mstoilov/sigmadrone-esc/README.MD

This is the sigmadrone ESC repository. It contains hardware designs and
firmware software for the Sigmadrone ESC.
