mstoilov/sigmadrone-esc/Documents/holding-brake.png

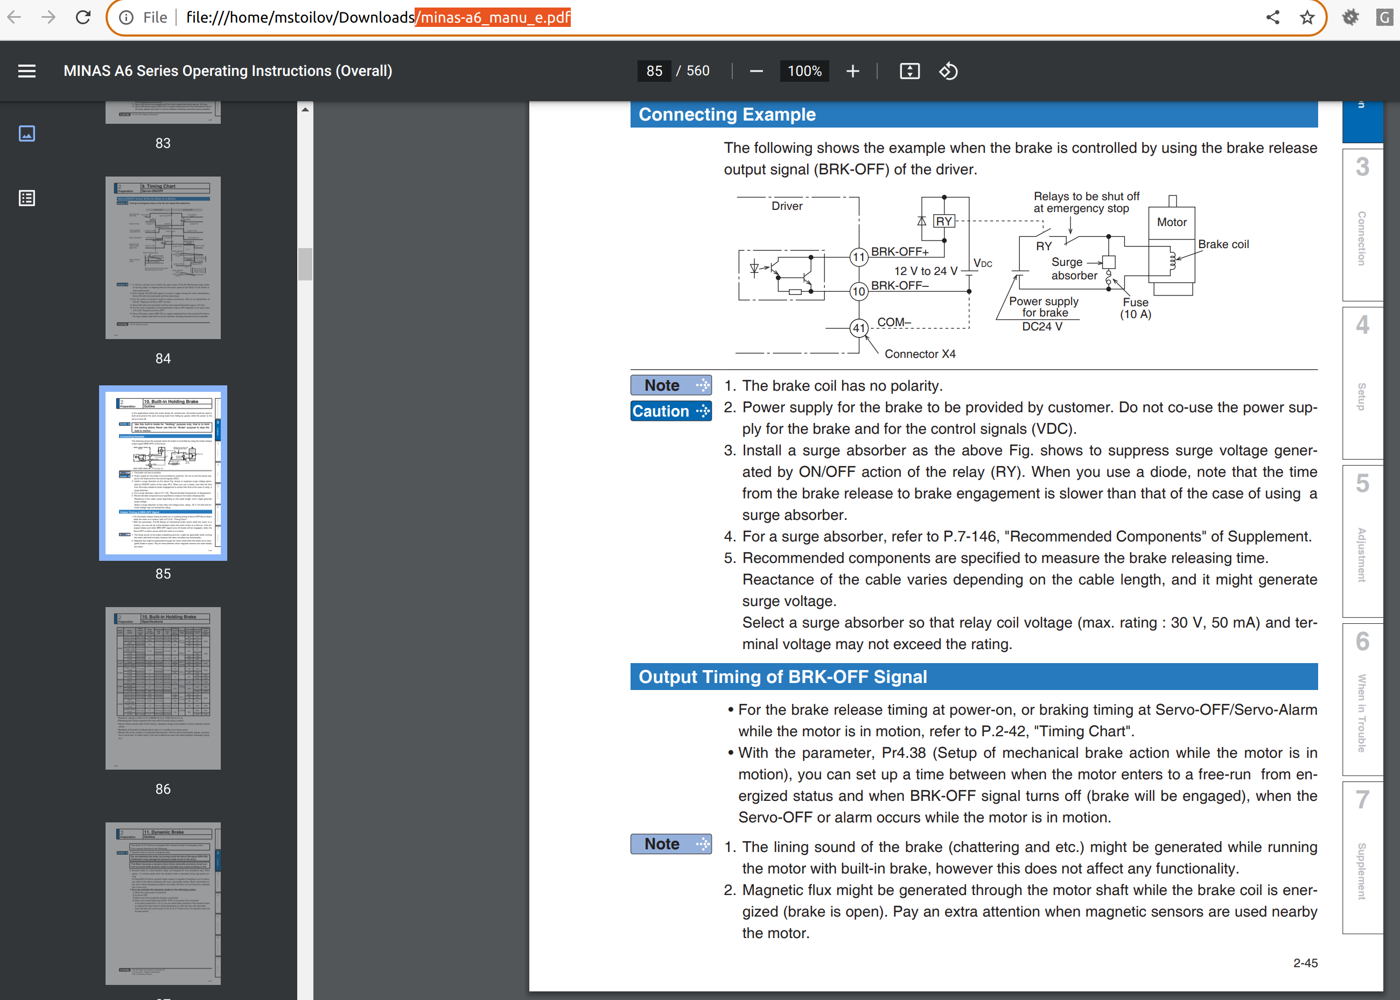
Documents/holding-brake.png
