mstoilov/sigmadrone-esc/hardware/zec-rev1/Servo_DRV_Rev1_BOM_2023-07-13(1)_updated.xlsx

Sheet: FULL BOM
 | Project: | Servo_DRV_Rev1 | FULL BOM |  | Variant:
 | Date: | 2023-07-12
Note | Comp Name | PartName | Description | Type | Value | Maker | Maker Part Name | Provider | Provider Part Name | Maker2 | Maker2 Part Name | Provider2 | Provider2 Part Name | Maker3 | Maker3 Part Name | Provider3 | Provider3 Part Name | Maker4 | Maker4 Part Name | Provider4 | Provider4 Part Name | Maker5 | Maker5 Part Name | Provider5 | Provider5 Part Name | Note | Code A | SKU | Proto MOQ | Automotive
 | AMB1 | SCHURTER 8020.0607 Fuse | Fuse Cartridge SUT Series 30A 250V 6.3mm x 32mm 500A | SMT | SCHURTER 8020.0607 Fuse | SCHURTER | 8020.0607 | Farnell | 1829564 | - | - | - | - | - | - | - | - | - | - | - | - | - | - | - | - |  | - | 7S03900054 |  | -
 | AMB2 | DF11-10DS-2C | CONN RCPT HSG 10POS 2.00MM | SMT | DF11-10DS-2C | - | - | - | - | Hirose Electric Co Ltd | DF11-10DS-2C | Digikey | H2023-ND | Hirose Connector | DF11-10DS-2C | Mouser | 798-DF11-10DS-2C | - | - | - | - | - | - | - | - |  | - | 7S02400821 |  | -
 | AMB3 | DF11-10DS-2C | CONN RCPT HSG 10POS 2.00MM | SMT | DF11-10DS-2C | - | - | - | - | Hirose Electric Co Ltd | DF11-10DS-2C | Digikey | H2023-ND | Hirose Connector | DF11-10DS-2C | Mouser | 798-DF11-10DS-2C | - | - | - | - | - | - | - | - |  | - | 7S02400821 |  | -
 | AMB4 | DF11-6DS-2C | CONN RCPT HSG 6POS 2.00MM | SMT | DF11-6DS-2C | - | - | - | - | Hirose Electric Co Ltd | DF11-6DS-2C | Digikey | H2021-ND | Hirose Connector | DF11-6DS-2C | Mouser | 798-DF11-6DS-2C | - | - | - | - | - | - | - | - |  | - | 7S02400820 |  | -
 | AMB5 | DF11-4DS-2C | CONN RCPT HSG 4POS 2.00MM | SMT | DF11-4DS-2C | - | - | - | - | Hirose Electric Co Ltd | DF11-4DS-2C | Digikey | H2019-ND | Hirose Connector | DF11-4DS-2C | Mouser | 798-DF11-4DS-2C | - | - | - | - | - | - | - | - |  | - | 7S02400819 |  | -
 | AMB6 | DF11-4DS-2C | CONN RCPT HSG 4POS 2.00MM | SMT | DF11-4DS-2C | - | - | - | - | Hirose Electric Co Ltd | DF11-4DS-2C | Digikey | H2019-ND | Hirose Connector | DF11-4DS-2C | Mouser | 798-DF11-4DS-2C | - | - | - | - | - | - | - | - |  | - | 7S02400819 |  | -
 | AMB7 | DF11-4DS-2C | CONN RCPT HSG 4POS 2.00MM | SMT | DF11-4DS-2C | - | - | - | - | Hirose Electric Co Ltd | DF11-4DS-2C | Digikey | H2019-ND | Hirose Connector | DF11-4DS-2C | Mouser | 798-DF11-4DS-2C | - | - | - | - | - | - | - | - |  | - | 7S02400819 |  | -
 | AMB8 | DF11-4DS-2C | CONN RCPT HSG 4POS 2.00MM | SMT | DF11-4DS-2C | - | - | - | - | Hirose Electric Co Ltd | DF11-4DS-2C | Digikey | H2019-ND | Hirose Connector | DF11-4DS-2C | Mouser | 798-DF11-4DS-2C | - | - | - | - | - | - | - | - |  | - | 7S02400819 |  | -
 | AMB9 | DF11-4DS-2C | CONN RCPT HSG 4POS 2.00MM | SMT | DF11-4DS-2C | - | - | - | - | Hirose Electric Co Ltd | DF11-4DS-2C | Digikey | H2019-ND | Hirose Connector | DF11-4DS-2C | Mouser | 798-DF11-4DS-2C | - | - | - | - | - | - | - | - |  | - | 7S02400819 |  | -
 | AMB10 | DF11-10DS-2C | CONN RCPT HSG 10POS 2.00MM | SMT | DF11-10DS-2C | - | - | - | - | Hirose Electric Co Ltd | DF11-10DS-2C | Digikey | H2023-ND | Hirose Connector | DF11-10DS-2C | Mouser | 798-DF11-10DS-2C | - | - | - | - | - | - | - | - |  | - | 7S02400821 |  | -
 | AMB11 | DF11-4DS-2C | CONN RCPT HSG 4POS 2.00MM | SMT | DF11-4DS-2C | - | - | - | - | Hirose Electric Co Ltd | DF11-4DS-2C | Digikey | H2019-ND | Hirose Connector | DF11-4DS-2C | Mouser | 798-DF11-4DS-2C | - | - | - | - | - | - | - | - |  | - | 7S02400819 |  | -
 | AMB12 | DF11-4DS-2C | CONN RCPT HSG 4POS 2.00MM | SMT | DF11-4DS-2C | - | - | - | - | Hirose Electric Co Ltd | DF11-4DS-2C | Digikey | H2019-ND | Hirose Connector | DF11-4DS-2C | Mouser | 798-DF11-4DS-2C | - | - | - | - | - | - | - | - |  | - | 7S02400819 |  | -
 | AMB13 | DF11-10DS-2C | CONN RCPT HSG 10POS 2.00MM | SMT | DF11-10DS-2C | - | - | - | - | Hirose Electric Co Ltd | DF11-10DS-2C | Digikey | H2023-ND | Hirose Connector | DF11-10DS-2C | Mouser | 798-DF11-10DS-2C | - | - | - | - | - | - | - | - |  | - | 7S02400821 |  | -
 | AMB14 | DF11-2428SCF | CONN SOCKET 24-28AWG CRIMP TIN | SMT | DF11-2428SCF | - | - | - | - | Hirose Electric Co Ltd | DF11-2428SCF | Digikey | H1504CT-ND | Hirose Connector | DF11-2428SCF | Mouser | 798-DF11-2428SCF | - | - | - | - | - | - | - | - |  | - | 7S02400822 |  | -
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
 | AMB79 | DF11-2428SCF | CONN SOCKET 24-28AWG CRIMP TIN | SMT | DF11-2428SCF | - | - | - | - | Hirose Electric Co Ltd | DF11-2428SCF | Digikey | H1504CT-ND | Hirose Connector | DF11-2428SCF | Mouser | 798-DF11-2428SCF | - | - | - | - | - | - | - | - |  | - | 7S02400822 |  | -
 | AMB80 | DF11-2428SCF | CONN SOCKET 24-28AWG CRIMP TIN | SMT | DF11-2428SCF | - | - | - | - | Hirose Electric Co Ltd | DF11-2428SCF | Digikey | H1504CT-ND | Hirose Connector | DF11-2428SCF | Mouser | 798-DF11-2428SCF | - | - | - | - | - | - | - | - |  | - | 7S02400822 |  | -
 | AMB81 | DF11-2428SCF | CONN SOCKET 24-28AWG CRIMP TIN | SMT | DF11-2428SCF | - | - | - | - | Hirose Electric Co Ltd | DF11-2428SCF | Digikey | H1504CT-ND | Hirose Connector | DF11-2428SCF | Mouser | 798-DF11-2428SCF | - | - | - | - | - | - | - | - |  | - | 7S02400822 |  | -
 | AMB82 | DF11-2428SCF | CONN SOCKET 24-28AWG CRIMP TIN | SMT | DF11-2428SCF | - | - | - | - | Hirose Electric Co Ltd | DF11-2428SCF | Digikey | H1504CT-ND | Hirose Connector | DF11-2428SCF | Mouser | 798-DF11-2428SCF | - | - | - | - | - | - | - | - |  | - | 7S02400822 |  | -
 | AMB83 | DF11-2428SCF | CONN SOCKET 24-28AWG CRIMP TIN | SMT | DF11-2428SCF | - | - | - | - | Hirose Electric Co Ltd | DF11-2428SCF | Digikey | H1504CT-ND | Hirose Connector | DF11-2428SCF | Mouser | 798-DF11-2428SCF | - | - | - | - | - | - | - | - |  | - | 7S02400822 |  | -
 | AMB84 | DF11-2428SCF | CONN SOCKET 24-28AWG CRIMP TIN | SMT | DF11-2428SCF | - | - | - | - | Hirose Electric Co Ltd | DF11-2428SCF | Digikey | H1504CT-ND | Hirose Connector | DF11-2428SCF | Mouser | 798-DF11-2428SCF | - | - | - | - | - | - | - | - |  | - | 7S02400822 |  | -
 | AMB85 | DF11-2428SCF | CONN SOCKET 24-28AWG CRIMP TIN | SMT | DF11-2428SCF | - | - | - | - | Hirose Electric Co Ltd | DF11-2428SCF | Digikey | H1504CT-ND | Hirose Connector | DF11-2428SCF | Mouser | 798-DF11-2428SCF | - | - | - | - | - | - | - | - |  | - | 7S02400822 |  | -
 | AMB86 | DF11-2428SCF | CONN SOCKET 24-28AWG CRIMP TIN | SMT | DF11-2428SCF | - | - | - | - | Hirose Electric Co Ltd | DF11-2428SCF | Digikey | H1504CT-ND | Hirose Connector | DF11-2428SCF | Mouser | 798-DF11-2428SCF | - | - | - | - | - | - | - | - |  | - | 7S02400822 |  | -
 | AMB87 | DF11-2428SCF | CONN SOCKET 24-28AWG CRIMP TIN | SMT | DF11-2428SCF | - | - | - | - | Hirose Electric Co Ltd | DF11-2428SCF | Digikey | H1504CT-ND | Hirose Connector | DF11-2428SCF | Mouser | 798-DF11-2428SCF | - | - | - | - | - | - | - | - |  | - | 7S02400822 |  | -
 | AMB88 | 691352710004 | TERM BLOCK PLUG 4POS 5MM 300VAC 12A 4P Straight 24-12AWG | SMT | 691352710004 | WURTH ELEKTRONIK | 691352710004 | WURTH ELEKTRONIK | 691352710004 | WURTH ELEKTRONIK | 691352710004 | Digikey | 732-2777-ND | WURTH ELEKTRONIK | 691352710004 | Mouser | 710-691352710004 | - | - | - | - | - | - | - | - |  | - | 7S03000364 | - | -
 | AMB89 | 691352710003 | TERM BLOCK PLUG 3POS 5MM 300VAC 12A 3P Straight 24-12AWG | SMT | 691352710003 | WURTH ELEKTRONIK | 691352710003 | WURTH ELEKTRONIK | 691352710003 | WURTH ELEKTRONIK | 691352710003 | Digikey | 732-2776-ND | WURTH ELEKTRONIK | 691352710003 | Mouser | 710-691352710003 | - | - | - | - | - | - | - | - |  | - | 7S03000365 | - | -
 | AMB90 | 691352710003 | TERM BLOCK PLUG 3POS 5MM 300VAC 12A 3P Straight 24-12AWG | SMT | 691352710003 | WURTH ELEKTRONIK | 691352710003 | WURTH ELEKTRONIK | 691352710003 | WURTH ELEKTRONIK | 691352710003 | Digikey | 732-2776-ND | WURTH ELEKTRONIK | 691352710003 | Mouser | 710-691352710003 | - | - | - | - | - | - | - | - |  | - | 7S03000365 | - | -
 | AMB91 | AMB Spacer 5mm - 702917000 | SPACER BOARD SUPRT SCREW MNT NYLON h5mm Outer Diameter - 4mm Drill in Panel - 3mm | SMT | AMB Spacer 5mm - 702917000 | WURTH ELECTRONIK | 702917000 | WURTH ELECTRONIK | 702917000 | WURTH ELECTRONIK | 702917000 | Digikey | 732-9626-ND | WURTH ELECTRONIK | 702917000 | Mouser | 710-702917000 | - | - | - | - | - | - | - | - |  | - | 7S04800076 | - | -
 | AMB92 | AMB Spacer 5mm - 702917000 | SPACER BOARD SUPRT SCREW MNT NYLON h5mm Outer Diameter - 4mm Drill in Panel - 3mm | SMT | AMB Spacer 5mm - 702917000 | WURTH ELECTRONIK | 702917000 | WURTH ELECTRONIK | 702917000 | WURTH ELECTRONIK | 702917000 | Digikey | 732-9626-ND | WURTH ELECTRONIK | 702917000 | Mouser | 710-702917000 | - | - | - | - | - | - | - | - |  | - | 7S04800076 | - | -
 | C1 | C0805-4u7/50V/20%/X5R | Chip Capacitor 0805 4u7/50V/20%/X5R | SMT | 4u7/50V/X5R | TDK | C2012X5R1H475M125AB | Farnell | 2525142 | Murata Electronics | GRM21BR61H475ME51L | Digikey | 490-14663-1-ND | Murata Electronics | GRM21BR61H475ME51L | Mouser | 81-GRM21BR61H475M51L | Taiyo Yuden | UMK212BBJ475KG-T | Mouser | 963-UMK212BBJ475KG-T | - | - | - | - |  | - | 7S00900100 | 13 | -
 | C2 | C0805-10n/50V/10%/X7R | Chip Capacitor 0805 10n/50V/10%/X7R | SMT | 10n/50V | KEMET | C0805Y103K5RACAUTO | Farnell | 2673146 | Samsung Electro-Mechanics | CL21B103KBCNNNC | Digikey | 1276-1078-1-ND | Yageo | CC0805KRX7R9BB103 | Mouser | 603-CC805KRX7R9BB103 | Samsung Electro-Mechanics | CL21B103KBANNNC | Comet | C0805 10nF 50V X7R SAMSUNG | - | - | - | - |  | - | 7S00900022 | 13 | -
 | C3 | C0402-47p/50V/NP0/5% | CAP 47pF 5% 50V 0402 NP0 | SMT | 47p/50V/5% | YAGEO | CC0402JRNPO9BN470 | Farnell | 3019202 | Yageo | CC0402JRNPO9BN470 | Digikey | 311-1021-1-ND | Murata Electronics | GRT1555C1H470FA02D | Mouser | 81-GRT1555C1H470FA2D | Murata Electronics | GRM1555C1H470JA01D | Mouser | 81-GRM1555C1H470JA1D | - | - | - | - |  | 16733 | 7S00700037 | 25 | -
 | C4 | C0402-47p/50V/NP0/5% | CAP 47pF 5% 50V 0402 NP0 | SMT | 47p/50V/5% | YAGEO | CC0402JRNPO9BN470 | Farnell | 3019202 | Yageo | CC0402JRNPO9BN470 | Digikey | 311-1021-1-ND | Murata Electronics | GRT1555C1H470FA02D | Mouser | 81-GRT1555C1H470FA2D | Murata Electronics | GRM1555C1H470JA01D | Mouser | 81-GRM1555C1H470JA1D | - | - | - | - |  | 16733 | 7S00700037 | 25 | -
 | C5 | C0402-1u/16V/10%/X5R | CAP CER 1UF 16V X5R 0402 10% | SMT | 1u/16V/X5R | TAIYO YUDEN | EMK105BJ105KV-F | Farnell | 2113064 | MURATA | GRM155R61C105KA12D | Digikey | 490-10694-1-ND | Taiyo Yuden | EMK105BJ105KV-F | Mouser | 963-EMK105BJ105KV-F | - | - | - | - | - | - | - | - |  | 9621 | 7S00700081 | 25 | -
 | C6 | C0402-100n/50V/10%/X7R | CAP CER 0.1UF 50V 10% X7R 0402 | SMT | 100n/50V/X7R | TDK | CGA2B3X7R1H104K050BB | Farnell | 2210822 | Murata | GCM155R71H104KE02D | Digikey | 490-10672-1-ND | Murata | GRM155R71H104KE14D | Mouser | 81-GRM155R71H104KE4D | - | - | - | - | SAMSUNG | CL05B104KB5NNNC | Comet | C0402 100nF 50V X7R |  | - | 7S00700043 | 25 | -
 | C7 | C0402-100n/50V/10%/X7R | CAP CER 0.1UF 50V 10% X7R 0402 | SMT | 100n/50V/X7R | TDK | CGA2B3X7R1H104K050BB | Farnell | 2210822 | Murata | GCM155R71H104KE02D | Digikey | 490-10672-1-ND | Murata | GRM155R71H104KE14D | Mouser | 81-GRM155R71H104KE4D | - | - | - | - | SAMSUNG | CL05B104KB5NNNC | Comet | C0402 100nF 50V X7R |  | - | 7S00700043 | 25 | -
 | C8 | C0402-100n/50V/10%/X7R | CAP CER 0.1UF 50V 10% X7R 0402 | SMT | 100n/50V/X7R | TDK | CGA2B3X7R1H104K050BB | Farnell | 2210822 | Murata | GCM155R71H104KE02D | Digikey | 490-10672-1-ND | Murata | GRM155R71H104KE14D | Mouser | 81-GRM155R71H104KE4D | - | - | - | - | SAMSUNG | CL05B104KB5NNNC | Comet | C0402 100nF 50V X7R |  | - | 7S00700043 | 25 | -
 | C9 | C0402-100n/50V/10%/X7R | CAP CER 0.1UF 50V 10% X7R 0402 | SMT | 100n/50V/X7R | TDK | CGA2B3X7R1H104K050BB | Farnell | 2210822 | Murata | GCM155R71H104KE02D | Digikey | 490-10672-1-ND | Murata | GRM155R71H104KE14D | Mouser | 81-GRM155R71H104KE4D | - | - | - | - | SAMSUNG | CL05B104KB5NNNC | Comet | C0402 100nF 50V X7R |  | - | 7S00700043 | 25 | -
 | C10 | C0402-100n/50V/10%/X7R | CAP CER 0.1UF 50V 10% X7R 0402 | SMT | 100n/50V/X7R | TDK | CGA2B3X7R1H104K050BB | Farnell | 2210822 | Murata | GCM155R71H104KE02D | Digikey | 490-10672-1-ND | Murata | GRM155R71H104KE14D | Mouser | 81-GRM155R71H104KE4D | - | - | - | - | SAMSUNG | CL05B104KB5NNNC | Comet | C0402 100nF 50V X7R |  | - | 7S00700043 | 25 | -
 | C11 | C0402-100n/50V/10%/X7R | CAP CER 0.1UF 50V 10% X7R 0402 | SMT | 100n/50V/X7R | TDK | CGA2B3X7R1H104K050BB | Farnell | 2210822 | Murata | GCM155R71H104KE02D | Digikey | 490-10672-1-ND | Murata | GRM155R71H104KE14D | Mouser | 81-GRM155R71H104KE4D | - | - | - | - | SAMSUNG | CL05B104KB5NNNC | Comet | C0402 100nF 50V X7R |  | - | 7S00700043 | 25 | -
 | C12 | C0402-100n/50V/10%/X7R | CAP CER 0.1UF 50V 10% X7R 0402 | SMT | 100n/50V/X7R | TDK | CGA2B3X7R1H104K050BB | Farnell | 2210822 | Murata | GCM155R71H104KE02D | Digikey | 490-10672-1-ND | Murata | GRM155R71H104KE14D | Mouser | 81-GRM155R71H104KE4D | - | - | - | - | SAMSUNG | CL05B104KB5NNNC | Comet | C0402 100nF 50V X7R |  | - | 7S00700043 | 25 | -
 | C13 | C0805-4u7/50V/20%/X5R | Chip Capacitor 0805 4u7/50V/20%/X5R | SMT | 4u7/50V/X5R | TDK | C2012X5R1H475M125AB | Farnell | 2525142 | Murata Electronics | GRM21BR61H475ME51L | Digikey | 490-14663-1-ND | Murata Electronics | GRM21BR61H475ME51L | Mouser | 81-GRM21BR61H475M51L | Taiyo Yuden | UMK212BBJ475KG-T | Mouser | 963-UMK212BBJ475KG-T | - | - | - | - |  | - | 7S00900100 | 13 | -
 | C14 | C0402-27p/50V/C0G | CAP 27pF 5% 50V CF CAP 0402 C0G | SMT | 27p/50V | KEMET | C0402C270J5GACAUTO | Farnell | 2821220 | KEMET | C0402C270J5GACTU | Digikey | 399-1016-1-ND | KEMET | C0402C270J5GAC | Mouser | 80-C0402C270J5GAC | - | - | - | - | - | - | - | - |  | 18561 | 7S00700022 | 25 | -
 | C15 | C0402-100n/50V/10%/X7R | CAP CER 0.1UF 50V 10% X7R 0402 | SMT | 100n/50V/X7R | TDK | CGA2B3X7R1H104K050BB | Farnell | 2210822 | Murata | GCM155R71H104KE02D | Digikey | 490-10672-1-ND | Murata | GRM155R71H104KE14D | Mouser | 81-GRM155R71H104KE4D | - | - | - | - | SAMSUNG | CL05B104KB5NNNC | Comet | C0402 100nF 50V X7R |  | - | 7S00700043 | 25 | -
 | C16 | C0402-27p/50V/C0G | CAP 27pF 5% 50V CF CAP 0402 C0G | SMT | 27p/50V | KEMET | C0402C270J5GACAUTO | Farnell | 2821220 | KEMET | C0402C270J5GACTU | Digikey | 399-1016-1-ND | KEMET | C0402C270J5GAC | Mouser | 80-C0402C270J5GAC | - | - | - | - | - | - | - | - |  | 18561 | 7S00700022 | 25 | -
 | C17 | C0402-1u/16V/10%/X5R | CAP CER 1UF 16V X5R 0402 10% | SMT | 1u/16V/X5R | TAIYO YUDEN | EMK105BJ105KV-F | Farnell | 2113064 | MURATA | GRM155R61C105KA12D | Digikey | 490-10694-1-ND | Taiyo Yuden | EMK105BJ105KV-F | Mouser | 963-EMK105BJ105KV-F | - | - | - | - | - | - | - | - |  | 9621 | 7S00700081 | 25 | -
 | C18 | C0402-100n/50V/10%/X7R | CAP CER 0.1UF 50V 10% X7R 0402 | SMT | 100n/50V/X7R | TDK | CGA2B3X7R1H104K050BB | Farnell | 2210822 | Murata | GCM155R71H104KE02D | Digikey | 490-10672-1-ND | Murata | GRM155R71H104KE14D | Mouser | 81-GRM155R71H104KE4D | - | - | - | - | SAMSUNG | CL05B104KB5NNNC | Comet | C0402 100nF 50V X7R |  | - | 7S00700043 | 25 | -
 | C19 | C0402-2u2/16V/X5R/10% | CAP CER 2.2UF 16V X5R 0402 | SMT | 2u2/16V | MURATA | ZRB157R61C225KE11D | Farnell | 2990839 | Taiyo Yuden | EMK105ABJ225KV-F | Digikey | 587-6002-1-ND | Taiyo Yuden | EMK105ABJ225KV-F | Mouser | 963-EMK105ABJ225KV-F | Taiyo Yuden | EMK105ABJ225MV-F | Mouser | 963-EMK105ABJ225MV-F | - | - | - | - |  | - | 7S00700126 | 25 | -
 | C20 | C0402-1n/50V/X7R | CAP CER 1000PF 50V 10% X7R 0402 | SMT | 1n/50V/X7R | WURTH | '885012205061 | Farnell | 2495166 | Murata | GCM155R71H102KA37D | Digikey | 490-4761-1-ND | Murata | GCM155R71H102KA37D | Mouser | 81-GCM155R71H102KA7D | - | - | - | - | - | - | - | - |  | - | 7S00700004 | 25 | -
 | C21 | C0402-100n/50V/10%/X7R | CAP CER 0.1UF 50V 10% X7R 0402 | SMT | 100n/50V/X7R | TDK | CGA2B3X7R1H104K050BB | Farnell | 2210822 | Murata | GCM155R71H104KE02D | Digikey | 490-10672-1-ND | Murata | GRM155R71H104KE14D | Mouser | 81-GRM155R71H104KE4D | - | - | - | - | SAMSUNG | CL05B104KB5NNNC | Comet | C0402 100nF 50V X7R |  | - | 7S00700043 | 25 | -
 | C22 | C0402-100n/50V/10%/X7R | CAP CER 0.1UF 50V 10% X7R 0402 | SMT | 100n/50V/X7R | TDK | CGA2B3X7R1H104K050BB | Farnell | 2210822 | Murata | GCM155R71H104KE02D | Digikey | 490-10672-1-ND | Murata | GRM155R71H104KE14D | Mouser | 81-GRM155R71H104KE4D | - | - | - | - | SAMSUNG | CL05B104KB5NNNC | Comet | C0402 100nF 50V X7R |  | - | 7S00700043 | 25 | -
 | C23 | C0402-1n/50V/X7R | CAP CER 1000PF 50V 10% X7R 0402 | SMT | 1n/50V/X7R | WURTH | '885012205061 | Farnell | 2495166 | Murata | GCM155R71H102KA37D | Digikey | 490-4761-1-ND | Murata | GCM155R71H102KA37D | Mouser | 81-GCM155R71H102KA7D | - | - | - | - | - | - | - | - |  | - | 7S00700004 | 25 | -
 | C24 | C0402-1u/16V/10%/X5R | CAP CER 1UF 16V X5R 0402 10% | SMT | 1u/16V/X5R | TAIYO YUDEN | EMK105BJ105KV-F | Farnell | 2113064 | MURATA | GRM155R61C105KA12D | Digikey | 490-10694-1-ND | Taiyo Yuden | EMK105BJ105KV-F | Mouser | 963-EMK105BJ105KV-F | - | - | - | - | - | - | - | - |  | 9621 | 7S00700081 | 25 | -
 | C25 | C0402-1n/50V/X7R | CAP CER 1000PF 50V 10% X7R 0402 | SMT | 1n/50V/X7R | WURTH | '885012205061 | Farnell | 2495166 | Murata | GCM155R71H102KA37D | Digikey | 490-4761-1-ND | Murata | GCM155R71H102KA37D | Mouser | 81-GCM155R71H102KA7D | - | - | - | - | - | - | - | - |  | - | 7S00700004 | 25 | -
 | C26 | C0402-1n/50V/X7R | CAP CER 1000PF 50V 10% X7R 0402 | SMT | 1n/50V/X7R | WURTH | '885012205061 | Farnell | 2495166 | Murata | GCM155R71H102KA37D | Digikey | 490-4761-1-ND | Murata | GCM155R71H102KA37D | Mouser | 81-GCM155R71H102KA7D | - | - | - | - | - | - | - | - |  | - | 7S00700004 | 25 | -
 | C27 | C0402-1n/50V/X7R | CAP CER 1000PF 50V 10% X7R 0402 | SMT | 1n/50V/X7R | WURTH | '885012205061 | Farnell | 2495166 | Murata | GCM155R71H102KA37D | Digikey | 490-4761-1-ND | Murata | GCM155R71H102KA37D | Mouser | 81-GCM155R71H102KA7D | - | - | - | - | - | - | - | - |  | - | 7S00700004 | 25 | -
 | C28 | C0603-10u/16V/20%/X5R | CAP CER 10UF 16V 20% X5R 0603 | SMT | 10u/16V/X5R | Murata Electronics | GRM188R61C106MA73D | Farnell | 2426958 | Murata Electronics | GRM188R61C106MA73D | Digikey | 490-7201-1-ND | Murata Electronics | GRM188R61C106MAALD | Mouser | 81-GRM188R61C106MALD | - | - | - | - | - | - | - | - |  | - | 7S00800087 | 13 | -
 | C29 | C0402-100n/50V/10%/X7R | CAP CER 0.1UF 50V 10% X7R 0402 | SMT | 100n/50V/X7R | TDK | CGA2B3X7R1H104K050BB | Farnell | 2210822 | Murata | GCM155R71H104KE02D | Digikey | 490-10672-1-ND | Murata | GRM155R71H104KE14D | Mouser | 81-GRM155R71H104KE4D | - | - | - | - | SAMSUNG | CL05B104KB5NNNC | Comet | C0402 100nF 50V X7R |  | - | 7S00700043 | 25 | -
 | C30 | C0402-1n/50V/X7R | CAP CER 1000PF 50V 10% X7R 0402 | SMT | 1n/50V/X7R | WURTH | '885012205061 | Farnell | 2495166 | Murata | GCM155R71H102KA37D | Digikey | 490-4761-1-ND | Murata | GCM155R71H102KA37D | Mouser | 81-GCM155R71H102KA7D | - | - | - | - | - | - | - | - |  | - | 7S00700004 | 25 | -
 | C31 | C0402-1u/16V/10%/X5R | CAP CER 1UF 16V X5R 0402 10% | SMT | 1u/16V/X5R | TAIYO YUDEN | EMK105BJ105KV-F | Farnell | 2113064 | MURATA | GRM155R61C105KA12D | Digikey | 490-10694-1-ND | Taiyo Yuden | EMK105BJ105KV-F | Mouser | 963-EMK105BJ105KV-F | - | - | - | - | - | - | - | - |  | 9621 | 7S00700081 | 25 | -
 | C32 | C0402-2u2/16V/X5R/10% | CAP CER 2.2UF 16V X5R 0402 | SMT | 2u2/16V | MURATA | ZRB157R61C225KE11D | Farnell | 2990839 | Taiyo Yuden | EMK105ABJ225KV-F | Digikey | 587-6002-1-ND | Taiyo Yuden | EMK105ABJ225KV-F | Mouser | 963-EMK105ABJ225KV-F | Taiyo Yuden | EMK105ABJ225MV-F | Mouser | 963-EMK105ABJ225MV-F | - | - | - | - |  | - | 7S00700126 | 25 | -
 | C33 | C0402-100n/50V/10%/X7R | CAP CER 0.1UF 50V 10% X7R 0402 | SMT | 100n/50V/X7R | TDK | CGA2B3X7R1H104K050BB | Farnell | 2210822 | Murata | GCM155R71H104KE02D | Digikey | 490-10672-1-ND | Murata | GRM155R71H104KE14D | Mouser | 81-GRM155R71H104KE4D | - | - | - | - | SAMSUNG | CL05B104KB5NNNC | Comet | C0402 100nF 50V X7R |  | - | 7S00700043 | 25 | -
 | C34 | C0603-10u/16V/20%/X5R | CAP CER 10UF 16V 20% X5R 0603 | SMT | 10u/16V/X5R | Murata Electronics | GRM188R61C106MA73D | Farnell | 2426958 | Murata Electronics | GRM188R61C106MA73D | Digikey | 490-7201-1-ND | Murata Electronics | GRM188R61C106MAALD | Mouser | 81-GRM188R61C106MALD | - | - | - | - | - | - | - | - |  | - | 7S00800087 | 13 | -
 | C35 | C0603-10u/16V/20%/X5R | CAP CER 10UF 16V 20% X5R 0603 | SMT | 10u/16V/X5R | Murata Electronics | GRM188R61C106MA73D | Farnell | 2426958 | Murata Electronics | GRM188R61C106MA73D | Digikey | 490-7201-1-ND | Murata Electronics | GRM188R61C106MAALD | Mouser | 81-GRM188R61C106MALD | - | - | - | - | - | - | - | - |  | - | 7S00800087 | 13 | -
 | C36 | C0603-10u/16V/20%/X5R | CAP CER 10UF 16V 20% X5R 0603 | SMT | 10u/16V/X5R | Murata Electronics | GRM188R61C106MA73D | Farnell | 2426958 | Murata Electronics | GRM188R61C106MA73D | Digikey | 490-7201-1-ND | Murata Electronics | GRM188R61C106MAALD | Mouser | 81-GRM188R61C106MALD | - | - | - | - | - | - | - | - |  | - | 7S00800087 | 13 | -
 | C37 | C0402-100n/50V/10%/X7R | CAP CER 0.1UF 50V 10% X7R 0402 | SMT | 100n/50V/X7R | TDK | CGA2B3X7R1H104K050BB | Farnell | 2210822 | Murata | GCM155R71H104KE02D | Digikey | 490-10672-1-ND | Murata | GRM155R71H104KE14D | Mouser | 81-GRM155R71H104KE4D | - | - | - | - | SAMSUNG | CL05B104KB5NNNC | Comet | C0402 100nF 50V X7R |  | - | 7S00700043 | 25 | -
 | C38 | C0805-4u7/50V/20%/X5R | Chip Capacitor 0805 4u7/50V/20%/X5R | SMT | 4u7/50V/X5R | TDK | C2012X5R1H475M125AB | Farnell | 2525142 | Murata Electronics | GRM21BR61H475ME51L | Digikey | 490-14663-1-ND | Murata Electronics | GRM21BR61H475ME51L | Mouser | 81-GRM21BR61H475M51L | Taiyo Yuden | UMK212BBJ475KG-T | Mouser | 963-UMK212BBJ475KG-T | - | - | - | - |  | - | 7S00900100 | 13 | -
 | C39 | C0402-100n/50V/10%/X7R | CAP CER 0.1UF 50V 10% X7R 0402 | SMT | 100n/50V/X7R | TDK | CGA2B3X7R1H104K050BB | Farnell | 2210822 | Murata | GCM155R71H104KE02D | Digikey | 490-10672-1-ND | Murata | GRM155R71H104KE14D | Mouser | 81-GRM155R71H104KE4D | - | - | - | - | SAMSUNG | CL05B104KB5NNNC | Comet | C0402 100nF 50V X7R |  | - | 7S00700043 | 25 | -
 | C40 | C0402-1u/16V/10%/X5R | CAP CER 1UF 16V X5R 0402 10% | SMT | 1u/16V/X5R | TAIYO YUDEN | EMK105BJ105KV-F | Farnell | 2113064 | MURATA | GRM155R61C105KA12D | Digikey | 490-10694-1-ND | Taiyo Yuden | EMK105BJ105KV-F | Mouser | 963-EMK105BJ105KV-F | - | - | - | - | - | - | - | - |  | 9621 | 7S00700081 | 25 | -
 | C41 | C0603-10u/16V/20%/X5R | CAP CER 10UF 16V 20% X5R 0603 | SMT | 10u/16V/X5R | Murata Electronics | GRM188R61C106MA73D | Farnell | 2426958 | Murata Electronics | GRM188R61C106MA73D | Digikey | 490-7201-1-ND | Murata Electronics | GRM188R61C106MAALD | Mouser | 81-GRM188R61C106MALD | - | - | - | - | - | - | - | - |  | - | 7S00800087 | 13 | -
 | C42 | C0603-10u/16V/20%/X5R | CAP CER 10UF 16V 20% X5R 0603 | SMT | 10u/16V/X5R | Murata Electronics | GRM188R61C106MA73D | Farnell | 2426958 | Murata Electronics | GRM188R61C106MA73D | Digikey | 490-7201-1-ND | Murata Electronics | GRM188R61C106MAALD | Mouser | 81-GRM188R61C106MALD | - | - | - | - | - | - | - | - |  | - | 7S00800087 | 13 | -
 | C43 | C0603-10u/16V/20%/X5R | CAP CER 10UF 16V 20% X5R 0603 | SMT | 10u/16V/X5R | Murata Electronics | GRM188R61C106MA73D | Farnell | 2426958 | Murata Electronics | GRM188R61C106MA73D | Digikey | 490-7201-1-ND | Murata Electronics | GRM188R61C106MAALD | Mouser | 81-GRM188R61C106MALD | - | - | - | - | - | - | - | - |  | - | 7S00800087 | 13 | -
 | C44 | C0402-100n/50V/10%/X7R | CAP CER 0.1UF 50V 10% X7R 0402 | SMT | 100n/50V/X7R | TDK | CGA2B3X7R1H104K050BB | Farnell | 2210822 | Murata | GCM155R71H104KE02D | Digikey | 490-10672-1-ND | Murata | GRM155R71H104KE14D | Mouser | 81-GRM155R71H104KE4D | - | - | - | - | SAMSUNG | CL05B104KB5NNNC | Comet | C0402 100nF 50V X7R |  | - | 7S00700043 | 25 | -
 | C45 | C0805-4u7/50V/20%/X5R | Chip Capacitor 0805 4u7/50V/20%/X5R | SMT | 4u7/50V/X5R | TDK | C2012X5R1H475M125AB | Farnell | 2525142 | Murata Electronics | GRM21BR61H475ME51L | Digikey | 490-14663-1-ND | Murata Electronics | GRM21BR61H475ME51L | Mouser | 81-GRM21BR61H475M51L | Taiyo Yuden | UMK212BBJ475KG-T | Mouser | 963-UMK212BBJ475KG-T | - | - | - | - |  | - | 7S00900100 | 13 | -
 | C46 | C0402-100n/50V/10%/X7R | CAP CER 0.1UF 50V 10% X7R 0402 | SMT | 100n/50V/X7R | TDK | CGA2B3X7R1H104K050BB | Farnell | 2210822 | Murata | GCM155R71H104KE02D | Digikey | 490-10672-1-ND | Murata | GRM155R71H104KE14D | Mouser | 81-GRM155R71H104KE4D | - | - | - | - | SAMSUNG | CL05B104KB5NNNC | Comet | C0402 100nF 50V X7R |  | - | 7S00700043 | 25 | -
 | C47 | C0402-1u/16V/10%/X5R | CAP CER 1UF 16V X5R 0402 10% | SMT | 1u/16V/X5R | TAIYO YUDEN | EMK105BJ105KV-F | Farnell | 2113064 | MURATA | GRM155R61C105KA12D | Digikey | 490-10694-1-ND | Taiyo Yuden | EMK105BJ105KV-F | Mouser | 963-EMK105BJ105KV-F | - | - | - | - | - | - | - | - |  | 9621 | 7S00700081 | 25 | -
 | C48 | C0402-100n/50V/10%/X7R | CAP CER 0.1UF 50V 10% X7R 0402 | SMT | 100n/50V/X7R | TDK | CGA2B3X7R1H104K050BB | Farnell | 2210822 | Murata | GCM155R71H104KE02D | Digikey | 490-10672-1-ND | Murata | GRM155R71H104KE14D | Mouser | 81-GRM155R71H104KE4D | - | - | - | - | SAMSUNG | CL05B104KB5NNNC | Comet | C0402 100nF 50V X7R |  | - | 7S00700043 | 25 | -
 | C49 | C0805-4u7/50V/20%/X5R | Chip Capacitor 0805 4u7/50V/20%/X5R | SMT | 4u7/50V/X5R | TDK | C2012X5R1H475M125AB | Farnell | 2525142 | Murata Electronics | GRM21BR61H475ME51L | Digikey | 490-14663-1-ND | Murata Electronics | GRM21BR61H475ME51L | Mouser | 81-GRM21BR61H475M51L | Taiyo Yuden | UMK212BBJ475KG-T | Mouser | 963-UMK212BBJ475KG-T | - | - | - | - |  | - | 7S00900100 | 13 | -
 | C50 | C0402-100n/50V/10%/X7R | CAP CER 0.1UF 50V 10% X7R 0402 | SMT | 100n/50V/X7R | TDK | CGA2B3X7R1H104K050BB | Farnell | 2210822 | Murata | GCM155R71H104KE02D | Digikey | 490-10672-1-ND | Murata | GRM155R71H104KE14D | Mouser | 81-GRM155R71H104KE4D | - | - | - | - | SAMSUNG | CL05B104KB5NNNC | Comet | C0402 100nF 50V X7R |  | - | 7S00700043 | 25 | -
 | C51 | C0402-47n/50V/10%/X7R | CAP CER 0.047UF 50V X7R 0402 | SMT | 47n/50V/X7R | TDK | CGA2B3X7R1H473K050BB | Farnell | 2210827 | TDK Corporation | CGA2B3X7R1H473K050BB | Digikey | 445-6897-1-ND | Murata Electronics | GRM155R71H473KE14D | Mouser | 81-GRM155R71H473KE4D | - | - | - | - | - | - | - | - |  | - | 7S00700090 | 25 | -
 | C52 | C0402-1u/16V/10%/X5R | CAP CER 1UF 16V X5R 0402 10% | SMT | 1u/16V/X5R | TAIYO YUDEN | EMK105BJ105KV-F | Farnell | 2113064 | MURATA | GRM155R61C105KA12D | Digikey | 490-10694-1-ND | Taiyo Yuden | EMK105BJ105KV-F | Mouser | 963-EMK105BJ105KV-F | - | - | - | - | - | - | - | - |  | 9621 | 7S00700081 | 25 | -
 | C53 | C0402-1n/50V/X7R | CAP CER 1000PF 50V 10% X7R 0402 | SMT | 1n/50V/X7R | WURTH | '885012205061 | Farnell | 2495166 | Murata | GCM155R71H102KA37D | Digikey | 490-4761-1-ND | Murata | GCM155R71H102KA37D | Mouser | 81-GCM155R71H102KA7D | - | - | - | - | - | - | - | - |  | - | 7S00700004 | 25 | -
 | C54 | C0402-1n/50V/X7R | CAP CER 1000PF 50V 10% X7R 0402 | SMT | 1n/50V/X7R | WURTH | '885012205061 | Farnell | 2495166 | Murata | GCM155R71H102KA37D | Digikey | 490-4761-1-ND | Murata | GCM155R71H102KA37D | Mouser | 81-GCM155R71H102KA7D | - | - | - | - | - | - | - | - |  | - | 7S00700004 | 25 | -
 | C55 | C0402-1n/50V/X7R | CAP CER 1000PF 50V 10% X7R 0402 | SMT | 1n/50V/X7R | WURTH | '885012205061 | Farnell | 2495166 | Murata | GCM155R71H102KA37D | Digikey | 490-4761-1-ND | Murata | GCM155R71H102KA37D | Mouser | 81-GCM155R71H102KA7D | - | - | - | - | - | - | - | - |  | - | 7S00700004 | 25 | -
 | C56 | C0402-100n/50V/10%/X7R | CAP CER 0.1UF 50V 10% X7R 0402 | SMT | 100n/50V/X7R | TDK | CGA2B3X7R1H104K050BB | Farnell | 2210822 | Murata | GCM155R71H104KE02D | Digikey | 490-10672-1-ND | Murata | GRM155R71H104KE14D | Mouser | 81-GRM155R71H104KE4D | - | - | - | - | SAMSUNG | CL05B104KB5NNNC | Comet | C0402 100nF 50V X7R |  | - | 7S00700043 | 25 | -
 | C57 | C0805-4u7/50V/20%/X5R | Chip Capacitor 0805 4u7/50V/20%/X5R | SMT | 4u7/50V/X5R | TDK | C2012X5R1H475M125AB | Farnell | 2525142 | Murata Electronics | GRM21BR61H475ME51L | Digikey | 490-14663-1-ND | Murata Electronics | GRM21BR61H475ME51L | Mouser | 81-GRM21BR61H475M51L | Taiyo Yuden | UMK212BBJ475KG-T | Mouser | 963-UMK212BBJ475KG-T | - | - | - | - |  | - | 7S00900100 | 13 | -
 | C58 | C0402-100n/50V/10%/X7R | CAP CER 0.1UF 50V 10% X7R 0402 | SMT | 100n/50V/X7R | TDK | CGA2B3X7R1H104K050BB | Farnell | 2210822 | Murata | GCM155R71H104KE02D | Digikey | 490-10672-1-ND | Murata | GRM155R71H104KE14D | Mouser | 81-GRM155R71H104KE4D | - | - | - | - | SAMSUNG | CL05B104KB5NNNC | Comet | C0402 100nF 50V X7R |  | - | 7S00700043 | 25 | -
 | C59 | C0402-47n/50V/10%/X7R | CAP CER 0.047UF 50V X7R 0402 | SMT | 47n/50V/X7R | TDK | CGA2B3X7R1H473K050BB | Farnell | 2210827 | TDK Corporation | CGA2B3X7R1H473K050BB | Digikey | 445-6897-1-ND | Murata Electronics | GRM155R71H473KE14D | Mouser | 81-GRM155R71H473KE4D | - | - | - | - | - | - | - | - |  | - | 7S00700090 | 25 | -
 | C60 | C0402-1u/16V/10%/X5R | CAP CER 1UF 16V X5R 0402 10% | SMT | 1u/16V/X5R | TAIYO YUDEN | EMK105BJ105KV-F | Farnell | 2113064 | MURATA | GRM155R61C105KA12D | Digikey | 490-10694-1-ND | Taiyo Yuden | EMK105BJ105KV-F | Mouser | 963-EMK105BJ105KV-F | - | - | - | - | - | - | - | - |  | 9621 | 7S00700081 | 25 | -
 | C61 | C0402-1n/50V/X7R | CAP CER 1000PF 50V 10% X7R 0402 | SMT | 1n/50V/X7R | WURTH | '885012205061 | Farnell | 2495166 | Murata | GCM155R71H102KA37D | Digikey | 490-4761-1-ND | Murata | GCM155R71H102KA37D | Mouser | 81-GCM155R71H102KA7D | - | - | - | - | - | - | - | - |  | - | 7S00700004 | 25 | -
 | C62 | C0402-1n/50V/X7R | CAP CER 1000PF 50V 10% X7R 0402 | SMT | 1n/50V/X7R | WURTH | '885012205061 | Farnell | 2495166 | Murata | GCM155R71H102KA37D | Digikey | 490-4761-1-ND | Murata | GCM155R71H102KA37D | Mouser | 81-GCM155R71H102KA7D | - | - | - | - | - | - | - | - |  | - | 7S00700004 | 25 | -
 | C63 | C0402-1n/50V/X7R | CAP CER 1000PF 50V 10% X7R 0402 | SMT | 1n/50V/X7R | WURTH | '885012205061 | Farnell | 2495166 | Murata | GCM155R71H102KA37D | Digikey | 490-4761-1-ND | Murata | GCM155R71H102KA37D | Mouser | 81-GCM155R71H102KA7D | - | - | - | - | - | - | - | - |  | - | 7S00700004 | 25 | -
 | C64 | C0402-100n/50V/10%/X7R | CAP CER 0.1UF 50V 10% X7R 0402 | SMT | 100n/50V/X7R | TDK | CGA2B3X7R1H104K050BB | Farnell | 2210822 | Murata | GCM155R71H104KE02D | Digikey | 490-10672-1-ND | Murata | GRM155R71H104KE14D | Mouser | 81-GRM155R71H104KE4D | - | - | - | - | SAMSUNG | CL05B104KB5NNNC | Comet | C0402 100nF 50V X7R |  | - | 7S00700043 | 25 | -
 | C65 | C0402-100n/50V/10%/X7R | CAP CER 0.1UF 50V 10% X7R 0402 | SMT | 100n/50V/X7R | TDK | CGA2B3X7R1H104K050BB | Farnell | 2210822 | Murata | GCM155R71H104KE02D | Digikey | 490-10672-1-ND | Murata | GRM155R71H104KE14D | Mouser | 81-GRM155R71H104KE4D | - | - | - | - | SAMSUNG | CL05B104KB5NNNC | Comet | C0402 100nF 50V X7R |  | - | 7S00700043 | 25 | -
 | C66 | C_EL/SIZE F/-100U/50V 24MOHMS ESR H12.7MM | CAP ALUM POLY 100UF 20% 50V SMD 24mOhms ESR | SMT | 100u/50V | - | - | - | - | KEMET | A768MS107M1HLAE024 | Digikey | 399-A768MS107M1HLAE024CT-ND | KEMET | A768MS107M1HLAE024 | Mouser | 80-A768MS107M1HLAE24 | - | - | - | - | - | - | - | - |  | - | 7S02000209 | 4 | -
 | C67 | C0603-1u/50V/10%/X5R | Chip Capacitor 0603 1u/50V/±10%/X5R | SMT | 1u/50V/10%/X5R | TAIYO YUDEN | UMK107BJ105KA-T | Farnell | 2112858 | MURATA | GRT188R61H105KE13D | Digikey | 490-12330-1-ND | Taiyo Yuden | UMK107BJ105KA-T | Mouser | 963-UMK107BJ105KA-T | - | - | - | - | - | - | - | - |  | - | 7S00800117 | 13 | -
 | C68 | C_EL/SIZE F/-100U/50V 24MOHMS ESR H12.7MM | CAP ALUM POLY 100UF 20% 50V SMD 24mOhms ESR | SMT | 100u/50V | - | - | - | - | KEMET | A768MS107M1HLAE024 | Digikey | 399-A768MS107M1HLAE024CT-ND | KEMET | A768MS107M1HLAE024 | Mouser | 80-A768MS107M1HLAE24 | - | - | - | - | - | - | - | - |  | - | 7S02000209 | 4 | -
 | C69 | C0603-1u/50V/10%/X5R | Chip Capacitor 0603 1u/50V/±10%/X5R | SMT | 1u/50V/10%/X5R | TAIYO YUDEN | UMK107BJ105KA-T | Farnell | 2112858 | MURATA | GRT188R61H105KE13D | Digikey | 490-12330-1-ND | Taiyo Yuden | UMK107BJ105KA-T | Mouser | 963-UMK107BJ105KA-T | - | - | - | - | - | - | - | - |  | - | 7S00800117 | 13 | -
 | C70 | C_EL/SIZE F/-100U/50V 24MOHMS ESR H12.7MM | CAP ALUM POLY 100UF 20% 50V SMD 24mOhms ESR | SMT | 100u/50V | - | - | - | - | KEMET | A768MS107M1HLAE024 | Digikey | 399-A768MS107M1HLAE024CT-ND | KEMET | A768MS107M1HLAE024 | Mouser | 80-A768MS107M1HLAE24 | - | - | - | - | - | - | - | - |  | - | 7S02000209 | 4 | -
 | C71 | C0603-1u/50V/10%/X5R | Chip Capacitor 0603 1u/50V/±10%/X5R | SMT | 1u/50V/10%/X5R | TAIYO YUDEN | UMK107BJ105KA-T | Farnell | 2112858 | MURATA | GRT188R61H105KE13D | Digikey | 490-12330-1-ND | Taiyo Yuden | UMK107BJ105KA-T | Mouser | 963-UMK107BJ105KA-T | - | - | - | - | - | - | - | - |  | - | 7S00800117 | 13 | -
 | C72 | C_EL/SIZE F/-100U/50V 24MOHMS ESR H12.7MM | CAP ALUM POLY 100UF 20% 50V SMD 24mOhms ESR | SMT | 100u/50V | - | - | - | - | KEMET | A768MS107M1HLAE024 | Digikey | 399-A768MS107M1HLAE024CT-ND | KEMET | A768MS107M1HLAE024 | Mouser | 80-A768MS107M1HLAE24 | - | - | - | - | - | - | - | - |  | - | 7S02000209 | 4 | -
 | C73 | C0603-1u/50V/10%/X5R | Chip Capacitor 0603 1u/50V/±10%/X5R | SMT | 1u/50V/10%/X5R | TAIYO YUDEN | UMK107BJ105KA-T | Farnell | 2112858 | MURATA | GRT188R61H105KE13D | Digikey | 490-12330-1-ND | Taiyo Yuden | UMK107BJ105KA-T | Mouser | 963-UMK107BJ105KA-T | - | - | - | - | - | - | - | - |  | - | 7S00800117 | 13 | -
 | C74 | C_EL/SIZE F/-100U/50V 24MOHMS ESR H12.7MM | CAP ALUM POLY 100UF 20% 50V SMD 24mOhms ESR | SMT | 100u/50V | - | - | - | - | KEMET | A768MS107M1HLAE024 | Digikey | 399-A768MS107M1HLAE024CT-ND | KEMET | A768MS107M1HLAE024 | Mouser | 80-A768MS107M1HLAE24 | - | - | - | - | - | - | - | - |  | - | 7S02000209 | 4 | -
 | C75 | C0603-1u/50V/10%/X5R | Chip Capacitor 0603 1u/50V/±10%/X5R | SMT | 1u/50V/10%/X5R | TAIYO YUDEN | UMK107BJ105KA-T | Farnell | 2112858 | MURATA | GRT188R61H105KE13D | Digikey | 490-12330-1-ND | Taiyo Yuden | UMK107BJ105KA-T | Mouser | 963-UMK107BJ105KA-T | - | - | - | - | - | - | - | - |  | - | 7S00800117 | 13 | -
 | C76 | C_EL/SIZE F/-100U/50V 24MOHMS ESR H12.7MM | CAP ALUM POLY 100UF 20% 50V SMD 24mOhms ESR | SMT | 100u/50V | - | - | - | - | KEMET | A768MS107M1HLAE024 | Digikey | 399-A768MS107M1HLAE024CT-ND | KEMET | A768MS107M1HLAE024 | Mouser | 80-A768MS107M1HLAE24 | - | - | - | - | - | - | - | - |  | - | 7S02000209 | 4 | -
 | C77 | C0603-1u/50V/10%/X5R | Chip Capacitor 0603 1u/50V/±10%/X5R | SMT | 1u/50V/10%/X5R | TAIYO YUDEN | UMK107BJ105KA-T | Farnell | 2112858 | MURATA | GRT188R61H105KE13D | Digikey | 490-12330-1-ND | Taiyo Yuden | UMK107BJ105KA-T | Mouser | 963-UMK107BJ105KA-T | - | - | - | - | - | - | - | - |  | - | 7S00800117 | 13 | -
 | C78 | C0402-100n/50V/10%/X7R | CAP CER 0.1UF 50V 10% X7R 0402 | SMT | 100n/50V/X7R | TDK | CGA2B3X7R1H104K050BB | Farnell | 2210822 | Murata | GCM155R71H104KE02D | Digikey | 490-10672-1-ND | Murata | GRM155R71H104KE14D | Mouser | 81-GRM155R71H104KE4D | - | - | - | - | SAMSUNG | CL05B104KB5NNNC | Comet | C0402 100nF 50V X7R |  | - | 7S00700043 | 25 | -
 | C79 | C0402-100n/50V/10%/X7R | CAP CER 0.1UF 50V 10% X7R 0402 | SMT | 100n/50V/X7R | TDK | CGA2B3X7R1H104K050BB | Farnell | 2210822 | Murata | GCM155R71H104KE02D | Digikey | 490-10672-1-ND | Murata | GRM155R71H104KE14D | Mouser | 81-GRM155R71H104KE4D | - | - | - | - | SAMSUNG | CL05B104KB5NNNC | Comet | C0402 100nF 50V X7R |  | - | 7S00700043 | 25 | -
 | C80 | C0402-100n/50V/10%/X7R | CAP CER 0.1UF 50V 10% X7R 0402 | SMT | 100n/50V/X7R | TDK | CGA2B3X7R1H104K050BB | Farnell | 2210822 | Murata | GCM155R71H104KE02D | Digikey | 490-10672-1-ND | Murata | GRM155R71H104KE14D | Mouser | 81-GRM155R71H104KE4D | - | - | - | - | SAMSUNG | CL05B104KB5NNNC | Comet | C0402 100nF 50V X7R |  | - | 7S00700043 | 25 | -
 | C81 | C0402-100n/50V/10%/X7R | CAP CER 0.1UF 50V 10% X7R 0402 | SMT | 100n/50V/X7R | TDK | CGA2B3X7R1H104K050BB | Farnell | 2210822 | Murata | GCM155R71H104KE02D | Digikey | 490-10672-1-ND | Murata | GRM155R71H104KE14D | Mouser | 81-GRM155R71H104KE4D | - | - | - | - | SAMSUNG | CL05B104KB5NNNC | Comet | C0402 100nF 50V X7R |  | - | 7S00700043 | 25 | -
 | C98 | C1812-4n7/2000V X7R | CAPACITOR 1812 4n7F 2000V X7R | SMT | 4n7/2000V | JOHANSON DIELECTRICS | 202S43W472KV4E | Farnell | 1886080 | JOHANSON DIELECTRICS | 202S43W472KV4E | Digikey | 709-1308-1-ND | Johanson Dielectrics | 202S43W472KV4E | Mouser | 605-202S43W472KV4E | - | - | - | - | - | - | - | - |  | - | 7S01300012 | 7 | -
 | CN1 | 691313710004 | Serie 3137- 5.00mm Close Horizontal PCB Header WR-TBL 4W | THT | 691313710004 | WURTH ELEKTRONIK | 691313710004 | WURTH ELEKTRONIK | 691313710004 | WURTH ELEKTRONIK | 691313710004 | Digikey | 732-2801-ND | WURTH ELEKTRONIK | 691313710004 | Mouser | 710-691313710004 | - | - | - | - | - | - | - | - |  | - | 7S03000134 |  | -
 | CN2 | DF11-10DP-2DS_24 | CONN HEADER R/A 10POS 2MM | THT | DF11-10DP-2DS_24 | Hirose Electric Co Ltd | DF11-10DP-2DS(24) | Farnell | 1688361 | Hirose Electric Co Ltd | DF11-10DP-2DS(24) | Digikey | H10247-ND | Hirose Electric Co Ltd | DF11-10DP-2DS(24) | Mouser | 798-DF11-10DP-2DS24 | - | - | - | - | - | - | - | - |  | - | 7S02400744 | 0 | -
 | CN3 | DF11-10DP-2DS_24 | CONN HEADER R/A 10POS 2MM | THT | DF11-10DP-2DS_24 | Hirose Electric Co Ltd | DF11-10DP-2DS(24) | Farnell | 1688361 | Hirose Electric Co Ltd | DF11-10DP-2DS(24) | Digikey | H10247-ND | Hirose Electric Co Ltd | DF11-10DP-2DS(24) | Mouser | 798-DF11-10DP-2DS24 | - | - | - | - | - | - | - | - |  | - | 7S02400744 | 0 | -
 | CN4 | DF11-6DP-2DS_24 | CONN HEADER R/A 6POS 2MM | THT | DF11-6DP-2DS_24 | HIROSE(HRS) | DF11-6DP-2DSA(24) | Farnell | 1688343 | Hirose Electric Co Ltd | DF11-6DP-2DS(24) | Digikey | H10245-ND | Hirose Connector | DF11-6DP-2DS(24) | Mouser | 798-DF11-6DP-2DS24 | - | - | - | - | - | - | - | - |  | - | 7S02400746 | 0 | -
 | CN5 | DF11-4DP-2DS_24 | CONN HEADER R/A 4POS 2MM | THT | DF11-4DP-2DS_24 | Hirose Electric Co Ltd | DF11-4DP-2DS(24) | Farnell | 1688358 | Hirose Electric Co Ltd | DF11-4DP-2DS(24) | Digikey | H10244-ND | Hirose Electric Co Ltd | DF11-4DP-2DS(24) | Mouser | 798-DF11-4DP-2DS24 | - | - | - | - | - | - | - | - |  | - | 7S02400742 | 0 | -
 | CN6 | DF11-4DP-2DS_24 | CONN HEADER R/A 4POS 2MM | THT | DF11-4DP-2DS_24 | Hirose Electric Co Ltd | DF11-4DP-2DS(24) | Farnell | 1688358 | Hirose Electric Co Ltd | DF11-4DP-2DS(24) | Digikey | H10244-ND | Hirose Electric Co Ltd | DF11-4DP-2DS(24) | Mouser | 798-DF11-4DP-2DS24 | - | - | - | - | - | - | - | - |  | - | 7S02400742 | 0 | -
 | CN7 | DF11-4DP-2DS_24 | CONN HEADER R/A 4POS 2MM | THT | DF11-4DP-2DS_24 | Hirose Electric Co Ltd | DF11-4DP-2DS(24) | Farnell | 1688358 | Hirose Electric Co Ltd | DF11-4DP-2DS(24) | Digikey | H10244-ND | Hirose Electric Co Ltd | DF11-4DP-2DS(24) | Mouser | 798-DF11-4DP-2DS24 | - | - | - | - | - | - | - | - |  | - | 7S02400742 | 0 | -
 | CN8 | 61400416121 | CONNECTOR USB B RECEPTACLE PCB R/A | THT | USB Type B - 61400416121 | WURTH ELEKTRONIK | '61400416121 | Farnell | 1642035 | - | - | - | - | WURTH ELEKTRONIK | 61400416121 | WURTH ELEKTRONIK | 61400416121 | - | - | - | - | - | - | - | - |  | - | 7S03000010 |  | -
 | CN9 | 62131021021 | 1.27 mm SMD Dual Pin Header H=3.80mm | SMT | WURTH 62131021021 | WURTH ELEKTRONIK | 62131021021 | WURTH ELEKTRONIK | 62131021021 | - | - | - | - | WURTH ELEKTRONIK | 62131021021 | WURTH ELEKTRONIK | 62131021021 | - | - | - | - | - | - | - | - |  | - | 7S03000088 |  | -
 | CN10 | DF11-4DP-2DS_24 | CONN HEADER R/A 4POS 2MM | THT | DF11-4DP-2DS_24 | Hirose Electric Co Ltd | DF11-4DP-2DS(24) | Farnell | 1688358 | Hirose Electric Co Ltd | DF11-4DP-2DS(24) | Digikey | H10244-ND | Hirose Electric Co Ltd | DF11-4DP-2DS(24) | Mouser | 798-DF11-4DP-2DS24 | - | - | - | - | - | - | - | - |  | - | 7S02400742 | 0 | -
 | CN11 | DF11-4DP-2DS_24 | CONN HEADER R/A 4POS 2MM | THT | DF11-4DP-2DS_24 | Hirose Electric Co Ltd | DF11-4DP-2DS(24) | Farnell | 1688358 | Hirose Electric Co Ltd | DF11-4DP-2DS(24) | Digikey | H10244-ND | Hirose Electric Co Ltd | DF11-4DP-2DS(24) | Mouser | 798-DF11-4DP-2DS24 | - | - | - | - | - | - | - | - |  | - | 7S02400742 | 0 | -
 | CN12 | DF11-10DP-2DS_24 | CONN HEADER R/A 10POS 2MM | THT | DF11-10DP-2DS_24 | Hirose Electric Co Ltd | DF11-10DP-2DS(24) | Farnell | 1688361 | Hirose Electric Co Ltd | DF11-10DP-2DS(24) | Digikey | H10247-ND | Hirose Electric Co Ltd | DF11-10DP-2DS(24) | Mouser | 798-DF11-10DP-2DS24 | - | - | - | - | - | - | - | - |  | - | 7S02400744 | 0 | -
 | CN13 | 691313710003 | TERM BLOCK HDR 3POS 90DEG 5MM | THT | 691313710003 | WURTH ELEKTRONIK | 691313710003 | WURTH ELEKTRONIK | 691313710003 | WURTH ELEKTRONIK | 691313710003 | Digikey | 732-2800-ND | WURTH ELEKTRONIK | 691313710003 | Mouser | 710-691313710003 | - | - | - | - | - | - | - | - |  | - | 7S03000363 | - | -
 | CN14 | Molex - 43650-0300 | CONN HEADER R/A 3POS 3MM | THT | Molex - 43650-0300 | MOLEX | 43650-0300 | Farnell | 1012231 | MOLEX | 43650-0300 | Digikey | WM1861-ND | MOLEX | 43650-0300 | Mouser | 538-43650-0300 | - | - | - | - | - | - | - | - |  | - | 7S02600312 | 0 | -
 | CN15 | 691313710003 | TERM BLOCK HDR 3POS 90DEG 5MM | THT | 691313710003 | WURTH ELEKTRONIK | 691313710003 | WURTH ELEKTRONIK | 691313710003 | WURTH ELEKTRONIK | 691313710003 | Digikey | 732-2800-ND | WURTH ELEKTRONIK | 691313710003 | Mouser | 710-691313710003 | - | - | - | - | - | - | - | - |  | - | 7S03000363 | - | -
 | CN16 | Molex - 43650-0300 | CONN HEADER R/A 3POS 3MM | THT | Molex - 43650-0300 | MOLEX | 43650-0300 | Farnell | 1012231 | MOLEX | 43650-0300 | Digikey | WM1861-ND | MOLEX | 43650-0300 | Mouser | 538-43650-0300 | - | - | - | - | - | - | - | - |  | - | 7S02600312 | 0 | -
 | CN17 | DF11-10DP-2DS_24 | CONN HEADER R/A 10POS 2MM | THT | DF11-10DP-2DS_24 | Hirose Electric Co Ltd | DF11-10DP-2DS(24) | Farnell | 1688361 | Hirose Electric Co Ltd | DF11-10DP-2DS(24) | Digikey | H10247-ND | Hirose Electric Co Ltd | DF11-10DP-2DS(24) | Mouser | 798-DF11-10DP-2DS24 | - | - | - | - | - | - | - | - |  | - | 7S02400744 | 0 | -
 | CN18 | DF11-4DP-2DS_24 | CONN HEADER R/A 4POS 2MM | THT | DF11-4DP-2DS_24 | Hirose Electric Co Ltd | DF11-4DP-2DS(24) | Farnell | 1688358 | Hirose Electric Co Ltd | DF11-4DP-2DS(24) | Digikey | H10244-ND | Hirose Electric Co Ltd | DF11-4DP-2DS(24) | Mouser | 798-DF11-4DP-2DS24 | - | - | - | - | - | - | - | - |  | - | 7S02400742 | 0 | -
 | CN19 | DF11-4DP-2DS_24 | CONN HEADER R/A 4POS 2MM | THT | DF11-4DP-2DS_24 | Hirose Electric Co Ltd | DF11-4DP-2DS(24) | Farnell | 1688358 | Hirose Electric Co Ltd | DF11-4DP-2DS(24) | Digikey | H10244-ND | Hirose Electric Co Ltd | DF11-4DP-2DS(24) | Mouser | 798-DF11-4DP-2DS24 | - | - | - | - | - | - | - | - |  | - | 7S02400742 | 0 | -
 | D1 | PMEG100V100ELPDZ | DIODE SCHOTTKY 100V 10A CFP15 | SMT | PMEG100V100ELPDZ | Nexperia USA Inc. | PMEG100V100ELPDZ | Farnell | 2777474 | Nexperia USA Inc. | PMEG100V100ELPDZ | Digikey | PMEG100V100ELPDZ-ND | Nexperia USA Inc. | PMEG100V100ELPDZ | Mouser | 771-PMEG100V100ELPDZ | - | - | - | - | - | - | - | - |  | - | 7S03400380 |  | -
 | D2 | 824031815 | WE-TVS TVS Diode 5V | SMT | 824031815 | WURTH ELECTRONICS | 824031815 | WURTH ELECTRONICS | 824031815 | - | - | WURTH ELECTRONICS | 824031815 | - | - | WURTH ELECTRONICS | 824031815 | - | - | - | - | - | - | - | - |  | - | 7S03700109 | 13 | -
 | D3 | 824031815 | WE-TVS TVS Diode 5V | SMT | 824031815 | WURTH ELECTRONICS | 824031815 | WURTH ELECTRONICS | 824031815 | - | - | WURTH ELECTRONICS | 824031815 | - | - | WURTH ELECTRONICS | 824031815 | - | - | - | - | - | - | - | - |  | - | 7S03700109 | 13 | -
 | D4 | BAT54J | DIODE SCHOTTKY 30V 200MA SOD323F | SMT | BAT54J | - | - | - | - | NXP Semiconductors | BAT54J-115 | Digikey | 568-6018-1-ND | Nexperia | BAT54J.115 | Mouser | 771-BAT54J115 | - | - | - | - | - | - | - | - |  | - | 7S03400280 | 13 | -
 | D5 | BAT54J | DIODE SCHOTTKY 30V 200MA SOD323F | SMT | BAT54J | - | - | - | - | NXP Semiconductors | BAT54J-115 | Digikey | 568-6018-1-ND | Nexperia | BAT54J.115 | Mouser | 771-BAT54J115 | - | - | - | - | - | - | - | - |  | - | 7S03400280 | 13 | -
 | D6 | STPS0560Z | Schottky Rectifier 60V 500mA Single SOD-123 2 Pins 530mV | SMT | STPS0560Z | STMICROELECTRONICS | STPS0560Z | Farnell | 2395845 | STMicroelectronics | STPS0560Z | Digikey | 497-3787-1-ND | STMicroelectronics | STPS0560Z | Mouser | 511-STPS0560Z | - | - | - | - | - | - | - | - |  | - | 7S03400377 | 13 | -
 | D7 | STPS0560Z | Schottky Rectifier 60V 500mA Single SOD-123 2 Pins 530mV | SMT | STPS0560Z | STMICROELECTRONICS | STPS0560Z | Farnell | 2395845 | STMicroelectronics | STPS0560Z | Digikey | 497-3787-1-ND | STMicroelectronics | STPS0560Z | Mouser | 511-STPS0560Z | - | - | - | - | - | - | - | - |  | - | 7S03400377 | 13 | -
 | DL1 | 553-0112F | LED PCB 3MM RED-GRN | THT | 553-0112F | DIALIGHT | 553-0112F | Farnell | 1461591 | DIALIGHT | 553-0112F | Digikey | 350-2363-ND | Kingbright | L-710A8EB/1I1GD | Comet | L-710A8EB/1I1GD | - | - | - | - | - | - | - | - |  | - | 7S04700162 |  | -
 | DL2 | 553-0112F | LED PCB 3MM RED-GRN | THT | 553-0112F | DIALIGHT | 553-0112F | Farnell | 1461591 | DIALIGHT | 553-0112F | Digikey | 350-2363-ND | Kingbright | L-710A8EB/1I1GD | Comet | L-710A8EB/1I1GD | - | - | - | - | - | - | - | - |  | - | 7S04700162 |  | -
 | F1 | PTS120660V010 | PTC RESET FUSE 60V 100MA 1206 | SMT | F 1206 100mA 60V PTS120660V010 | - | - | - | - | Bussmann / Eaton | PTS120660V010 | Digikey | 283-3133-1-ND | Bussmann / Eaton | PTS120660V010 | Mouser | 504-PTS120660V010 | - | - | - | - | - | - | - | - |  | - | 7S03900107 | 13 | -
 | F2 | PTS120660V010 | PTC RESET FUSE 60V 100MA 1206 | SMT | F 1206 100mA 60V PTS120660V010 | - | - | - | - | Bussmann / Eaton | PTS120660V010 | Digikey | 283-3133-1-ND | Bussmann / Eaton | PTS120660V010 | Mouser | 504-PTS120660V010 | - | - | - | - | - | - | - | - |  | - | 7S03900107 | 13 | -
 | F3 | SCHURTER 8040.0001 FUSE CLIP | FUSE CLIP TH 6.3X32MM 32A / 600V | THT | SCHURTER 8040.0001 FUSE CLIP | SCHURTER | 8040.0001 | Farnell | 1829517 x 2 | SCHURTER | 8040.0001 | Digikey | 486-3876-ND | SCHURTER | 8040.0001 | Mouser | 693-8040.0001 | - | - | - | - | - | - | - | - |  | - | 7S03900053 |  | -
 | F4 | SCHURTER 8040.0001 FUSE CLIP | FUSE CLIP TH 6.3X32MM 32A / 600V | THT | SCHURTER 8040.0001 FUSE CLIP | SCHURTER | 8040.0001 | Farnell | 1829517 x 2 | SCHURTER | 8040.0001 | Digikey | 486-3876-ND | SCHURTER | 8040.0001 | Mouser | 693-8040.0001 | - | - | - | - | - | - | - | - |  | - | 7S03900053 |  | -
 | F5 | PTS120660V010 | PTC RESET FUSE 60V 100MA 1206 | SMT | F 1206 100mA 60V PTS120660V010 | - | - | - | - | Bussmann / Eaton | PTS120660V010 | Digikey | 283-3133-1-ND | Bussmann / Eaton | PTS120660V010 | Mouser | 504-PTS120660V010 | - | - | - | - | - | - | - | - |  | - | 7S03900107 | 13 | -
 | F6 | PTS120660V010 | PTC RESET FUSE 60V 100MA 1206 | SMT | F 1206 100mA 60V PTS120660V010 | - | - | - | - | Bussmann / Eaton | PTS120660V010 | Digikey | 283-3133-1-ND | Bussmann / Eaton | PTS120660V010 | Mouser | 504-PTS120660V010 | - | - | - | - | - | - | - | - |  | - | 7S03900107 | 13 | -
 | F7 | PTS120660V010 | PTC RESET FUSE 60V 100MA 1206 | SMT | F 1206 100mA 60V PTS120660V010 | - | - | - | - | Bussmann / Eaton | PTS120660V010 | Digikey | 283-3133-1-ND | Bussmann / Eaton | PTS120660V010 | Mouser | 504-PTS120660V010 | - | - | - | - | - | - | - | - |  | - | 7S03900107 | 13 | -
 | F8 | PTS120660V010 | PTC RESET FUSE 60V 100MA 1206 | SMT | F 1206 100mA 60V PTS120660V010 | - | - | - | - | Bussmann / Eaton | PTS120660V010 | Digikey | 283-3133-1-ND | Bussmann / Eaton | PTS120660V010 | Mouser | 504-PTS120660V010 | - | - | - | - | - | - | - | - |  | - | 7S03900107 | 13 | -
 | F9 | PTS120660V010 | PTC RESET FUSE 60V 100MA 1206 | SMT | F 1206 100mA 60V PTS120660V010 | - | - | - | - | Bussmann / Eaton | PTS120660V010 | Digikey | 283-3133-1-ND | Bussmann / Eaton | PTS120660V010 | Mouser | 504-PTS120660V010 | - | - | - | - | - | - | - | - |  | - | 7S03900107 | 13 | -
 | F10 | PTS120660V010 | PTC RESET FUSE 60V 100MA 1206 | SMT | F 1206 100mA 60V PTS120660V010 | - | - | - | - | Bussmann / Eaton | PTS120660V010 | Digikey | 283-3133-1-ND | Bussmann / Eaton | PTS120660V010 | Mouser | 504-PTS120660V010 | - | - | - | - | - | - | - | - |  | - | 7S03900107 | 13 | -
 | F11 | PTS120660V010 | PTC RESET FUSE 60V 100MA 1206 | SMT | F 1206 100mA 60V PTS120660V010 | - | - | - | - | Bussmann / Eaton | PTS120660V010 | Digikey | 283-3133-1-ND | Bussmann / Eaton | PTS120660V010 | Mouser | 504-PTS120660V010 | - | - | - | - | - | - | - | - |  | - | 7S03900107 | 13 | -
 | F12 | PTS120660V010 | PTC RESET FUSE 60V 100MA 1206 | SMT | F 1206 100mA 60V PTS120660V010 | - | - | - | - | Bussmann / Eaton | PTS120660V010 | Digikey | 283-3133-1-ND | Bussmann / Eaton | PTS120660V010 | Mouser | 504-PTS120660V010 | - | - | - | - | - | - | - | - |  | - | 7S03900107 | 13 | -
 | FB1 | FB 0603 - 1k8Ohm/0A5/0.8Ohm WE | FERRITE BEAD 1800OHM 0A5 0603 WE | SMT | 1k8Ohm/0A5 | WURTH ELEKTRONIK | 742792692 | WURTH ELEKTRONIK | 742792692 | - | - | - | - | WURTH ELEKTRONIK | 742792692 | Mouser | 710-742792692 | - | - | - | - | - | - | - | - |  | - | 7S03700166 | - | -
 | FB2 | FB 0603 - 1k8Ohm/0A5/0.8Ohm WE | FERRITE BEAD 1800OHM 0A5 0603 WE | SMT | 1k8Ohm/0A5 | WURTH ELEKTRONIK | 742792692 | WURTH ELEKTRONIK | 742792692 | - | - | - | - | WURTH ELEKTRONIK | 742792692 | Mouser | 710-742792692 | - | - | - | - | - | - | - | - |  | - | 7S03700166 | - | -
 | J1 | Header 2x1/100/0gr | Header 1Row 2.54mm S 2 pins | THT | Header 2x1/100/0gr | - | - | - | - | - | - | - | - | TE Connectivity | 5-146282-2 | Mouser | 571-5-146282-2 | - | - | - | - | - | - | - | - |  | - | 7S04000018 | 0 | -
NA | J2 | Header 2x1/100/0gr | Header 1Row 2.54mm S 2 pins | THT | Header 2x1/100/0gr | - | - | - | - | - | - | - | - | TE Connectivity | 5-146282-2 | Mouser | 571-5-146282-2 | - | - | - | - | - | - | - | - | NA | - | 7S04000018 | 0 | -
 | J4 | J - 1x2 SM 1mm | solder Jumper smd | SMT | Jumper | - | - | - | - | - | - | - | - | - | - | - | - | - | - | - | - | - | - | - | - |  | - | 7S04500008 | 0 | -
 | J5 | J - 1x2 SM 1mm | solder Jumper smd | SMT | Jumper | - | - | - | - | - | - | - | - | - | - | - | - | - | - | - | - | - | - | - | - |  | - | 7S04500008 | 0 | -
 | J6 | J - 1x2 SM 1mm | solder Jumper smd | SMT | Jumper | - | - | - | - | - | - | - | - | - | - | - | - | - | - | - | - | - | - | - | - |  | - | 7S04500008 | 0 | -
 | J7 | J - 1x2 SM 1mm | solder Jumper smd | SMT | Jumper | - | - | - | - | - | - | - | - | - | - | - | - | - | - | - | - | - | - | - | - |  | - | 7S04500008 | 0 | -
 | J8 | J - 1x2 SM 1mm | solder Jumper smd | SMT | Jumper | - | - | - | - | - | - | - | - | - | - | - | - | - | - | - | - | - | - | - | - |  | - | 7S04500008 | 0 | -
 | J9 | J - 1x2 SM 1mm | solder Jumper smd | SMT | Jumper | - | - | - | - | - | - | - | - | - | - | - | - | - | - | - | - | - | - | - | - |  | - | 7S04500008 | 0 | -
 | J10 | J - 1x2 SM 1mm | solder Jumper smd | SMT | Jumper | - | - | - | - | - | - | - | - | - | - | - | - | - | - | - | - | - | - | - | - |  | - | 7S04500008 | 0 | -
 | J11 | J - 1x2 SM 1mm | solder Jumper smd | SMT | Jumper | - | - | - | - | - | - | - | - | - | - | - | - | - | - | - | - | - | - | - | - |  | - | 7S04500008 | 0 | -
 | J12 | J - 1x2 SM 1mm | solder Jumper smd | SMT | Jumper | - | - | - | - | - | - | - | - | - | - | - | - | - | - | - | - | - | - | - | - |  | - | 7S04500008 | 0 | -
 | J13 | J - 1x2 SM 1mm | solder Jumper smd | SMT | Jumper | - | - | - | - | - | - | - | - | - | - | - | - | - | - | - | - | - | - | - | - |  | - | 7S04500008 | 0 | -
 | J14 | J - 1x2 SM 1mm | solder Jumper smd | SMT | Jumper | - | - | - | - | - | - | - | - | - | - | - | - | - | - | - | - | - | - | - | - |  | - | 7S04500008 | 0 | -
 | J15 | J - 1x2 SM 1mm | solder Jumper smd | SMT | Jumper | - | - | - | - | - | - | - | - | - | - | - | - | - | - | - | - | - | - | - | - |  | - | 7S04500008 | 0 | -
 | J16 | J - 1x2 SM 1mm | solder Jumper smd | SMT | Jumper | - | - | - | - | - | - | - | - | - | - | - | - | - | - | - | - | - | - | - | - |  | - | 7S04500008 | 0 | -
 | J17 | J - 1x2 SM 1mm | solder Jumper smd | SMT | Jumper | - | - | - | - | - | - | - | - | - | - | - | - | - | - | - | - | - | - | - | - |  | - | 7S04500008 | 0 | -
 | J18 | J - 1x2 SM 1mm | solder Jumper smd | SMT | Jumper | - | - | - | - | - | - | - | - | - | - | - | - | - | - | - | - | - | - | - | - |  | - | 7S04500008 | 0 | -
 | J19 | J - 1x2 SM 1mm | solder Jumper smd | SMT | Jumper | - | - | - | - | - | - | - | - | - | - | - | - | - | - | - | - | - | - | - | - |  | - | 7S04500008 | 0 | -
 | L1 | CHOKE CM/150UH/20A - 7448680180 | CMC 150UH 20A 2LN TH | THT | 150uH/20A | WURTH ELEKTRONIK | 7448680180 | WURTH ELEKTRONIK | 7448680180 | WURTH ELEKTRONIK | 7448680180 | Digikey | 732-11544-ND | WURTH ELEKTRONIK | 7448680180 | Mouser | 710-7448680180 | - | - | - | - | - | - | - | - |  | - | 7S04300579 |  | -
 | L2 | FB 1k8/0A1 0402 BLM15BD182SN1D | FERRITE BEAD 1.8 KOHM 0402 1LN 100mA 1.4Ohm | SMT | FB 1k8/0A1 | Murata Electronics | BLM15BD182SN1D | Farnell | 1515774 | Murata Electronics | BLM15BD182SN1D | Digikey | 490-5195-1-ND | Murata Electronics | BLM15BD182SN1D | Mouser | 81-BLM15BD182SN1D | - | - | - | - | - | - | - | - |  | - | 7S04300457 | 25 | -
 | L3 | L 22uH/1A4 - 74437346220 | FIXED IND 22UH 1.9A 190 MOHM SMD | SMT | 22uH/1A4 - 74437346220 | WURTH ELEKTRONIK | 74437346220 | WURTH ELEKTRONIK | 74437346220 | Wurth Elektronik | 74437346220 | DigiKey | 732-3380-1-ND | Wurth Elektronik | 74437346220 | Mouser | 710-74437346220 | - | - | - | - | - | - | - | - |  | - | 7S04300352 |  | -
 | L4 | L 22uH/1A4 - 74437346220 | FIXED IND 22UH 1.9A 190 MOHM SMD | SMT | 22uH/1A4 - 74437346220 | WURTH ELEKTRONIK | 74437346220 | WURTH ELEKTRONIK | 74437346220 | Wurth Elektronik | 74437346220 | DigiKey | 732-3380-1-ND | Wurth Elektronik | 74437346220 | Mouser | 710-74437346220 | - | - | - | - | - | - | - | - |  | - | 7S04300352 |  | -
 | Q1 | PXN012-60QLJ | N-Channel 60 V 42A 34.7W Surface Mount MLPAK33 | SMT | PXN012-60QLJ | - | - | - | - | Nexperia USA Inc. | PXN012-60QLJ | Digikey | 1727-PXN012-60QLJCT-ND | Nexperia | PXN012-60QLJ | Mouser | 771-PXN012-60QLJ | - | - | - | - | - | - | - | - |  | - | 7S09400555 | - | -
 | Q2 | PXN012-60QLJ | N-Channel 60 V 42A 34.7W Surface Mount MLPAK33 | SMT | PXN012-60QLJ | - | - | - | - | Nexperia USA Inc. | PXN012-60QLJ | Digikey | 1727-PXN012-60QLJCT-ND | Nexperia | PXN012-60QLJ | Mouser | 771-PXN012-60QLJ | - | - | - | - | - | - | - | - |  | - | 7S09400555 | - | -
 | Q3 | PXN012-60QLJ | N-Channel 60 V 42A 34.7W Surface Mount MLPAK33 | SMT | PXN012-60QLJ | - | - | - | - | Nexperia USA Inc. | PXN012-60QLJ | Digikey | 1727-PXN012-60QLJCT-ND | Nexperia | PXN012-60QLJ | Mouser | 771-PXN012-60QLJ | - | - | - | - | - | - | - | - |  | - | 7S09400555 | - | -
 | Q4 | PXN012-60QLJ | N-Channel 60 V 42A 34.7W Surface Mount MLPAK33 | SMT | PXN012-60QLJ | - | - | - | - | Nexperia USA Inc. | PXN012-60QLJ | Digikey | 1727-PXN012-60QLJCT-ND | Nexperia | PXN012-60QLJ | Mouser | 771-PXN012-60QLJ | - | - | - | - | - | - | - | - |  | - | 7S09400555 | - | -
 | Q5 | PXN012-60QLJ | N-Channel 60 V 42A 34.7W Surface Mount MLPAK33 | SMT | PXN012-60QLJ | - | - | - | - | Nexperia USA Inc. | PXN012-60QLJ | Digikey | 1727-PXN012-60QLJCT-ND | Nexperia | PXN012-60QLJ | Mouser | 771-PXN012-60QLJ | - | - | - | - | - | - | - | - |  | - | 7S09400555 | - | -
 | Q6 | PXN012-60QLJ | N-Channel 60 V 42A 34.7W Surface Mount MLPAK33 | SMT | PXN012-60QLJ | - | - | - | - | Nexperia USA Inc. | PXN012-60QLJ | Digikey | 1727-PXN012-60QLJCT-ND | Nexperia | PXN012-60QLJ | Mouser | 771-PXN012-60QLJ | - | - | - | - | - | - | - | - |  | - | 7S09400555 | - | -
 | Q7 | PXN012-60QLJ | N-Channel 60 V 42A 34.7W Surface Mount MLPAK33 | SMT | PXN012-60QLJ | - | - | - | - | Nexperia USA Inc. | PXN012-60QLJ | Digikey | 1727-PXN012-60QLJCT-ND | Nexperia | PXN012-60QLJ | Mouser | 771-PXN012-60QLJ | - | - | - | - | - | - | - | - |  | - | 7S09400555 | - | -
 | Q8 | PXN012-60QLJ | N-Channel 60 V 42A 34.7W Surface Mount MLPAK33 | SMT | PXN012-60QLJ | - | - | - | - | Nexperia USA Inc. | PXN012-60QLJ | Digikey | 1727-PXN012-60QLJCT-ND | Nexperia | PXN012-60QLJ | Mouser | 771-PXN012-60QLJ | - | - | - | - | - | - | - | - |  | - | 7S09400555 | - | -
 | Q9 | PXN012-60QLJ | N-Channel 60 V 42A 34.7W Surface Mount MLPAK33 | SMT | PXN012-60QLJ | - | - | - | - | Nexperia USA Inc. | PXN012-60QLJ | Digikey | 1727-PXN012-60QLJCT-ND | Nexperia | PXN012-60QLJ | Mouser | 771-PXN012-60QLJ | - | - | - | - | - | - | - | - |  | - | 7S09400555 | - | -
 | Q10 | PXN012-60QLJ | N-Channel 60 V 42A 34.7W Surface Mount MLPAK33 | SMT | PXN012-60QLJ | - | - | - | - | Nexperia USA Inc. | PXN012-60QLJ | Digikey | 1727-PXN012-60QLJCT-ND | Nexperia | PXN012-60QLJ | Mouser | 771-PXN012-60QLJ | - | - | - | - | - | - | - | - |  | - | 7S09400555 | - | -
 | Q11 | PXN012-60QLJ | N-Channel 60 V 42A 34.7W Surface Mount MLPAK33 | SMT | PXN012-60QLJ | - | - | - | - | Nexperia USA Inc. | PXN012-60QLJ | Digikey | 1727-PXN012-60QLJCT-ND | Nexperia | PXN012-60QLJ | Mouser | 771-PXN012-60QLJ | - | - | - | - | - | - | - | - |  | - | 7S09400555 | - | -
 | Q12 | PXN012-60QLJ | N-Channel 60 V 42A 34.7W Surface Mount MLPAK33 | SMT | PXN012-60QLJ | - | - | - | - | Nexperia USA Inc. | PXN012-60QLJ | Digikey | 1727-PXN012-60QLJCT-ND | Nexperia | PXN012-60QLJ | Mouser | 771-PXN012-60QLJ | - | - | - | - | - | - | - | - |  | - | 7S09400555 | - | -
 | R1 | R0402-5% 2K2 | Chip Resistor 5% 0402 2K2 | SMT | 2k2 | Yageo | RC0402JR-072K2L | Farnell | 9232800 | Yageo | RC0402JR-072K2L | Digikey | 311-2.2KJRCT-ND | Yageo | RC0402JR-072K2L | Mouser | 603-RC0402JR-072K2L | - | - | - | - | - | - | - | - |  | 36543 | 7S05900106 | 25 | -
 | R2 | R0402-5% 2K2 | Chip Resistor 5% 0402 2K2 | SMT | 2k2 | Yageo | RC0402JR-072K2L | Farnell | 9232800 | Yageo | RC0402JR-072K2L | Digikey | 311-2.2KJRCT-ND | Yageo | RC0402JR-072K2L | Mouser | 603-RC0402JR-072K2L | - | - | - | - | - | - | - | - |  | 36543 | 7S05900106 | 25 | -
 | R3 | R0805-5% 13K | Chip Resistor 5% 0805 13k | SMT | 13k | - | - | - | - | - | - | - | - | Yageo | RC0805JR-0713KL | Mouser | 603-RC0805JR-0713KL | - | - | - | - | - | - | - | - |  | - | 7S06500125 | 13 | -
 | R4 | R0805-5% 13K | Chip Resistor 5% 0805 13k | SMT | 13k | - | - | - | - | - | - | - | - | Yageo | RC0805JR-0713KL | Mouser | 603-RC0805JR-0713KL | - | - | - | - | - | - | - | - |  | - | 7S06500125 | 13 | -
 | R5 | R0805-5% 13K | Chip Resistor 5% 0805 13k | SMT | 13k | - | - | - | - | - | - | - | - | Yageo | RC0805JR-0713KL | Mouser | 603-RC0805JR-0713KL | - | - | - | - | - | - | - | - |  | - | 7S06500125 | 13 | -
 | R6 | R0805-5% 13K | Chip Resistor 5% 0805 13k | SMT | 13k | - | - | - | - | - | - | - | - | Yageo | RC0805JR-0713KL | Mouser | 603-RC0805JR-0713KL | - | - | - | - | - | - | - | - |  | - | 7S06500125 | 13 | -
 | R7 | R0805-5% 0R | Chip Resistor 5% 0805 0R | SMT | 0R | MULTICOMP | MC 0.1W 0805 0R | Farnell | 9333681 | Yageo | RC0805JR-070RL | Digikey | 311-0.0ARCT-ND | Bourns | CR0805-J/-000ELF | Mouser | 652-CR0805-J/-000ELF | Uni ohm | 0805S8J000JT50 | Comet | R0805 0R 5% | - | - | - | - |  | - | 7S06500001 | 13 | -
 | R8 | R0805-5% 0R | Chip Resistor 5% 0805 0R | SMT | 0R | MULTICOMP | MC 0.1W 0805 0R | Farnell | 9333681 | Yageo | RC0805JR-070RL | Digikey | 311-0.0ARCT-ND | Bourns | CR0805-J/-000ELF | Mouser | 652-CR0805-J/-000ELF | Uni ohm | 0805S8J000JT50 | Comet | R0805 0R 5% | - | - | - | - |  | - | 7S06500001 | 13 | -
 | R9 | R0805-5% 220R | Chip Resistor 5% 0805 220R | SMT | 220R | WELWYN | ASC0805-220RFT5 | Farnell | 2078950 | Yageo | RC0805JR-07220RL | Digikey | 311-220ARCT-ND | Yageo | RC0805JR-07220RL | Mouser | 603-RC0805JR-07220RL | - | - | - | - | UNI OHM | 0805S8J0221T50 | Comet | R0805 220R 5% |  | - | 7S06500082 | 13 | -
 | R10 | R0805-5% 220R | Chip Resistor 5% 0805 220R | SMT | 220R | WELWYN | ASC0805-220RFT5 | Farnell | 2078950 | Yageo | RC0805JR-07220RL | Digikey | 311-220ARCT-ND | Yageo | RC0805JR-07220RL | Mouser | 603-RC0805JR-07220RL | - | - | - | - | UNI OHM | 0805S8J0221T50 | Comet | R0805 220R 5% |  | - | 7S06500082 | 13 | -
 | R11 | R0805-5% 220R | Chip Resistor 5% 0805 220R | SMT | 220R | WELWYN | ASC0805-220RFT5 | Farnell | 2078950 | Yageo | RC0805JR-07220RL | Digikey | 311-220ARCT-ND | Yageo | RC0805JR-07220RL | Mouser | 603-RC0805JR-07220RL | - | - | - | - | UNI OHM | 0805S8J0221T50 | Comet | R0805 220R 5% |  | - | 7S06500082 | 13 | -
 | R12 | R0805-5% 220R | Chip Resistor 5% 0805 220R | SMT | 220R | WELWYN | ASC0805-220RFT5 | Farnell | 2078950 | Yageo | RC0805JR-07220RL | Digikey | 311-220ARCT-ND | Yageo | RC0805JR-07220RL | Mouser | 603-RC0805JR-07220RL | - | - | - | - | UNI OHM | 0805S8J0221T50 | Comet | R0805 220R 5% |  | - | 7S06500082 | 13 | -
 | R13 | R0805-5% 10K | Chip Resistor 5% 0805 10k | SMT | 10k | Yageo | RC0805JR-0710KL | Farnell | 9234136 | Yageo | RC0805JR-0710KL | Digikey | 311-10KARCT-ND | Yageo | RC0805JR-0710KL | Mouser | 603-RC0805JR-0710KL | UNI OHM | 0805S8J0103T50 | Comet | R0805 10K 5% | - | - | - | - |  | - | 7S06500122 | 13 | -
 | R14 | R0805-5% 10K | Chip Resistor 5% 0805 10k | SMT | 10k | Yageo | RC0805JR-0710KL | Farnell | 9234136 | Yageo | RC0805JR-0710KL | Digikey | 311-10KARCT-ND | Yageo | RC0805JR-0710KL | Mouser | 603-RC0805JR-0710KL | UNI OHM | 0805S8J0103T50 | Comet | R0805 10K 5% | - | - | - | - |  | - | 7S06500122 | 13 | -
 | R15 | R0805-5% 13K | Chip Resistor 5% 0805 13k | SMT | 13k | - | - | - | - | - | - | - | - | Yageo | RC0805JR-0713KL | Mouser | 603-RC0805JR-0713KL | - | - | - | - | - | - | - | - |  | - | 7S06500125 | 13 | -
 | R16 | R0805-5% 13K | Chip Resistor 5% 0805 13k | SMT | 13k | - | - | - | - | - | - | - | - | Yageo | RC0805JR-0713KL | Mouser | 603-RC0805JR-0713KL | - | - | - | - | - | - | - | - |  | - | 7S06500125 | 13 | -
 | R17 | R0805-5% 13K | Chip Resistor 5% 0805 13k | SMT | 13k | - | - | - | - | - | - | - | - | Yageo | RC0805JR-0713KL | Mouser | 603-RC0805JR-0713KL | - | - | - | - | - | - | - | - |  | - | 7S06500125 | 13 | -
 | R18 | R0805-5% 13K | Chip Resistor 5% 0805 13k | SMT | 13k | - | - | - | - | - | - | - | - | Yageo | RC0805JR-0713KL | Mouser | 603-RC0805JR-0713KL | - | - | - | - | - | - | - | - |  | - | 7S06500125 | 13 | -
 | R19 | R0805-5% 120R | Chip Resistor 5% 0805 120R | SMT | 120R | PANASONIC | ERJ6GEYJ121V | Farnell | 2057683 | Yageo | RC0805JR-07120RL | Digikey | 311-120ARCT-ND | Yageo | RC0805JR-13120RL | Mouser | 603-RC0805JR-13120RL | - | - | - | - | - | - | - | - |  | - | 7S06500076 | 13 | -
 | R20 | R0805-5% 120R | Chip Resistor 5% 0805 120R | SMT | 120R | PANASONIC | ERJ6GEYJ121V | Farnell | 2057683 | Yageo | RC0805JR-07120RL | Digikey | 311-120ARCT-ND | Yageo | RC0805JR-13120RL | Mouser | 603-RC0805JR-13120RL | - | - | - | - | - | - | - | - |  | - | 7S06500076 | 13 | -
NA | R21 | R0603-5% 1k | Chip Resistor 5% 0603 1k | SMT | 1k | YAGEO | RC0603JR-071KL | Farnell | 9233385 | Yageo | RC0603JR-071KL | DIgiKey | 311-1.0KGRCT-ND | Yageo | RC0603JR-071KL | Mouser | 603-RC0603JR-071KL | - | - | - | - | - | - | - | - | NA | 3458 | 7S06200097 | 13 | -
NA | R22 | R0603-5% 1k | Chip Resistor 5% 0603 1k | SMT | 1k | YAGEO | RC0603JR-071KL | Farnell | 9233385 | Yageo | RC0603JR-071KL | DIgiKey | 311-1.0KGRCT-ND | Yageo | RC0603JR-071KL | Mouser | 603-RC0603JR-071KL | - | - | - | - | - | - | - | - | NA | 3458 | 7S06200097 | 13 | -
 | R23 | R0402-5% 10K | Chip Resistor 5% 0402 10k | SMT | 10k | PANASONIC | ERJ2GEJ103X | Farnell | 2059239 | Yageo | RC0402JR-0710KL | Digikey | 311-10KJRCT-ND | Yageo | RC0402JR-0710KL | Mouser | 603-RC0402JR-0710KL | Yageo | RC0402JR-1310KL | Mouser | 603-RC0402JR-1310KL | WAL/ASJ | - | Comet | R0402 10K 5% WAL/ASJ |  | 36134 | 7S05900122 | 25 | -
 | R24 | R0402-5% 22R | Chip Resistor 5% 0402 22R | SMT | 22R | MULTICOMP | MCMR04X220 JTL | Farnell | 2072778 | Panasonic - ECG | ERJ-2GEJ220X | Digikey | P22JCT-ND | Yageo | AC0402JR-0722RL | Mouser | 603-AC0402JR-0722RL | - | - | - | - | YAG | RC0402JR-0722RL | Comet | R0402 22R 5% YAG |  | 35127 | 7S05900058 | 25 | -
 | R25 | R0402-5% 22R | Chip Resistor 5% 0402 22R | SMT | 22R | MULTICOMP | MCMR04X220 JTL | Farnell | 2072778 | Panasonic - ECG | ERJ-2GEJ220X | Digikey | P22JCT-ND | Yageo | AC0402JR-0722RL | Mouser | 603-AC0402JR-0722RL | - | - | - | - | YAG | RC0402JR-0722RL | Comet | R0402 22R 5% YAG |  | 35127 | 7S05900058 | 25 | -
 | R26 | R0402-5% 10K | Chip Resistor 5% 0402 10k | SMT | 10k | PANASONIC | ERJ2GEJ103X | Farnell | 2059239 | Yageo | RC0402JR-0710KL | Digikey | 311-10KJRCT-ND | Yageo | RC0402JR-0710KL | Mouser | 603-RC0402JR-0710KL | Yageo | RC0402JR-1310KL | Mouser | 603-RC0402JR-1310KL | WAL/ASJ | - | Comet | R0402 10K 5% WAL/ASJ |  | 36134 | 7S05900122 | 25 | -
 | R27 | R0402-5% 22R | Chip Resistor 5% 0402 22R | SMT | 22R | MULTICOMP | MCMR04X220 JTL | Farnell | 2072778 | Panasonic - ECG | ERJ-2GEJ220X | Digikey | P22JCT-ND | Yageo | AC0402JR-0722RL | Mouser | 603-AC0402JR-0722RL | - | - | - | - | YAG | RC0402JR-0722RL | Comet | R0402 22R 5% YAG |  | 35127 | 7S05900058 | 25 | -
 | R28 | R0402-5% 22R | Chip Resistor 5% 0402 22R | SMT | 22R | MULTICOMP | MCMR04X220 JTL | Farnell | 2072778 | Panasonic - ECG | ERJ-2GEJ220X | Digikey | P22JCT-ND | Yageo | AC0402JR-0722RL | Mouser | 603-AC0402JR-0722RL | - | - | - | - | YAG | RC0402JR-0722RL | Comet | R0402 22R 5% YAG |  | 35127 | 7S05900058 | 25 | -
NA | R29 | R0603-5% 1k | Chip Resistor 5% 0603 1k | SMT | 1k | YAGEO | RC0603JR-071KL | Farnell | 9233385 | Yageo | RC0603JR-071KL | DIgiKey | 311-1.0KGRCT-ND | Yageo | RC0603JR-071KL | Mouser | 603-RC0603JR-071KL | - | - | - | - | - | - | - | - | NA | 3458 | 7S06200097 | 13 | -
NA | R30 | R0603-5% 1k | Chip Resistor 5% 0603 1k | SMT | 1k | YAGEO | RC0603JR-071KL | Farnell | 9233385 | Yageo | RC0603JR-071KL | DIgiKey | 311-1.0KGRCT-ND | Yageo | RC0603JR-071KL | Mouser | 603-RC0603JR-071KL | - | - | - | - | - | - | - | - | NA | 3458 | 7S06200097 | 13 | -
 | R31 | R0402-5% 10K | Chip Resistor 5% 0402 10k | SMT | 10k | PANASONIC | ERJ2GEJ103X | Farnell | 2059239 | Yageo | RC0402JR-0710KL | Digikey | 311-10KJRCT-ND | Yageo | RC0402JR-0710KL | Mouser | 603-RC0402JR-0710KL | Yageo | RC0402JR-1310KL | Mouser | 603-RC0402JR-1310KL | WAL/ASJ | - | Comet | R0402 10K 5% WAL/ASJ |  | 36134 | 7S05900122 | 25 | -
 | R32 | R0402-5% 10K | Chip Resistor 5% 0402 10k | SMT | 10k | PANASONIC | ERJ2GEJ103X | Farnell | 2059239 | Yageo | RC0402JR-0710KL | Digikey | 311-10KJRCT-ND | Yageo | RC0402JR-0710KL | Mouser | 603-RC0402JR-0710KL | Yageo | RC0402JR-1310KL | Mouser | 603-RC0402JR-1310KL | WAL/ASJ | - | Comet | R0402 10K 5% WAL/ASJ |  | 36134 | 7S05900122 | 25 | -
 | R33 | R0402-5% 10K | Chip Resistor 5% 0402 10k | SMT | 10k | PANASONIC | ERJ2GEJ103X | Farnell | 2059239 | Yageo | RC0402JR-0710KL | Digikey | 311-10KJRCT-ND | Yageo | RC0402JR-0710KL | Mouser | 603-RC0402JR-0710KL | Yageo | RC0402JR-1310KL | Mouser | 603-RC0402JR-1310KL | WAL/ASJ | - | Comet | R0402 10K 5% WAL/ASJ |  | 36134 | 7S05900122 | 25 | -
 | R34 | R0402-5% 10K | Chip Resistor 5% 0402 10k | SMT | 10k | PANASONIC | ERJ2GEJ103X | Farnell | 2059239 | Yageo | RC0402JR-0710KL | Digikey | 311-10KJRCT-ND | Yageo | RC0402JR-0710KL | Mouser | 603-RC0402JR-0710KL | Yageo | RC0402JR-1310KL | Mouser | 603-RC0402JR-1310KL | WAL/ASJ | - | Comet | R0402 10K 5% WAL/ASJ |  | 36134 | 7S05900122 | 25 | -
 | R35 | R0402-5% 10K | Chip Resistor 5% 0402 10k | SMT | 10k | PANASONIC | ERJ2GEJ103X | Farnell | 2059239 | Yageo | RC0402JR-0710KL | Digikey | 311-10KJRCT-ND | Yageo | RC0402JR-0710KL | Mouser | 603-RC0402JR-0710KL | Yageo | RC0402JR-1310KL | Mouser | 603-RC0402JR-1310KL | WAL/ASJ | - | Comet | R0402 10K 5% WAL/ASJ |  | 36134 | 7S05900122 | 25 | -
 | R36 | R0402-5% 10K | Chip Resistor 5% 0402 10k | SMT | 10k | PANASONIC | ERJ2GEJ103X | Farnell | 2059239 | Yageo | RC0402JR-0710KL | Digikey | 311-10KJRCT-ND | Yageo | RC0402JR-0710KL | Mouser | 603-RC0402JR-0710KL | Yageo | RC0402JR-1310KL | Mouser | 603-RC0402JR-1310KL | WAL/ASJ | - | Comet | R0402 10K 5% WAL/ASJ |  | 36134 | 7S05900122 | 25 | -
 | R37 | R0402-5% 10K | Chip Resistor 5% 0402 10k | SMT | 10k | PANASONIC | ERJ2GEJ103X | Farnell | 2059239 | Yageo | RC0402JR-0710KL | Digikey | 311-10KJRCT-ND | Yageo | RC0402JR-0710KL | Mouser | 603-RC0402JR-0710KL | Yageo | RC0402JR-1310KL | Mouser | 603-RC0402JR-1310KL | WAL/ASJ | - | Comet | R0402 10K 5% WAL/ASJ |  | 36134 | 7S05900122 | 25 | -
 | R38 | R0402-5% 10K | Chip Resistor 5% 0402 10k | SMT | 10k | PANASONIC | ERJ2GEJ103X | Farnell | 2059239 | Yageo | RC0402JR-0710KL | Digikey | 311-10KJRCT-ND | Yageo | RC0402JR-0710KL | Mouser | 603-RC0402JR-0710KL | Yageo | RC0402JR-1310KL | Mouser | 603-RC0402JR-1310KL | WAL/ASJ | - | Comet | R0402 10K 5% WAL/ASJ |  | 36134 | 7S05900122 | 25 | -
 | R39 | R0402-5% 10K | Chip Resistor 5% 0402 10k | SMT | 10k | PANASONIC | ERJ2GEJ103X | Farnell | 2059239 | Yageo | RC0402JR-0710KL | Digikey | 311-10KJRCT-ND | Yageo | RC0402JR-0710KL | Mouser | 603-RC0402JR-0710KL | Yageo | RC0402JR-1310KL | Mouser | 603-RC0402JR-1310KL | WAL/ASJ | - | Comet | R0402 10K 5% WAL/ASJ |  | 36134 | 7S05900122 | 25 | -
 | R40 | R0402-5% 10K | Chip Resistor 5% 0402 10k | SMT | 10k | PANASONIC | ERJ2GEJ103X | Farnell | 2059239 | Yageo | RC0402JR-0710KL | Digikey | 311-10KJRCT-ND | Yageo | RC0402JR-0710KL | Mouser | 603-RC0402JR-0710KL | Yageo | RC0402JR-1310KL | Mouser | 603-RC0402JR-1310KL | WAL/ASJ | - | Comet | R0402 10K 5% WAL/ASJ |  | 36134 | 7S05900122 | 25 | -
 | R41 | R0402-5% 22R | Chip Resistor 5% 0402 22R | SMT | 22R | MULTICOMP | MCMR04X220 JTL | Farnell | 2072778 | Panasonic - ECG | ERJ-2GEJ220X | Digikey | P22JCT-ND | Yageo | AC0402JR-0722RL | Mouser | 603-AC0402JR-0722RL | - | - | - | - | YAG | RC0402JR-0722RL | Comet | R0402 22R 5% YAG |  | 35127 | 7S05900058 | 25 | -
 | R42 | R0402-5% 22R | Chip Resistor 5% 0402 22R | SMT | 22R | MULTICOMP | MCMR04X220 JTL | Farnell | 2072778 | Panasonic - ECG | ERJ-2GEJ220X | Digikey | P22JCT-ND | Yageo | AC0402JR-0722RL | Mouser | 603-AC0402JR-0722RL | - | - | - | - | YAG | RC0402JR-0722RL | Comet | R0402 22R 5% YAG |  | 35127 | 7S05900058 | 25 | -
 | R43 | R0402-5% 10K | Chip Resistor 5% 0402 10k | SMT | 10k | PANASONIC | ERJ2GEJ103X | Farnell | 2059239 | Yageo | RC0402JR-0710KL | Digikey | 311-10KJRCT-ND | Yageo | RC0402JR-0710KL | Mouser | 603-RC0402JR-0710KL | Yageo | RC0402JR-1310KL | Mouser | 603-RC0402JR-1310KL | WAL/ASJ | - | Comet | R0402 10K 5% WAL/ASJ |  | 36134 | 7S05900122 | 25 | -
 | R44 | R0402-5% 22R | Chip Resistor 5% 0402 22R | SMT | 22R | MULTICOMP | MCMR04X220 JTL | Farnell | 2072778 | Panasonic - ECG | ERJ-2GEJ220X | Digikey | P22JCT-ND | Yageo | AC0402JR-0722RL | Mouser | 603-AC0402JR-0722RL | - | - | - | - | YAG | RC0402JR-0722RL | Comet | R0402 22R 5% YAG |  | 35127 | 7S05900058 | 25 | -
 | R45 | R0402-5% 470R | Chip Resistor 5% 0402 470R | SMT | 470R | YAGEO | RC0402JR-07470RL | Farnell | 9232729 | YAGEO | RC0402JR-07470RL | Digikey | RC0402JR-07470RL | YAGEO | RC0402JR-13470RL | Mouser | 603-RC0402JR-13470RL | - | - | - | - | - | - | - | - |  | - | 7S05900090 | 25 | -
 | R46 | R0402-5% 470R | Chip Resistor 5% 0402 470R | SMT | 470R | YAGEO | RC0402JR-07470RL | Farnell | 9232729 | YAGEO | RC0402JR-07470RL | Digikey | RC0402JR-07470RL | YAGEO | RC0402JR-13470RL | Mouser | 603-RC0402JR-13470RL | - | - | - | - | - | - | - | - |  | - | 7S05900090 | 25 | -
 | R47 | R0402-5% 470R | Chip Resistor 5% 0402 470R | SMT | 470R | YAGEO | RC0402JR-07470RL | Farnell | 9232729 | YAGEO | RC0402JR-07470RL | Digikey | RC0402JR-07470RL | YAGEO | RC0402JR-13470RL | Mouser | 603-RC0402JR-13470RL | - | - | - | - | - | - | - | - |  | - | 7S05900090 | 25 | -
 | R48 | R0402-5% 470R | Chip Resistor 5% 0402 470R | SMT | 470R | YAGEO | RC0402JR-07470RL | Farnell | 9232729 | YAGEO | RC0402JR-07470RL | Digikey | RC0402JR-07470RL | YAGEO | RC0402JR-13470RL | Mouser | 603-RC0402JR-13470RL | - | - | - | - | - | - | - | - |  | - | 7S05900090 | 25 | -
 | R49 | R0402-5% 470R | Chip Resistor 5% 0402 470R | SMT | 470R | YAGEO | RC0402JR-07470RL | Farnell | 9232729 | YAGEO | RC0402JR-07470RL | Digikey | RC0402JR-07470RL | YAGEO | RC0402JR-13470RL | Mouser | 603-RC0402JR-13470RL | - | - | - | - | - | - | - | - |  | - | 7S05900090 | 25 | -
 | R50 | R0402-5% 470R | Chip Resistor 5% 0402 470R | SMT | 470R | YAGEO | RC0402JR-07470RL | Farnell | 9232729 | YAGEO | RC0402JR-07470RL | Digikey | RC0402JR-07470RL | YAGEO | RC0402JR-13470RL | Mouser | 603-RC0402JR-13470RL | - | - | - | - | - | - | - | - |  | - | 7S05900090 | 25 | -
 | R51 | R0402-5% 470R | Chip Resistor 5% 0402 470R | SMT | 470R | YAGEO | RC0402JR-07470RL | Farnell | 9232729 | YAGEO | RC0402JR-07470RL | Digikey | RC0402JR-07470RL | YAGEO | RC0402JR-13470RL | Mouser | 603-RC0402JR-13470RL | - | - | - | - | - | - | - | - |  | - | 7S05900090 | 25 | -
 | R52 | R0402-5% 470R | Chip Resistor 5% 0402 470R | SMT | 470R | YAGEO | RC0402JR-07470RL | Farnell | 9232729 | YAGEO | RC0402JR-07470RL | Digikey | RC0402JR-07470RL | YAGEO | RC0402JR-13470RL | Mouser | 603-RC0402JR-13470RL | - | - | - | - | - | - | - | - |  | - | 7S05900090 | 25 | -
 | R53 | R0402-5% 22R | Chip Resistor 5% 0402 22R | SMT | 22R | MULTICOMP | MCMR04X220 JTL | Farnell | 2072778 | Panasonic - ECG | ERJ-2GEJ220X | Digikey | P22JCT-ND | Yageo | AC0402JR-0722RL | Mouser | 603-AC0402JR-0722RL | - | - | - | - | YAG | RC0402JR-0722RL | Comet | R0402 22R 5% YAG |  | 35127 | 7S05900058 | 25 | -
 | R54 | R0402-5% 22R | Chip Resistor 5% 0402 22R | SMT | 22R | MULTICOMP | MCMR04X220 JTL | Farnell | 2072778 | Panasonic - ECG | ERJ-2GEJ220X | Digikey | P22JCT-ND | Yageo | AC0402JR-0722RL | Mouser | 603-AC0402JR-0722RL | - | - | - | - | YAG | RC0402JR-0722RL | Comet | R0402 22R 5% YAG |  | 35127 | 7S05900058 | 25 | -
 | R55 | R0402-5% 22R | Chip Resistor 5% 0402 22R | SMT | 22R | MULTICOMP | MCMR04X220 JTL | Farnell | 2072778 | Panasonic - ECG | ERJ-2GEJ220X | Digikey | P22JCT-ND | Yageo | AC0402JR-0722RL | Mouser | 603-AC0402JR-0722RL | - | - | - | - | YAG | RC0402JR-0722RL | Comet | R0402 22R 5% YAG |  | 35127 | 7S05900058 | 25 | -
 | R56 | R0402-5% 22R | Chip Resistor 5% 0402 22R | SMT | 22R | MULTICOMP | MCMR04X220 JTL | Farnell | 2072778 | Panasonic - ECG | ERJ-2GEJ220X | Digikey | P22JCT-ND | Yageo | AC0402JR-0722RL | Mouser | 603-AC0402JR-0722RL | - | - | - | - | YAG | RC0402JR-0722RL | Comet | R0402 22R 5% YAG |  | 35127 | 7S05900058 | 25 | -
 | R57 | R0402-5% 47K | Chip Resistor 5% 0402 47k | SMT | 47k | MULTICOMP | MCMR04X473 JTL | Farnell | 2073070 | Panasonic | ERJ-2GEJ473X | Digikey | P47KJCT-ND | Yageo | AC0402JR-0747KL | Mouser | 603-AC0402JR-0747KL | - | - | - | - | - | - | - | - |  | 6958 | 7S05900138 | 25 | -
 | R58 | R0402-5% 22R | Chip Resistor 5% 0402 22R | SMT | 22R | MULTICOMP | MCMR04X220 JTL | Farnell | 2072778 | Panasonic - ECG | ERJ-2GEJ220X | Digikey | P22JCT-ND | Yageo | AC0402JR-0722RL | Mouser | 603-AC0402JR-0722RL | - | - | - | - | YAG | RC0402JR-0722RL | Comet | R0402 22R 5% YAG |  | 35127 | 7S05900058 | 25 | -
 | R59 | R0402-5% 10K | Chip Resistor 5% 0402 10k | SMT | 10k | PANASONIC | ERJ2GEJ103X | Farnell | 2059239 | Yageo | RC0402JR-0710KL | Digikey | 311-10KJRCT-ND | Yageo | RC0402JR-0710KL | Mouser | 603-RC0402JR-0710KL | Yageo | RC0402JR-1310KL | Mouser | 603-RC0402JR-1310KL | WAL/ASJ | - | Comet | R0402 10K 5% WAL/ASJ |  | 36134 | 7S05900122 | 25 | -
 | R60 | R0402-5% 10K | Chip Resistor 5% 0402 10k | SMT | 10k | PANASONIC | ERJ2GEJ103X | Farnell | 2059239 | Yageo | RC0402JR-0710KL | Digikey | 311-10KJRCT-ND | Yageo | RC0402JR-0710KL | Mouser | 603-RC0402JR-0710KL | Yageo | RC0402JR-1310KL | Mouser | 603-RC0402JR-1310KL | WAL/ASJ | - | Comet | R0402 10K 5% WAL/ASJ |  | 36134 | 7S05900122 | 25 | -
 | R61 | R0402-5% 10K | Chip Resistor 5% 0402 10k | SMT | 10k | PANASONIC | ERJ2GEJ103X | Farnell | 2059239 | Yageo | RC0402JR-0710KL | Digikey | 311-10KJRCT-ND | Yageo | RC0402JR-0710KL | Mouser | 603-RC0402JR-0710KL | Yageo | RC0402JR-1310KL | Mouser | 603-RC0402JR-1310KL | WAL/ASJ | - | Comet | R0402 10K 5% WAL/ASJ |  | 36134 | 7S05900122 | 25 | -
 | R62 | R0402-5% 10K | Chip Resistor 5% 0402 10k | SMT | 10k | PANASONIC | ERJ2GEJ103X | Farnell | 2059239 | Yageo | RC0402JR-0710KL | Digikey | 311-10KJRCT-ND | Yageo | RC0402JR-0710KL | Mouser | 603-RC0402JR-0710KL | Yageo | RC0402JR-1310KL | Mouser | 603-RC0402JR-1310KL | WAL/ASJ | - | Comet | R0402 10K 5% WAL/ASJ |  | 36134 | 7S05900122 | 25 | -
 | R63 | R0402-5% 10K | Chip Resistor 5% 0402 10k | SMT | 10k | PANASONIC | ERJ2GEJ103X | Farnell | 2059239 | Yageo | RC0402JR-0710KL | Digikey | 311-10KJRCT-ND | Yageo | RC0402JR-0710KL | Mouser | 603-RC0402JR-0710KL | Yageo | RC0402JR-1310KL | Mouser | 603-RC0402JR-1310KL | WAL/ASJ | - | Comet | R0402 10K 5% WAL/ASJ |  | 36134 | 7S05900122 | 25 | -
 | R64 | R0402-5% 10K | Chip Resistor 5% 0402 10k | SMT | 10k | PANASONIC | ERJ2GEJ103X | Farnell | 2059239 | Yageo | RC0402JR-0710KL | Digikey | 311-10KJRCT-ND | Yageo | RC0402JR-0710KL | Mouser | 603-RC0402JR-0710KL | Yageo | RC0402JR-1310KL | Mouser | 603-RC0402JR-1310KL | WAL/ASJ | - | Comet | R0402 10K 5% WAL/ASJ |  | 36134 | 7S05900122 | 25 | -
 | R65 | R0402-5% 10K | Chip Resistor 5% 0402 10k | SMT | 10k | PANASONIC | ERJ2GEJ103X | Farnell | 2059239 | Yageo | RC0402JR-0710KL | Digikey | 311-10KJRCT-ND | Yageo | RC0402JR-0710KL | Mouser | 603-RC0402JR-0710KL | Yageo | RC0402JR-1310KL | Mouser | 603-RC0402JR-1310KL | WAL/ASJ | - | Comet | R0402 10K 5% WAL/ASJ |  | 36134 | 7S05900122 | 25 | -
 | R66 | R0402-5% 10K | Chip Resistor 5% 0402 10k | SMT | 10k | PANASONIC | ERJ2GEJ103X | Farnell | 2059239 | Yageo | RC0402JR-0710KL | Digikey | 311-10KJRCT-ND | Yageo | RC0402JR-0710KL | Mouser | 603-RC0402JR-0710KL | Yageo | RC0402JR-1310KL | Mouser | 603-RC0402JR-1310KL | WAL/ASJ | - | Comet | R0402 10K 5% WAL/ASJ |  | 36134 | 7S05900122 | 25 | -
 | R67 | R0805-5% 47K | Chip Resistor 5% 0805 47k | SMT | 47k | MULTICOMP | MC 0.1W 0805 5% 47K | Farnell | 9334599 | Yageo | RC0805JR-0747KL | DigiKey | 311-47KARCT-ND | Bourns | CR0805-JW-473ELF | Mouser | 652-CR0805JW-473ELF | Uni ohm | 0805S8J0473T50 | Comet | R0805 47K 5% | - | - | - | - |  | - | 7S06500138 | 13 | -
 | R68 | R0402-5% 3K3 | RES 3.3K OHM 1/10W 5% 0402 SMD | SMT | 3k3 | MULTICOMP PRO | MCMR04X332 JTL | Farnell | 2072933 | Panasonic Electronic Components | ERJ-2GEJ332X | DigiKey | P3.3KJCT-ND | Yageo | RC0402JR-133K3L | Mouser | 603-RC0402JR-133K3L | - | - | - | - | YAG | RC0402JR-073K3L | Comet | R0402 3.3K 5% YAG |  | - | 7S05900110 | 25 | -
 | R69 | R0402-5% 1K | Chip Resistor 5% 0402 1k | SMT | 1k | Yageo | RC0402JR-071KL | Farnell | 9232761 | Yageo | RC0402JR-071KL | Digikey | 311-1.0KJRCT-ND | Yageo | RC0402JR-7D1KL | Mouser | 603-RC0402JR-7D1KL | Bourns | CR0402-JW-102GLF | Mouser | 652-CR0402JW-102GLF | - | - | - | - |  | 35385 | 7S05900098 | 25 | -
 | R70 | R0402-5% 1K | Chip Resistor 5% 0402 1k | SMT | 1k | Yageo | RC0402JR-071KL | Farnell | 9232761 | Yageo | RC0402JR-071KL | Digikey | 311-1.0KJRCT-ND | Yageo | RC0402JR-7D1KL | Mouser | 603-RC0402JR-7D1KL | Bourns | CR0402-JW-102GLF | Mouser | 652-CR0402JW-102GLF | - | - | - | - |  | 35385 | 7S05900098 | 25 | -
 | R71 | R0402-5% 10K | Chip Resistor 5% 0402 10k | SMT | 10k | PANASONIC | ERJ2GEJ103X | Farnell | 2059239 | Yageo | RC0402JR-0710KL | Digikey | 311-10KJRCT-ND | Yageo | RC0402JR-0710KL | Mouser | 603-RC0402JR-0710KL | Yageo | RC0402JR-1310KL | Mouser | 603-RC0402JR-1310KL | WAL/ASJ | - | Comet | R0402 10K 5% WAL/ASJ |  | 36134 | 7S05900122 | 25 | -
 | R72 | R0402-5% 10K | Chip Resistor 5% 0402 10k | SMT | 10k | PANASONIC | ERJ2GEJ103X | Farnell | 2059239 | Yageo | RC0402JR-0710KL | Digikey | 311-10KJRCT-ND | Yageo | RC0402JR-0710KL | Mouser | 603-RC0402JR-0710KL | Yageo | RC0402JR-1310KL | Mouser | 603-RC0402JR-1310KL | WAL/ASJ | - | Comet | R0402 10K 5% WAL/ASJ |  | 36134 | 7S05900122 | 25 | -
 | R73 | R0402-1% 28K | Chip Resistor 1% 0402 | SMT | 28k/1% | - | - | - | - | Panasonic | ERJ-2RKF2802X | Digikey | P28.0KLCT-ND | Panasonic | ERJ-2RKF2802X | Mouser | 667-ERJ-2RKF2802X | - | - | - | - | - | - | - | - |  | - | 7S06000525 | 25 | -
 | R74 | R0402-1% 8K45 | Chip Resistor 1% 0402 | SMT | 8k45/1% | - | - | - | - | YAGEO | RC0402FR-078K45L | Digikey | YAG3254CT-ND | Yageo | RC0402FR-078K45L | Mouser | 603-RC0402FR-078K45L | - | - | - | - | - | - | - | - |  | - | 7S06000475 | 25 | -
 | R75 | R0402-5% 20K | Chip Resistor 5% 0402 20k | SMT | 20k | Multicomp | MCMR04X203 JTL | Farnell | 2072757 | Panasonic | ERJ-2GEJ203X | Digikey | P20KJCT-ND | Yageo | RC0402JR-0720KL | Mouser | 603-RC0402JR-0720KL | - | - | - | - | - | - | - | - |  | - | 7S05900129 | 25 | -
 | R76 | R0402-5% 3K3 | RES 3.3K OHM 1/10W 5% 0402 SMD | SMT | 3k3 | MULTICOMP PRO | MCMR04X332 JTL | Farnell | 2072933 | Panasonic Electronic Components | ERJ-2GEJ332X | DigiKey | P3.3KJCT-ND | Yageo | RC0402JR-133K3L | Mouser | 603-RC0402JR-133K3L | - | - | - | - | YAG | RC0402JR-073K3L | Comet | R0402 3.3K 5% YAG |  | - | 7S05900110 | 25 | -
 | R77 | R0402-5% 10K | Chip Resistor 5% 0402 10k | SMT | 10k | PANASONIC | ERJ2GEJ103X | Farnell | 2059239 | Yageo | RC0402JR-0710KL | Digikey | 311-10KJRCT-ND | Yageo | RC0402JR-0710KL | Mouser | 603-RC0402JR-0710KL | Yageo | RC0402JR-1310KL | Mouser | 603-RC0402JR-1310KL | WAL/ASJ | - | Comet | R0402 10K 5% WAL/ASJ |  | 36134 | 7S05900122 | 25 | -
 | R78 | R0402-5% 10K | Chip Resistor 5% 0402 10k | SMT | 10k | PANASONIC | ERJ2GEJ103X | Farnell | 2059239 | Yageo | RC0402JR-0710KL | Digikey | 311-10KJRCT-ND | Yageo | RC0402JR-0710KL | Mouser | 603-RC0402JR-0710KL | Yageo | RC0402JR-1310KL | Mouser | 603-RC0402JR-1310KL | WAL/ASJ | - | Comet | R0402 10K 5% WAL/ASJ |  | 36134 | 7S05900122 | 25 | -
NA | R79 | R0402-5% 1K | Chip Resistor 5% 0402 1k | SMT | 1k | Yageo | RC0402JR-071KL | Farnell | 9232761 | Yageo | RC0402JR-071KL | Digikey | 311-1.0KJRCT-ND | Yageo | RC0402JR-7D1KL | Mouser | 603-RC0402JR-7D1KL | Bourns | CR0402-JW-102GLF | Mouser | 652-CR0402JW-102GLF | - | - | - | - | NA | 35385 | 7S05900098 | 25 | -
 | R80 | R0402-5% 10K | Chip Resistor 5% 0402 10k | SMT | 10k | PANASONIC | ERJ2GEJ103X | Farnell | 2059239 | Yageo | RC0402JR-0710KL | Digikey | 311-10KJRCT-ND | Yageo | RC0402JR-0710KL | Mouser | 603-RC0402JR-0710KL | Yageo | RC0402JR-1310KL | Mouser | 603-RC0402JR-1310KL | WAL/ASJ | - | Comet | R0402 10K 5% WAL/ASJ |  | 36134 | 7S05900122 | 25 | -
 | R81 | R0402-5% 10K | Chip Resistor 5% 0402 10k | SMT | 10k | PANASONIC | ERJ2GEJ103X | Farnell | 2059239 | Yageo | RC0402JR-0710KL | Digikey | 311-10KJRCT-ND | Yageo | RC0402JR-0710KL | Mouser | 603-RC0402JR-0710KL | Yageo | RC0402JR-1310KL | Mouser | 603-RC0402JR-1310KL | WAL/ASJ | - | Comet | R0402 10K 5% WAL/ASJ |  | 36134 | 7S05900122 | 25 | -
 | R82 | R2512-1% 0R01 | Chip Resistor 1% 2512 0R01 | SMT | 0R01/1%/2W | BOURNS | CRF2512-FX-R010ELF | Farnell | 2008328 | - | - | - | - | SUSUMU INTERNATIONAL | KRL6432-C-R010-F-T1 | Future | KRL6432-C-R010-F-T1 | - | - | - | - | - | - | - | - |  | - | 7S07600776 | 5 | -
 | R83 | R2512-1% 0R01 | Chip Resistor 1% 2512 0R01 | SMT | 0R01/1%/2W | BOURNS | CRF2512-FX-R010ELF | Farnell | 2008328 | - | - | - | - | SUSUMU INTERNATIONAL | KRL6432-C-R010-F-T1 | Future | KRL6432-C-R010-F-T1 | - | - | - | - | - | - | - | - |  | - | 7S07600776 | 5 | -
 | R84 | R0402-5% 3K3 | RES 3.3K OHM 1/10W 5% 0402 SMD | SMT | 3k3 | MULTICOMP PRO | MCMR04X332 JTL | Farnell | 2072933 | Panasonic Electronic Components | ERJ-2GEJ332X | DigiKey | P3.3KJCT-ND | Yageo | RC0402JR-133K3L | Mouser | 603-RC0402JR-133K3L | - | - | - | - | YAG | RC0402JR-073K3L | Comet | R0402 3.3K 5% YAG |  | - | 7S05900110 | 25 | -
 | R85 | R2512-1% 0R01 | Chip Resistor 1% 2512 0R01 | SMT | 0R01/1%/2W | BOURNS | CRF2512-FX-R010ELF | Farnell | 2008328 | - | - | - | - | SUSUMU INTERNATIONAL | KRL6432-C-R010-F-T1 | Future | KRL6432-C-R010-F-T1 | - | - | - | - | - | - | - | - |  | - | 7S07600776 | 5 | -
 | R86 | R2512-1% 0R01 | Chip Resistor 1% 2512 0R01 | SMT | 0R01/1%/2W | BOURNS | CRF2512-FX-R010ELF | Farnell | 2008328 | - | - | - | - | SUSUMU INTERNATIONAL | KRL6432-C-R010-F-T1 | Future | KRL6432-C-R010-F-T1 | - | - | - | - | - | - | - | - |  | - | 7S07600776 | 5 | -
 | R87 | R2512-1% 0R01 | Chip Resistor 1% 2512 0R01 | SMT | 0R01/1%/2W | BOURNS | CRF2512-FX-R010ELF | Farnell | 2008328 | - | - | - | - | SUSUMU INTERNATIONAL | KRL6432-C-R010-F-T1 | Future | KRL6432-C-R010-F-T1 | - | - | - | - | - | - | - | - |  | - | 7S07600776 | 5 | -
 | R88 | R0402-5% 3K3 | RES 3.3K OHM 1/10W 5% 0402 SMD | SMT | 3k3 | MULTICOMP PRO | MCMR04X332 JTL | Farnell | 2072933 | Panasonic Electronic Components | ERJ-2GEJ332X | DigiKey | P3.3KJCT-ND | Yageo | RC0402JR-133K3L | Mouser | 603-RC0402JR-133K3L | - | - | - | - | YAG | RC0402JR-073K3L | Comet | R0402 3.3K 5% YAG |  | - | 7S05900110 | 25 | -
 | R89 | R2512-1% 0R01 | Chip Resistor 1% 2512 0R01 | SMT | 0R01/1%/2W | BOURNS | CRF2512-FX-R010ELF | Farnell | 2008328 | - | - | - | - | SUSUMU INTERNATIONAL | KRL6432-C-R010-F-T1 | Future | KRL6432-C-R010-F-T1 | - | - | - | - | - | - | - | - |  | - | 7S07600776 | 5 | -
 | R90 | R0603-5% 100R | Chip Resistor 5% 0603 100R | SMT | 100R | BOURNS | CR0603-JW-101ELF | Farnell | 2333587 | Yageo | RC0603FR-07100RL | Digikey | 311-100HRCT-ND | YAGEO | RC0603JR-07100RL | Mouser | 603-RC0603JR-07100RL | UNI OHM | 0603SAJ0101T50 | Comet | R0603 100R 5% | - | - | - | - |  | 3448 | 7S06200073 | 13 | -
 | R91 | R0402-5% 10K | Chip Resistor 5% 0402 10k | SMT | 10k | PANASONIC | ERJ2GEJ103X | Farnell | 2059239 | Yageo | RC0402JR-0710KL | Digikey | 311-10KJRCT-ND | Yageo | RC0402JR-0710KL | Mouser | 603-RC0402JR-0710KL | Yageo | RC0402JR-1310KL | Mouser | 603-RC0402JR-1310KL | WAL/ASJ | - | Comet | R0402 10K 5% WAL/ASJ |  | 36134 | 7S05900122 | 25 | -
 | R92 | R0603-5% 100R | Chip Resistor 5% 0603 100R | SMT | 100R | BOURNS | CR0603-JW-101ELF | Farnell | 2333587 | Yageo | RC0603FR-07100RL | Digikey | 311-100HRCT-ND | YAGEO | RC0603JR-07100RL | Mouser | 603-RC0603JR-07100RL | UNI OHM | 0603SAJ0101T50 | Comet | R0603 100R 5% | - | - | - | - |  | 3448 | 7S06200073 | 13 | -
 | R93 | R0402-5% 10K | Chip Resistor 5% 0402 10k | SMT | 10k | PANASONIC | ERJ2GEJ103X | Farnell | 2059239 | Yageo | RC0402JR-0710KL | Digikey | 311-10KJRCT-ND | Yageo | RC0402JR-0710KL | Mouser | 603-RC0402JR-0710KL | Yageo | RC0402JR-1310KL | Mouser | 603-RC0402JR-1310KL | WAL/ASJ | - | Comet | R0402 10K 5% WAL/ASJ |  | 36134 | 7S05900122 | 25 | -
 | R94 | R0402-5% 2K2 | Chip Resistor 5% 0402 2K2 | SMT | 2k2 | Yageo | RC0402JR-072K2L | Farnell | 9232800 | Yageo | RC0402JR-072K2L | Digikey | 311-2.2KJRCT-ND | Yageo | RC0402JR-072K2L | Mouser | 603-RC0402JR-072K2L | - | - | - | - | - | - | - | - |  | 36543 | 7S05900106 | 25 | -
 | R95 | R0402-5% 2K2 | Chip Resistor 5% 0402 2K2 | SMT | 2k2 | Yageo | RC0402JR-072K2L | Farnell | 9232800 | Yageo | RC0402JR-072K2L | Digikey | 311-2.2KJRCT-ND | Yageo | RC0402JR-072K2L | Mouser | 603-RC0402JR-072K2L | - | - | - | - | - | - | - | - |  | 36543 | 7S05900106 | 25 | -
 | R96 | R0603-5% 100R | Chip Resistor 5% 0603 100R | SMT | 100R | BOURNS | CR0603-JW-101ELF | Farnell | 2333587 | Yageo | RC0603FR-07100RL | Digikey | 311-100HRCT-ND | YAGEO | RC0603JR-07100RL | Mouser | 603-RC0603JR-07100RL | UNI OHM | 0603SAJ0101T50 | Comet | R0603 100R 5% | - | - | - | - |  | 3448 | 7S06200073 | 13 | -
 | R97 | R0402-5% 10K | Chip Resistor 5% 0402 10k | SMT | 10k | PANASONIC | ERJ2GEJ103X | Farnell | 2059239 | Yageo | RC0402JR-0710KL | Digikey | 311-10KJRCT-ND | Yageo | RC0402JR-0710KL | Mouser | 603-RC0402JR-0710KL | Yageo | RC0402JR-1310KL | Mouser | 603-RC0402JR-1310KL | WAL/ASJ | - | Comet | R0402 10K 5% WAL/ASJ |  | 36134 | 7S05900122 | 25 | -
 | R98 | R0603-5% 100R | Chip Resistor 5% 0603 100R | SMT | 100R | BOURNS | CR0603-JW-101ELF | Farnell | 2333587 | Yageo | RC0603FR-07100RL | Digikey | 311-100HRCT-ND | YAGEO | RC0603JR-07100RL | Mouser | 603-RC0603JR-07100RL | UNI OHM | 0603SAJ0101T50 | Comet | R0603 100R 5% | - | - | - | - |  | 3448 | 7S06200073 | 13 | -
 | R99 | R0402-5% 10K | Chip Resistor 5% 0402 10k | SMT | 10k | PANASONIC | ERJ2GEJ103X | Farnell | 2059239 | Yageo | RC0402JR-0710KL | Digikey | 311-10KJRCT-ND | Yageo | RC0402JR-0710KL | Mouser | 603-RC0402JR-0710KL | Yageo | RC0402JR-1310KL | Mouser | 603-RC0402JR-1310KL | WAL/ASJ | - | Comet | R0402 10K 5% WAL/ASJ |  | 36134 | 7S05900122 | 25 | -
 | R100 | R1206-5% 10R | Chip Resistor 5% 1206 10R | SMT | 10R | PHYCOMP | 232271161109 | Farnell | 9240284 | Stackpole Electronics Inc | RMCF1206JT10R0 | Digikey | RMCF1206JT10R0CT-ND | Vishay / Draloric | RCG120610R0JNEA | Mouser | 71-RCG120610R0JNEA | YAGEO | 30PRC1206JR-0710R | Comet | R1206 10R 5% YAG/ASJ | - | - | - | - |  | - | 7S06700050 | 13 | -
 | R101 | R1206-5% 10R | Chip Resistor 5% 1206 10R | SMT | 10R | PHYCOMP | 232271161109 | Farnell | 9240284 | Stackpole Electronics Inc | RMCF1206JT10R0 | Digikey | RMCF1206JT10R0CT-ND | Vishay / Draloric | RCG120610R0JNEA | Mouser | 71-RCG120610R0JNEA | YAGEO | 30PRC1206JR-0710R | Comet | R1206 10R 5% YAG/ASJ | - | - | - | - |  | - | 7S06700050 | 13 | -
 | R102 | R1206-5% 10R | Chip Resistor 5% 1206 10R | SMT | 10R | PHYCOMP | 232271161109 | Farnell | 9240284 | Stackpole Electronics Inc | RMCF1206JT10R0 | Digikey | RMCF1206JT10R0CT-ND | Vishay / Draloric | RCG120610R0JNEA | Mouser | 71-RCG120610R0JNEA | YAGEO | 30PRC1206JR-0710R | Comet | R1206 10R 5% YAG/ASJ | - | - | - | - |  | - | 7S06700050 | 13 | -
 | R103 | R1206-5% 10R | Chip Resistor 5% 1206 10R | SMT | 10R | PHYCOMP | 232271161109 | Farnell | 9240284 | Stackpole Electronics Inc | RMCF1206JT10R0 | Digikey | RMCF1206JT10R0CT-ND | Vishay / Draloric | RCG120610R0JNEA | Mouser | 71-RCG120610R0JNEA | YAGEO | 30PRC1206JR-0710R | Comet | R1206 10R 5% YAG/ASJ | - | - | - | - |  | - | 7S06700050 | 13 | -
 | RT1 | RTH_NTC_0603 10k | Chip Thermistor 10k 0603 | SMT | 10k | MURATA | NCU18XH103F60RB | Farnell | 2614207 | MURATA | NCP18XH103J03RB | Digikey | 490-2436-1-ND | Panasonic | ERT-J1VG103JA | Mouser | 667-ERT-J1VG103JA | - | - | - | - | - | - | - | - |  | - | 7S09100010 | 13 | -
 | RT2 | RTH_NTC_0603 10k | Chip Thermistor 10k 0603 | SMT | 10k | MURATA | NCU18XH103F60RB | Farnell | 2614207 | MURATA | NCP18XH103J03RB | Digikey | 490-2436-1-ND | Panasonic | ERT-J1VG103JA | Mouser | 667-ERT-J1VG103JA | - | - | - | - | - | - | - | - |  | - | 7S09100010 | 13 | -
 | TVS1 | SMBJ36A-13-F | TVS DIODE 36VWM 58.1VC SMB | SMT | SMBJ36A-13-F | - | - | - | - | Diodes Incorporated | SMBJ36A-13-F | Digikey | SMBJ36A-FDICT-ND | Diodes Incorporated | SMBJ36A-13-F | Mouser | 621-SMBJ36A-13-F | - | - | - | - | - | - | - | - |  | - | 7S03700174 | - | -
 | U1 | DS8921M/NOPB | IC TRANSCEIVER FULL 1/1 8SOIC | SMT | DS8921M/NOPB | Texas Instruments | DS8921M/NOPB | Farnell | 3121238 | Texas Instruments | DS8921M/NOPB | Digikey | DS8921M/NOPB-ND | Texas Instruments | DS8921M/NOPB | Mouser | 926-DS8921M/NOPB | - | - | - | - | - | - | - | - |  | - | 7S04400209 | - | -
 | U2 | TVS Diode Array 82400152 | TVS Diode Array WE-TVS SOT563 | SMT | TVS Diode Array 82400152 | WURTH ELEKTRONIK | 82400152 | Farnell | 1825874 | WURTH ELEKTRONIK | 82400152 | Digikey | 732-4474-1-ND | WURTH ELEKTRONIK | 82400152 | Mouser | 710-82400152 | - | - | - | - | - | - | - | - |  | - | 7S03700038 |  | -
 | U3 | TVS Diode Array 82400152 | TVS Diode Array WE-TVS SOT563 | SMT | TVS Diode Array 82400152 | WURTH ELEKTRONIK | 82400152 | Farnell | 1825874 | WURTH ELEKTRONIK | 82400152 | Digikey | 732-4474-1-ND | WURTH ELEKTRONIK | 82400152 | Mouser | 710-82400152 | - | - | - | - | - | - | - | - |  | - | 7S03700038 |  | -
 | U4 | TLP292 | OPTOISOLATOR 3.75KV TRANS 4-SO | SMT | TLP292(TPL.E | - | - | - | - | Toshiba | TLP292(TPL.E | Digikey | TLP292(TPLECT-ND | Toshiba | TLP292(TPL.E | Mouser | 757-TLP292(TPLE | - | - | - | - | - | - | - | - |  | - | 7S05400056 | 7 | -
 | U5 | TLP292 | OPTOISOLATOR 3.75KV TRANS 4-SO | SMT | TLP292(TPL.E | - | - | - | - | Toshiba | TLP292(TPL.E | Digikey | TLP292(TPLECT-ND | Toshiba | TLP292(TPL.E | Mouser | 757-TLP292(TPLE | - | - | - | - | - | - | - | - |  | - | 7S05400056 | 7 | -
 | U6 | TLP292 | OPTOISOLATOR 3.75KV TRANS 4-SO | SMT | TLP292(TPL.E | - | - | - | - | Toshiba | TLP292(TPL.E | Digikey | TLP292(TPLECT-ND | Toshiba | TLP292(TPL.E | Mouser | 757-TLP292(TPLE | - | - | - | - | - | - | - | - |  | - | 7S05400056 | 7 | -
 | U7 | TLP292 | OPTOISOLATOR 3.75KV TRANS 4-SO | SMT | TLP292(TPL.E | - | - | - | - | Toshiba | TLP292(TPL.E | Digikey | TLP292(TPLECT-ND | Toshiba | TLP292(TPL.E | Mouser | 757-TLP292(TPLE | - | - | - | - | - | - | - | - |  | - | 7S05400056 | 7 | -
 | U8 | TLP292 | OPTOISOLATOR 3.75KV TRANS 4-SO | SMT | TLP292(TPL.E | - | - | - | - | Toshiba | TLP292(TPL.E | Digikey | TLP292(TPLECT-ND | Toshiba | TLP292(TPL.E | Mouser | 757-TLP292(TPLE | - | - | - | - | - | - | - | - |  | - | 7S05400056 | 7 | -
 | U9 | TLP292 | OPTOISOLATOR 3.75KV TRANS 4-SO | SMT | TLP292(TPL.E | - | - | - | - | Toshiba | TLP292(TPL.E | Digikey | TLP292(TPLECT-ND | Toshiba | TLP292(TPL.E | Mouser | 757-TLP292(TPLE | - | - | - | - | - | - | - | - |  | - | 7S05400056 | 7 | -
 | U10 | TLP292 | OPTOISOLATOR 3.75KV TRANS 4-SO | SMT | TLP292(TPL.E | - | - | - | - | Toshiba | TLP292(TPL.E | Digikey | TLP292(TPLECT-ND | Toshiba | TLP292(TPL.E | Mouser | 757-TLP292(TPLE | - | - | - | - | - | - | - | - |  | - | 7S05400056 | 7 | -
 | U11 | TLP292 | OPTOISOLATOR 3.75KV TRANS 4-SO | SMT | TLP292(TPL.E | - | - | - | - | Toshiba | TLP292(TPL.E | Digikey | TLP292(TPLECT-ND | Toshiba | TLP292(TPL.E | Mouser | 757-TLP292(TPLE | - | - | - | - | - | - | - | - |  | - | 7S05400056 | 7 | -
 | U12 | MAX3221CPWR | MAX3221CPWR | SMT | MAX3221CPWR | - | - | - | - | Texas Instruments | MAX3221CPWR | Digikey | 296-9594-1-ND | Texas Instruments | MAX3221CPWR | Mouser | 595-MAX3221CPWR | - | - | - | - | - | - | - | - |  | - | 7S04400210 | - | -
 | U13 | STM32F745VGT6 | ARM® Cortex®-M7 STM32F7 Microcontroller IC 32-Bit 216MHz 1MB (1M x 8) FLASH 100-LQFP (14x14) | SMT | STM32F745VGT6 | STMICROELECTRONICS | STM32F745VGT6 | Farnell | 2503282 | STMICROELECTRONICS | STM32F745VGT6 | Digikey | 497-16097-ND | STMICROELECTRONICS | STM32F745VGT6 | Mouser | 511-STM32F745VGT6 | - | - | - | - | - | - | - | - |  | - | 7S05000208 | 0 | -
 | U14 | TLP170AM | SSR RELAY SPST-NO 700MA 0-60V | SMT | TLP170AM | - | - | - | - | Toshiba | TLP170AM | Digikey | 264-TLP170AM(TPLECT-ND | Toshiba | TLP170AM | Mouser | 757-TLP170AM(TPL,E | - | - | - | - | - | - | - | - |  | - | 7S05400060 |  | -
 | U15 | TLP170AM | SSR RELAY SPST-NO 700MA 0-60V | SMT | TLP170AM | - | - | - | - | Toshiba | TLP170AM | Digikey | 264-TLP170AM(TPLECT-ND | Toshiba | TLP170AM | Mouser | 757-TLP170AM(TPL,E | - | - | - | - | - | - | - | - |  | - | 7S05400060 |  | -
 | U16 | TLP170AM | SSR RELAY SPST-NO 700MA 0-60V | SMT | TLP170AM | - | - | - | - | Toshiba | TLP170AM | Digikey | 264-TLP170AM(TPLECT-ND | Toshiba | TLP170AM | Mouser | 757-TLP170AM(TPL,E | - | - | - | - | - | - | - | - |  | - | 7S05400060 |  | -
 | U17 | TLP170AM | SSR RELAY SPST-NO 700MA 0-60V | SMT | TLP170AM | - | - | - | - | Toshiba | TLP170AM | Digikey | 264-TLP170AM(TPLECT-ND | Toshiba | TLP170AM | Mouser | 757-TLP170AM(TPL,E | - | - | - | - | - | - | - | - |  | - | 7S05400060 |  | -
 | U18 | TLP170AM | SSR RELAY SPST-NO 700MA 0-60V | SMT | TLP170AM | - | - | - | - | Toshiba | TLP170AM | Digikey | 264-TLP170AM(TPLECT-ND | Toshiba | TLP170AM | Mouser | 757-TLP170AM(TPL,E | - | - | - | - | - | - | - | - |  | - | 7S05400060 |  | -
 | U19 | TLP170AM | SSR RELAY SPST-NO 700MA 0-60V | SMT | TLP170AM | - | - | - | - | Toshiba | TLP170AM | Digikey | 264-TLP170AM(TPLECT-ND | Toshiba | TLP170AM | Mouser | 757-TLP170AM(TPL,E | - | - | - | - | - | - | - | - |  | - | 7S05400060 |  | -
 | U20 | TLP170AM | SSR RELAY SPST-NO 700MA 0-60V | SMT | TLP170AM | - | - | - | - | Toshiba | TLP170AM | Digikey | 264-TLP170AM(TPLECT-ND | Toshiba | TLP170AM | Mouser | 757-TLP170AM(TPL,E | - | - | - | - | - | - | - | - |  | - | 7S05400060 |  | -
 | U21 | TLP170AM | SSR RELAY SPST-NO 700MA 0-60V | SMT | TLP170AM | - | - | - | - | Toshiba | TLP170AM | Digikey | 264-TLP170AM(TPLECT-ND | Toshiba | TLP170AM | Mouser | 757-TLP170AM(TPL,E | - | - | - | - | - | - | - | - |  | - | 7S05400060 |  | -
 | U22 | SN65HVD75DRB | TXRX 3.3V RS-485 ESD 8SON | SMT | SN65HVD75DRB | TEXAS INSTRUMENTS | SN65HVD75DRB | Farnell | 2496640 | TEXAS INSTRUMENTS | SN65HVD75DRB | Digikey | 296-35710-1-ND | TEXAS INSTRUMENTS | SN65HVD75DRBR | Mouser | 595-SN65HVD75DRBR | - | - | - | - | - | - | - | - |  | - | 7S04400098 |  | -
 | U23 | DRV8323RSRGZ | IC MTR DRV MULTIPHAS 6-60V 48QFN | SMT | DRV8323RSRGZ | - | - | - | - | TEXAS INSTRUMENTS | DRV8323RSRGZ | Digikey | 296-47769-1-ND | TEXAS INSTRUMENTS | DRV8323RSRGZ | Mouser | 595-DRV8323RSRGZR | - | - | - | - | - | - | - | - |  | - | 7S02100398 | - | -
 | U24 | DRV8323RSRGZ | IC MTR DRV MULTIPHAS 6-60V 48QFN | SMT | DRV8323RSRGZ | - | - | - | - | TEXAS INSTRUMENTS | DRV8323RSRGZ | Digikey | 296-47769-1-ND | TEXAS INSTRUMENTS | DRV8323RSRGZ | Mouser | 595-DRV8323RSRGZR | - | - | - | - | - | - | - | - |  | - | 7S02100398 | - | -
 | U25 | SN65HVD75DRB | TXRX 3.3V RS-485 ESD 8SON | SMT | SN65HVD75DRB | TEXAS INSTRUMENTS | SN65HVD75DRB | Farnell | 2496640 | TEXAS INSTRUMENTS | SN65HVD75DRB | Digikey | 296-35710-1-ND | TEXAS INSTRUMENTS | SN65HVD75DRBR | Mouser | 595-SN65HVD75DRBR | - | - | - | - | - | - | - | - |  | - | 7S04400098 |  | -
 | Y1 | ABM8G-12.000MHZ-18-D2Y-T | XTAL 12.000MHZ 18PF SMD 3.2X2.5 | SMT | ABM8G-12.000MHZ-18-D2Y-T | ABRACON | ABM8G-12.000MHZ-18-D2Y-T | Farnell | 2308709 | ABRACON | ABM8G-12.000MHZ-18-D2Y-T | Digikey | 535-10261-1-ND | ABRACON | ABM8G-12.000MHZ-18-D2Y-T | Mouser | 815-ABM8G-12-18D2Y | - | - | - | - | - | - | - | - |  | - | 7S03100109 |  | -

Sheet: QTY BOM
 | Project: | Servo_DRV_Rev1 | QTY BOM |  | Variant: |  |  |  |  |  |  |  |  |  |  |  |  | Please order the bordered cells !!!
 | Date: | 45119
 | Part Name Library | Value | Description | Qty | Location | Type | SKU | Proto MOQ | Automotive | Maker | Maker Part Name | Provider | Provider Part Name | Available Quantity | Max Price | Maker2 | Maker2 Part Name | Provider2 | Provider2 Part Name | Available Quantity | Max Price | Maker3 | Maker3 Part Name | Provider3 | Provider3 Part Name | Available Quantity | Max Price | Maker4 | Maker4 Part Name | Provider4 | Provider4 Part Name | Available Quantity | Max Price | Maker5 | Maker5 Part Name | Provider5 | Provider5 Part Name | Available Quantity | Max Price
AMB | 691352710003 | 691352710003 | TERM BLOCK PLUG 3POS 5MM 300VAC 12A 3P Straight 24-12AWG | 2 | AMB89;AMB90; | SMT | 7S03000365 | - | - | WURTH ELEKTRONIK | 691352710003 | WURTH ELEKTRONIK | 691352710003 | NO API | NO API | WURTH ELEKTRONIK | 691352710003 | Digikey | 732-2776-ND | 1177 | 1.87 | WURTH ELEKTRONIK | 691352710003 | Mouser | 710-691352710003 | 7519 | 1.93 | - | - | - | - |  |  | - | - | - | -
AMB | 691352710004 | 691352710004 | TERM BLOCK PLUG 4POS 5MM 300VAC 12A 4P Straight 24-12AWG | 1 | AMB88; | SMT | 7S03000364 | - | - | WURTH ELEKTRONIK | 691352710004 | WURTH ELEKTRONIK | 691352710004 | NO API | NO API | WURTH ELEKTRONIK | 691352710004 | Digikey | 732-2777-ND | 669 | 2.41 | WURTH ELEKTRONIK | 691352710004 | Mouser | 710-691352710004 | 838 | 2.48 | - | - | - | - |  |  | - | - | - | -
AMB | AMB Spacer 5mm - 702917000 | AMB Spacer 5mm - 702917000 | SPACER BOARD SUPRT SCREW MNT NYLON h5mm Outer Diameter - 4mm Drill in Panel - 3mm | 2 | AMB91;AMB92; | SMT | 7S04800076 | - | - | WURTH ELECTRONIK | 702917000 | WURTH ELECTRONIK | 702917000 | NO API | NO API | WURTH ELECTRONIK | 702917000 | Digikey | 732-9626-ND | 3697 | 0.16 | WURTH ELECTRONIK | 702917000 | Mouser | 710-702917000 | 14037 | 0.16 | - | - | - | - |  |  | - | - | - | -
AMB | DF11-4DS-2C | DF11-4DS-2C | CONN RCPT HSG 4POS 2.00MM | 7 | AMB5;AMB6;AMB7;AMB8;AMB9;AMB11;AMB12; | SMT | 7S02400819 |  | - | - | - | - | - |  |  | Hirose Electric Co Ltd | DF11-4DS-2C | Digikey | H2019-ND | 123811 | 0.18 | Hirose Connector | DF11-4DS-2C | Mouser | 798-DF11-4DS-2C | 207435 | 0.15 | - | - | - | - |  |  | - | - | - | -
AMB | DF11-6DS-2C | DF11-6DS-2C | CONN RCPT HSG 6POS 2.00MM | 1 | AMB4; | SMT | 7S02400820 |  | - | - | - | - | - |  |  | Hirose Electric Co Ltd | DF11-6DS-2C | Digikey | H2021-ND | 25 | 0.19 | Hirose Connector | DF11-6DS-2C | Mouser | 798-DF11-6DS-2C | 26792 | 0.197 | - | - | - | - |  |  | - | - | - | -
AMB | DF11-10DS-2C | DF11-10DS-2C | CONN RCPT HSG 10POS 2.00MM | 4 | AMB2;AMB3;AMB10;AMB13; | SMT | 7S02400821 |  | - | - | - | - | - |  |  | Hirose Electric Co Ltd | DF11-10DS-2C | Digikey | H2023-ND | 5768 | 0.22 | Hirose Connector | DF11-10DS-2C | Mouser | 798-DF11-10DS-2C | 93865 | 0.226 | - | - | - | - |  |  | - | - | - | -
AMB | DF11-2428SCF | DF11-2428SCF | CONN SOCKET 24-28AWG CRIMP TIN | 74 | AMB14;AMB15;AMB16;AMB17;AMB18;AMB19;AMB20;AMB21;AMB22;AMB23;AMB24;AMB25;AMB26;AMB27;AMB28;AMB29;AMB30;AMB31;AMB32;AMB33;AMB34;AMB35;AMB36;AMB37;AMB38;AMB39;AMB40;AMB41;AMB42;AMB43;AMB44;AMB45;AMB46;AMB47;AMB48;AMB49;AMB50;AMB51;AMB52;AMB53;AMB54;AMB55;AMB56;AMB57;AMB58;AMB59;AMB60;AMB61;AMB62;AMB63;AMB64;AMB65;AMB66;AMB67;AMB68;AMB69;AMB70;AMB71;AMB72;AMB73;AMB74;AMB75;AMB76;AMB77;AMB78;AMB79;AMB80;AMB81;AMB82;AMB83;AMB84;AMB85;AMB86;AMB87; | SMT | 7S02400822 |  | - | - | - | - | - |  |  | Hirose Electric Co Ltd | DF11-2428SCF | Digikey | H1504CT-ND | 1127784 | 0.09 | Hirose Connector | DF11-2428SCF | Mouser | 798-DF11-2428SCF | 2482310 | 0.094 | - | - | - | - |  |  | - | - | - | -
AMB | SCHURTER 8020.0607 Fuse | SCHURTER 8020.0607 Fuse | Fuse Cartridge SUT Series 30A 250V 6.3mm x 32mm 500A | 1 | AMB1; | SMT | 7S03900054 |  | - | SCHURTER | 8020.0607 | Farnell | 1829564 | 227 | 1.39 | - | - | Digikey | 486-3832-ND | 892 | 1.96 | - | - | Mouser | 8020.0607.G | 1 380 | 1.03 | - | - | - | - |  |  | - | - | - | -
C | C0402-1n/50V/X7R | 1n/50V/X7R | CAP CER 1000PF 50V 10% X7R 0402 | 12 | C20;C23;C25;C26;C27;C30;C53;C54;C55;C61;C62;C63; | SMT | 7S00700004 | 25 | - | WURTH | '885012205061 | Farnell | 2495166 | 12240 | 0.0105 | Murata | GCM155R71H102KA37D | Digikey | 490-4761-1-ND | 10685538 | 0.09 | Murata | GCM155R71H102KA37D | Mouser | 81-GCM155R71H102KA7D | 646788 | 0.094 | - | - | - | - |  |  | - | - | - | -
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
