mstoilov/sigmadrone-esc/hardware/lib3d/PQFN_5x6_SGD.step

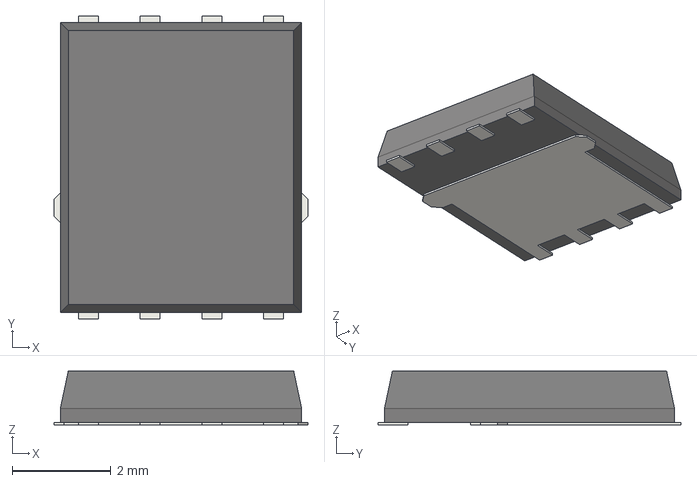
[picture p4: CAD file, 2020-09-22]
hardware/lib3d/PQFN_5x6_SGD.step
5.15 x 6.15 x 1.09 mm
