mstoilov/sigmadrone-esc/hardware/lib3d/L_Wuerth_WE-TPC-4828.step

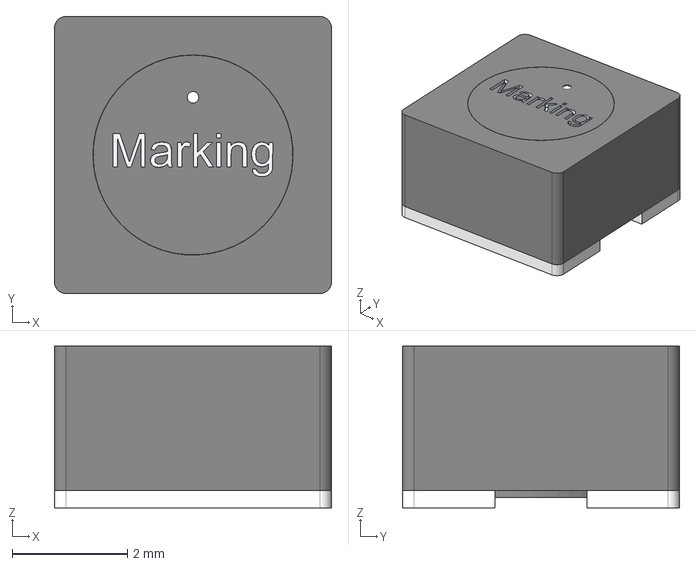
[picture p5: CAD file, 2019-04-14]
hardware/lib3d/L_Wuerth_WE-TPC-4828.step
4.80 x 4.80 x 2.80 mm
