mstoilov/sigmadrone-esc/hardware/lib3d/mkds_5-7-7.62.step

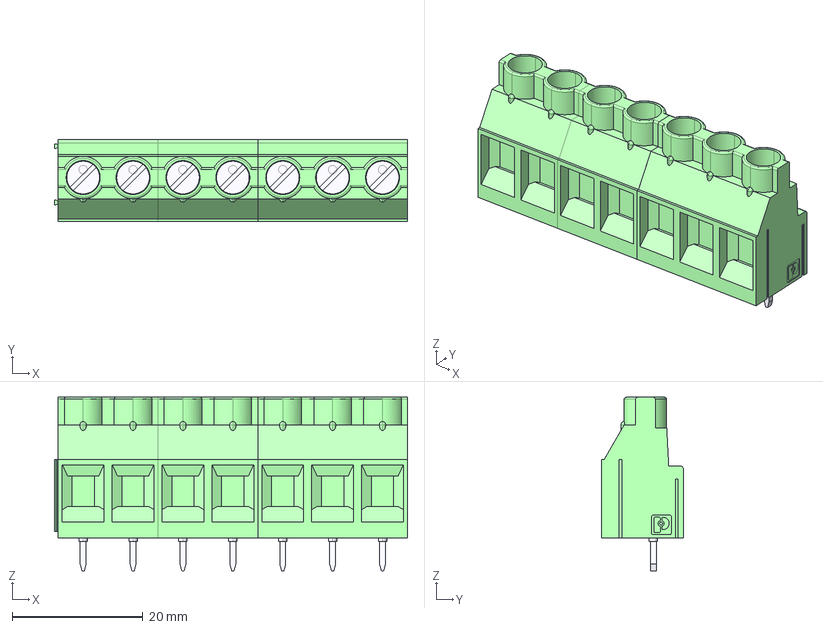
[picture p6: CAD file, 2019-04-14]
hardware/lib3d/mkds_5-7-7.62.step
53.9 x 12.5 x 26.5 mm
