mstoilov/sigmadrone-esc/hardware/lib3d/mkds_5-3-7.62.step

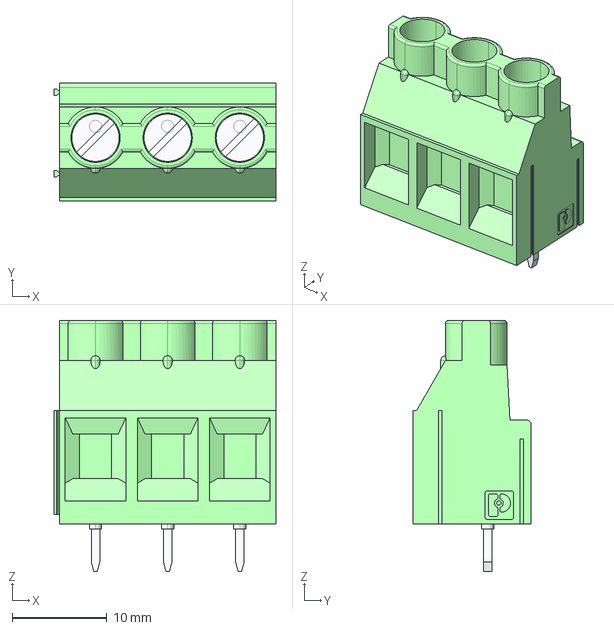
[picture p7: CAD file, 2018-10-10]
hardware/lib3d/mkds_5-3-7.62.step
23.4 x 12.5 x 26.5 mm
