mstoilov/sigmadrone-esc/hardware/lib3d/Wuerth_WE_TPC_3816.step

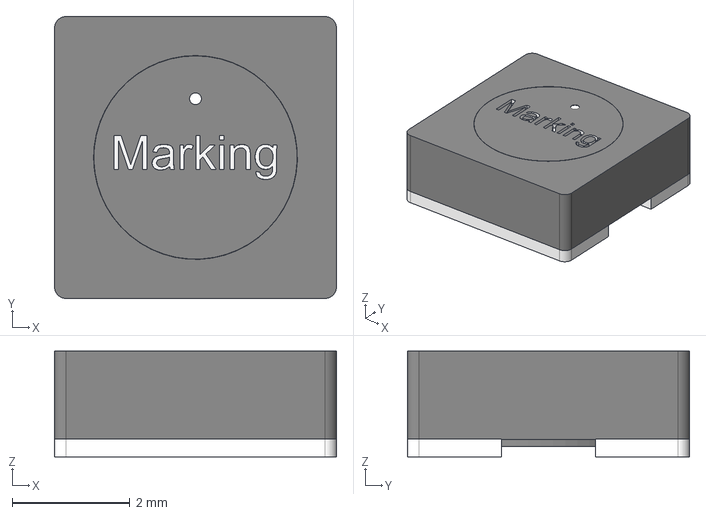
[picture p8: CAD file, 2018-10-10]
hardware/lib3d/Wuerth_WE_TPC_3816.step
4.80 x 4.80 x 1.80 mm
