mstoilov/sigmadrone-esc/hardware/lib3d/pxc_1868076_03_MKDS-5-2-7-62_3D.stp

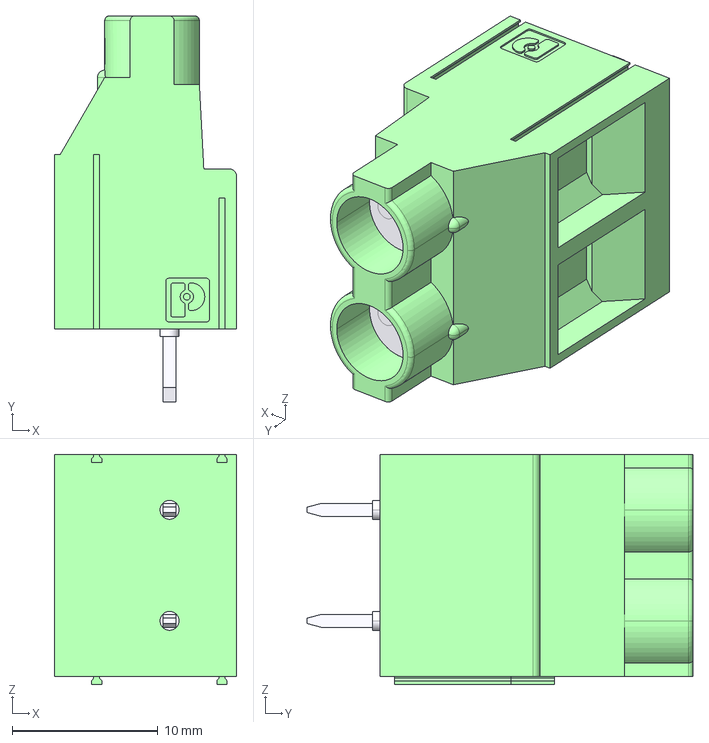
[picture p9: CAD file, 2018-10-10]
hardware/lib3d/pxc_1868076_03_MKDS-5-2-7-62_3D.stp
12.5 x 26.5 x 15.8 mm
