mstoilov/sigmadrone-esc/hardware/lib3d/WURTH_62201021121-rev1.stp

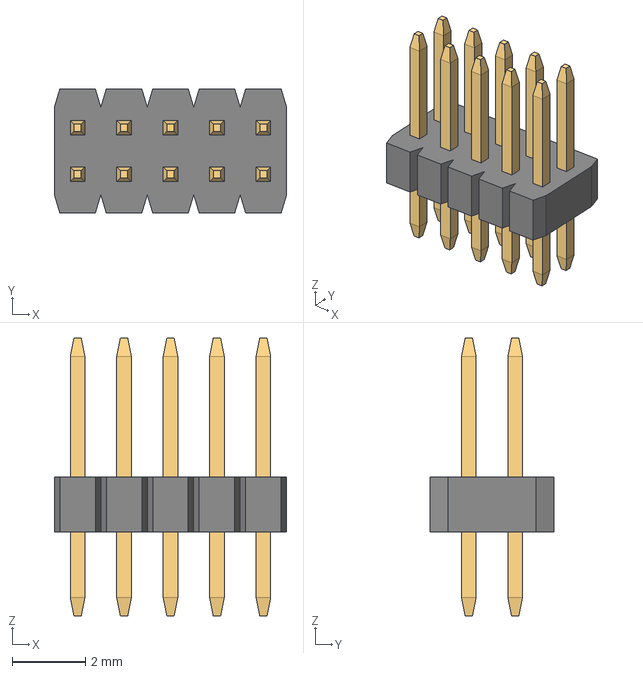
[picture p10: CAD file, 2018-04-08]
hardware/lib3d/WURTH_62201021121-rev1.stp
6.35 x 3.40 x 7.60 mm
6220xx21121 x 10
