mstoilov/sigmadrone-esc/hardware/lib3d/Pin_Headers_Pin_Header_Straight_2x05_Pitch1_27mm.stp

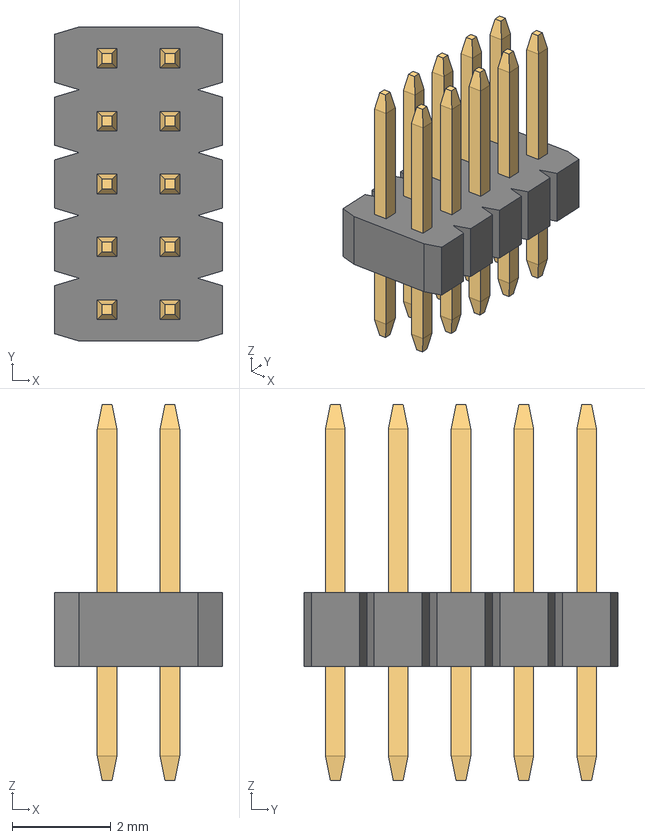
[picture p11: CAD file, 2018-04-08]
hardware/lib3d/Pin_Headers_Pin_Header_Straight_2x05_Pitch1_27mm.stp
3.40 x 6.35 x 7.60 mm
