mstoilov/sigmadrone-esc/hardware/lib3d/36500300_cp.step

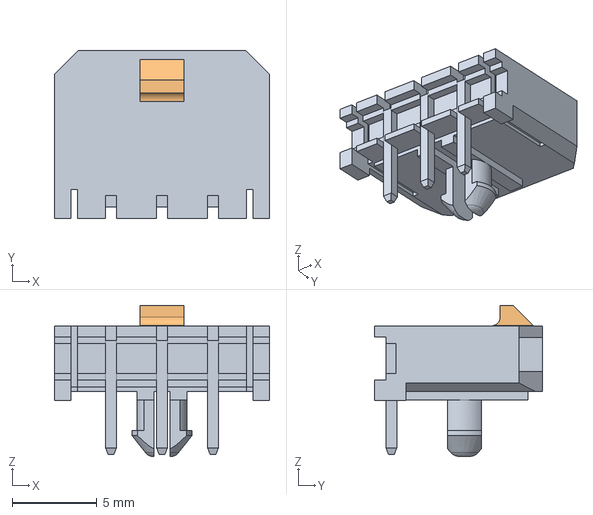
[picture p12: CAD file, 2020-09-22]
hardware/lib3d/36500300_cp.step
12.6 x 9.90 x 8.90 mm
