mstoilov/sigmadrone-esc/hardware/lib3d/36500400_cp.step

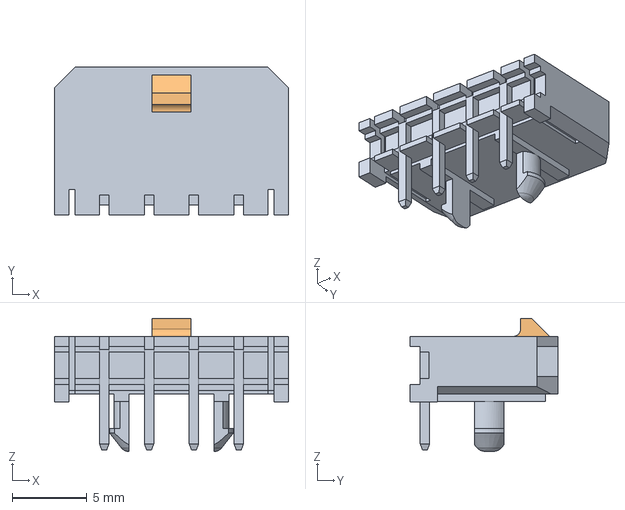
[picture p13: CAD file, 2020-09-22]
hardware/lib3d/36500400_cp.step
15.6 x 9.90 x 8.91 mm
