mstoilov/sigmadrone-esc/(list of files, cad)

Other CAD files:
hardware/lib3d/pxc_1704936_03_MKDS-5-3-7-62_3D.stp
hardware/lib3d/mkds_5-2-7.62.step
hardware/lib3d/STEP-WE-TPC-4818-rev1.stp
