mstoilov/sigmadrone-esc/hardware/zec-rev1/Servo_DRV_Rev1_PCB_Diagram.pdf

# PCB Diagram

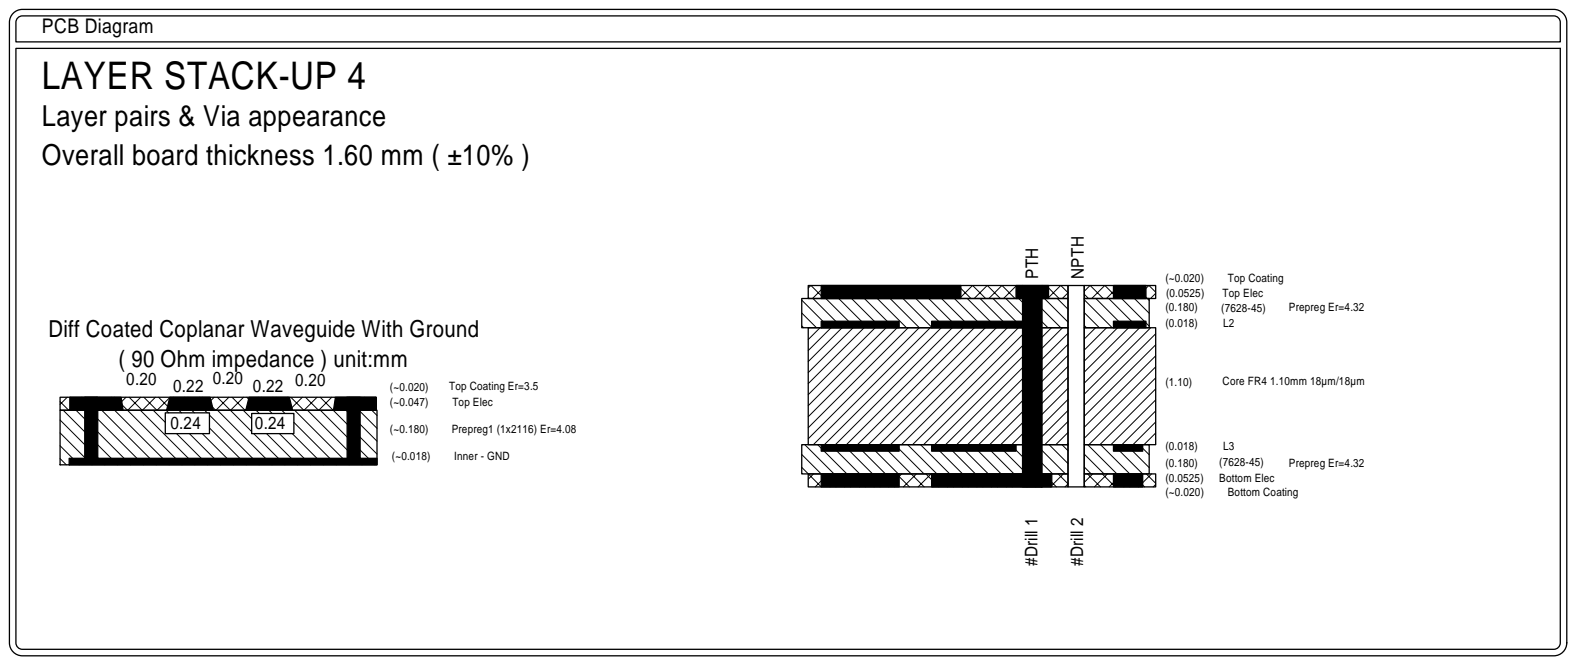
[picture p14: page 1]
NPTH; Top Coating; Bottom Elec; PTH; Prepreg Er=4.32; Top Elec; Inner - GND; Prepreg1 (1x2116) Er=4.08; Bottom Coating; #Drill 1; #Drill 2; Core FR4 1.10mm 18µm/18µm

LAYER STACK-UP 4
Layer pairs & Via appearance
Overall board thickness 1.60 mm ( ±10% )

Diff Coated Coplanar Waveguide With Ground

( 90 Ohm impedance ) unit:mm

Top Coating Er=3.5
Top Elec
