mstoilov/sigmadrone-esc/hardware/zec-rev1/Servo_DRV_Rev1_Schematics.pdf

# MCU

# MOSFETS M1

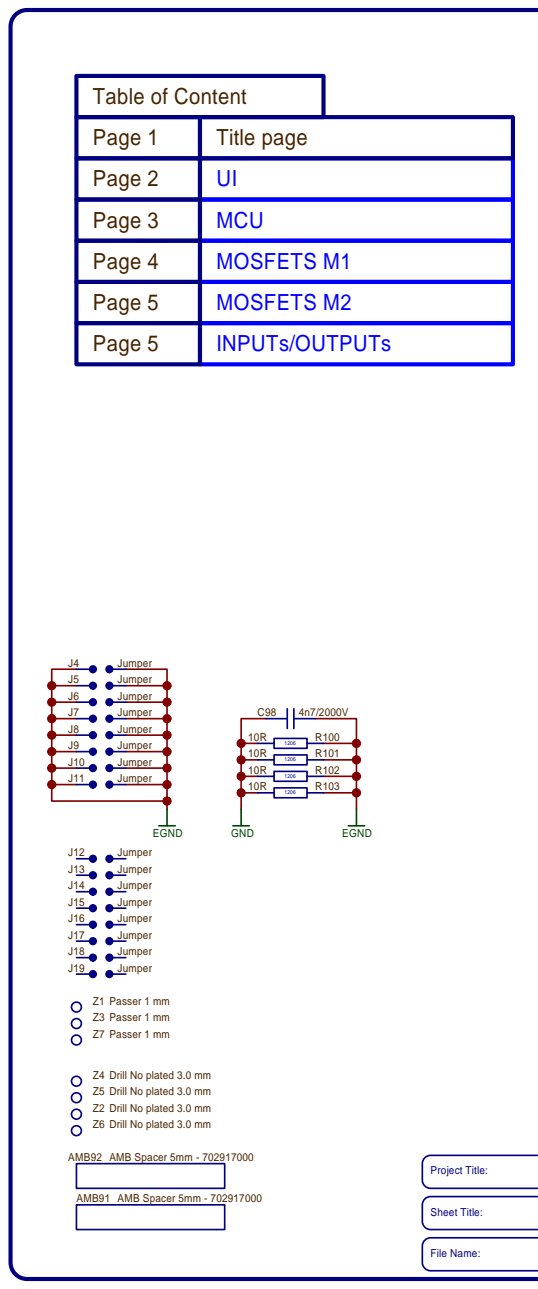
[picture p15: page 1]

Z4 Drill No plated 3.0 mm
Z5 Drill No plated 3.0 mm
Z2 Drill No plated 3.0 mm
Z6 Drill No plated 3.0 mm

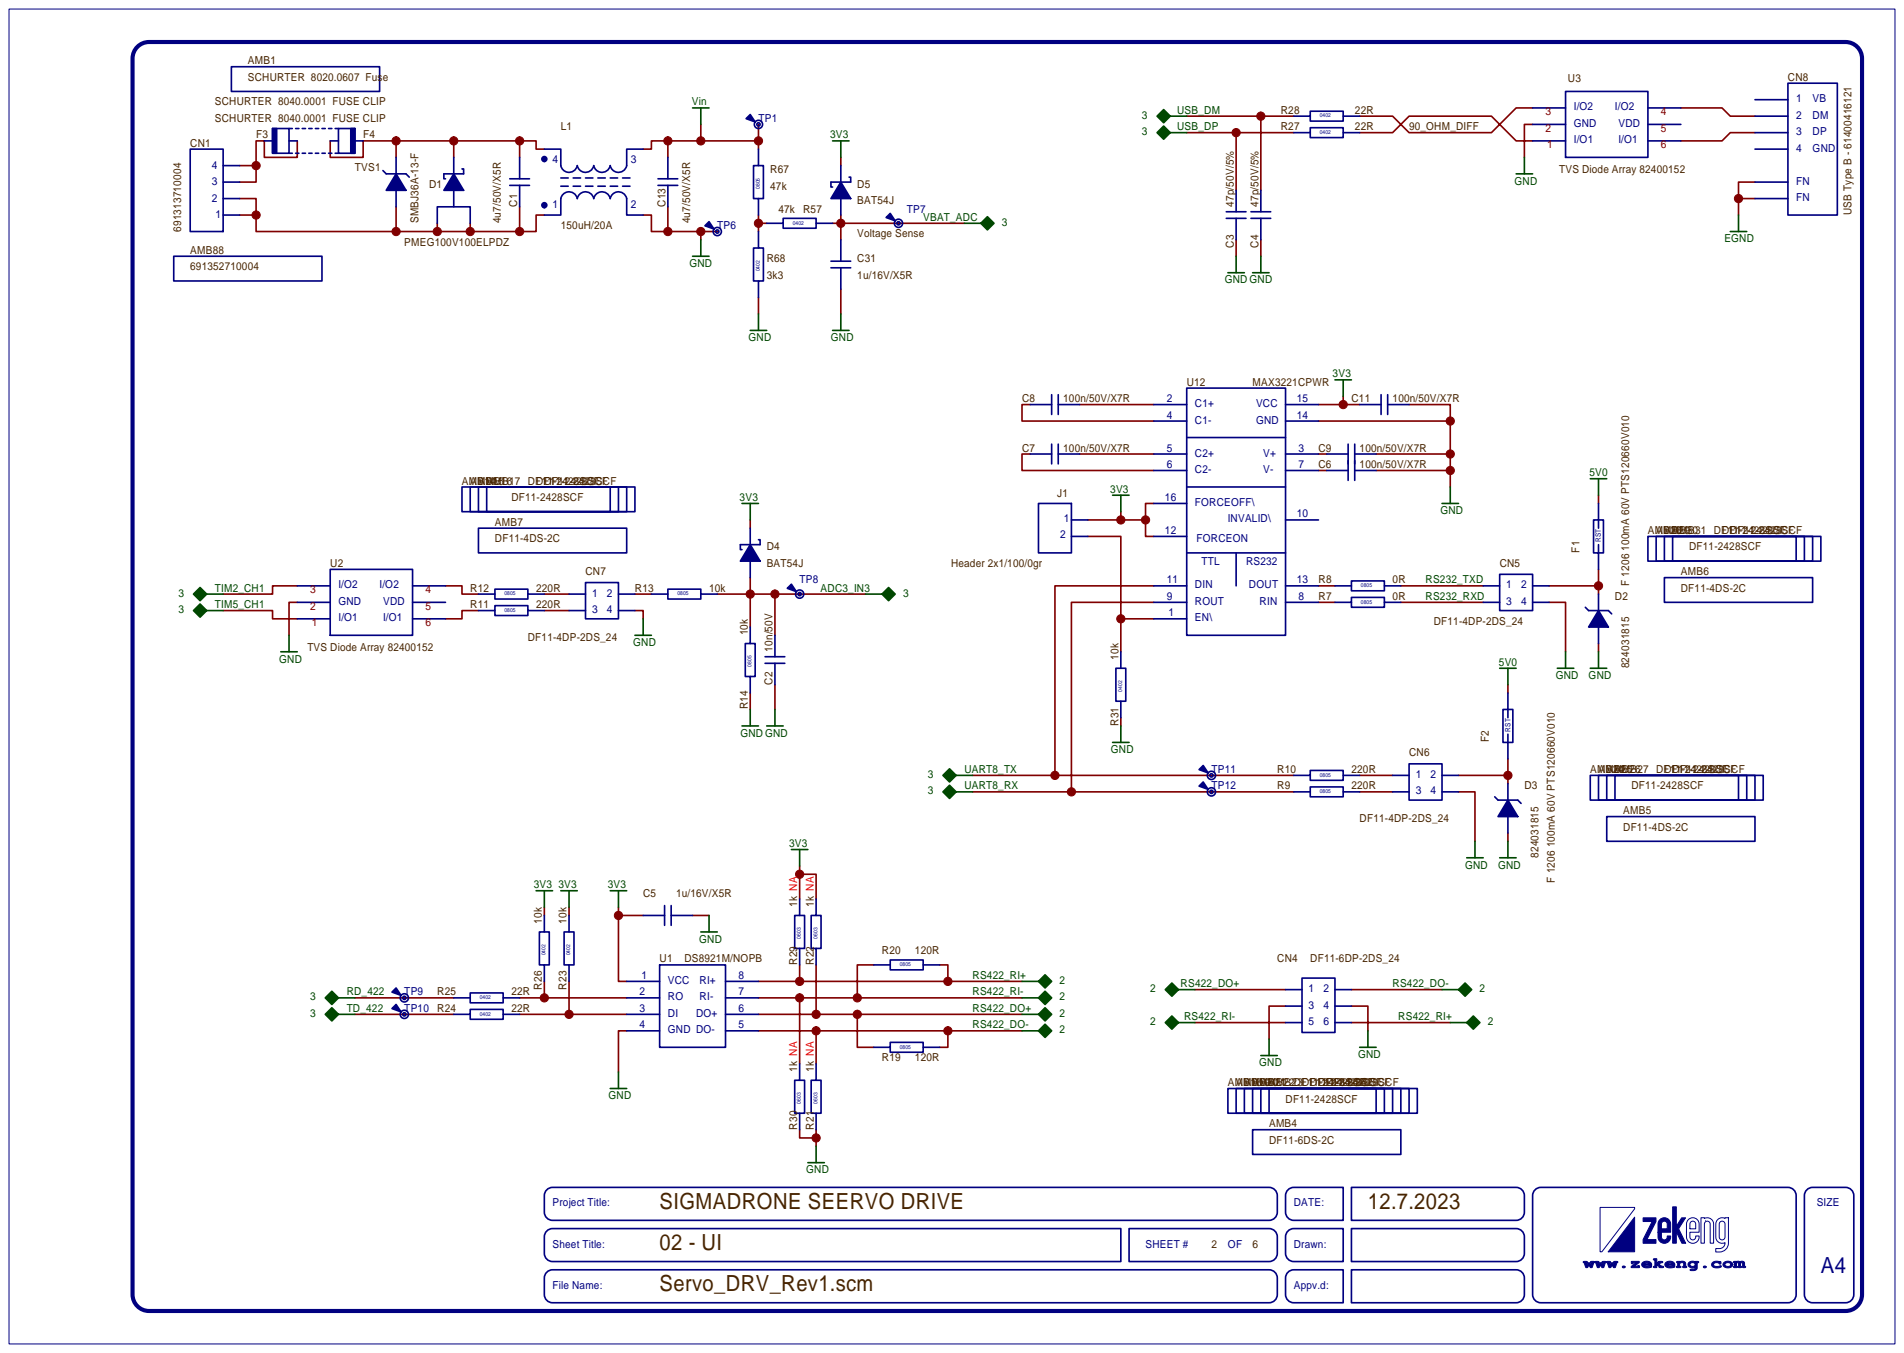
[picture p16: page 2]

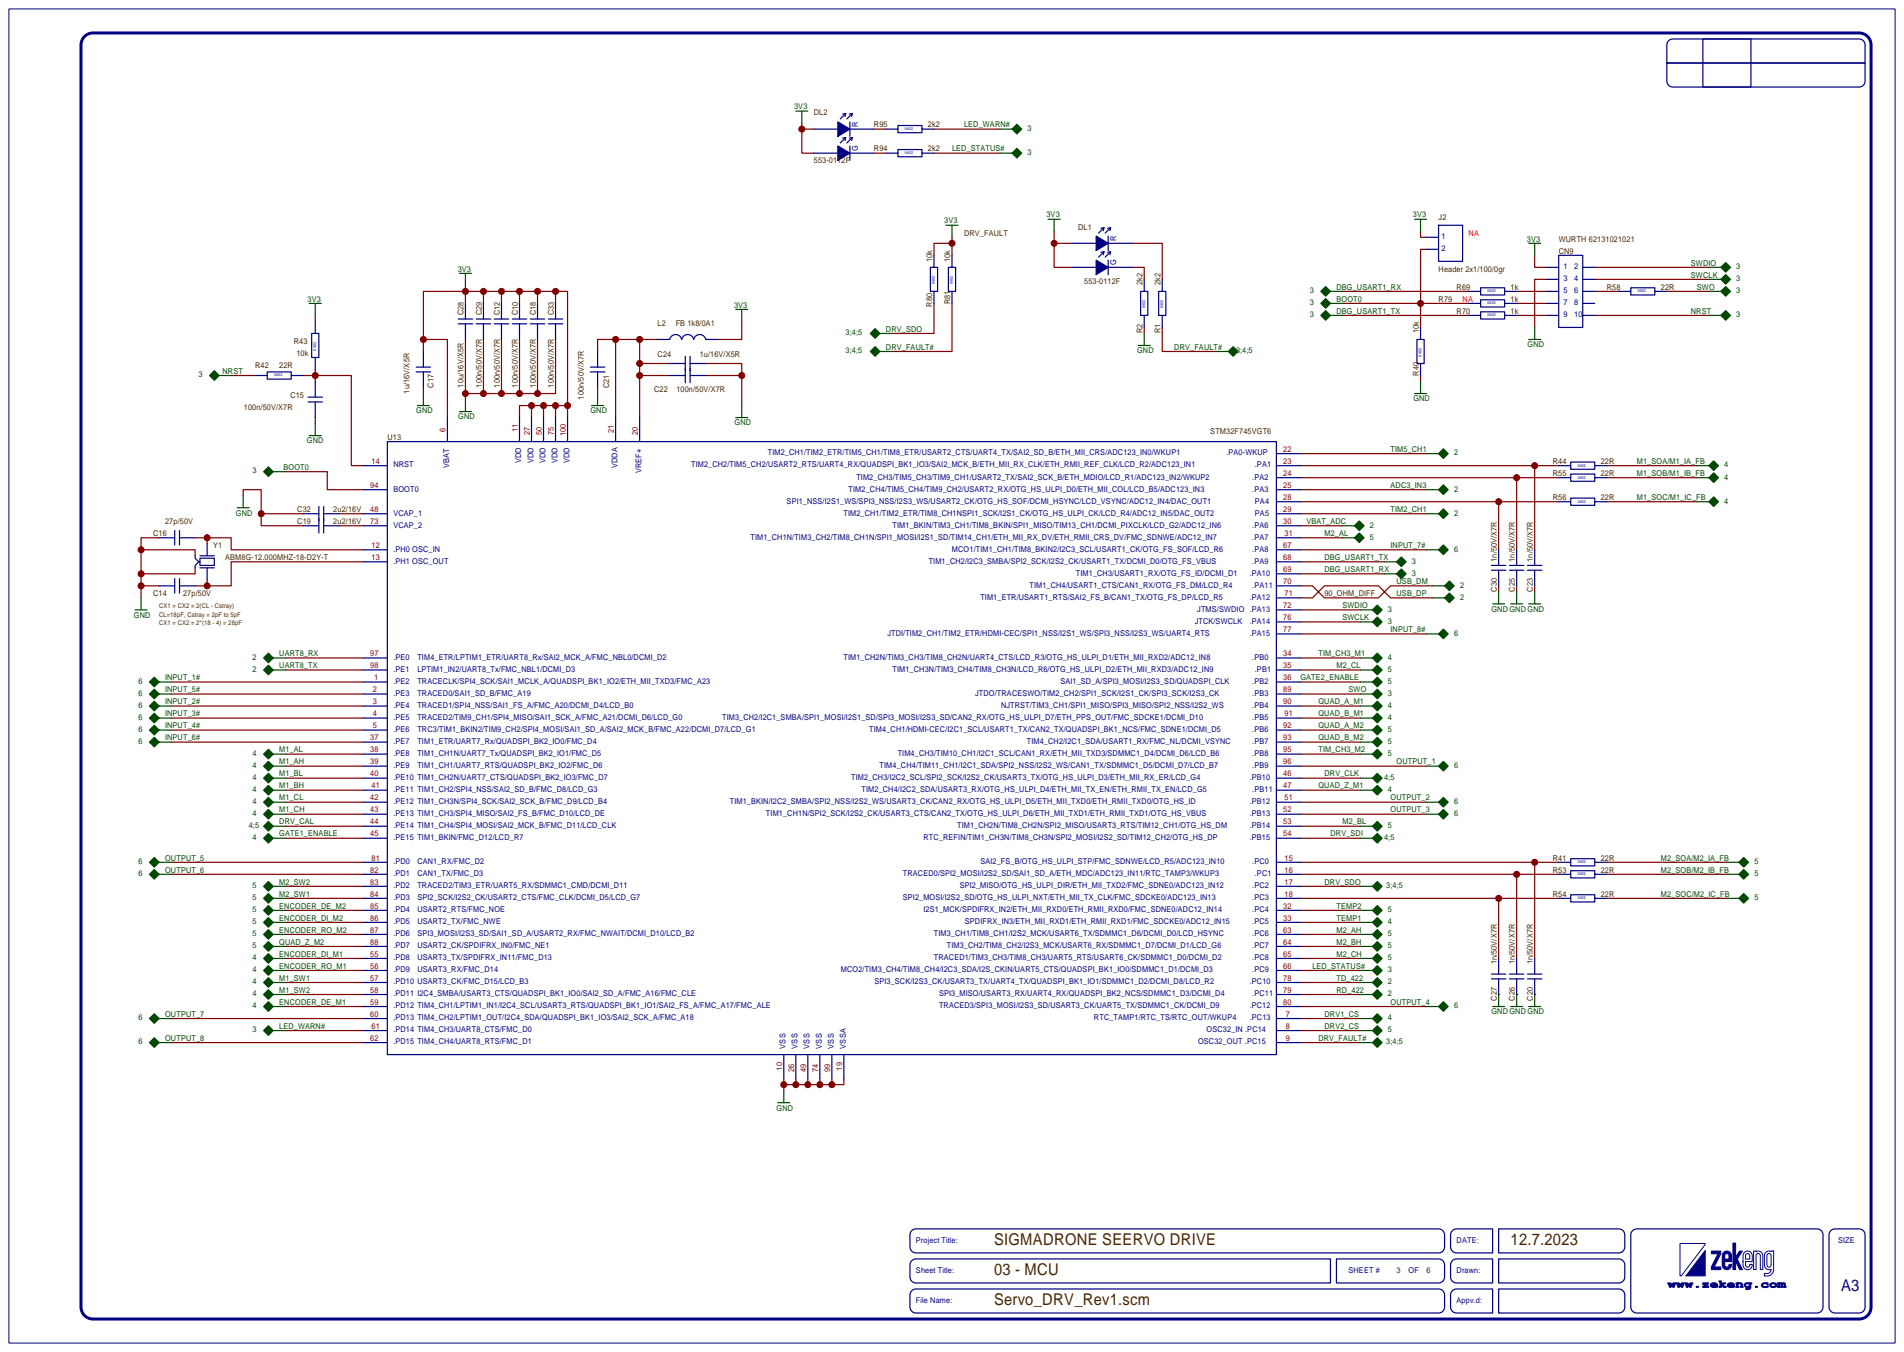
[picture p17: page 3]

## !!! Check Page 72 Figure 66 !!! Application Report SLVA951

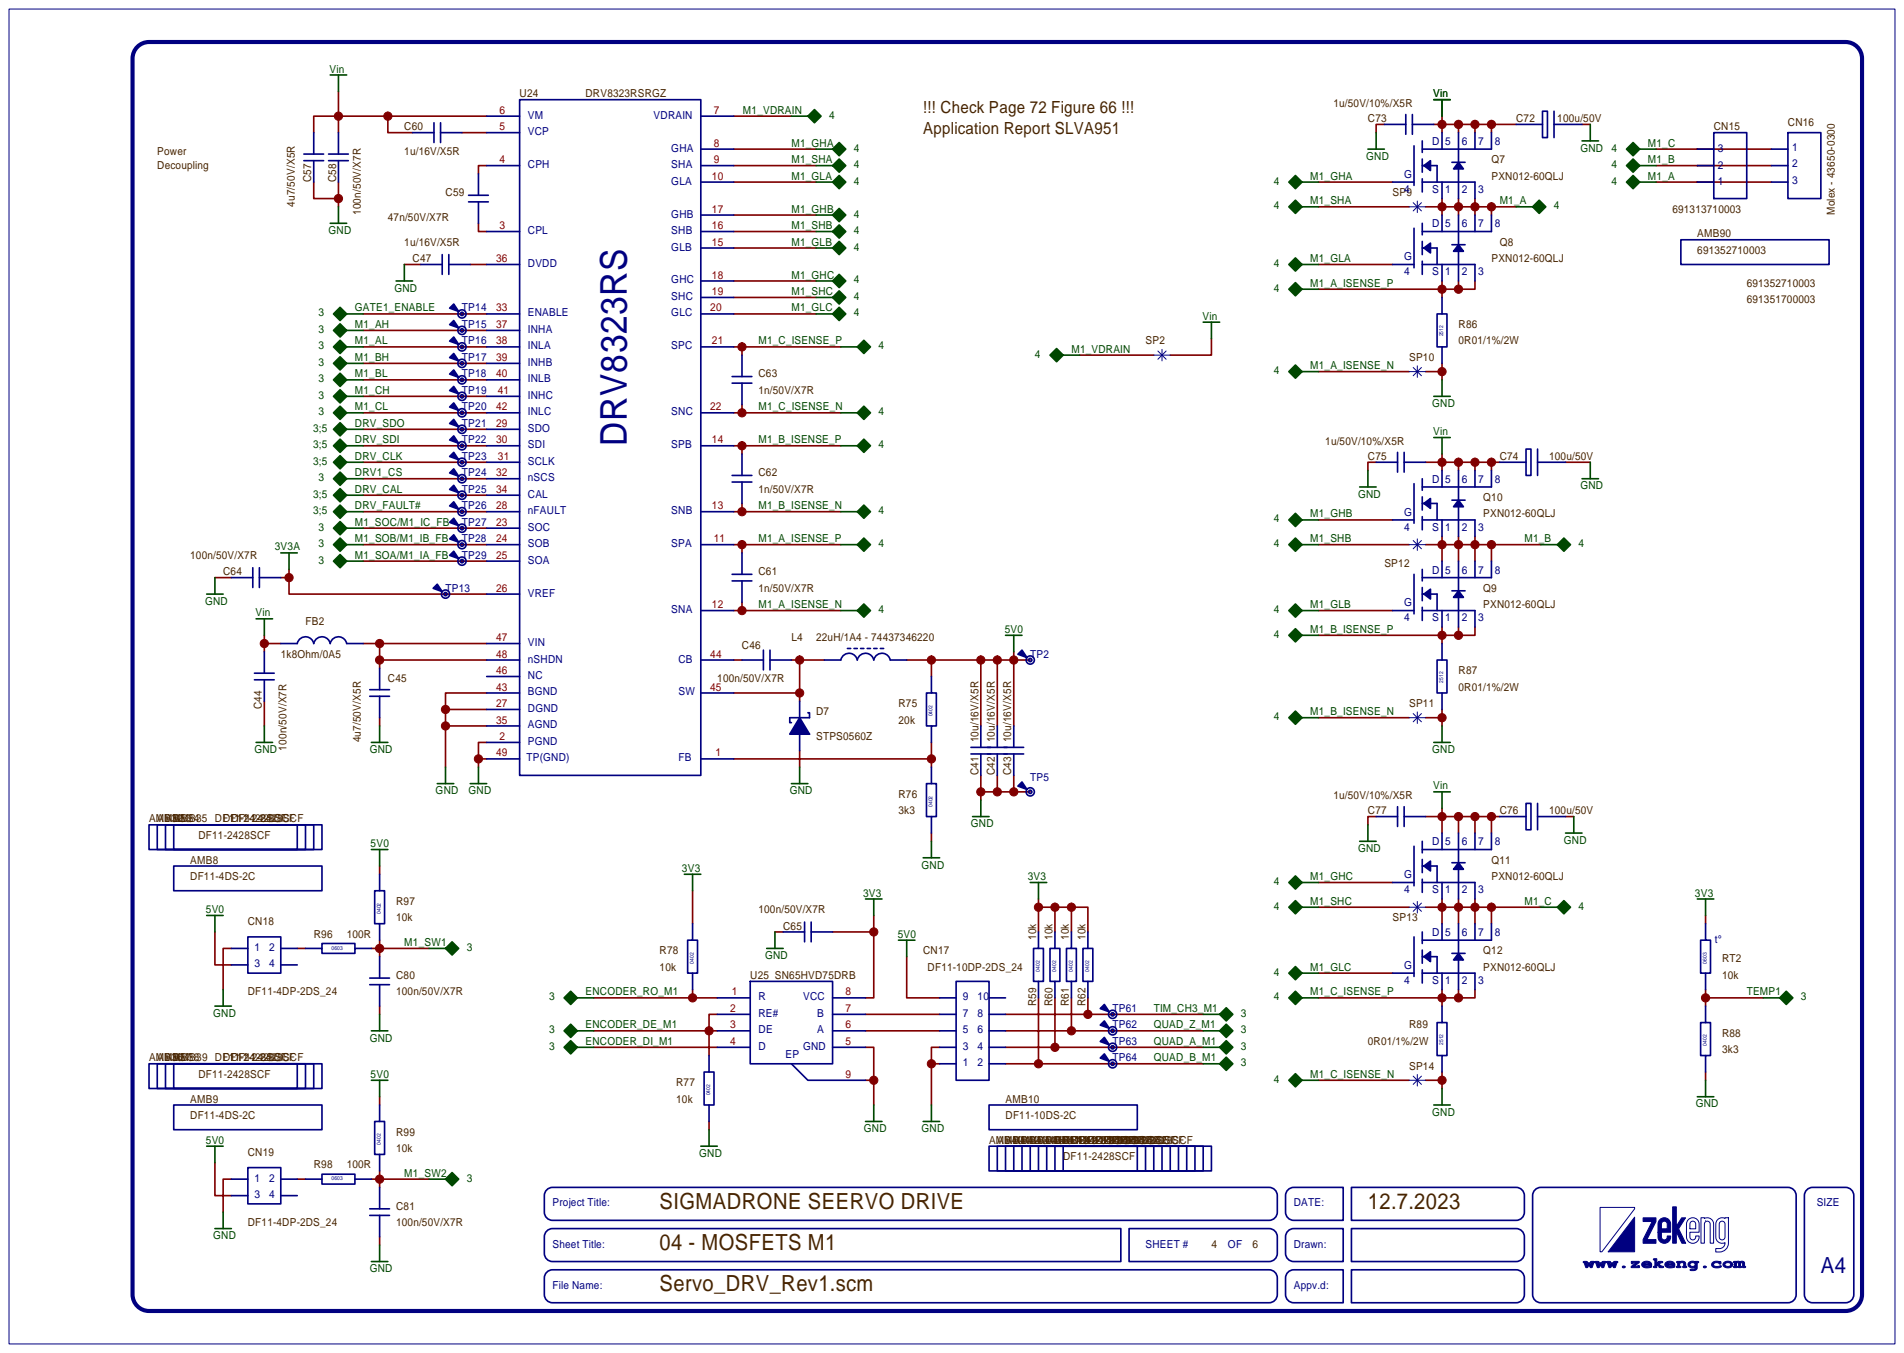
[picture p18: page 4]

## !!! Check Page 72 Figure 66 !!! Application Report SLVA951

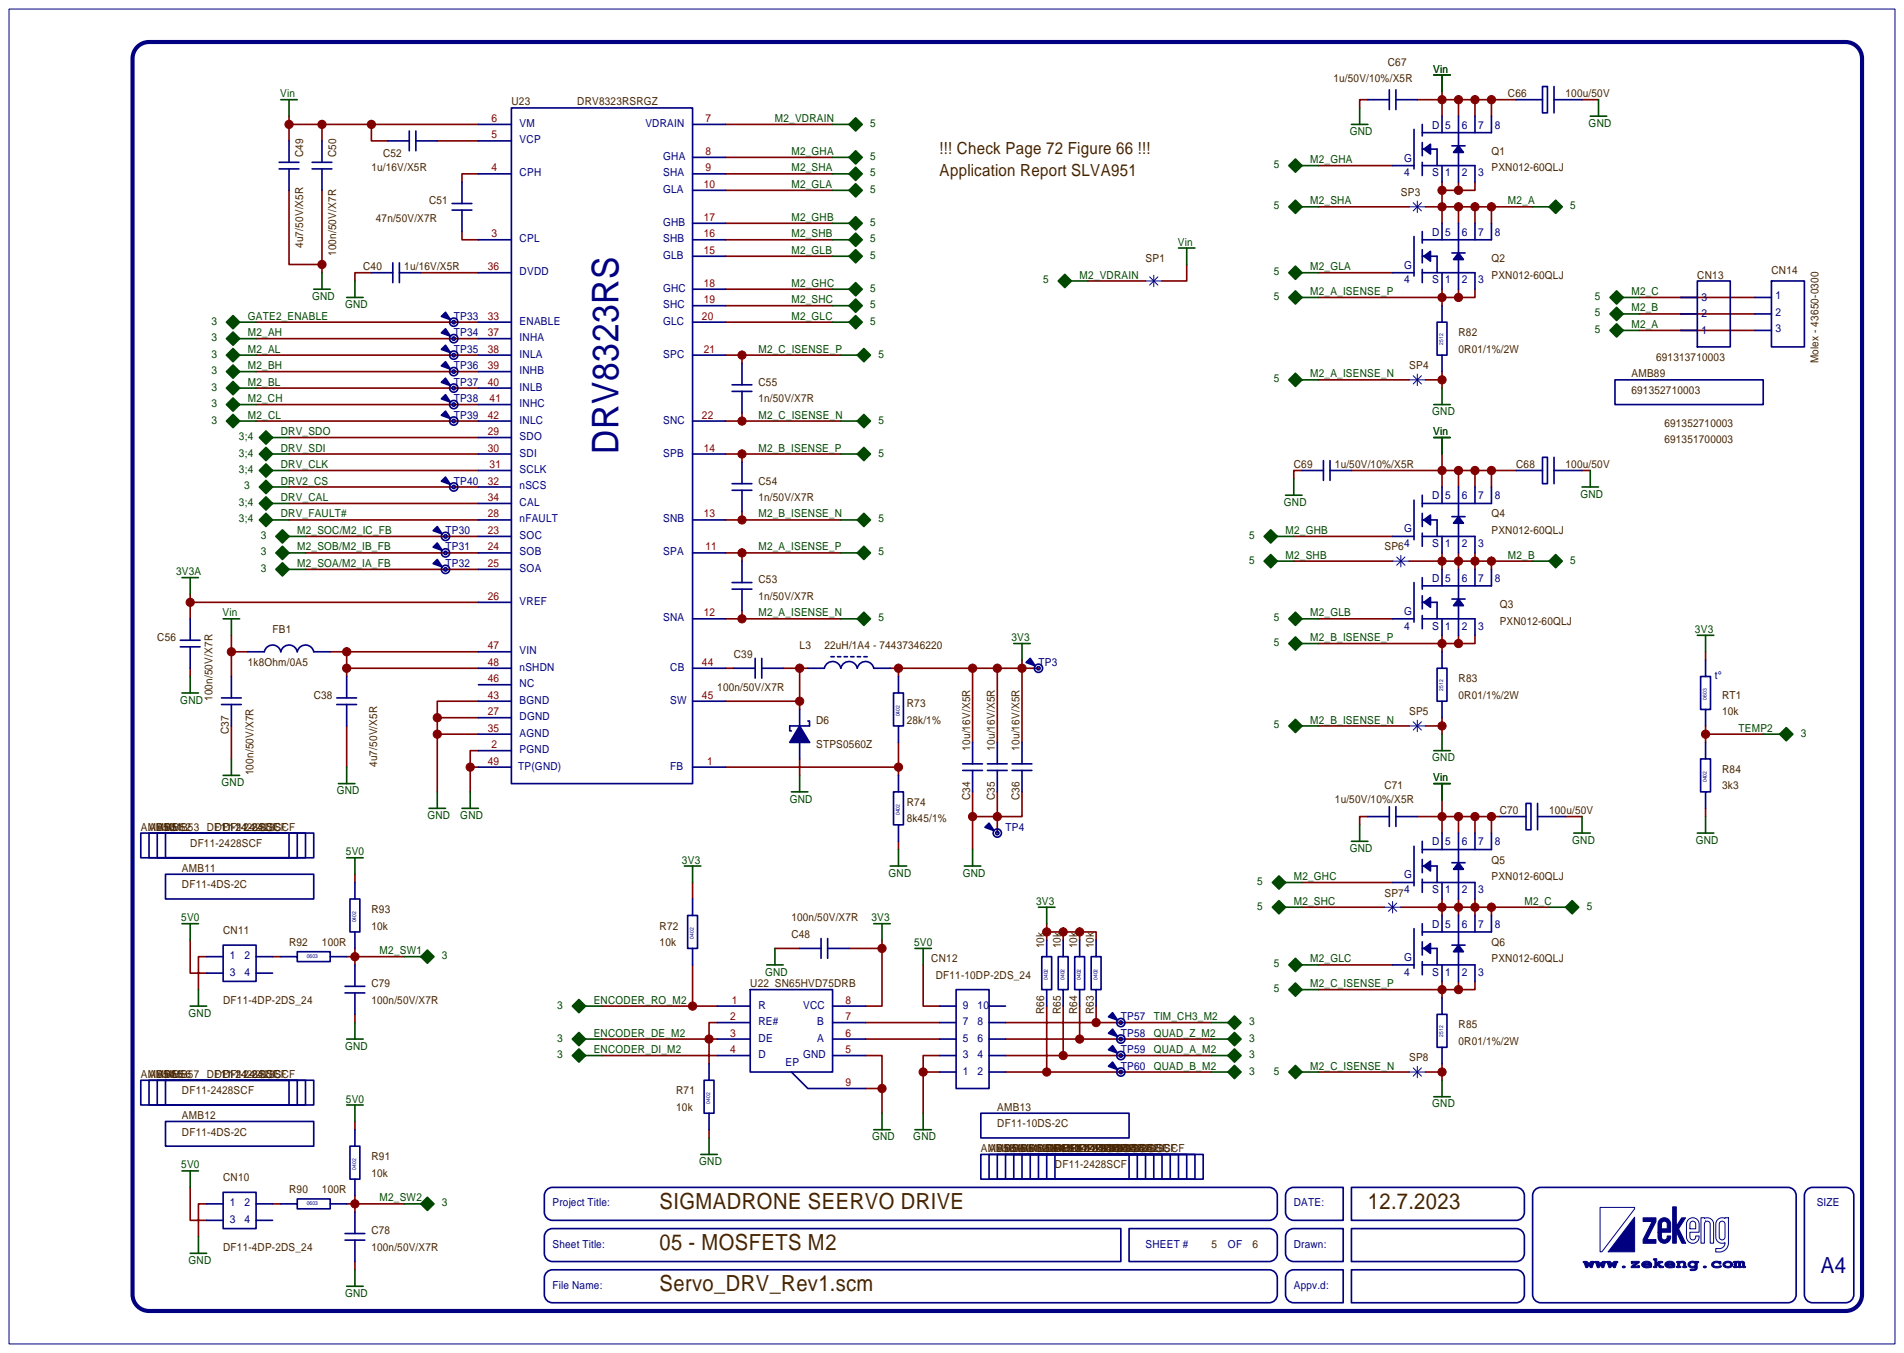
[picture p19: page 5]

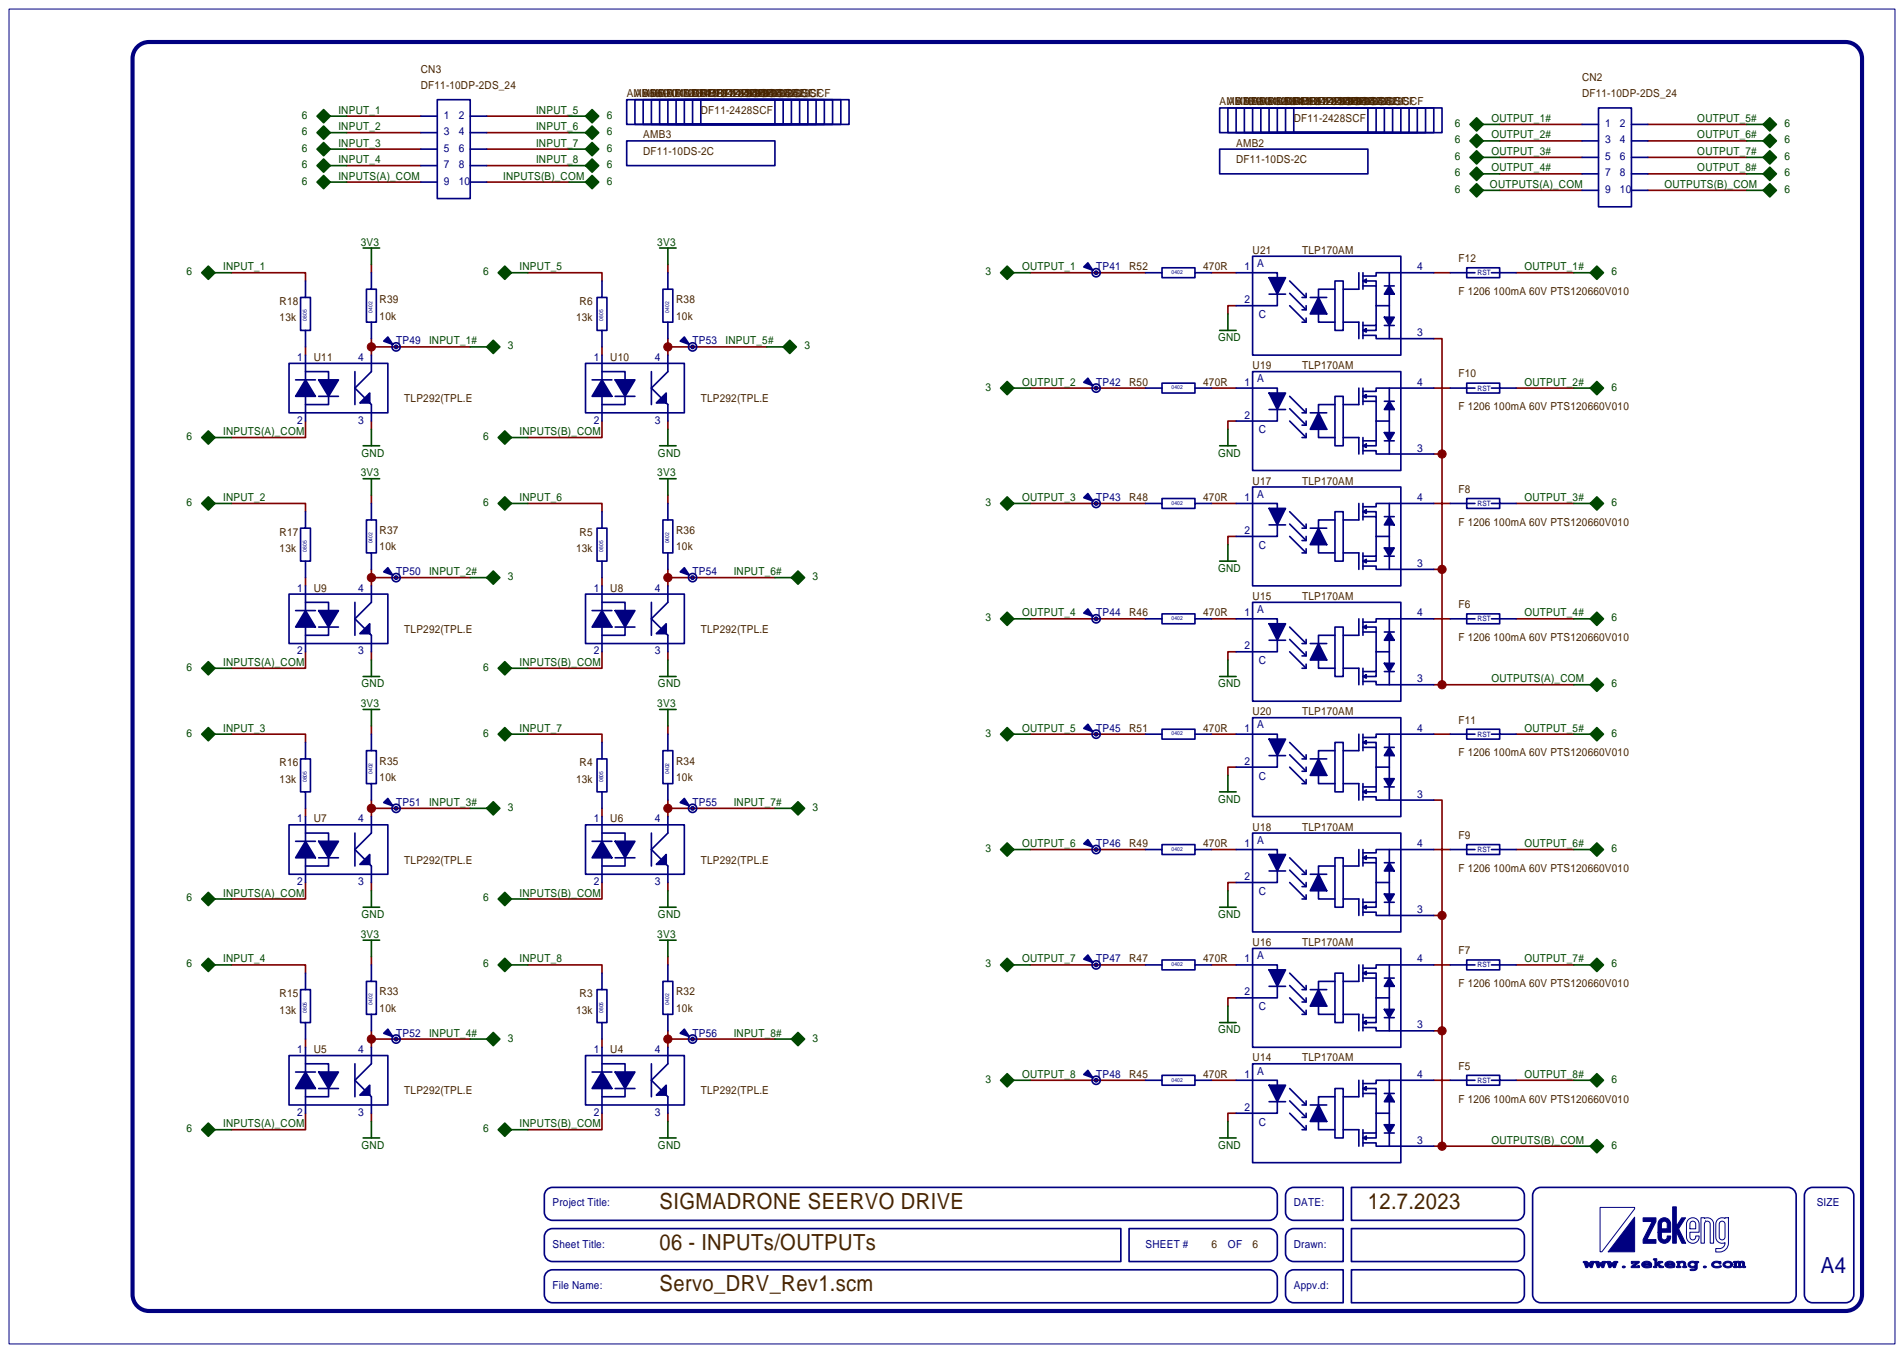
[picture p20: page 6]
