mstoilov/sigmadrone-esc/hardware/zec-rev1/Servo_DRV_Rev1_Top_SS_P&P.pdf

## PWR-IN

# M1_SW2 Auto power-down

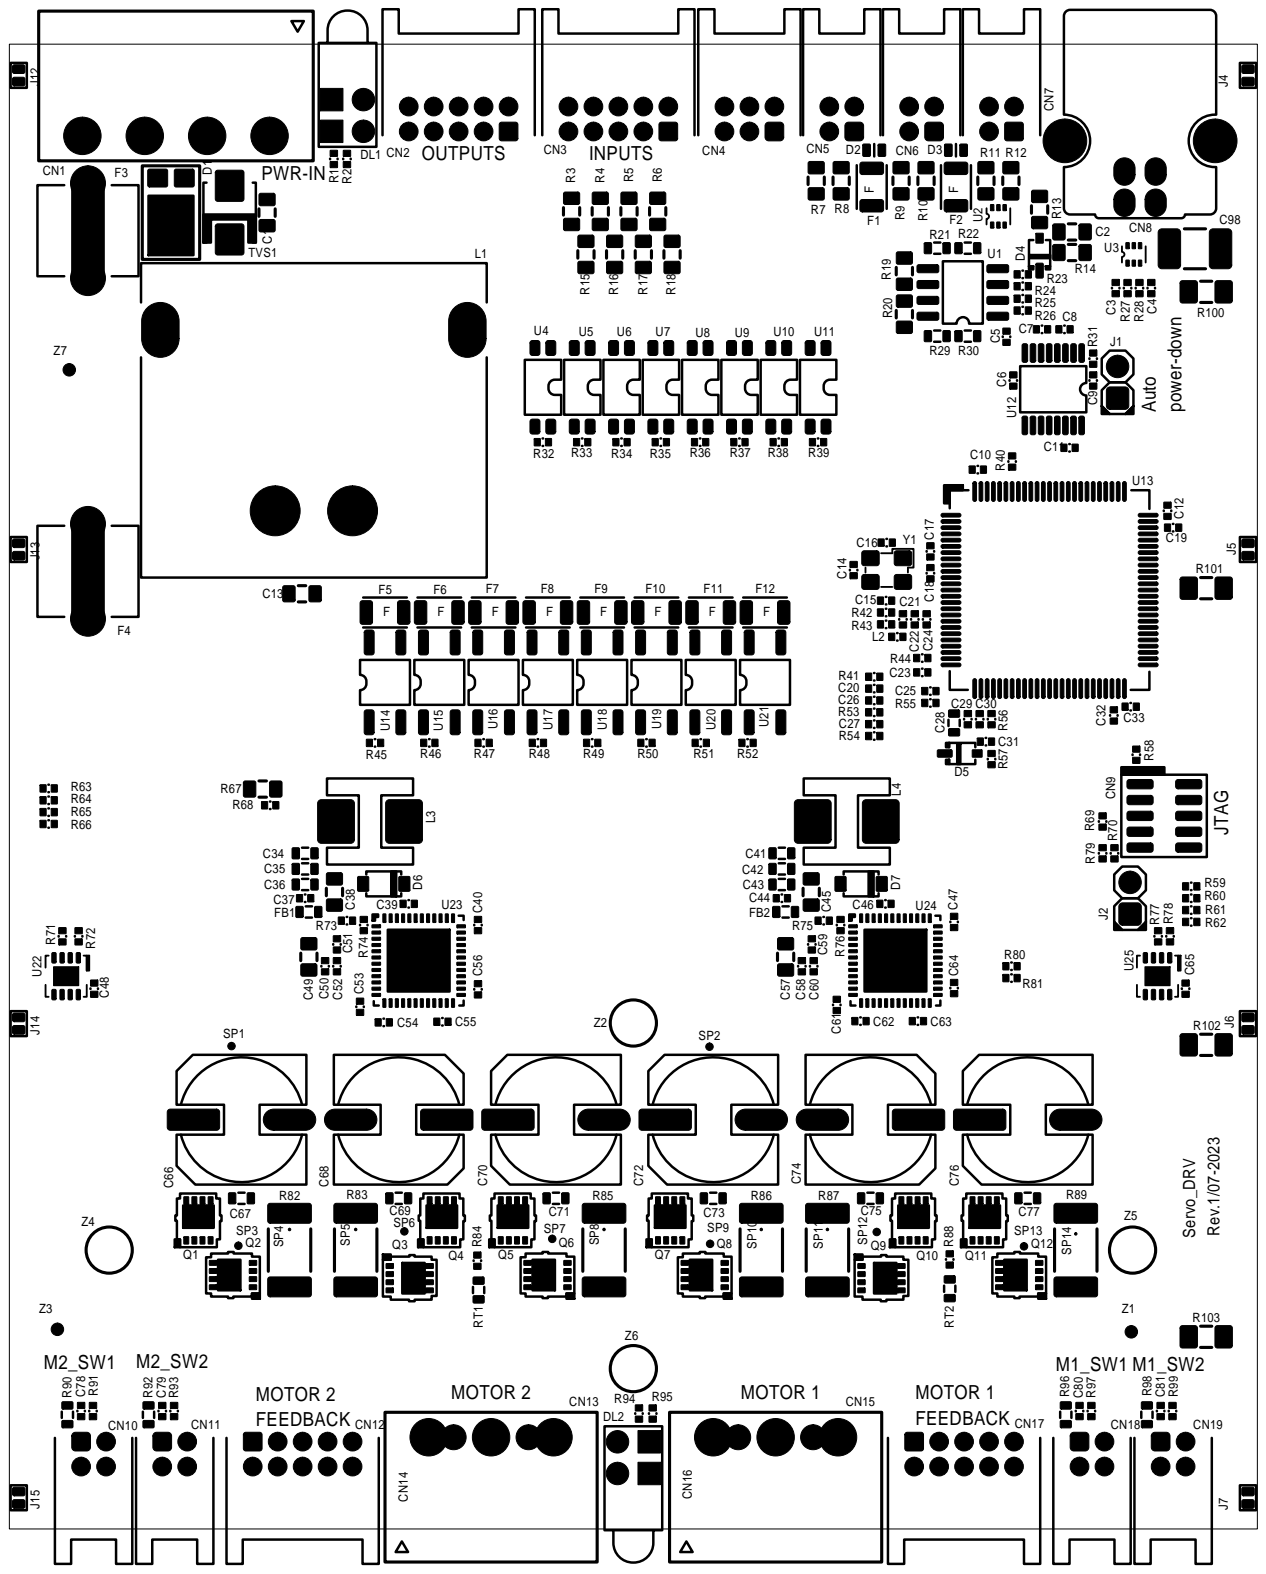
[picture p21: page 1]
