mstoilov/sigmadrone-esc/hardware/zec-rev1/Servo_DRV_Rev1_Bot_ASS_P&P.pdf

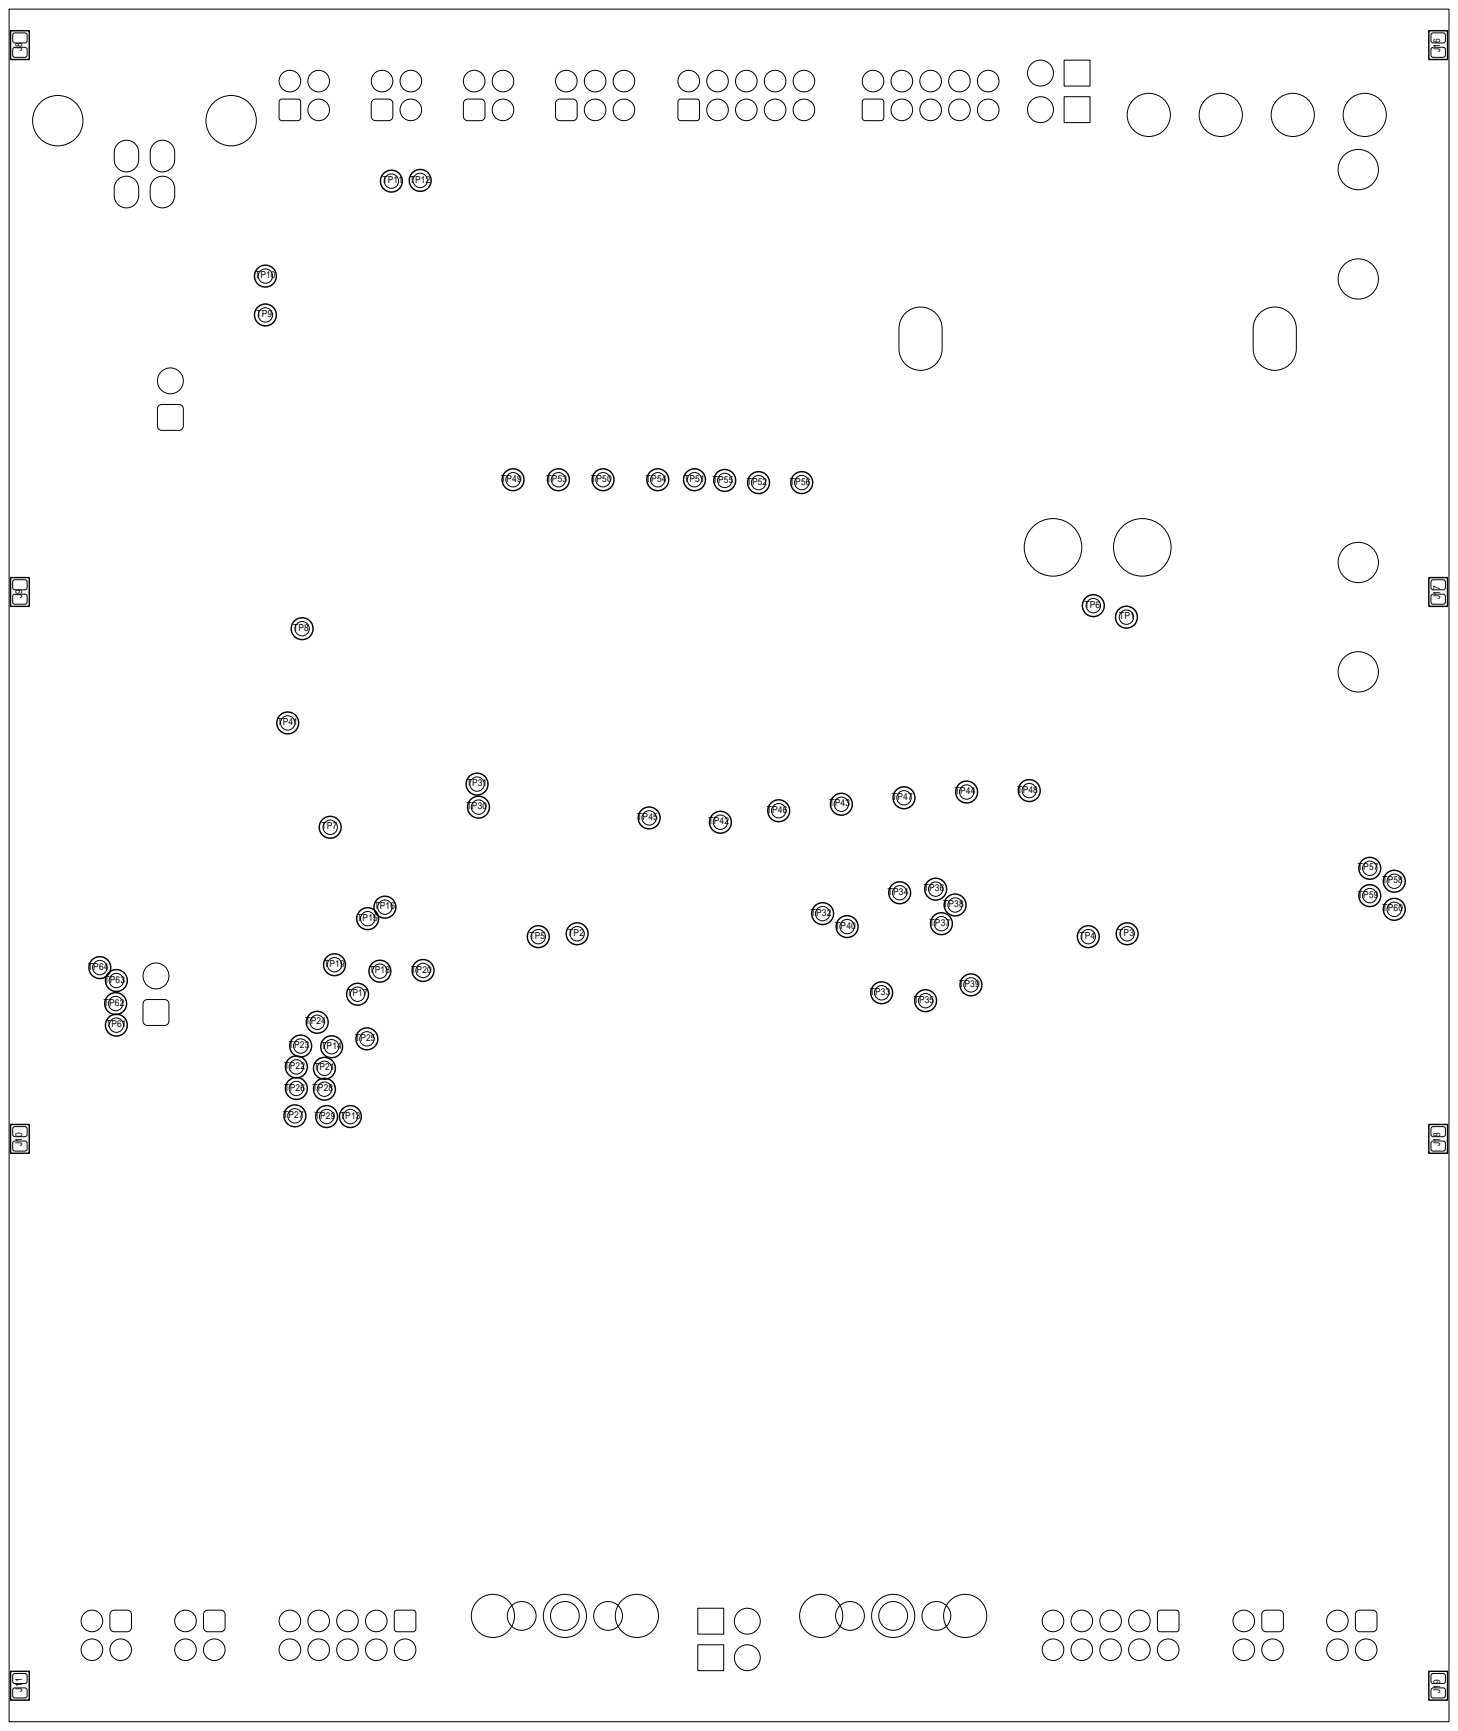
[picture p22: page 1]
