mstoilov/sigmadrone-esc/hardware/zec-rev1/Servo_DRV_Rev1_Bot_SS_P&P.pdf

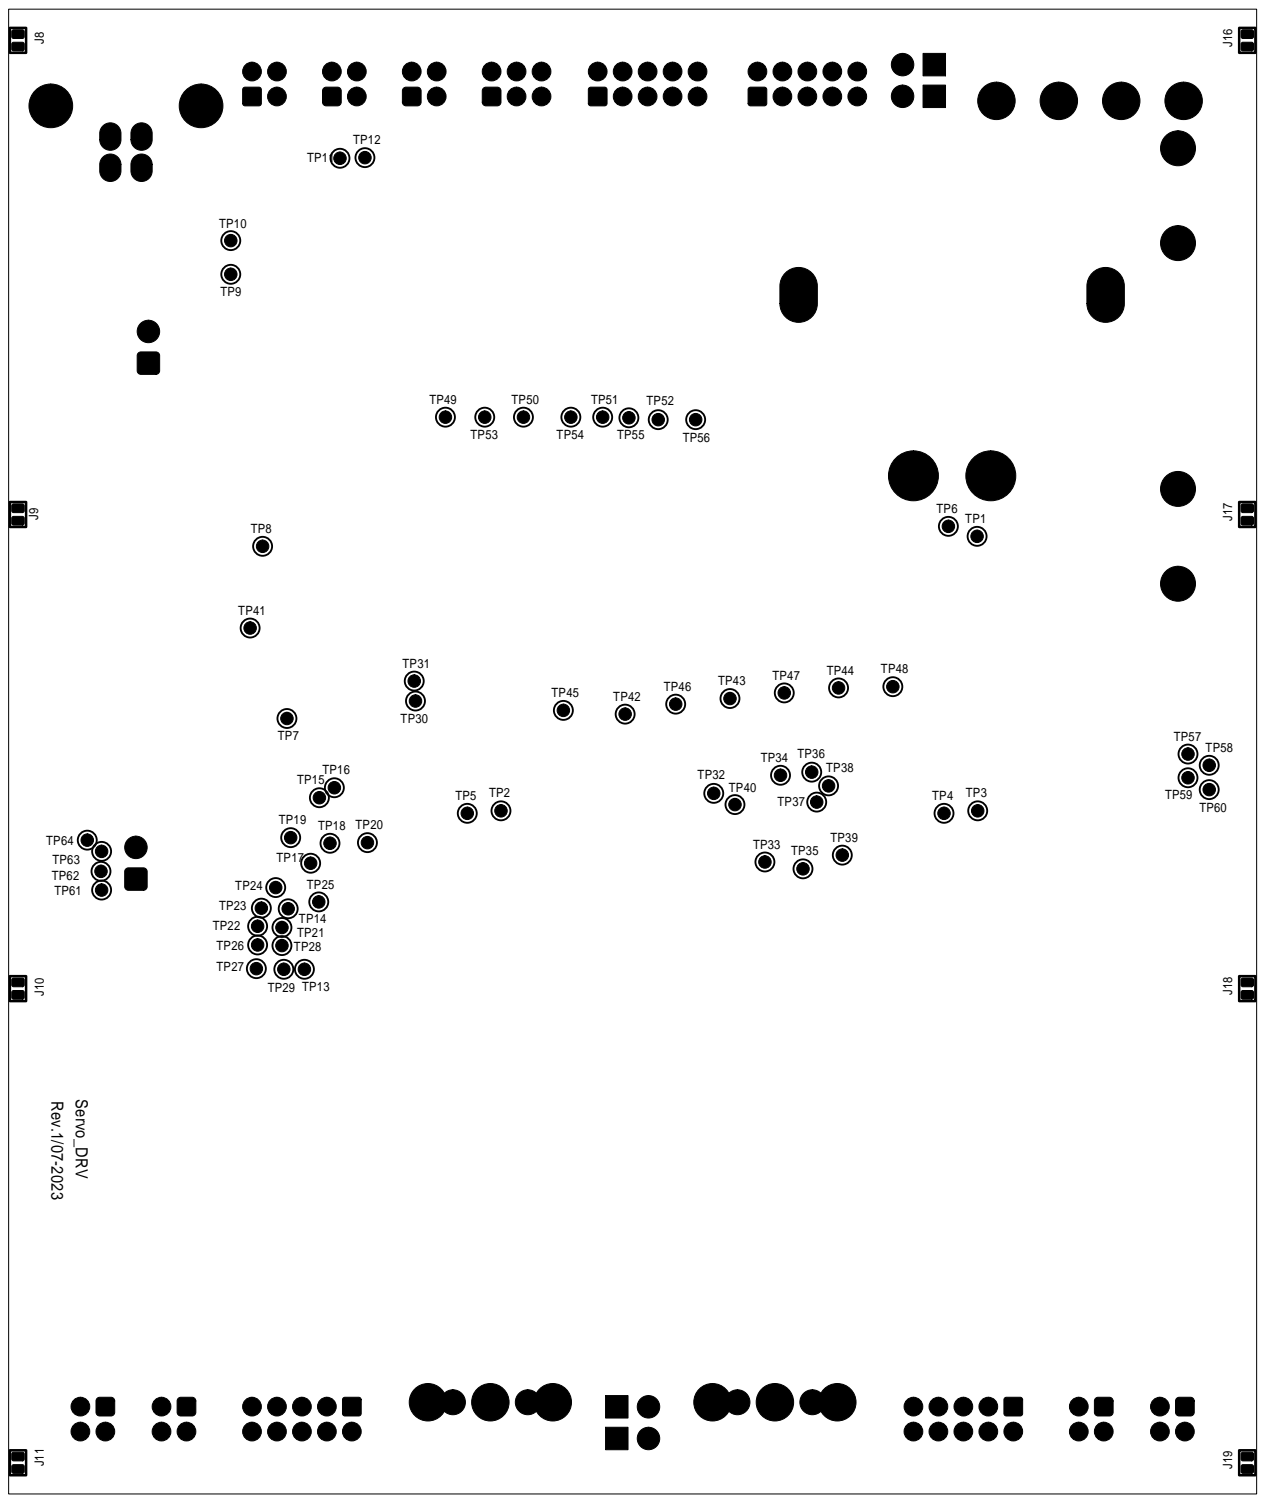
[picture p23: page 1]
