mstoilov/sigmadrone-esc/hardware/zec-rev1/Servo_DRV_Rev1_GERBER View.pdf

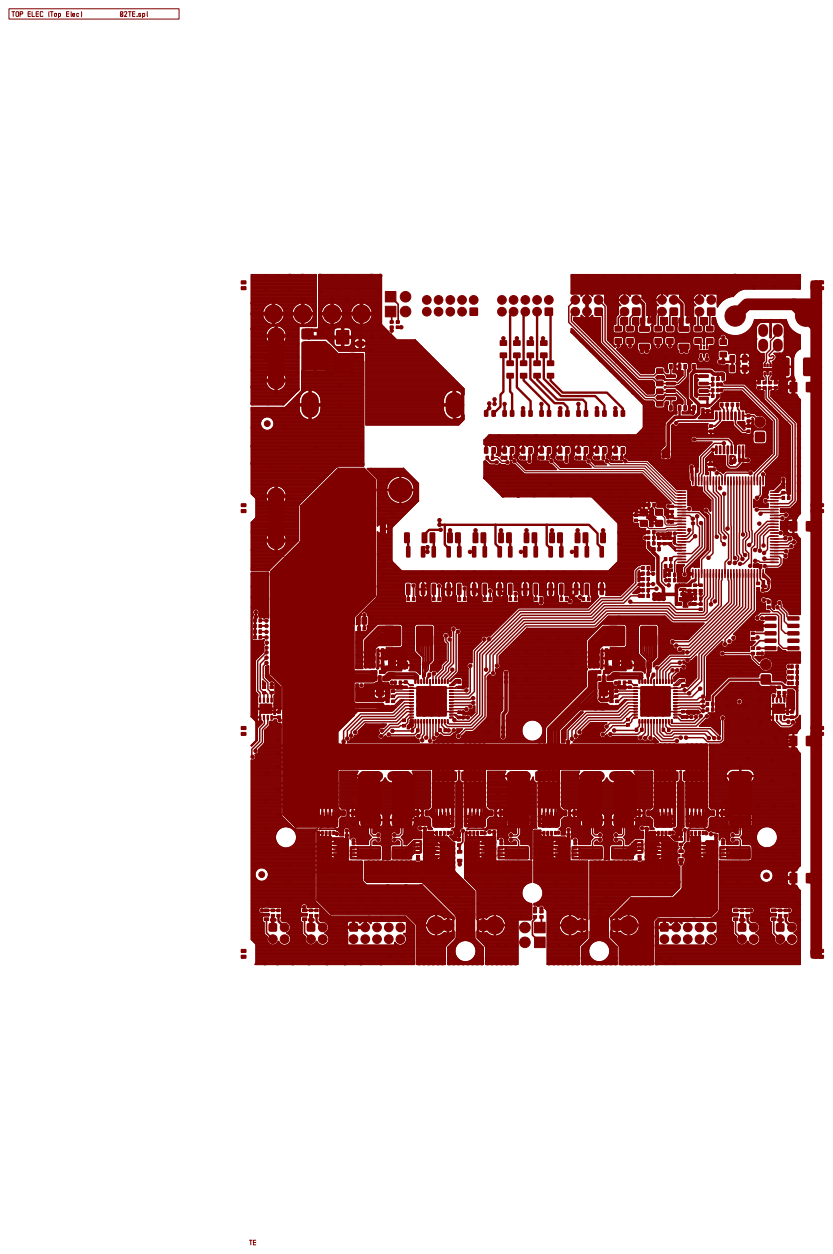
[picture p24: page 2]

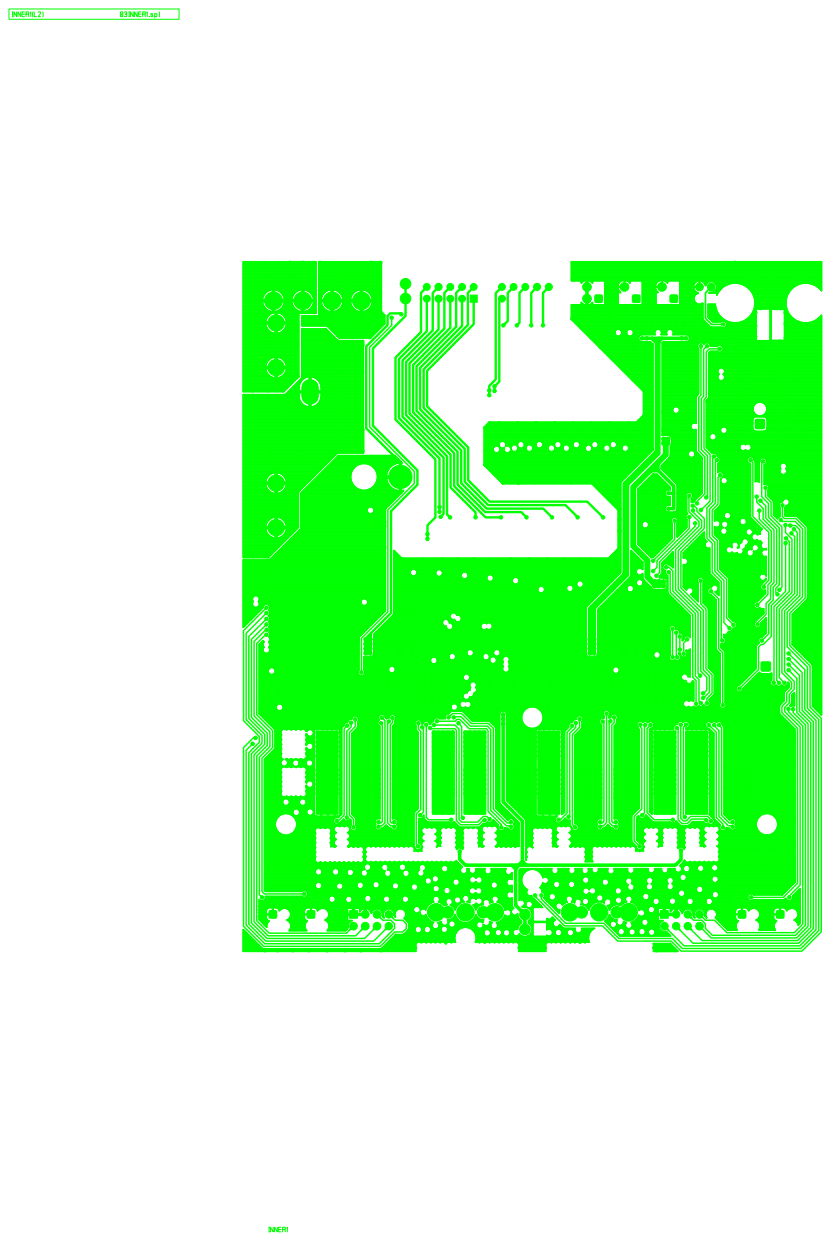
[picture p25: page 3]

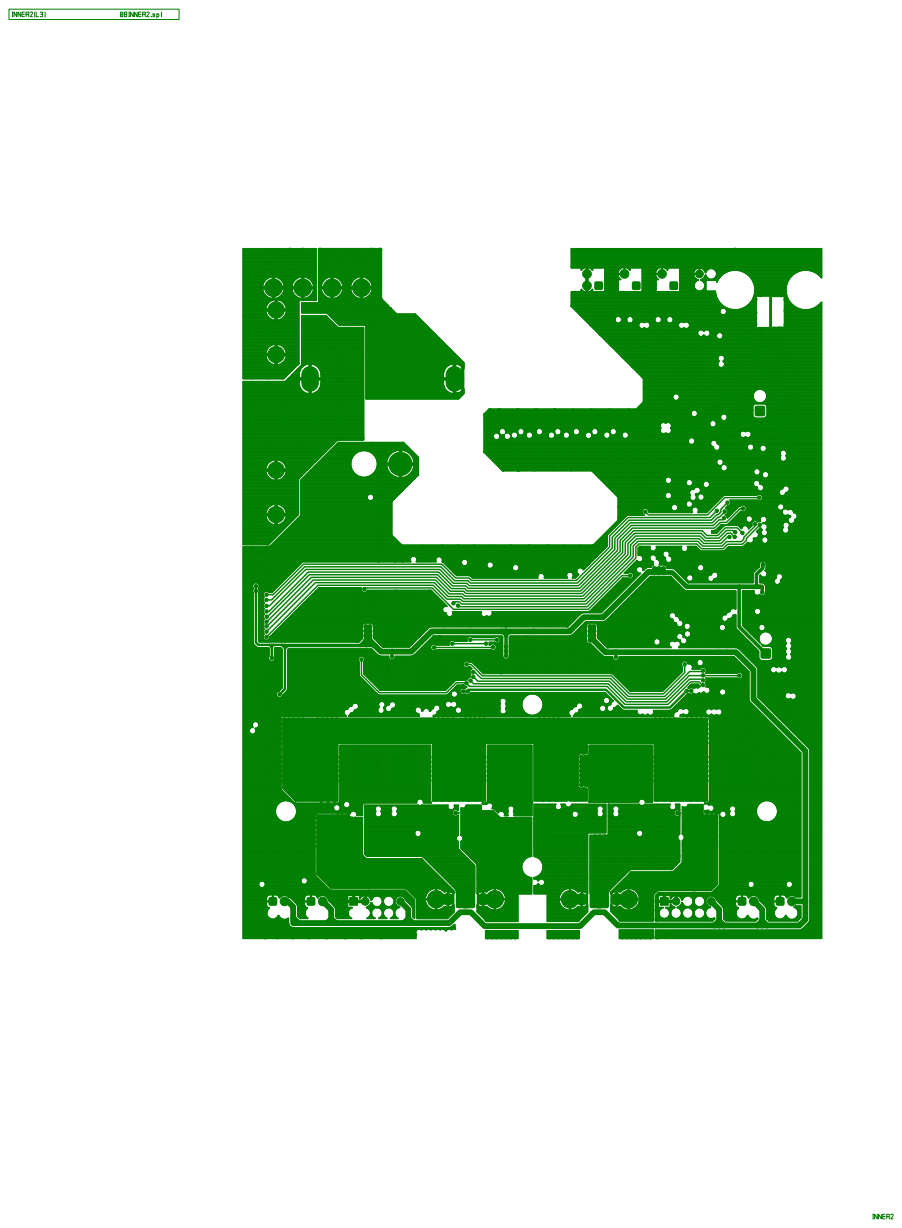
[picture p26: page 4]

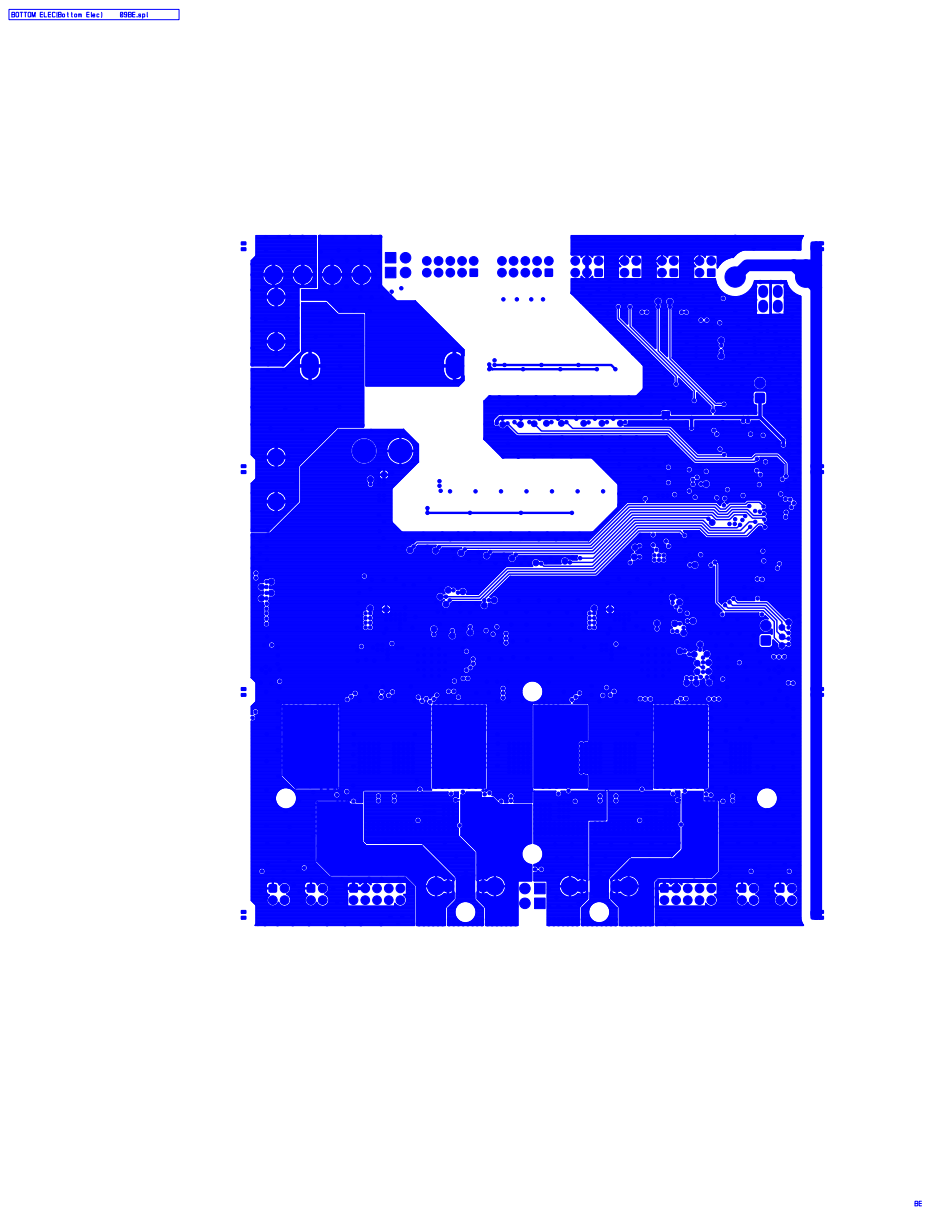
[picture p27: page 5]

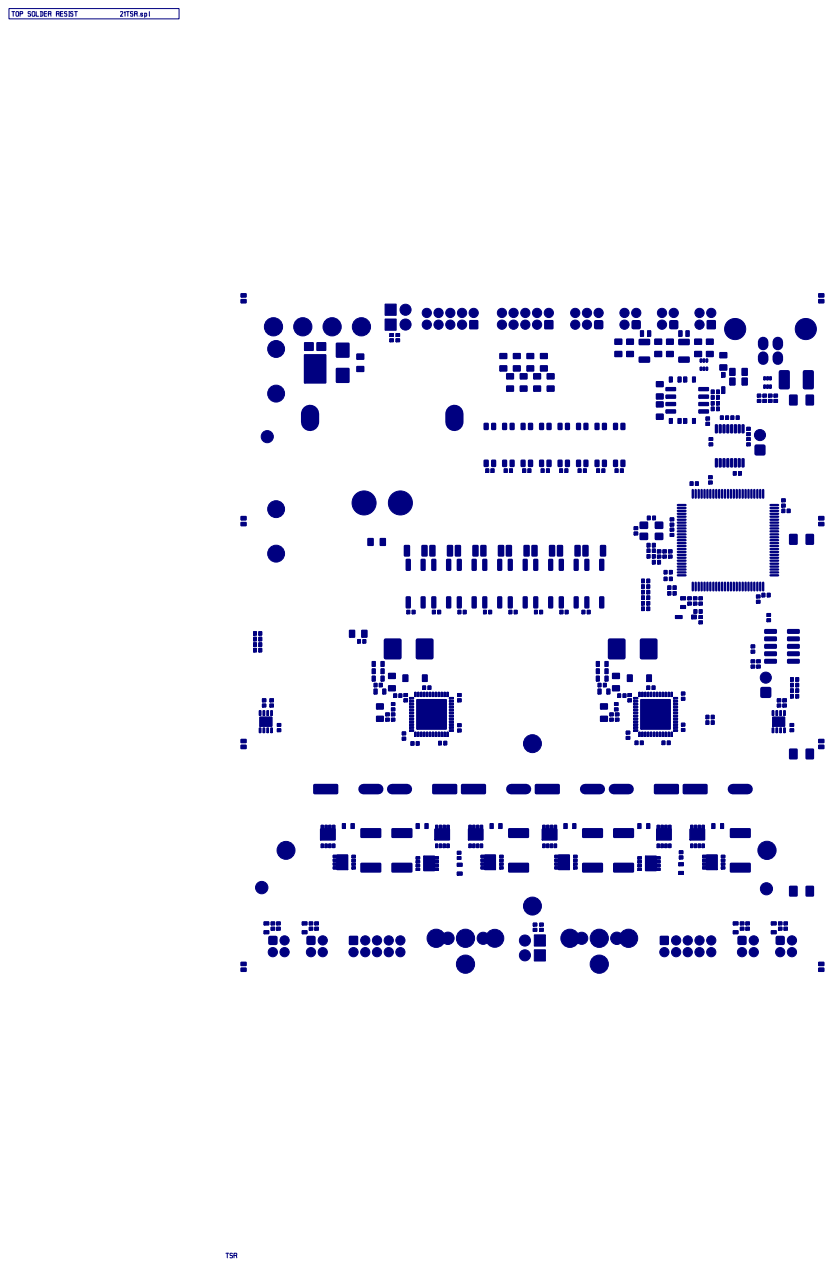
[picture p28: page 6]

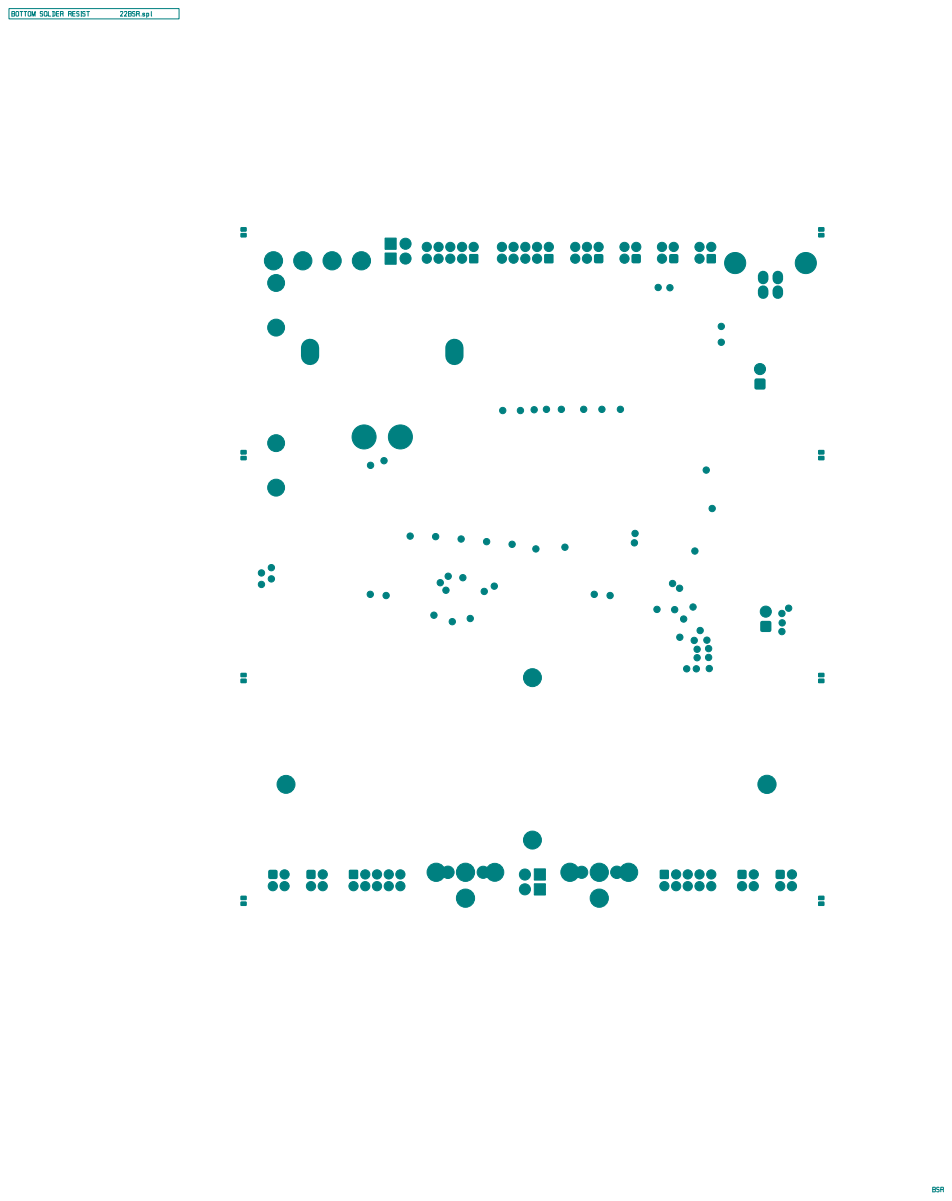
[picture p29: page 7]

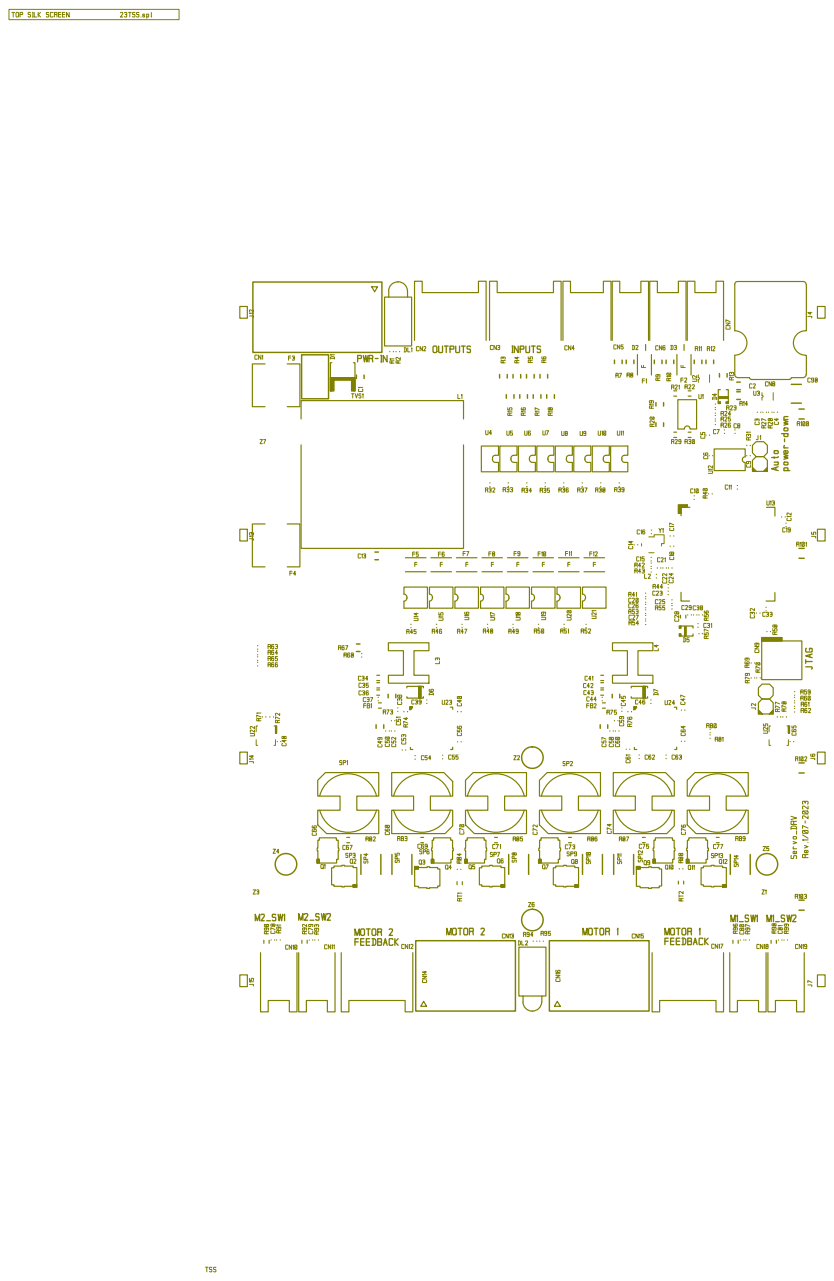
[picture p30: page 8]

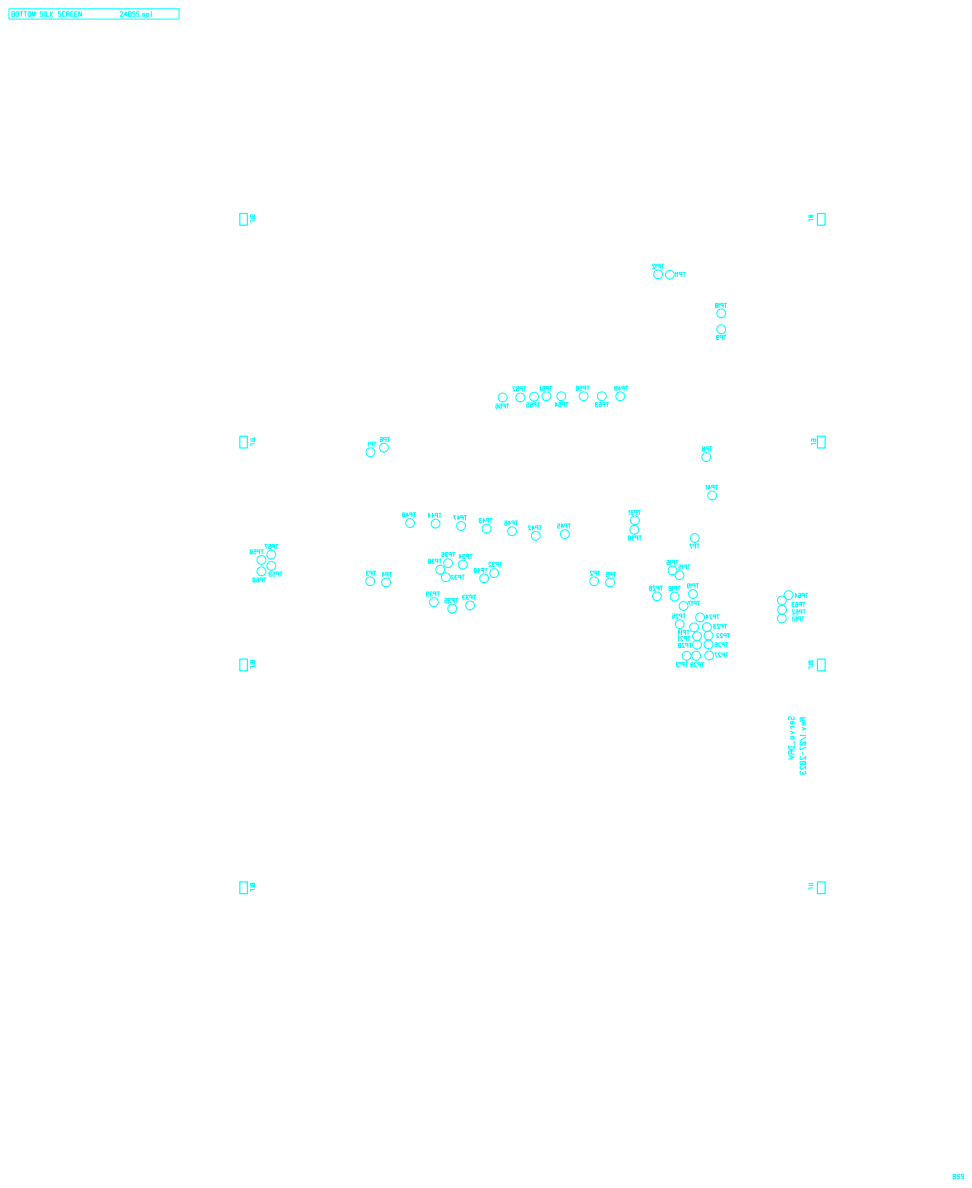
[picture p31: page 9]

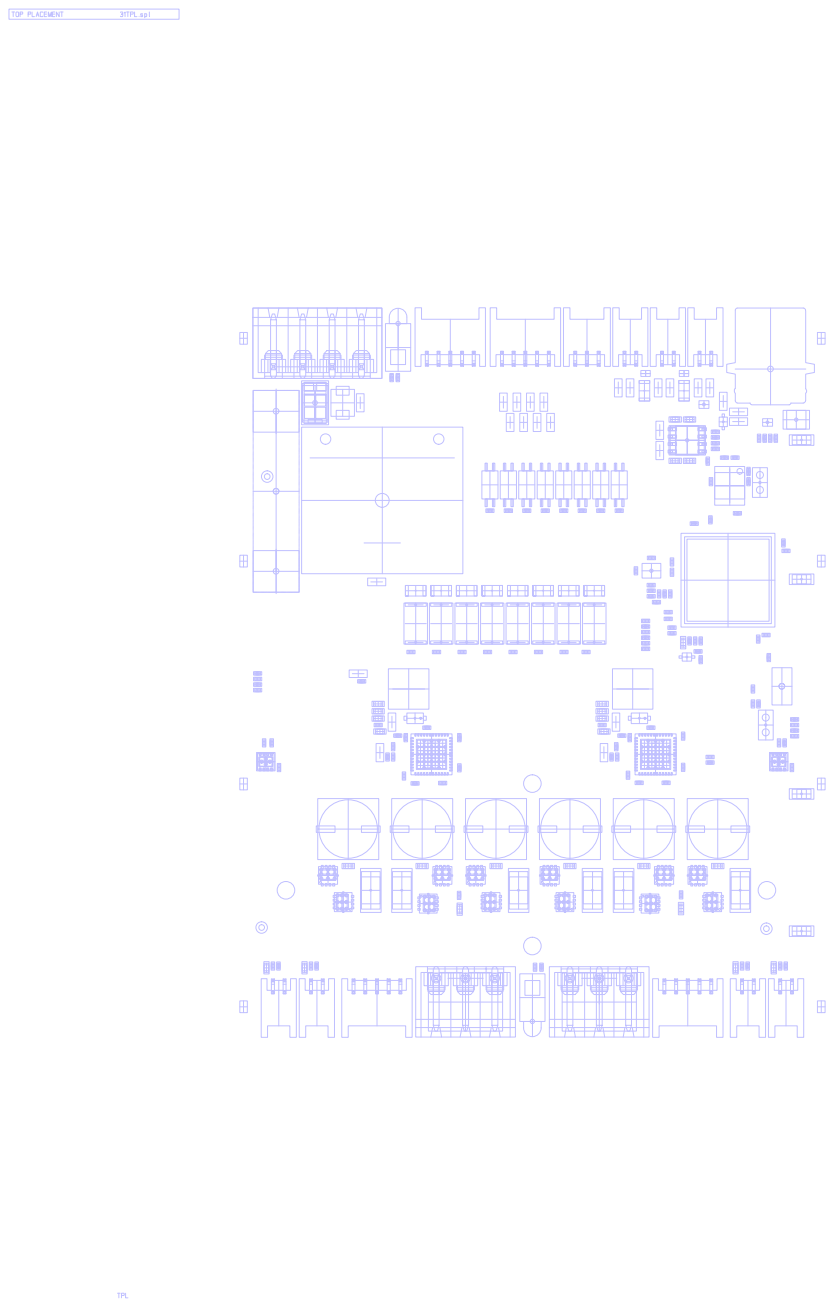
[picture p32: page 11]

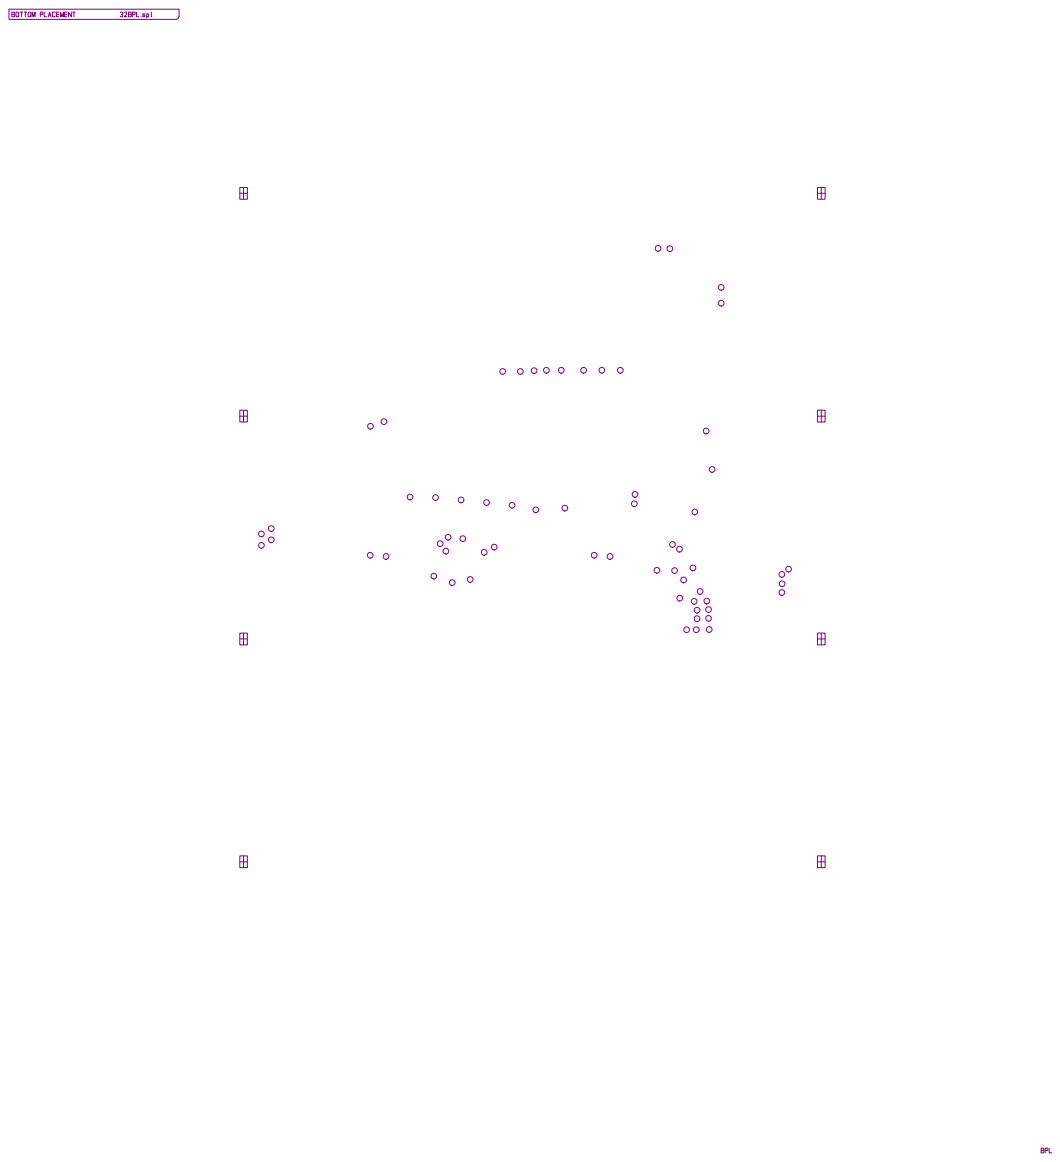
[picture p33: page 12]

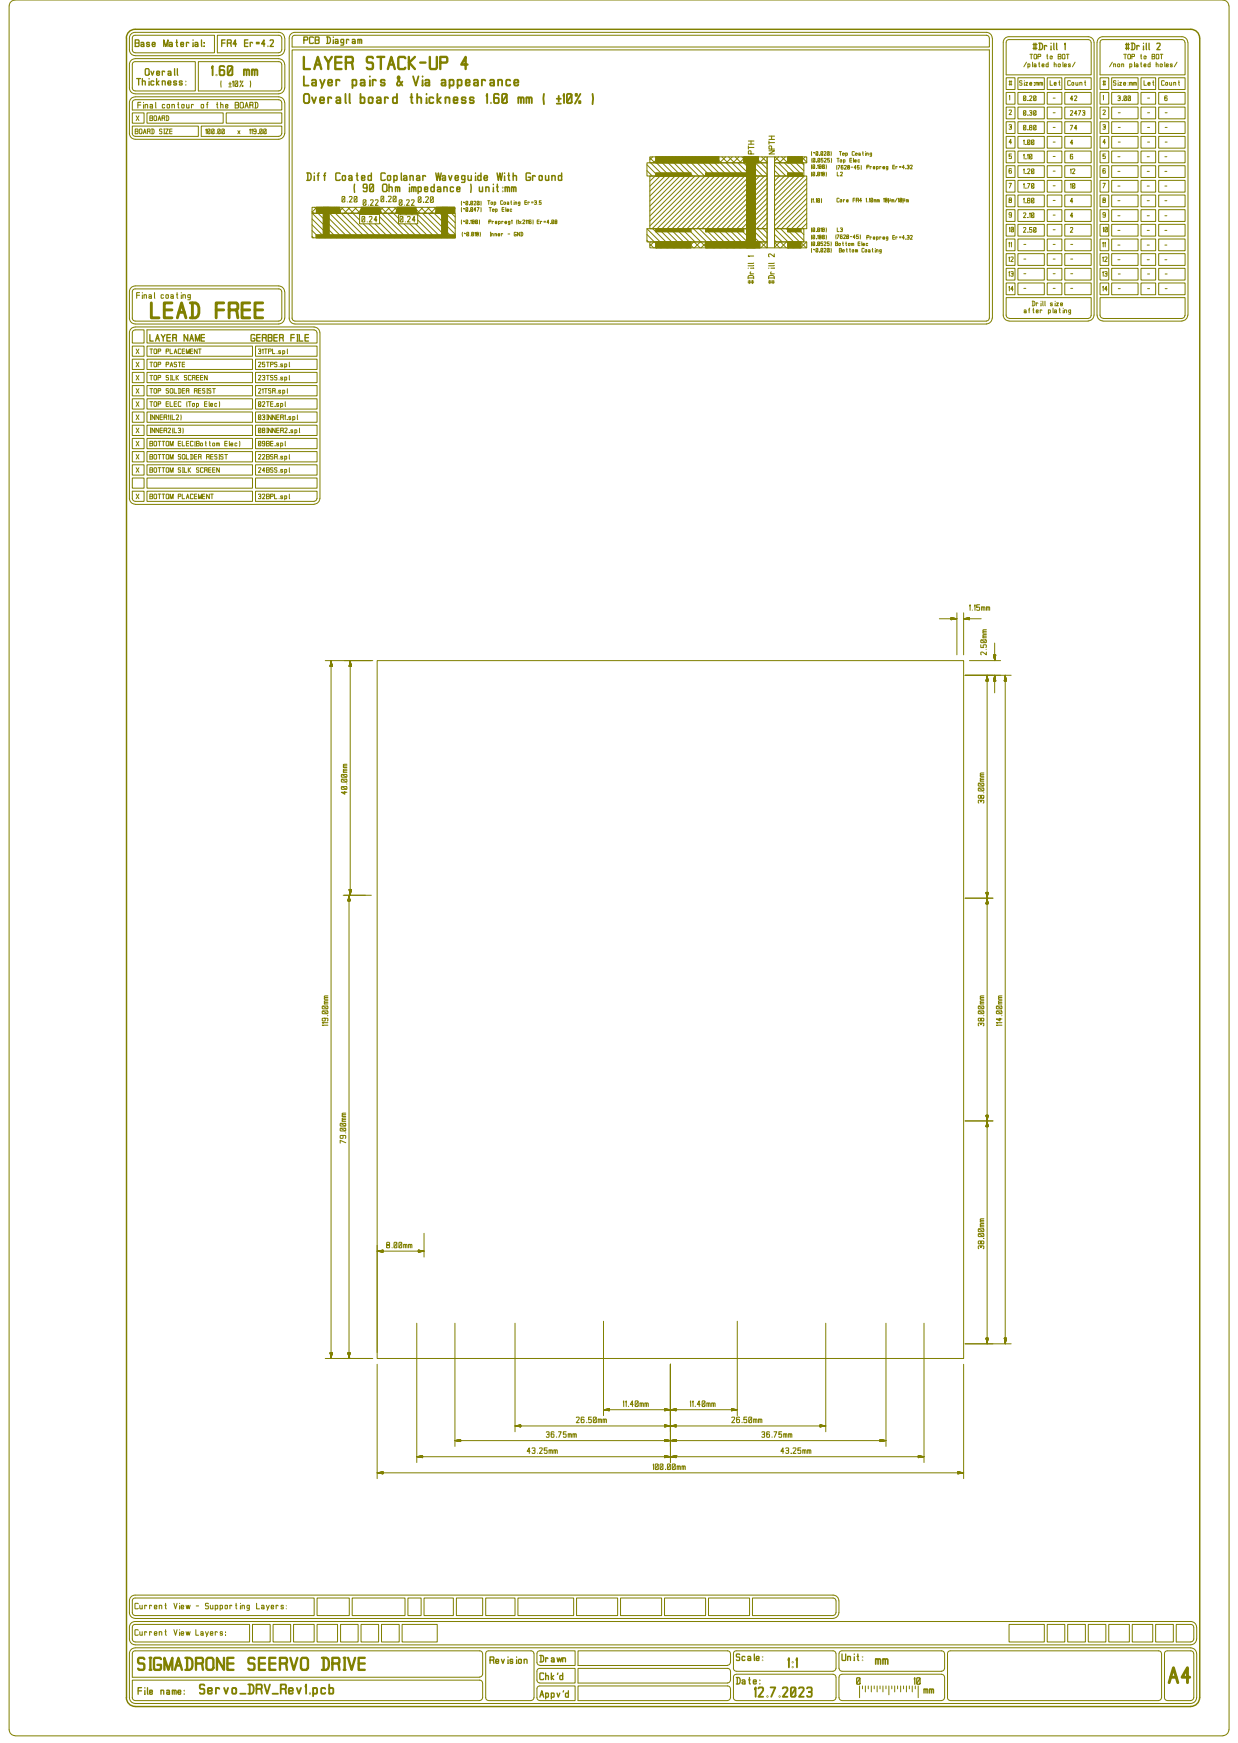
[picture p34: page 13]

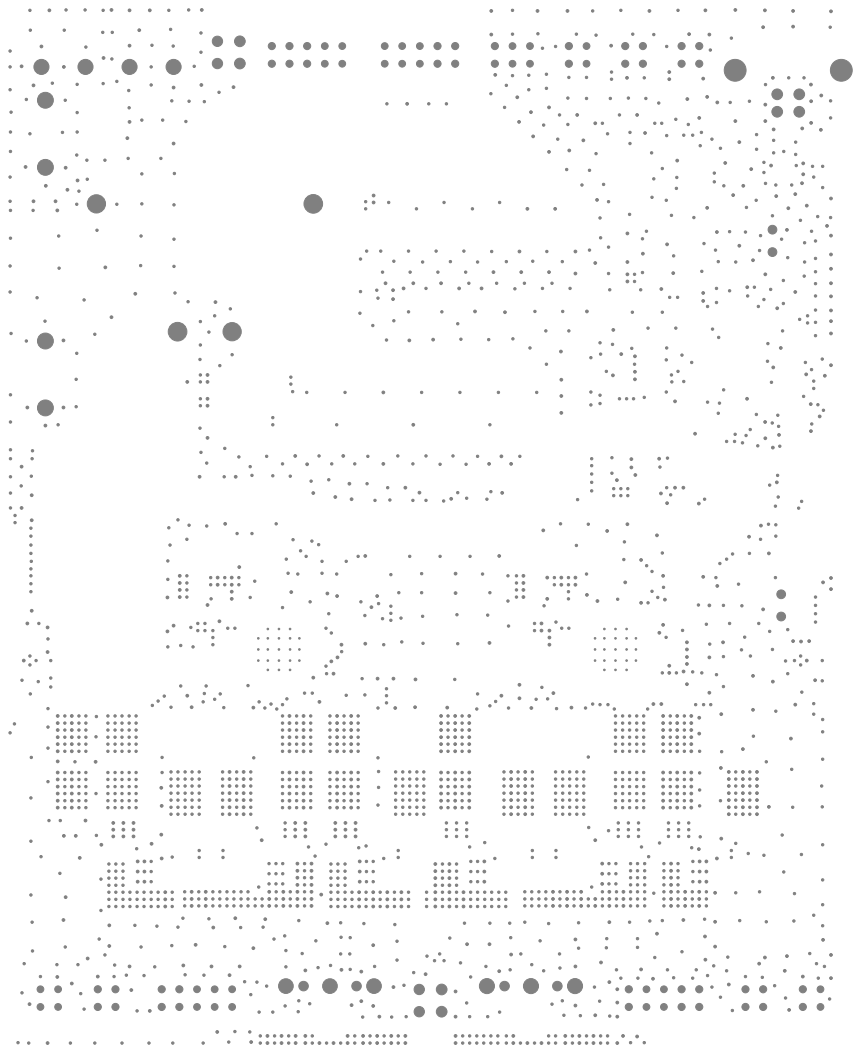
[picture p35: page 14]
