mstoilov/sigmadrone-esc/hardware/zec-rev1/Servo_DRV_Rev1_PCB View.pdf

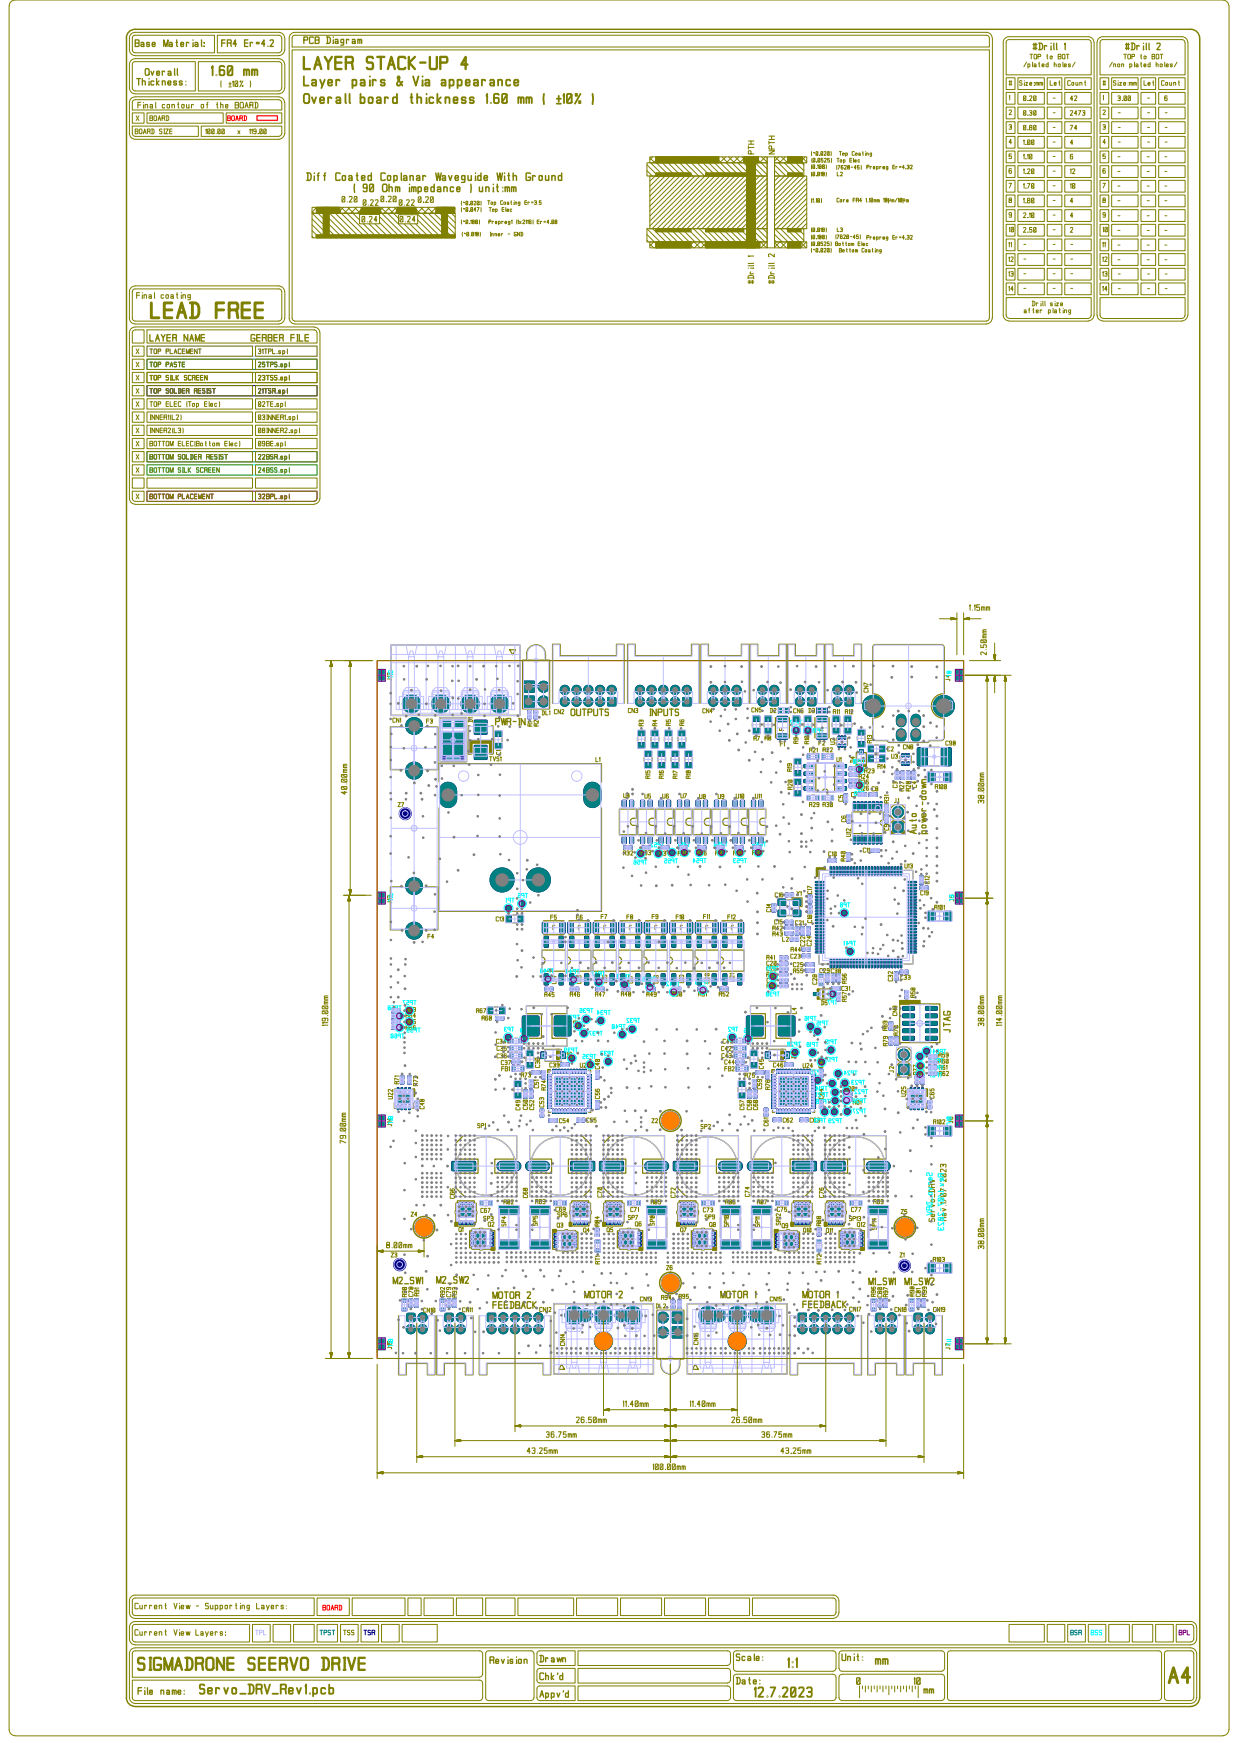
[picture p36: page 1]
