mstoilov/sigmadrone-esc/hardware/zec-rev1/Servo_DRV_Rev1_Top_ASS_P&P.pdf

CN8

CN5 | CN6 R⁹ | R¹⁰

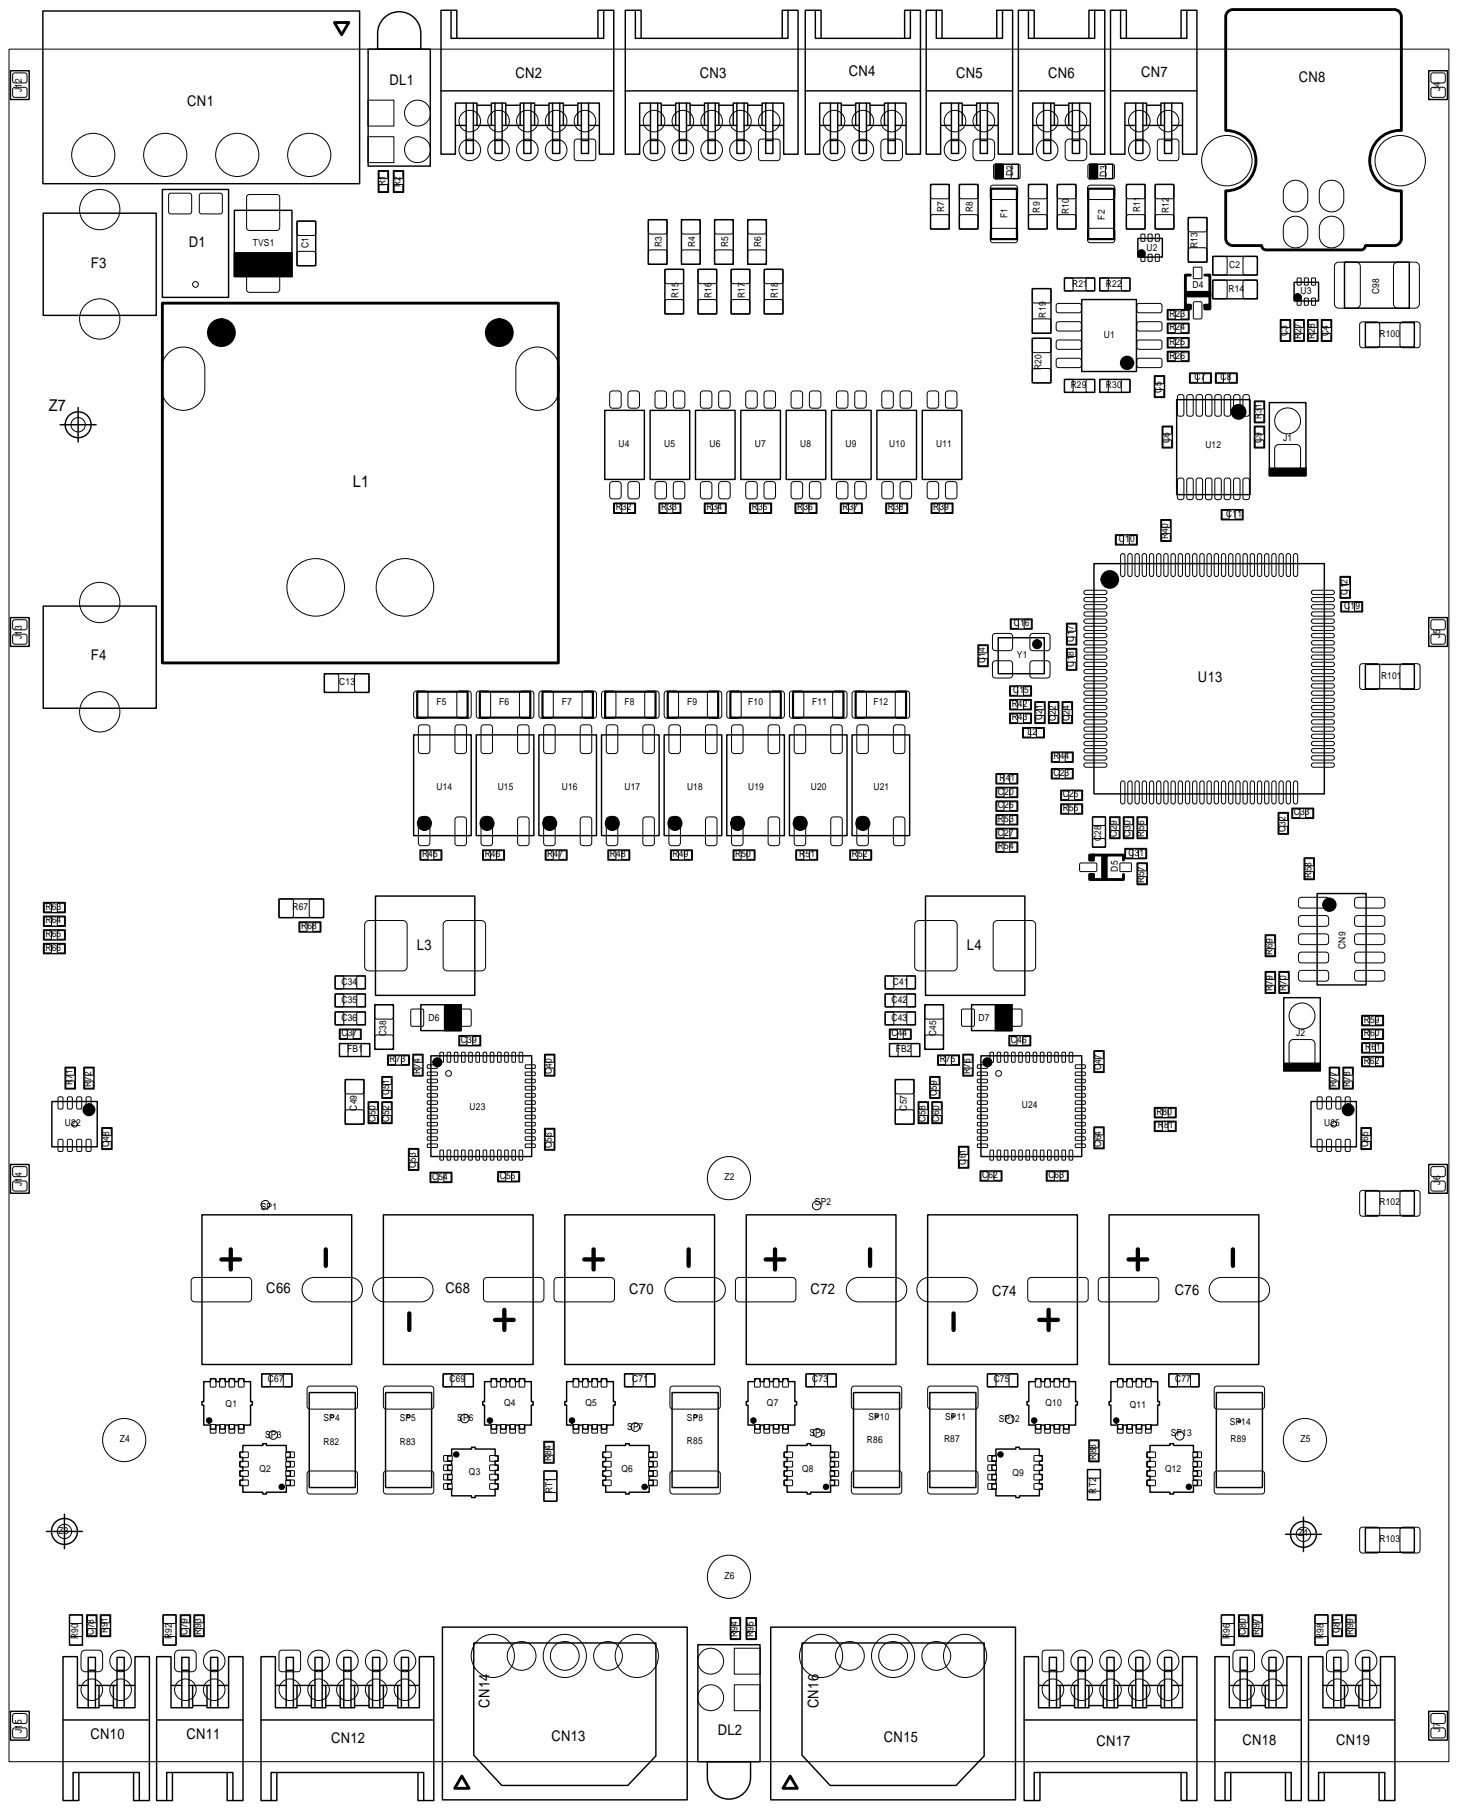
[picture p37: page 1]
