mstoilov/sigmadrone-esc/hardware/zec/SCH - Servo_DRV_Rev1_2023-05-03(1).pdf

# MCU

# MOSFETS M1

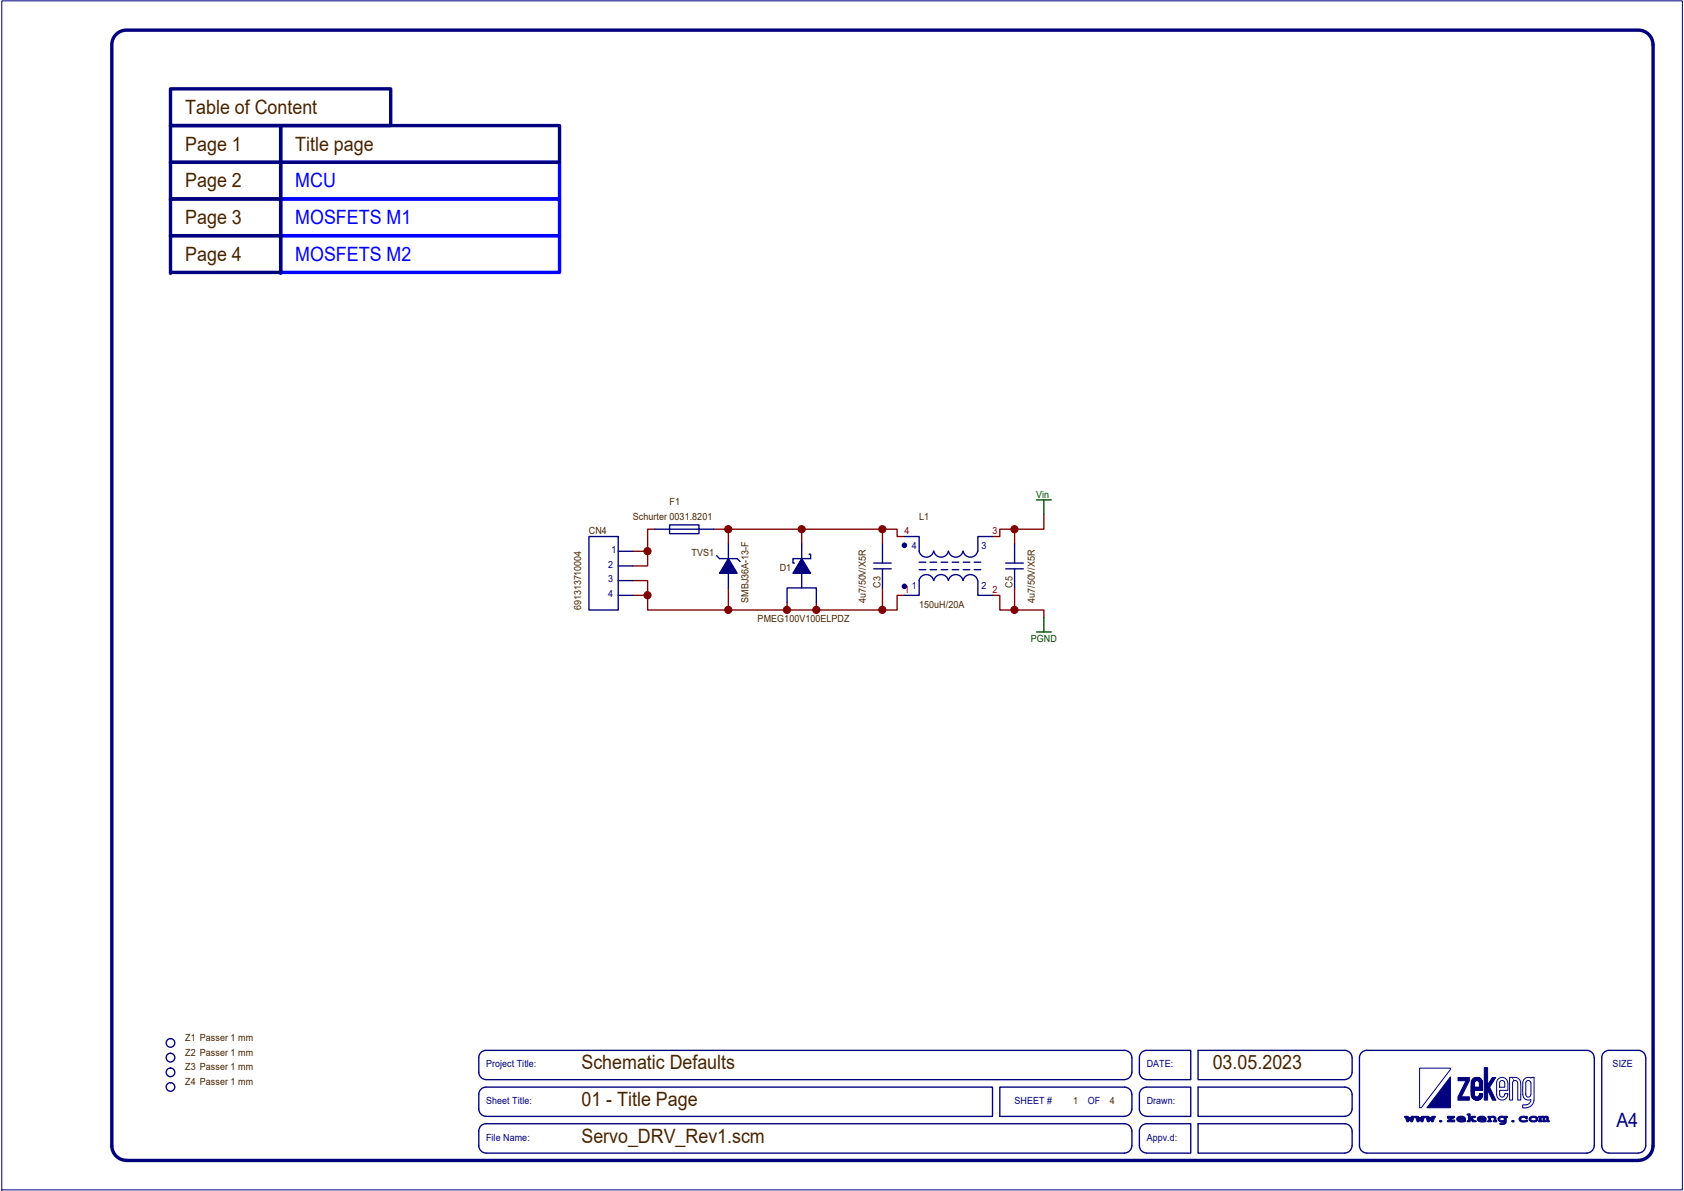
[picture p38: page 1]
MOSFETS M2; DATE:; Drawn:; Appv.d:; SIZE; SHEET #; File Name:; Sheet Title:; Project Title:; PGND; Vin; Z2 Passer 1 mm Z3 Passer 1 mm Z4 Passer 1 mm; Z1 Passer 1 mm; TVS1; SMBJ36A-13-F; F1 Schurter 0031.8201; PMEG100V100ELPDZ; Schematic Defaults; 01 - Title Page; Page 1; Title page; Servo_DRV_Rev1.scm

Table of Content
Page 2
Page 3
Page 4

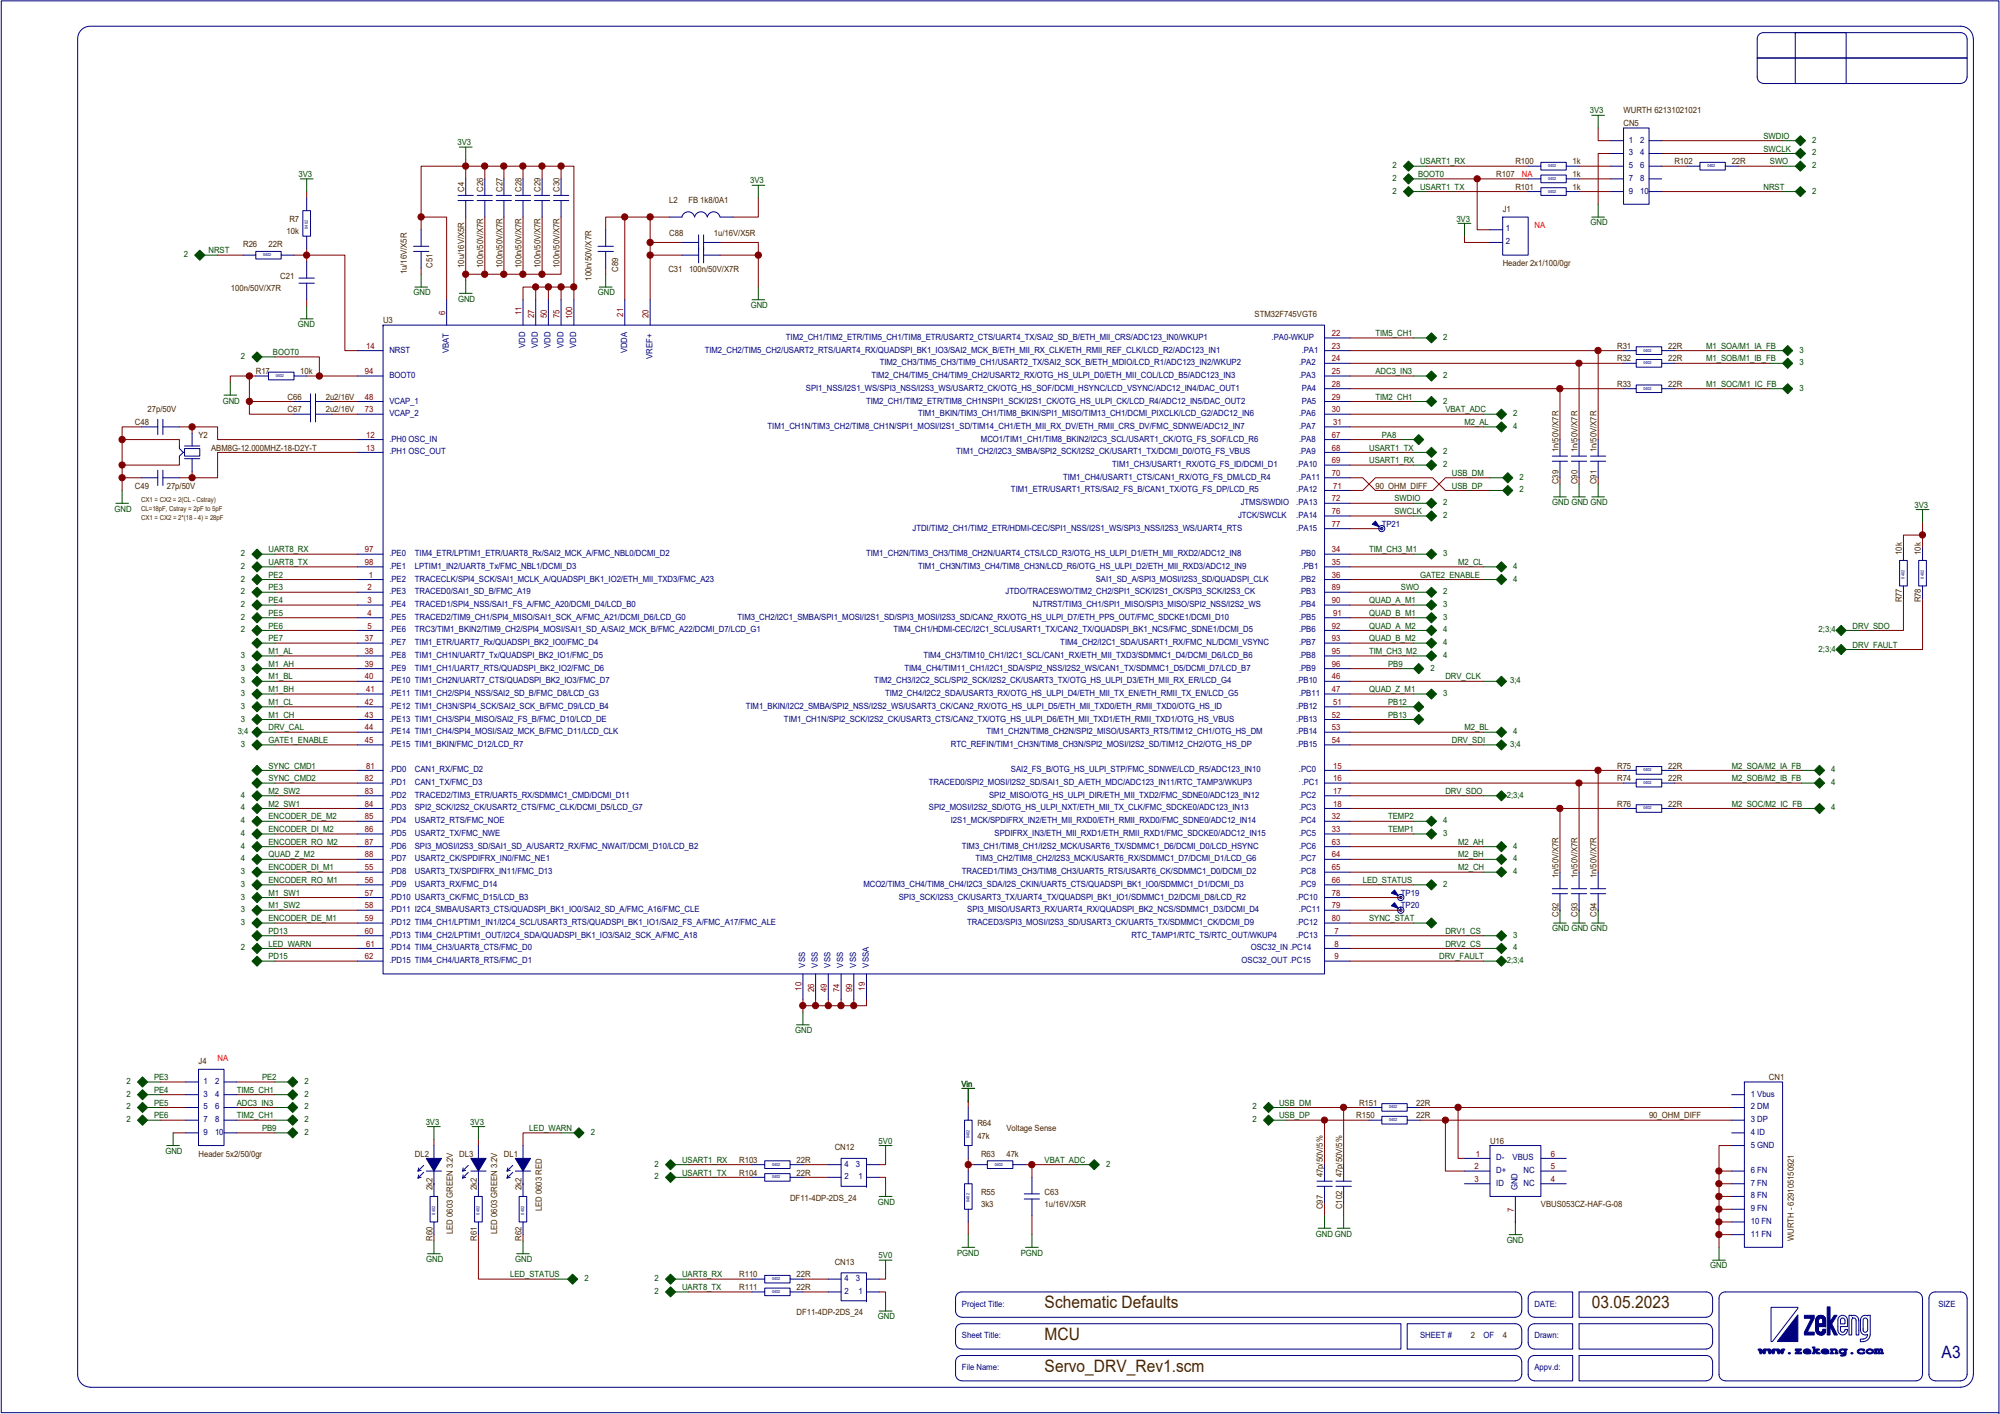
[picture p39: page 2]

## M1_A 3

## M1_B 3

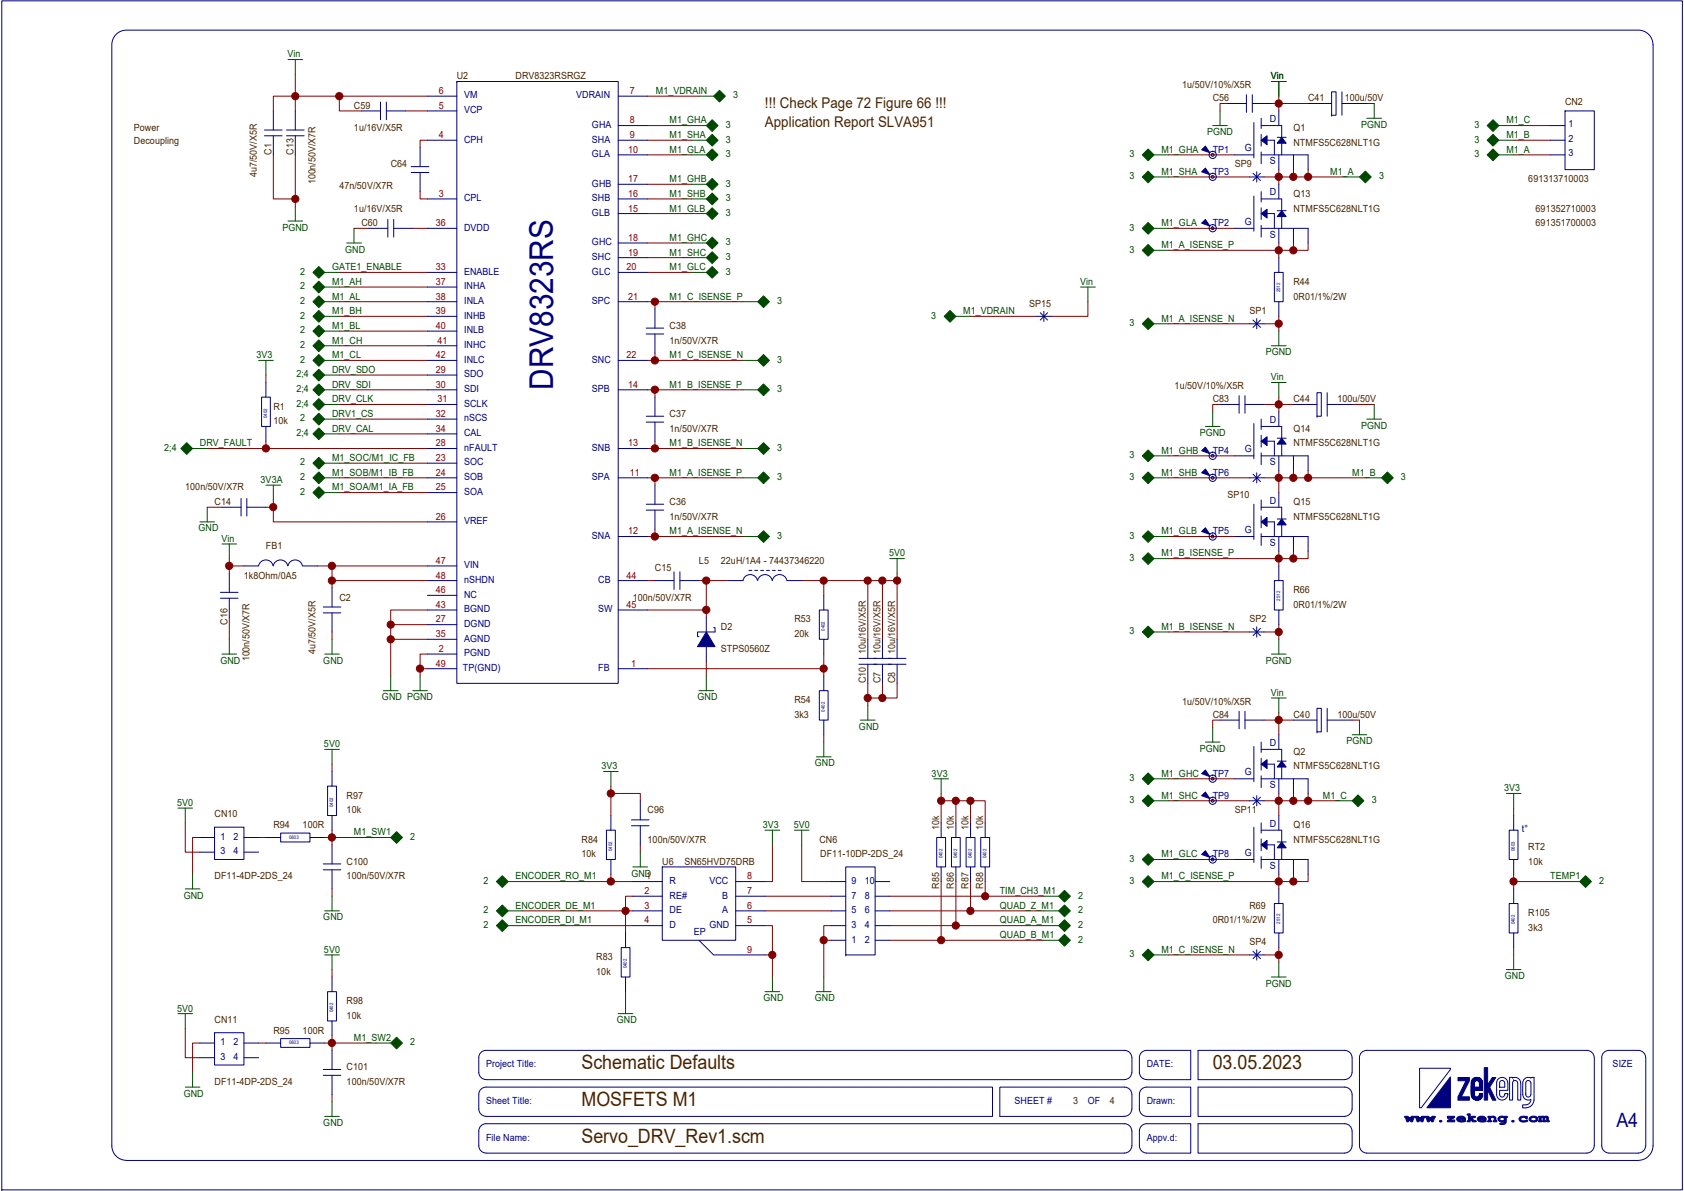
[picture p40: page 3]

## M2_A_ISENSE_P 4

## M2_SHA 4

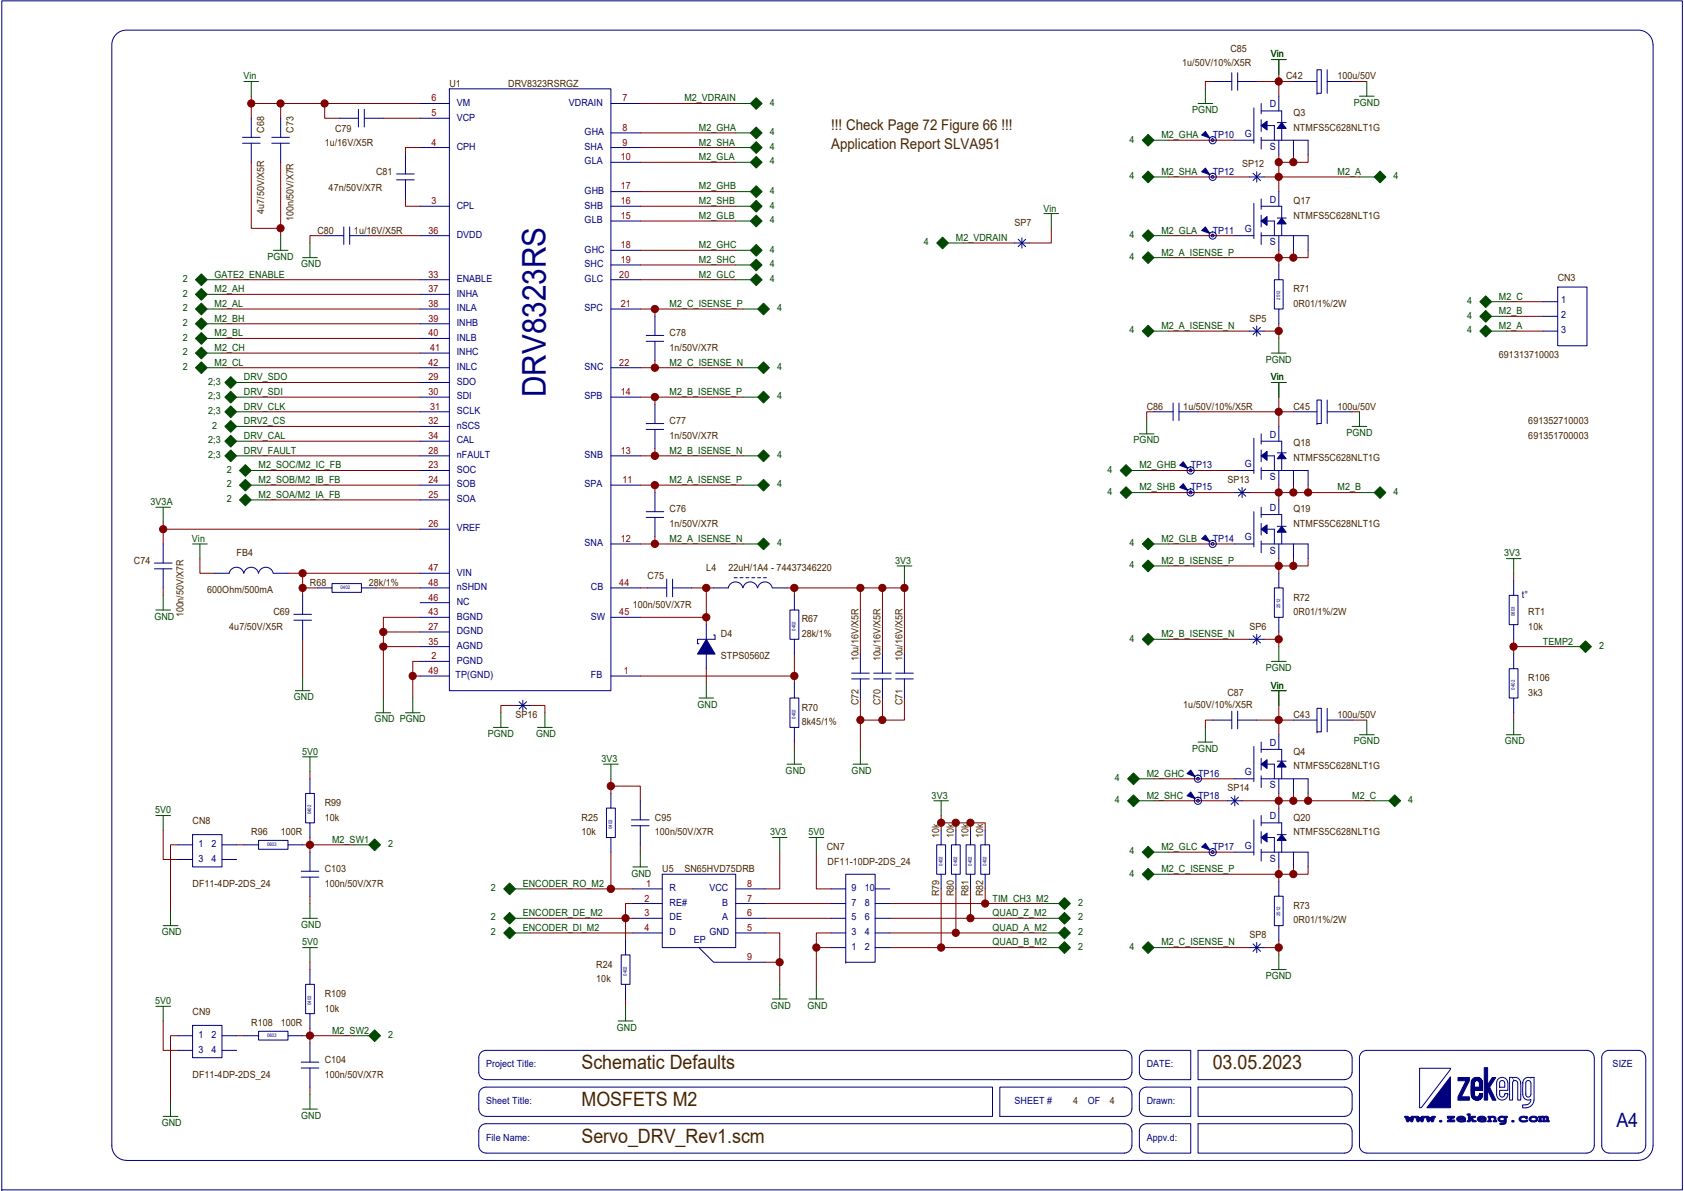
[picture p41: page 4]
