mstoilov/sigmadrone-esc/(list of files, drawings)

Other design files:
hardware/zec-rev1/Servo_DRV_Rev1_Source_FIles/Servo_DRV_Rev1.pcb
