mstoilov/sigmadrone-esc/hardware/sigmadrive-duo/sigmadrive-duo.kicad_pcb

## KiCad design hardware/sigmadrive-duo/sigmadrive-duo.kicad_pcb (2020-09-22)

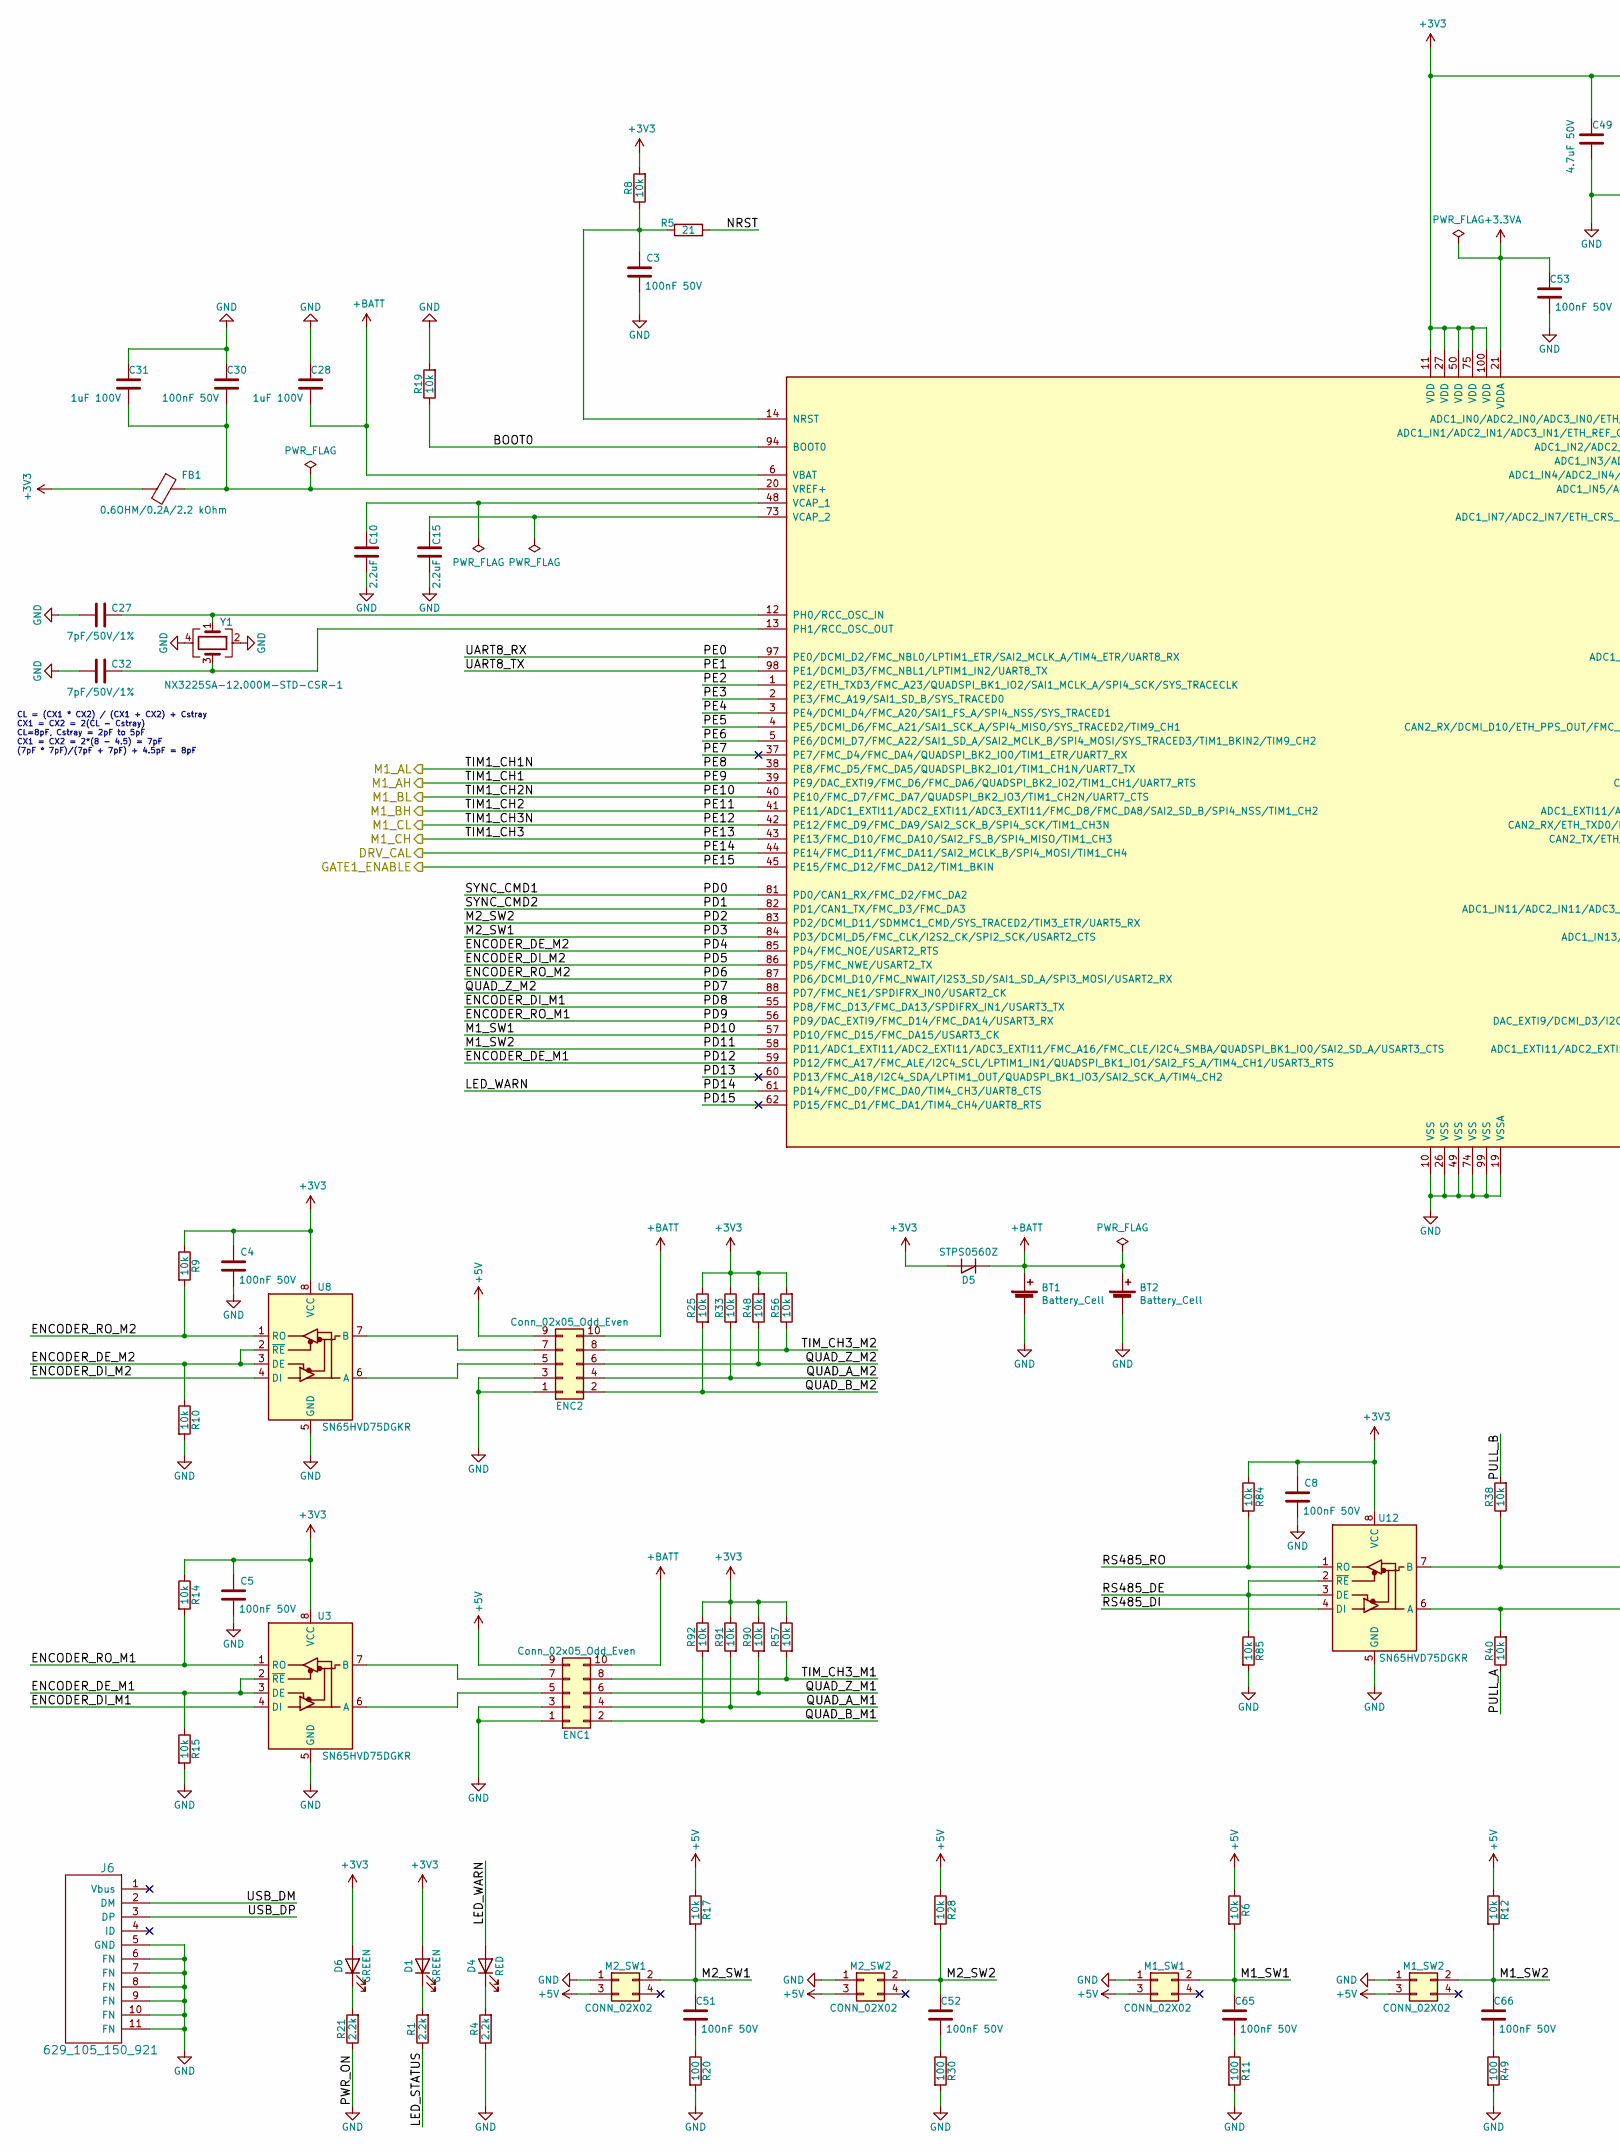
[picture p42: schematic mcu.sch, Servo Driver 48V, part in row 1, column 1]

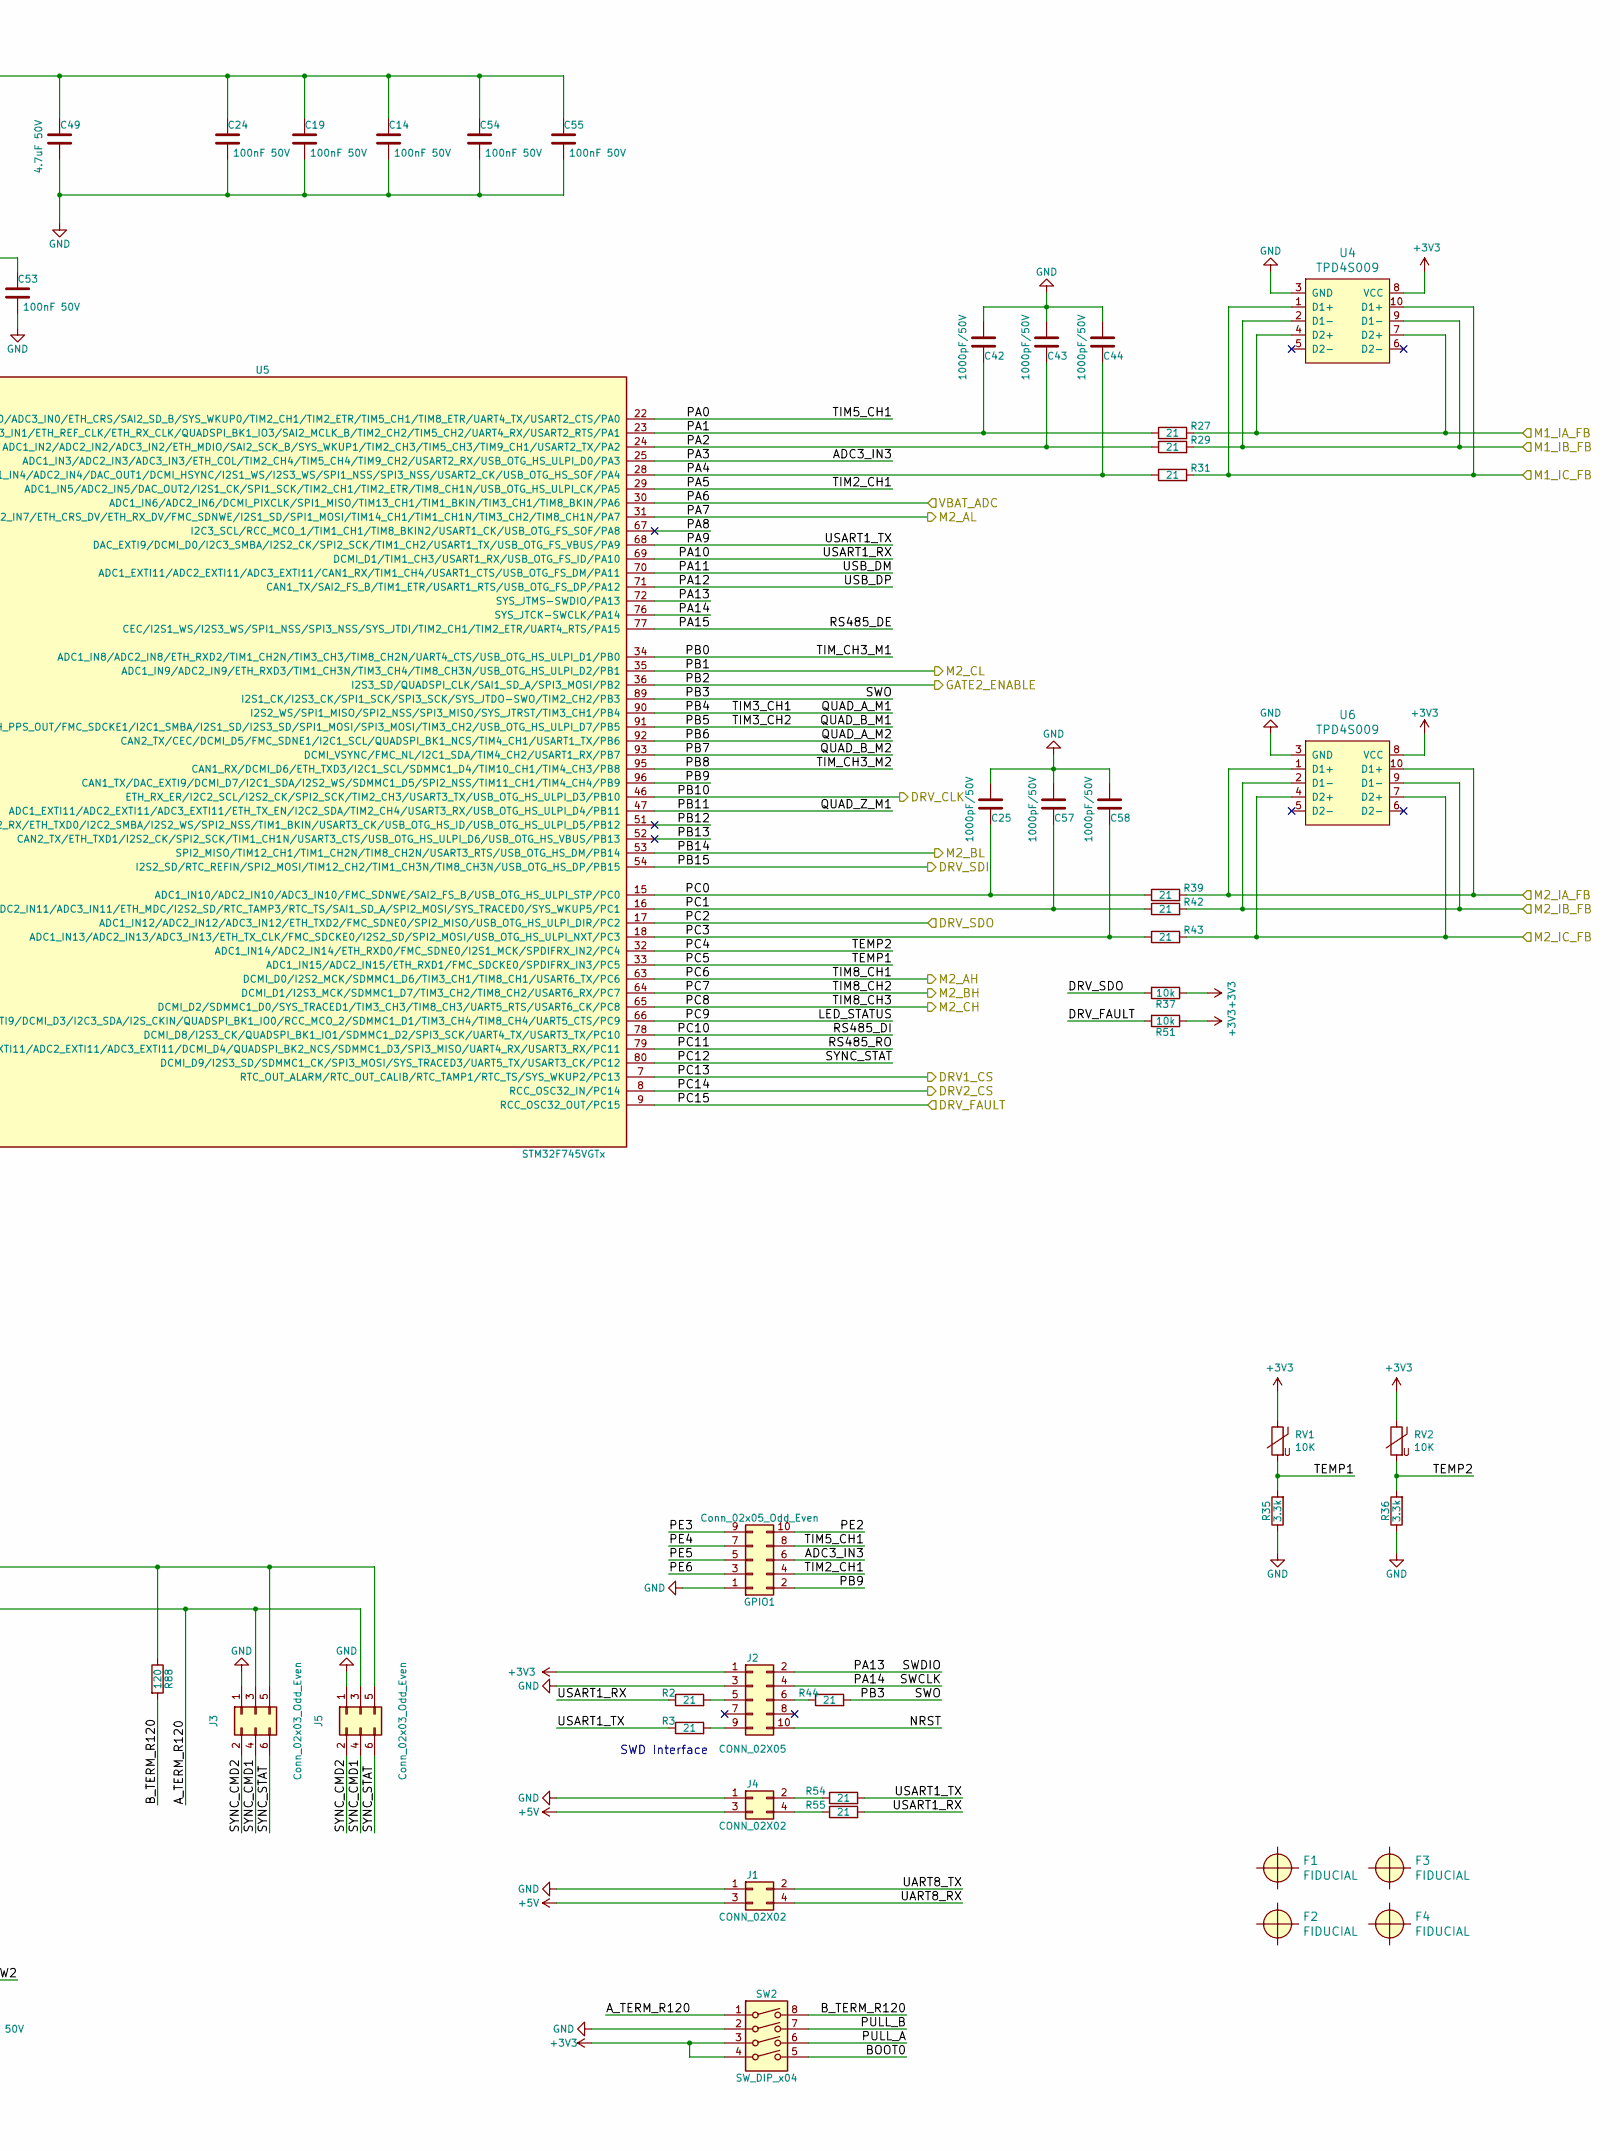
[picture p43: schematic mcu.sch, Servo Driver 48V, part in row 1, column 2]

Parts:
BT1, BT2: Battery_Cell; Battery_Panasonic_CR1220-VCN_Vertical_CircularHoles; Part VL-1220/VCN
C3, C4, C5, C8, C14, C19, C24, C30, C51, C52, C53, C54, C55, C65, C66: 100nF 50V; C_0603_1608Metric; Part 490-4779-2-ND
C10, C15: 2.2uF; C_0603_1608Metric; Part 490-10731-1-ND
C25, C42, C43, C44, C57, C58: 1000pF/50V; C_0603_1608Metric; Part 1276-1091-2-ND
C27, C32: 7pF/50V/1%; C_0603_1608Metric; Part ‎1276-2137-1-ND‎
C28, C31: 1uF 100V; C_0805_2012Metric; Part 445-6804-2-ND
C49: 4.7uF 50V; C_0805_2012Metric; Part 490-10751-2-ND
D1, D6: GREEN; LED_0603_1608Metric; Part 732-4971-1-ND
D4: RED; LED_0603_1608Metric; Part 732-4978-1-ND
D5: STPS0560Z; D_SOD-123; Part 497-3787-1-ND
ENC1, ENC2: Conn_02x05_Odd_Even; PinHeader_2x05_P2.00mm_Horizontal; Part H10247-ND
F1, F2, F3, F4: FIDUCIAL; Fiducial_0.5mm_Dia_1mm_Outer
FB1: 0.6OHM/0.2A/2.2 kOhm; R_0603_1608Metric; Part 732-1609-1-ND
GPIO1: Conn_02x05_Odd_Even; PinHeader_2x05_P2.00mm_Horizontal
J1, J4: CONN_02X02; PinHeader_2x02_P2.00mm_Horizontal; Part 732-5374-ND
J2: CONN_02X05; PinHeader_2x05_P1.27mm_Vertical; Part 732-5374-ND
J3, J5: Conn_02x03_Odd_Even; PinHeader_2x03_P2.00mm_Horizontal; Part H2866-ND
J6: 629_105_150_921; WURTH_629105150921_NO_OVALS; Part 732-5961-1-ND
M1_SW1, M1_SW2, M2_SW1, M2_SW2: CONN_02X02; PinHeader_2x02_P2.00mm_Horizontal; Part H10244-ND
R1, R4, R21: 2.2k; R_0603_1608Metric; Part RMCF0603JT2K20CT-ND
R2, R3, R5, R27, R29, R31, R39, R42, R43, R44, R54, R55: 21; R_0603_1608Metric; Part 311-21.0HRCT-ND
R6, R8, R9, R10, R12, R14, R15, R17, R19, R25, R28, R33, R37, R38, R40, R48, R51, R56, R57, R84, R85, R90, R91, R92: 10k; R_0603_1608Metric; Part 311-10.0KHRCT-ND
R11, R20, R30, R49: 100; R_0603_1608Metric; Part 311-100HRCT-ND
R35, R36: 3.3k; R_0603_1608Metric; Part 311-3.30KHRCT-ND
R88: 120; R_0603_1608Metric; Part 311-100HRCT-ND
RV1, RV2: 10K; R_0603_1608Metric; Part P12014CT-ND
SW2: SW_DIP_x04; SW_DIP_SPSTx04_Slide_Copal_CHS-04A_W5.08mm_P1.27mm_JPin; Part GH7644CT-ND
U3, U8, U12: SN65HVD75DGKR; SOIC-8_3.9x4.9mm_P1.27mm; Part 296-35070-1-ND
U4, U6: TPD4S009; TSSOP-10_3x3mm_P0.5mm; Part 296-24538-1-ND
U5: STM32F745VGTx; LQFP-100_14x14mm_P0.5mm; Part 497-16605-ND
Y1: NX3225SA-12.000M-STD-CSR-1; Crystal_SMD_3225-4Pin_3.2x2.5mm; Part 644-1047-1-ND

Connections:
+3.3VA: C53.2, U5.21 (VDDA); also elsewhere on the board
+5V: ENC1.9, ENC2.9, J1.3, J4.3, M1_SW1.3, M1_SW2.3, M2_SW1.3, M2_SW2.3, R6.1, R12.1, R17.1, R28.1; also elsewhere on the board
+BATT: BT1.1 (+), BT2.1 (+), C28.1, D5.1 (K), ENC1.10, ENC2.10, U5.6 (VBAT)
/MCU/ADC3_IN3: GPIO1.6, U5.25 (ADC1_IN3/ADC2_IN3/ADC3_IN3/ETH_COL/TIM2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)
/MCU/A_TERM_R120: J3.3, J5.3, R40.2, SW2.1, U12.6 (A)
/MCU/BOOT0: R19.1, SW2.5, U5.94 (BOOT0)
/MCU/B_TERM_R120: R88.2, SW2.8
/MCU/DRV1_CS: U5.7 (RTC_OUT_ALARM/RTC_OUT_CALIB/RTC_TAMP1/R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); also elsewhere on the board
/MCU/DRV2_CS: U5.8 (RCC_OSC32_IN/PC14); also elsewhere on the board
/MCU/DRV_CAL: U5.44 (PE14/FMC_D11/FMC_DA11/SAI2_MCLK_B/SPI4_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); also elsewhere on the board
/MCU/DRV_CLK: U5.46 (ETH_RX_ER/I2C2_SCL/I2S2_CK/SPI2_SCK/TIM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); also elsewhere on the board
/MCU/DRV_FAULT: R51.2, U5.9 (RCC_OSC32_OUT/PC15); also elsewhere on the board
/MCU/DRV_SDI: U5.54 (I2S2_SD/RTC_REFIN/SPI2_MOSI/TIM12_CH2/T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); also elsewhere on the board
/MCU/DRV_SDO: R37.2, U5.17 (ADC1_IN12/ADC2_IN12/ADC3_IN12/ETH_TXD2/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); also elsewhere on the board
/MCU/ENCODER_DE_M1: R15.1, U3.2 (~RE), U3.3 (DE), U5.59 (PD12/FMC_A17/FMC_ALE/I2C4_SCL/LPTIM1_IN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)
/MCU/ENCODER_DE_M2: R10.1, U5.85 (PD4/FMC_NOE/USART2_RTS), U8.2 (~RE), U8.3 (DE)
/MCU/ENCODER_DI_M1: U3.4 (DI), U5.55 (PD8/FMC_D13/FMC_DA13/SPDIFRX_IN1/USART3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)
/MCU/ENCODER_DI_M2: U5.86 (PD5/FMC_NWE/USART2_TX), U8.4 (DI)
/MCU/ENCODER_RO_M1: R14.2, U3.1 (RO), U5.56 (PD9/DAC_EXTI9/FMC_D14/FMC_DA14/USART3_RX)
/MCU/ENCODER_RO_M2: R9.2, U5.87 (PD6/DCMI_D10/FMC_NWAIT/I2S3_SD/SAI1_SD_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), U8.1 (RO)
/MCU/GATE1_ENABLE: U5.45 (PE15/FMC_D12/FMC_DA12/TIM1_BKIN); also elsewhere on the board
/MCU/GATE2_ENABLE: U5.36 (I2S3_SD/QUADSPI_CLK/SAI1_SD_A/SPI3_MOSI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); also elsewhere on the board
/MCU/LED_STATUS: R1.1, U5.66 (DAC_EXTI9/DCMI_D3/I2C3_SDA/I2S_CKIN/QUA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)
/MCU/LED_WARN: D4.2 (A), U5.61 (PD14/FMC_D0/FMC_DA0/TIM4_CH3/UART8_CTS)
/MCU/M1_AH: U5.39 (PE9/DAC_EXTI9/FMC_D6/FMC_DA6/QUADSPI_BK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); also elsewhere on the board
/MCU/M1_AL: U5.38 (PE8/FMC_D5/FMC_DA5/QUADSPI_BK2_IO1/TIM1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); also elsewhere on the board
/MCU/M1_BH: U5.41 (PE11/ADC1_EXTI11/ADC2_EXTI11/ADC3_EXTI1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); also elsewhere on the board
/MCU/M1_BL: U5.40 (PE10/FMC_D7/FMC_DA7/QUADSPI_BK2_IO3/TIM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); also elsewhere on the board
/MCU/M1_CH: U5.43 (PE13/FMC_D10/FMC_DA10/SAI2_FS_B/SPI4_MI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); also elsewhere on the board
/MCU/M1_CL: U5.42 (PE12/FMC_D9/FMC_DA9/SAI2_SCK_B/SPI4_SCK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); also elsewhere on the board
/MCU/M1_IA_FB: R27.2, U4.4 (D2+), U4.7 (D2+); also elsewhere on the board
/MCU/M1_IB_FB: R29.2, U4.2 (D1-), U4.9 (D1-); also elsewhere on the board
/MCU/M1_IC_FB: R31.2, U4.1 (D1+), U4.10 (D1+); also elsewhere on the board
/MCU/M1_SW1: C65.2, M1_SW1.2, R6.2, U5.57 (PD10/FMC_D15/FMC_DA15/USART3_CK)
/MCU/M1_SW2: C66.2, M1_SW2.2, R12.2, U5.58 (PD11/ADC1_EXTI11/ADC2_EXTI11/ADC3_EXTI1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)
/MCU/M2_AH: U5.63 (DCMI_D0/I2S2_MCK/SDMMC1_D6/TIM3_CH1/TIM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); also elsewhere on the board
/MCU/M2_AL: U5.31 (ADC1_IN7/ADC2_IN7/ETH_CRS_DV/ETH_RX_DV/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); also elsewhere on the board
/MCU/M2_BH: U5.64 (DCMI_D1/I2S3_MCK/SDMMC1_D7/TIM3_CH2/TIM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); also elsewhere on the board
/MCU/M2_BL: U5.53 (SPI2_MISO/TIM12_CH1/TIM1_CH2N/TIM8_CH2N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); also elsewhere on the board
/MCU/M2_CH: U5.65 (DCMI_D2/SDMMC1_D0/SYS_TRACED1/TIM3_CH3/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); also elsewhere on the board
/MCU/M2_CL: U5.35 (ADC1_IN9/ADC2_IN9/ETH_RXD3/TIM1_CH3N/TI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); also elsewhere on the board
/MCU/M2_IA_FB: R39.2, U6.1 (D1+), U6.10 (D1+); also elsewhere on the board
/MCU/M2_IB_FB: R42.2, U6.2 (D1-), U6.9 (D1-); also elsewhere on the board
/MCU/M2_IC_FB: R43.2, U6.4 (D2+), U6.7 (D2+); also elsewhere on the board
/MCU/M2_SW1: C51.2, M2_SW1.2, R17.2, U5.84 (PD3/DCMI_D5/FMC_CLK/I2S2_CK/SPI2_SCK/US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)
/MCU/M2_SW2: C52.2, M2_SW2.2, R28.2, U5.83 (PD2/DCMI_D11/SDMMC1_CMD/SYS_TRACED2/TIM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)
/MCU/NRST: J2.10, R5.2
/MCU/PA0: GPIO1.8, U5.22 (ADC1_IN0/ADC2_IN0/ADC3_IN0/ETH_CRS/SAI2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)
/MCU/PA1: C42.1, R27.1, U5.23 (ADC1_IN1/ADC2_IN1/ADC3_IN1/ETH_REF_CLK/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)
/MCU/PA2: C43.1, R29.1, U5.24 (ADC1_IN2/ADC2_IN2/ADC3_IN2/ETH_MDIO/SAI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)
/MCU/PA4: C44.1, R31.1, U5.28 (ADC1_IN4/ADC2_IN4/DAC_OUT1/DCMI_HSYNC/I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)
/MCU/PA5: GPIO1.4, U5.29 (ADC1_IN5/ADC2_IN5/DAC_OUT2/I2S1_CK/SPI1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)
/MCU/PA8: U5.67 (I2C3_SCL/RCC_MCO_1/TIM1_CH1/TIM8_BKIN2/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)
/MCU/PA9: R3.1, R54.2, U5.68 (DAC_EXTI9/DCMI_D0/I2C3_SMBA/I2S2_CK/SPI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)
/MCU/PA10: R2.1, R55.2, U5.69 (DCMI_D1/TIM1_CH3/USART1_RX/USB_OTG_FS_I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)
/MCU/PA11: J6.2 (DM), U5.70 (ADC1_EXTI11/ADC2_EXTI11/ADC3_EXTI11/CAN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)
/MCU/PA12: J6.3 (DP), U5.71 (CAN1_TX/SAI2_FS_B/TIM1_ETR/USART1_RTS/U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)
/MCU/PA13: J2.2, U5.72 (SYS_JTMS-SWDIO/PA13)
/MCU/PA14: J2.4, U5.76 (SYS_JTCK-SWCLK/PA14)
/MCU/PA15: R85.1, U5.77 (CEC/I2S1_WS/I2S3_WS/SPI1_NSS/SPI3_NSS/S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), U12.2 (~RE), U12.3 (DE)
/MCU/PB0: ENC1.8, R57.2, U5.34 (ADC1_IN8/ADC2_IN8/ETH_RXD2/TIM1_CH2N/TI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)
/MCU/PB3: R44.2, U5.89 (I2S1_CK/I2S3_CK/SPI1_SCK/SPI3_SCK/SYS_J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)
/MCU/PB4: ENC1.4, R91.2, U5.90 (I2S2_WS/SPI1_MISO/SPI2_NSS/SPI3_MISO/SY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)
/MCU/PB5: ENC1.2, R92.2, U5.91 (CAN2_RX/DCMI_D10/ETH_PPS_OUT/FMC_SDCKE1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)
/MCU/PB6: ENC2.4, R33.2, U5.92 (CAN2_TX/CEC/DCMI_D5/FMC_SDNE1/I2C1_SCL/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)
/MCU/PB7: ENC2.2, R25.2, U5.93 (DCMI_VSYNC/FMC_NL/I2C1_SDA/TIM4_CH2/USA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)
/MCU/PB8: ENC2.8, R56.1, U5.95 (CAN1_RX/DCMI_D6/ETH_TXD3/I2C1_SCL/SDMMC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)
/MCU/PB9: GPIO1.2, U5.96 (CAN1_TX/DAC_EXTI9/DCMI_D7/I2C1_SDA/I2S2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)
/MCU/PB11: ENC1.6, R90.2, U5.47 (ADC1_EXTI11/ADC2_EXTI11/ADC3_EXTI11/ETH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)
/MCU/PB12: U5.51 (CAN2_RX/ETH_TXD0/I2C2_SMBA/I2S2_WS/SPI2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)
/MCU/PB13: U5.52 (CAN2_TX/ETH_TXD1/I2S2_CK/SPI2_SCK/TIM1_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)
/MCU/PC0: C25.1, R39.1, U5.15 (ADC1_IN10/ADC2_IN10/ADC3_IN10/FMC_SDNWE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)
/MCU/PC1: C57.1, R42.1, U5.16 (ADC1_IN11/ADC2_IN11/ADC3_IN11/ETH_MDC/I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)
/MCU/PC3: C58.1, R43.1, U5.18 (ADC1_IN13/ADC2_IN13/ADC3_IN13/ETH_TX_CL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)
/MCU/PC4: R36.2, RV2.2, U5.32 (ADC1_IN14/ADC2_IN14/ETH_RXD0/FMC_SDNE0/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)
/MCU/PC5: R35.2, RV1.2, U5.33 (ADC1_IN15/ADC2_IN15/ETH_RXD1/FMC_SDCKE0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)
/MCU/PC10: U5.78 (DCMI_D8/I2S3_CK/QUADSPI_BK1_IO1/SDMMC1_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), U12.4 (DI)
/MCU/PC11: R84.2, U5.79 (ADC1_EXTI11/ADC2_EXTI11/ADC3_EXTI11/DCM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), U12.1 (RO)
/MCU/PC12: J3.6, J5.6, U5.80 (DCMI_D9/I2S3_SD/SDMMC1_CK/SPI3_MOSI/SYS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)
/MCU/PD0: J3.4, J5.4, U5.81 (PD0/CAN1_RX/FMC_D2/FMC_DA2)
/MCU/PD1: J3.2, J5.2, U5.82 (PD1/CAN1_TX/FMC_D3/FMC_DA3)
/MCU/PD7: ENC2.6, R48.1, U5.88 (PD7/FMC_NE1/SPDIFRX_IN0/USART2_CK)
/MCU/PD13: U5.60 (PD13/FMC_A18/I2C4_SDA/LPTIM1_OUT/QUADSP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)
/MCU/PD15: U5.62 (PD15/FMC_D1/FMC_DA1/TIM4_CH4/UART8_RTS)
/MCU/PE0: J1.4, U5.97 (PE0/DCMI_D2/FMC_NBL0/LPTIM1_ETR/SAI2_MC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)
/MCU/PE1: J1.2, U5.98 (PE1/DCMI_D3/FMC_NBL1/LPTIM1_IN2/UART8_TX)
/MCU/PE2: GPIO1.10, U5.1 (PE2/ETH_TXD3/FMC_A23/QUADSPI_BK1_IO2/SA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)
/MCU/PE3: GPIO1.9, U5.2 (PE3/FMC_A19/SAI1_SD_B/SYS_TRACED0)
/MCU/PE4: GPIO1.7, U5.3 (PE4/DCMI_D4/FMC_A20/SAI1_FS_A/SPI4_NSS/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)
/MCU/PE5: GPIO1.5, U5.4 (PE5/DCMI_D6/FMC_A21/SAI1_SCK_A/SPI4_MIS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)
/MCU/PE6: GPIO1.3, U5.5 (PE6/DCMI_D7/FMC_A22/SAI1_SD_A/SAI2_MCLK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)
/MCU/PE7: U5.37 (PE7/FMC_D4/FMC_DA4/QUADSPI_BK2_IO0/TIM1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)
/MCU/PULL_A: R40.1, SW2.6
/MCU/PULL_B: R38.2, SW2.7
/MCU/VBAT_ADC: U5.30 (ADC1_IN6/ADC2_IN6/DCMI_PIXCLK/SPI1_MISO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); also elsewhere on the board
GND: BT1.2 (-), BT2.2 (-), C3.1, C4.1, C5.1, C8.1, C10.1, C14.1, C15.1, C19.1, C24.1, C25.2, C27.2, C28.2, C30.2, C31.2, C32.2, C42.2, C43.2, C44.2, C49.2, C53.1, C54.1, C55.1, C57.2, C58.2, ENC1.1, ENC1.3, ENC2.1, ENC2.3, GPIO1.1, J1.1, J2.3, J3.1, J4.1, J5.1, J6.5 (GND), J6.6 (FN), J6.7 (FN), J6.8 (FN), J6.9 (FN), J6.10 (FN), J6.11 (FN), M1_SW1.1, M1_SW2.1, M2_SW1.1, M2_SW2.1, R4.1, R10.2, R11.2, R15.2, R19.2, R20.2, R21.1, R30.2, R35.1, R36.1, R49.2, R85.2, SW2.2, U3.5 (GND), U4.3 (GND), U5.10 (VSS), U5.19 (VSSA), U5.26 (VSS), U5.49 (VSS), U5.74 (VSS), U5.99 (VSS), U6.3 (GND), U8.5 (GND), U12.5 (GND), Y1.2, Y1.4; also elsewhere on the board
unnamed: C3.2, R5.1, R8.1, U5.14 (NRST)
unnamed: C10.2, U5.48 (VCAP_1)
unnamed: C15.2, U5.73 (VCAP_2)
unnamed: C27.1, U5.12 (PH0/RCC_OSC_IN), Y1.1
unnamed: C30.1, C31.1, FB1.1, U5.20 (VREF+)
unnamed: C32.1, U5.13 (PH1/RCC_OSC_OUT), Y1.3
unnamed: C51.1, R20.1
unnamed: C52.1, R30.1
unnamed: C65.1, R11.1
unnamed: C66.1, R49.1
unnamed: D1.1 (K), R1.2
unnamed: D4.1 (K), R4.2
unnamed: D6.1 (K), R21.2
unnamed: ENC1.5, U3.6 (A)
unnamed: ENC1.7, U3.7 (B)
unnamed: ENC2.5, U8.6 (A)
unnamed: ENC2.7, U8.7 (B)
unnamed: J2.5, R2.2
unnamed: J2.6, R44.1
unnamed: J2.9, R3.2
unnamed: J3.5, J5.5, R38.1, R88.1, U12.7 (B)
unnamed: J4.2, R54.1
unnamed: J4.4, R55.1

Notes on the sheet:
SWD Interface
CL = (CX1 * CX2) / (CX1 + CX2) + Cstray CX1 = CX2 = 2(CL - Cstray) CL=8pF, Cstray = 2pF to 5pF CX1 = CX2 = 2*(8 - 4.5) = 7pF (7pF * 7pF)/(7pF + 7pF) + 4.5pF = 8pF
