mstoilov/sigmadrone-esc/hardware/sigmadrive-duo/sigmadrive-duo.kicad_pcb

## KiCad design hardware/sigmadrive-duo/sigmadrive-duo.kicad_pcb (continued)

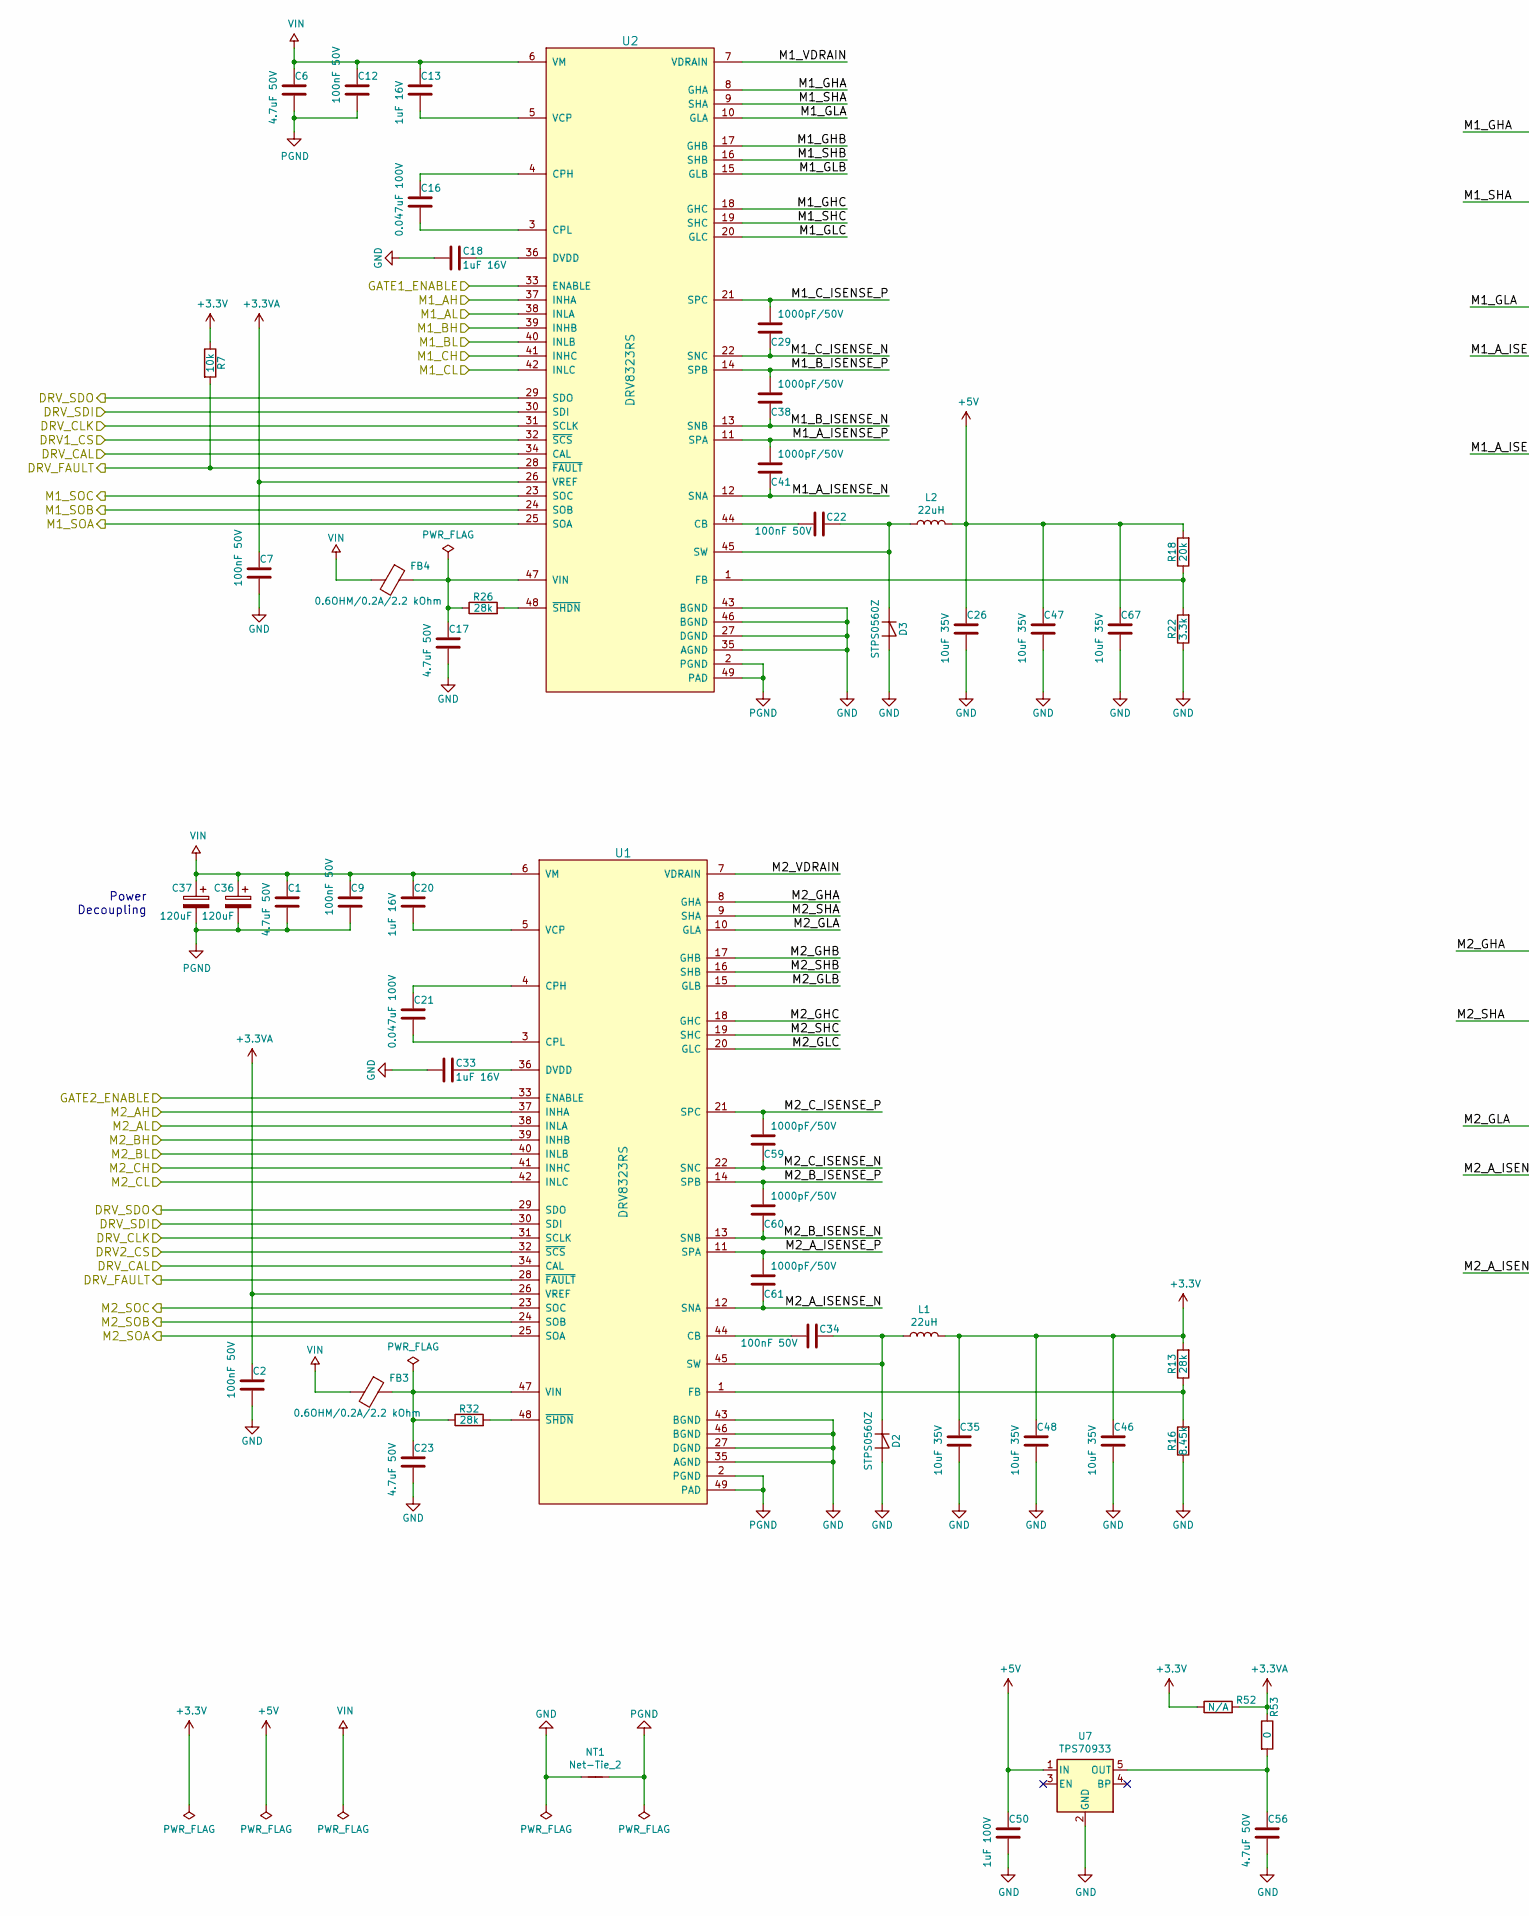
[picture p44: schematic mosfets_driving.sch, Servo Driver 60V, part in row 1, column 1]

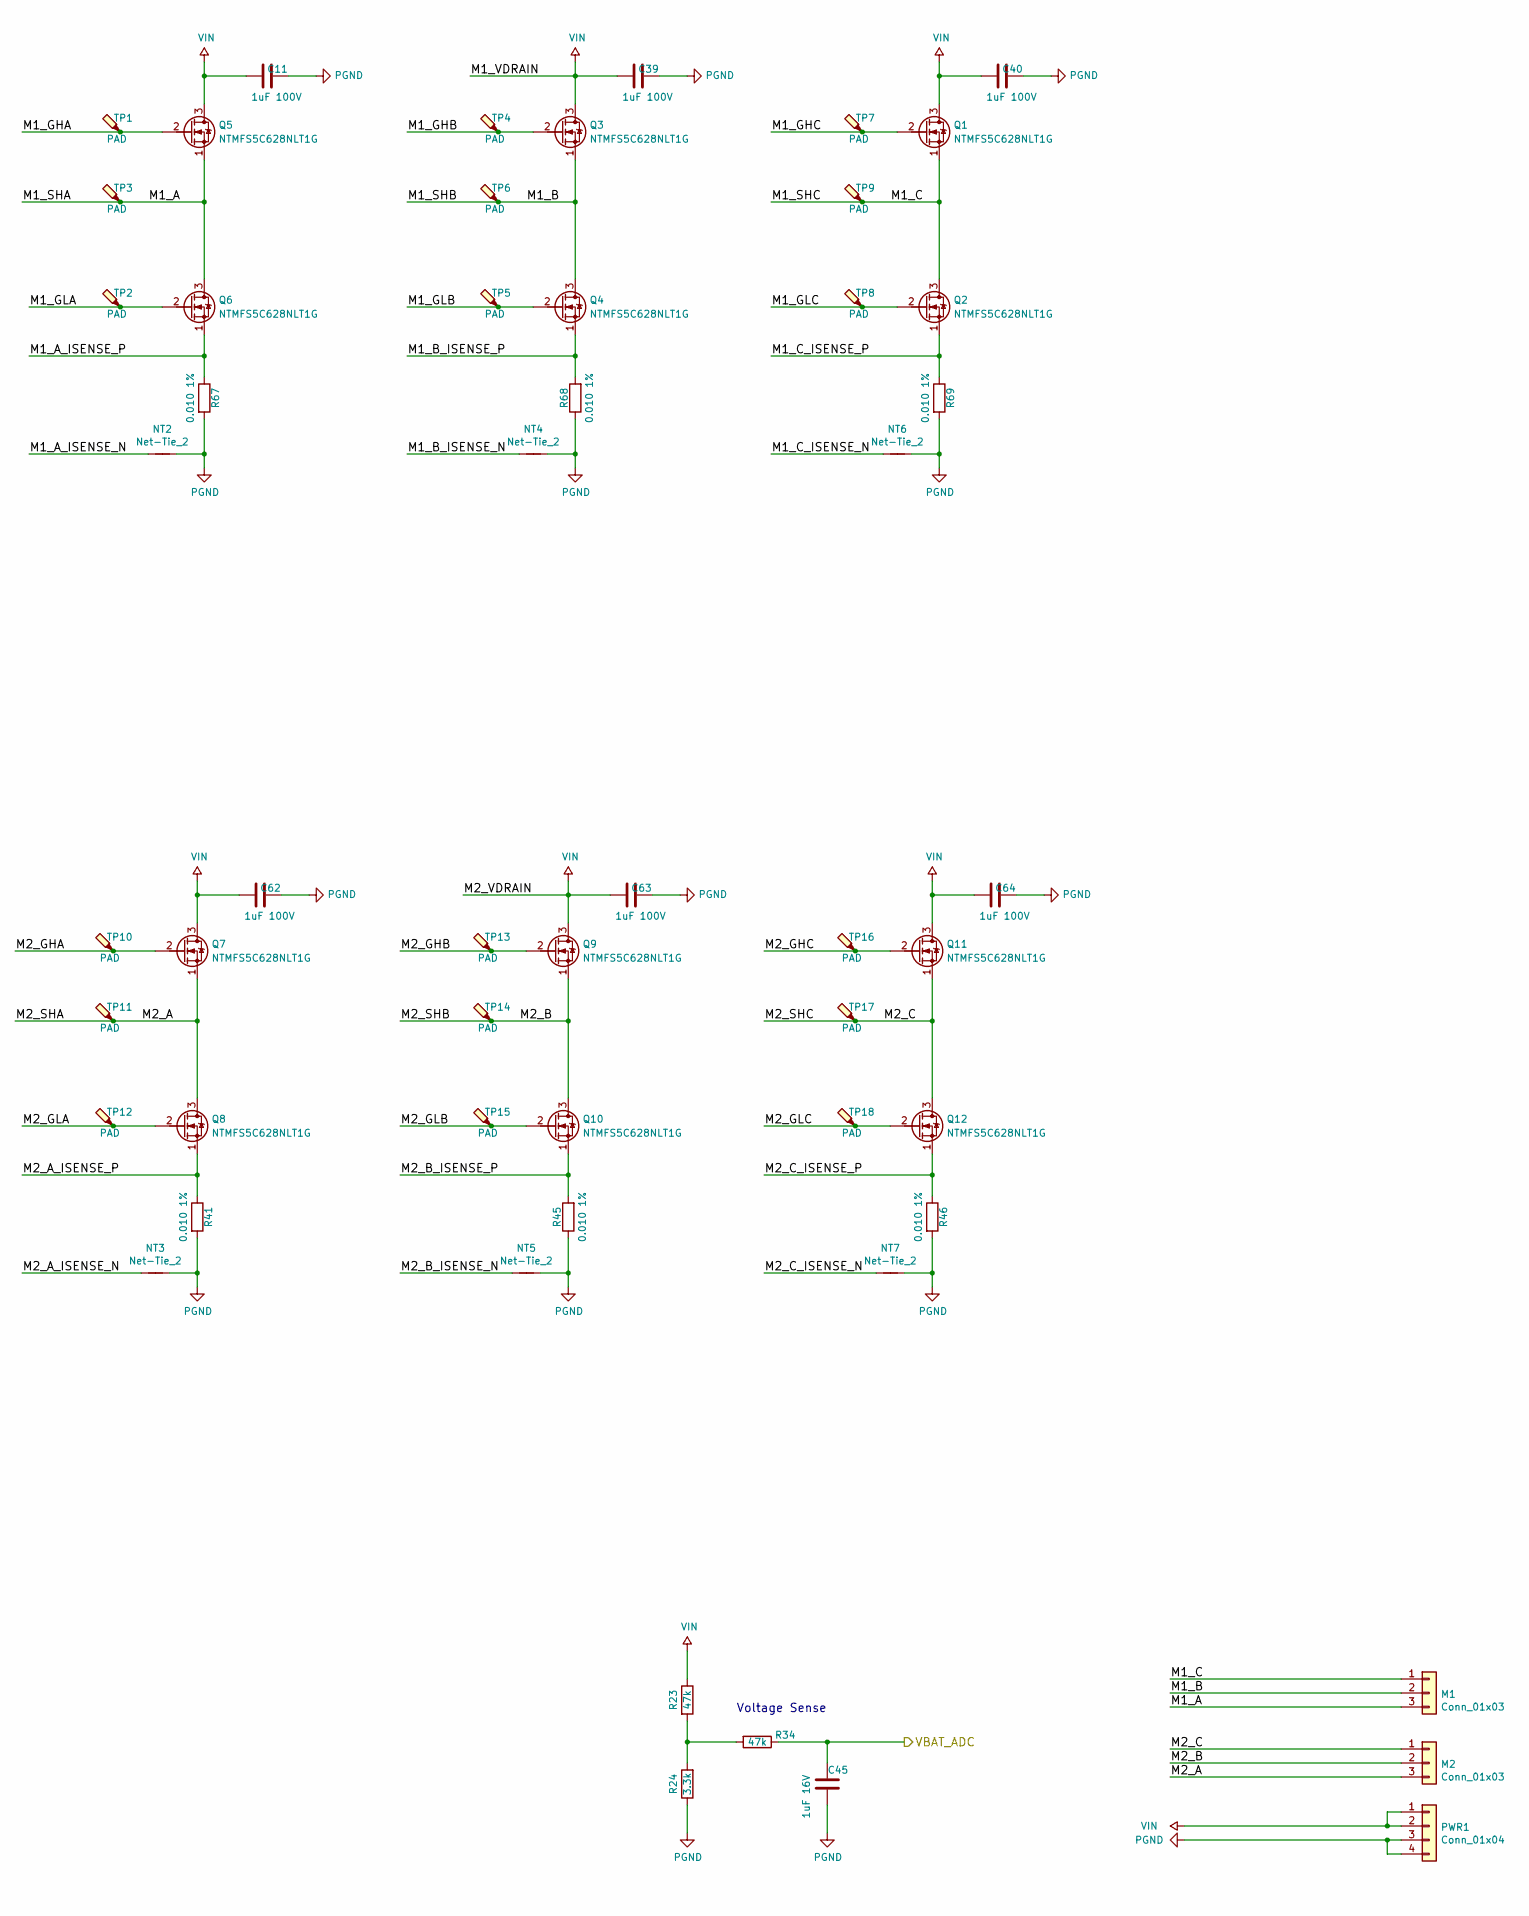
[picture p45: schematic mosfets_driving.sch, Servo Driver 60V, part in row 1, column 2]

Parts:
C1, C6, C17, C23, C56: 4.7uF 50V; C_0805_2012Metric; Part 490-10751-2-ND
C2, C7, C9, C12, C22, C34: 100nF 50V; C_0603_1608Metric; Part 490-4779-2-ND
C11, C39, C40, C50, C62, C63, C64: 1uF 100V; C_0805_2012Metric; Part 445-6804-2-ND
C13, C18, C20, C33, C45: 1uF 16V; C_0603_1608Metric; Part 732-7971-1-ND
C16, C21: 0.047uF 100V; C_0805_2012Metric; Part 490-4969-1-ND
C26, C35, C46, C47, C48, C67: 10uF 35V; C_0805_2012Metric; Part 445-14419-6-ND
C29, C38, C41, C59, C60, C61: 1000pF/50V; C_0603_1608Metric; Part 1276-1091-2-ND
C36, C37: 120uF; CP_Elec_10x10; Part P19316CT-ND
D2, D3: STPS0560Z; D_SOD-123; Part 497-3787-1-ND
FB3, FB4: 0.6OHM/0.2A/2.2 kOhm; R_0603_1608Metric; Part 732-1609-1-ND
L1, L2: 22uH; L_Wuerth_WE-TPC-4828; Part 732-1107-1-ND
M1, M2: Conn_01x03; Molex_Micro-Fit_3.0_43650-0300_1x03_P3.00mm_Horizontal
NT1, NT2, NT3, NT4, NT5, NT6, NT7: Net-Tie_2; NetTie-2_SMD_Pad0.5mm
PWR1: Conn_01x04; Molex_Micro-Fit_3.0_43650-0400_1x04_P3.00mm_Horizontal
Q1, Q2, Q3, Q4, Q5, Q6, Q7, Q8, Q9, Q10, Q11, Q12: NTMFS5C628NLT1G; PQFN_5x6_SGD; Part NTMFS5C628NLT1GOSDKR-ND
R7: 10k; R_0603_1608Metric; Part 311-10.0KHRCT-ND
R13, R26, R32: 28k; R_0603_1608Metric; Part 311-28.0KHRCT-ND
R16: 8.45k; R_0603_1608Metric; Part 311-8.45KHRCT-ND
R18: 20k; R_0603_1608Metric; Part 311-20.0KHRTR-ND
R22, R24: 3.3k; R_0603_1608Metric; Part 311-3.30KHRCT-ND
R23, R34: 47k; R_0603_1608Metric; Part 311-47KDCT-ND
R41, R45, R46, R67, R68, R69: 0.010 1%; R_2512_6332Metric; Part CRA2512-FZ-R010ELFCT-ND
R52: N/A; R_0603_1608Metric; Part 311-0.0GRTR-ND
R53: 0; R_0603_1608Metric; Part 311-0.0GRTR-ND
TP1, TP2, TP3, TP4, TP5, TP6, TP7, TP8, TP9, TP10, TP11, TP12, TP13, TP14, TP15, TP16, TP17, TP18: PAD; TestPoint_Pad_D1.0mm
U1, U2: DRV8323RS; QFN-48-1EP_7x7mm_P0.5mm_EP5.45x5.45mm_ThermalVias; Part 296-47769-1-ND
U7: TPS70933; SOT-23-5; Part 296-35483-1-ND

Connections:
+3.3VA: C2.1, C7.1, R52.2, R53.1, U1.26 (VREF), U2.26 (VREF); also elsewhere on the board
+5V: C26.1, C47.1, C50.1, C67.1, L2.2, R18.2, U7.1 (IN); also elsewhere on the board
/MCU/DRV1_CS: U2.32 (~SCS); also elsewhere on the board
/MCU/DRV2_CS: U1.32 (~SCS); also elsewhere on the board
/MCU/DRV_CAL: U1.34 (CAL), U2.34 (CAL); also elsewhere on the board
/MCU/DRV_CLK: U1.31 (SCLK), U2.31 (SCLK); also elsewhere on the board
/MCU/DRV_FAULT: R7.2, U1.28 (~FAULT), U2.28 (~FAULT); also elsewhere on the board
/MCU/DRV_SDI: U1.30 (SDI), U2.30 (SDI); also elsewhere on the board
/MCU/DRV_SDO: U1.29 (SDO), U2.29 (SDO); also elsewhere on the board
/MCU/GATE1_ENABLE: U2.33 (ENABLE); also elsewhere on the board
/MCU/GATE2_ENABLE: U1.33 (ENABLE); also elsewhere on the board
/MCU/M1_AH: U2.37 (INHA); also elsewhere on the board
/MCU/M1_AL: U2.38 (INLA); also elsewhere on the board
/MCU/M1_BH: U2.39 (INHB); also elsewhere on the board
/MCU/M1_BL: U2.40 (INLB); also elsewhere on the board
/MCU/M1_CH: U2.41 (INHC); also elsewhere on the board
/MCU/M1_CL: U2.42 (INLC); also elsewhere on the board
/MCU/M1_IA_FB: U2.25 (SOA); also elsewhere on the board
/MCU/M1_IB_FB: U2.24 (SOB); also elsewhere on the board
/MCU/M1_IC_FB: U2.23 (SOC); also elsewhere on the board
/MCU/M2_AH: U1.37 (INHA); also elsewhere on the board
/MCU/M2_AL: U1.38 (INLA); also elsewhere on the board
/MCU/M2_BH: U1.39 (INHB); also elsewhere on the board
/MCU/M2_BL: U1.40 (INLB); also elsewhere on the board
/MCU/M2_CH: U1.41 (INHC); also elsewhere on the board
/MCU/M2_CL: U1.42 (INLC); also elsewhere on the board
/MCU/M2_IA_FB: U1.25 (SOA); also elsewhere on the board
/MCU/M2_IB_FB: U1.24 (SOB); also elsewhere on the board
/MCU/M2_IC_FB: U1.23 (SOC); also elsewhere on the board
/MCU/VBAT_ADC: C45.1, R34.1; also elsewhere on the board
/MOSFETs/M1_A: M1.3, Q5.1 (S), Q6.3 (D), TP3.1, U2.9 (SHA)
/MOSFETs/M1_A_ISENSE_N: C41.1, NT2.1, U2.12 (SNA)
/MOSFETs/M1_A_ISENSE_P: C41.2, Q6.1 (S), R67.1, U2.11 (SPA)
/MOSFETs/M1_B: M1.2, Q3.1 (S), Q4.3 (D), TP6.1, U2.16 (SHB)
/MOSFETs/M1_B_ISENSE_N: C38.1, NT4.1, U2.13 (SNB)
/MOSFETs/M1_B_ISENSE_P: C38.2, Q4.1 (S), R68.2, U2.14 (SPB)
/MOSFETs/M1_C: M1.1, Q1.1 (S), Q2.3 (D), TP9.1, U2.19 (SHC)
/MOSFETs/M1_C_ISENSE_N: C29.1, NT6.1, U2.22 (SNC)
/MOSFETs/M1_C_ISENSE_P: C29.2, Q2.1 (S), R69.1, U2.21 (SPC)
/MOSFETs/M1_GHA: Q5.2 (G), TP1.1, U2.8 (GHA)
/MOSFETs/M1_GHB: Q3.2 (G), TP4.1, U2.17 (GHB)
/MOSFETs/M1_GHC: Q1.2 (G), TP7.1, U2.18 (GHC)
/MOSFETs/M1_GLA: Q6.2 (G), TP2.1, U2.10 (GLA)
/MOSFETs/M1_GLB: Q4.2 (G), TP5.1, U2.15 (GLB)
/MOSFETs/M1_GLC: Q2.2 (G), TP8.1, U2.20 (GLC)
/MOSFETs/M2_A: M2.3, Q7.1 (S), Q8.3 (D), TP11.1, U1.9 (SHA)
/MOSFETs/M2_A_ISENSE_N: C61.1, NT3.1, U1.12 (SNA)
/MOSFETs/M2_A_ISENSE_P: C61.2, Q8.1 (S), R41.1, U1.11 (SPA)
/MOSFETs/M2_B: M2.2, Q9.1 (S), Q10.3 (D), TP14.1, U1.16 (SHB)
/MOSFETs/M2_B_ISENSE_N: C60.1, NT5.1, U1.13 (SNB)
/MOSFETs/M2_B_ISENSE_P: C60.2, Q10.1 (S), R45.2, U1.14 (SPB)
/MOSFETs/M2_C: M2.1, Q11.1 (S), Q12.3 (D), TP17.1, U1.19 (SHC)
/MOSFETs/M2_C_ISENSE_N: C59.1, NT7.1, U1.22 (SNC)
/MOSFETs/M2_C_ISENSE_P: C59.2, Q12.1 (S), R46.1, U1.21 (SPC)
/MOSFETs/M2_GHA: Q7.2 (G), TP10.1, U1.8 (GHA)
/MOSFETs/M2_GHB: Q9.2 (G), TP13.1, U1.17 (GHB)
/MOSFETs/M2_GHC: Q11.2 (G), TP16.1, U1.18 (GHC)
/MOSFETs/M2_GLA: Q8.2 (G), TP12.1, U1.10 (GLA)
/MOSFETs/M2_GLB: Q10.2 (G), TP15.1, U1.15 (GLB)
/MOSFETs/M2_GLC: Q12.2 (G), TP18.1, U1.20 (GLC)
GND: C2.2, C7.2, C17.2, C18.2, C23.2, C26.2, C33.2, C35.2, C46.2, C47.2, C48.2, C50.2, C56.2, C67.2, D2.2 (A), D3.2 (A), NT1.1, R16.1, R22.1, U1.27 (DGND), U1.35 (AGND), U1.43 (BGND), U1.46 (BGND), U2.27 (DGND), U2.35 (AGND), U2.43 (BGND), U2.46 (BGND), U7.2 (GND); also elsewhere on the board
unnamed: C13.2, U2.5 (VCP)
unnamed: C16.1, U2.4 (CPH)
unnamed: C16.2, U2.3 (CPL)
unnamed: C17.1, FB4.1, R26.1, U2.47 (VIN)
unnamed: C18.1, U2.36 (DVDD)
unnamed: C20.2, U1.5 (VCP)
unnamed: C21.1, U1.4 (CPH)
unnamed: C21.2, U1.3 (CPL)
unnamed: C22.1, U2.44 (CB)
unnamed: C22.2, D3.1 (K), L2.1, U2.45 (SW)
unnamed: C23.1, FB3.1, R32.1, U1.47 (VIN)
unnamed: C33.1, U1.36 (DVDD)
unnamed: C34.1, U1.44 (CB)
unnamed: C34.2, D2.1 (K), L1.1, U1.45 (SW)
unnamed: C56.1, R53.2, U7.5 (OUT)
unnamed: R13.1, R16.2, U1.1 (FB)
unnamed: R18.1, R22.2, U2.1 (FB)
unnamed: R23.2, R24.2, R34.2
unnamed: R26.2, U2.48 (~SHDN)
unnamed: R32.2, U1.48 (~SHDN)
PGND: C1.2, C6.2, C9.2, C11.2, C12.2, C36.2, C37.2, C39.2, C40.2, C45.2, C62.2, C63.2, C64.2, NT1.2, NT2.2, NT3.2, NT4.2, NT5.2, NT6.2, NT7.2, PWR1.3, PWR1.4, R24.1, R41.2, R45.1, R46.2, R67.2, R68.1, R69.2, U1.2 (PGND), U1.49 (PAD), U2.2 (PGND), U2.49 (PAD)
VIN: C1.1, C6.1, C9.1, C11.1, C12.1, C13.1, C20.1, C36.1, C37.1, C39.1, C40.1, C62.1, C63.1, C64.1, FB3.2, FB4.2, PWR1.1, PWR1.2, Q1.3 (D), Q3.3 (D), Q5.3 (D), Q7.3 (D), Q9.3 (D), Q11.3 (D), R23.1, U1.6 (VM), U1.7 (VDRAIN), U2.6 (VM), U2.7 (VDRAIN)

Notes on the sheet:
Power Decoupling
Voltage Sense

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
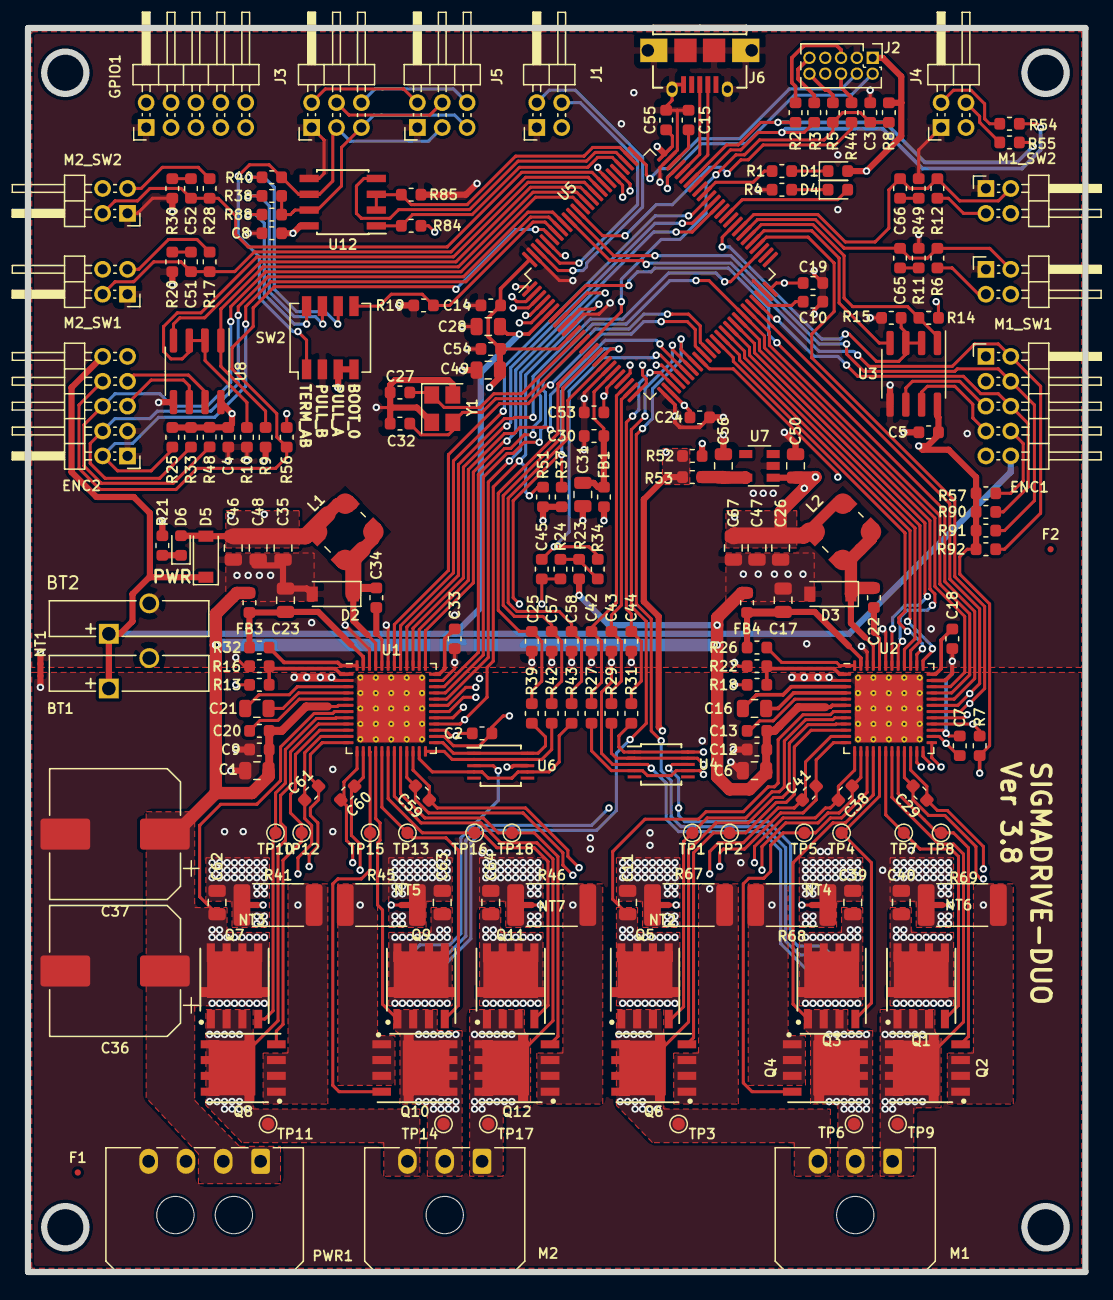
[picture p46: board sigmadrive-duo.kicad_pcb from above]

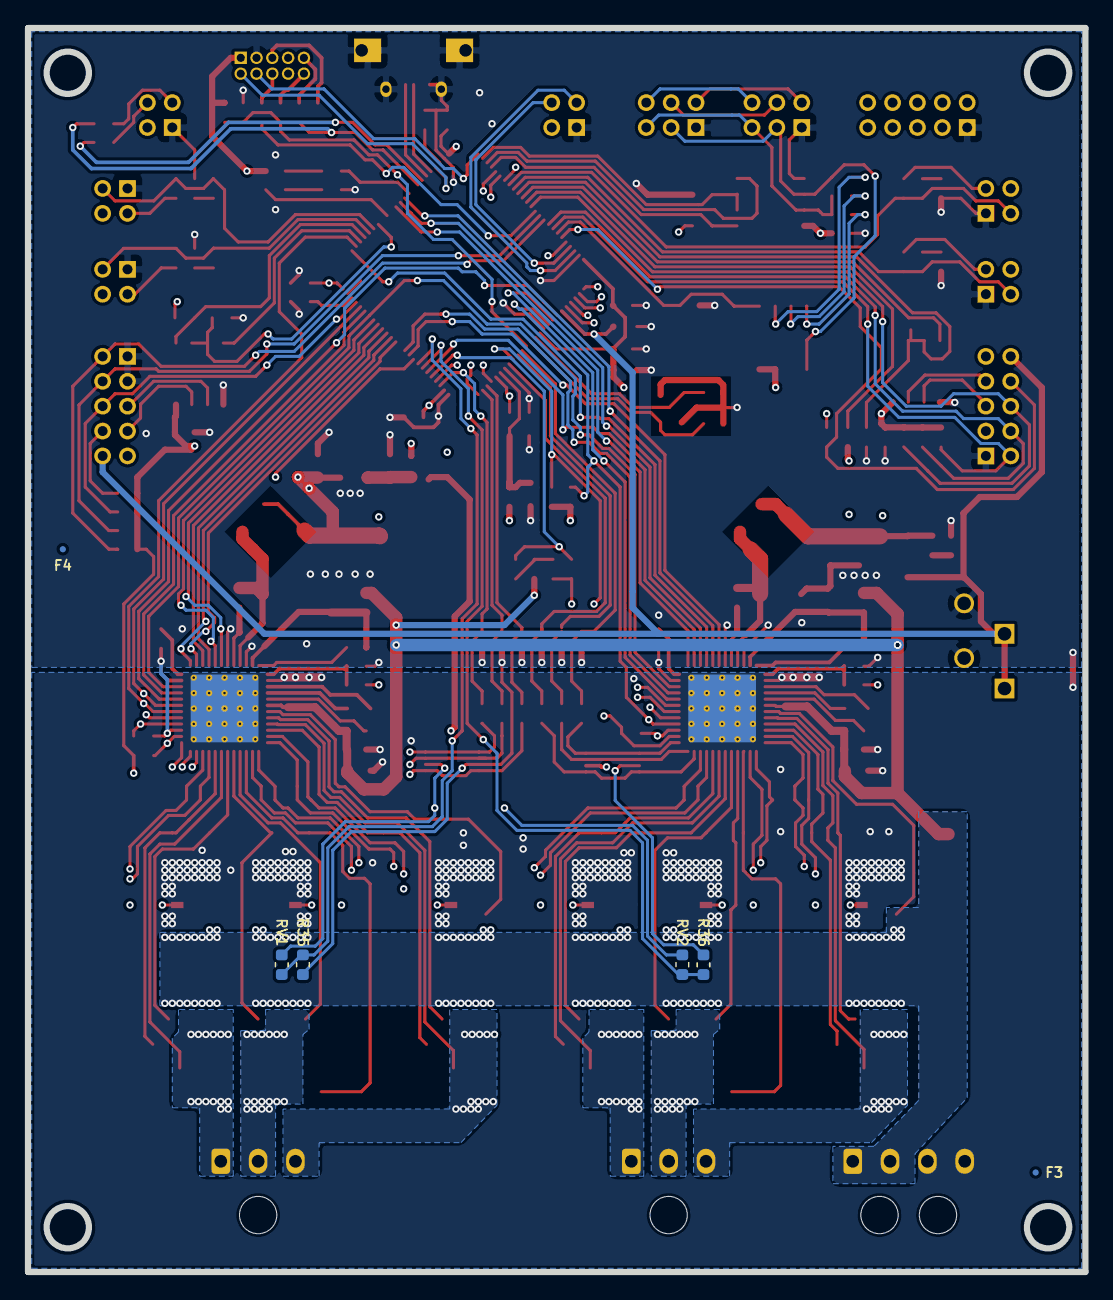
[picture p47: board sigmadrive-duo.kicad_pcb from below]

Board: 4 copper layers, 85.0 x 100.0 mm, 214 parts (6 on the bottom side), 166 nets.
