mstoilov/sigmadrone-esc/hardware/esc-sigma-4s/esc-sigma-4s.kicad_pcb

## KiCad design hardware/esc-sigma-4s/esc-sigma-4s.kicad_pcb (2018-04-08)

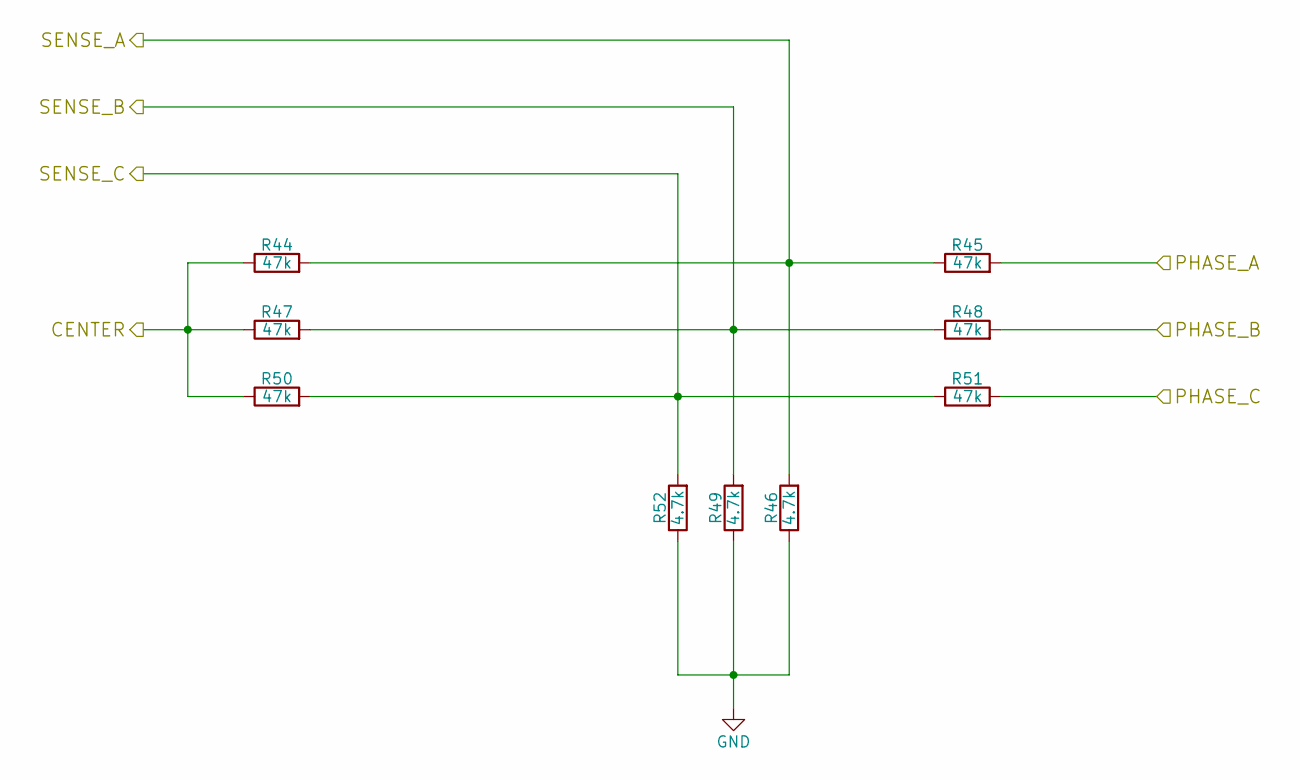
[picture p48: schematic phase_sensing.sch, ESC 4s 15A]

Parts:
R44, R45, R47, R48, R50, R51: 47k; R_0603; Part 311-47KDCT-ND
R46, R49, R52: 4.7k; R_0603; Part 311-2606-2-ND

Connections:
/MCU/CENTER: R44.1, R47.1, R50.1; also elsewhere on the board
/MCU/SENSE_A: R44.2, R45.1, R46.2; also elsewhere on the board
/MCU/SENSE_B: R47.2, R48.1, R49.2; also elsewhere on the board
/MCU/SENSE_C: R50.2, R51.1, R52.2; also elsewhere on the board
/MOSFETs/PHASE_A: R45.2; also elsewhere on the board
/MOSFETs/PHASE_B: R48.2; also elsewhere on the board
/MOSFETs/PHASE_C: R51.2; also elsewhere on the board
GND: R46.1, R49.1, R52.1; also elsewhere on the board

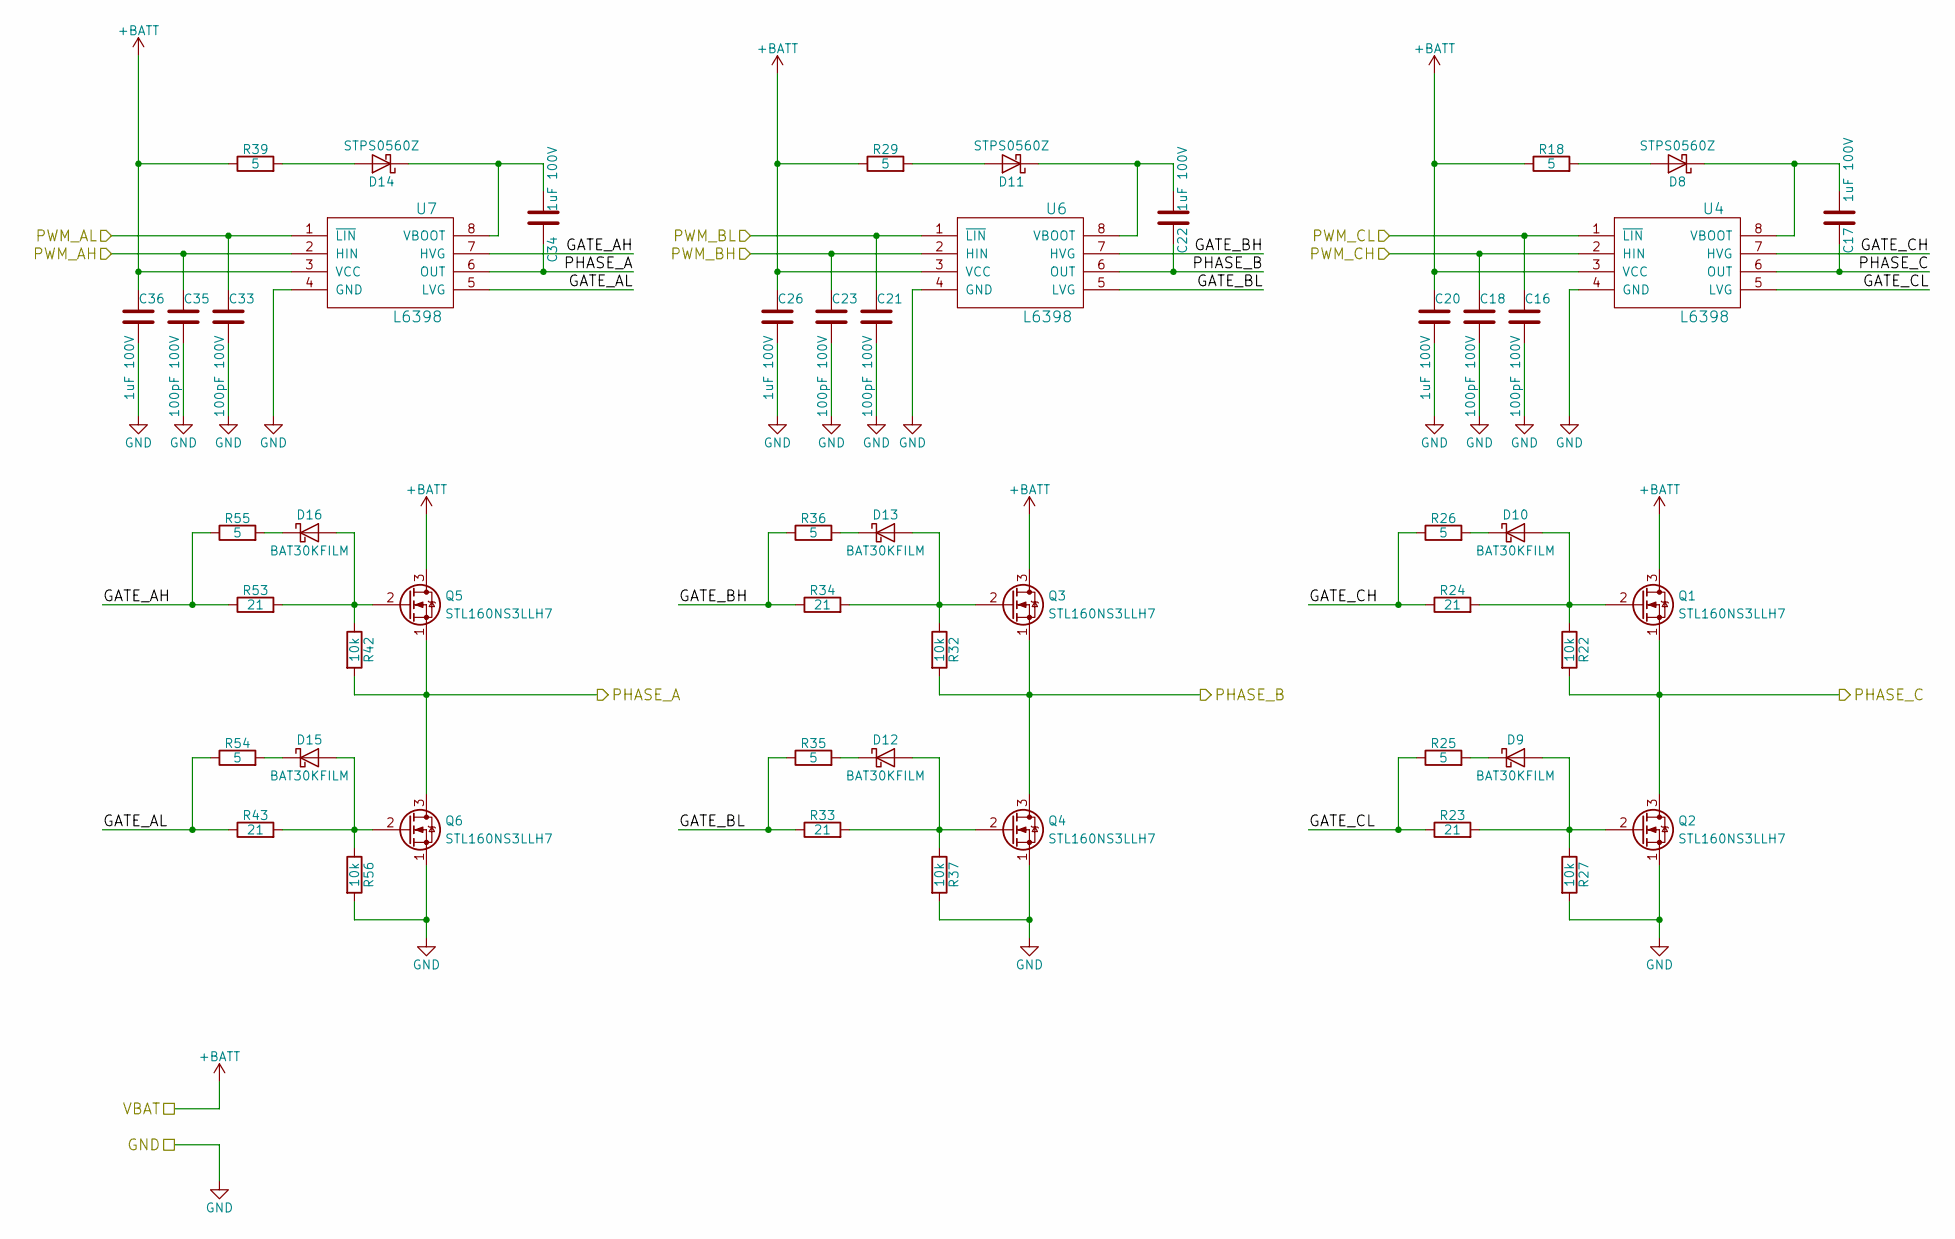
[picture p49: schematic mosfets_driving.sch, ESC 4s 15A]

Parts:
C16, C18, C21, C23, C33, C35: 100pF 100V; C_0603; Part 399-7821-2-ND
C17, C20, C22, C26, C34, C36: 1uF 100V; C_0805; Part 445-8887-1-ND
D8, D11, D14: STPS0560Z; D_SOD-123; Part 497-3787-1-ND
D9, D10, D12, D13, D15, D16: BAT30KFILM; D_SOD-523; Part 497-5552-1-ND
Q1, Q2, Q3, Q4, Q5, Q6: STL160NS3LLH7; PQFN_5x6_SGD; Part 497-14988-6-ND
R18, R25, R26, R29, R35, R36, R39, R54, R55: 5; R_0603; Part 311-4.99HRCT-ND
R22, R27, R32, R37, R42, R56: 10k; R_0603; Part 311-10.0KHRCT-ND
R23, R24, R33, R34, R43, R53: 21; R_0603; Part 311-21.0HRCT-ND
U4, U6, U7: L6398; SOIC-8_3.9x4.9mm_Pitch1.27mm; Part 497-16166-5-ND

Connections:
+BATT: C20.2, C26.2, C36.2, Q1.3 (D), Q3.3 (D), Q5.3 (D), R18.1, R29.1, R39.1, U4.3 (VCC), U6.3 (VCC), U7.3 (VCC); also elsewhere on the board
/MCU/PWM_AH: C35.2, U7.2 (HIN); also elsewhere on the board
/MCU/PWM_AL: C33.2, U7.1 (~LIN); also elsewhere on the board
/MCU/PWM_BH: C23.2, U6.2 (HIN); also elsewhere on the board
/MCU/PWM_BL: C21.2, U6.1 (~LIN); also elsewhere on the board
/MCU/PWM_CH: C18.2, U4.2 (HIN); also elsewhere on the board
/MCU/PWM_CL: C16.2, U4.1 (~LIN); also elsewhere on the board
/MOSFETs/GATE_AH: R53.1, R55.1, U7.7 (HVG)
/MOSFETs/GATE_AL: R43.1, R54.1, U7.5 (LVG)
/MOSFETs/GATE_BH: R34.1, R36.1, U6.7 (HVG)
/MOSFETs/GATE_BL: R33.1, R35.1, U6.5 (LVG)
/MOSFETs/GATE_CH: R24.1, R26.1, U4.7 (HVG)
/MOSFETs/GATE_CL: R23.1, R25.1, U4.5 (LVG)
/MOSFETs/PHASE_A: C34.1, Q5.1 (S), Q6.3 (D), R42.2, U7.6 (OUT); also elsewhere on the board
/MOSFETs/PHASE_B: C22.1, Q3.1 (S), Q4.3 (D), R32.2, U6.6 (OUT); also elsewhere on the board
/MOSFETs/PHASE_C: C17.1, Q1.1 (S), Q2.3 (D), R22.2, U4.6 (OUT); also elsewhere on the board
GND: C16.1, C18.1, C20.1, C21.1, C23.1, C26.1, C33.1, C35.1, C36.1, Q2.1 (S), Q4.1 (S), Q6.1 (S), R27.2, R37.2, R56.2, U4.4 (GND), U6.4 (GND), U7.4 (GND); also elsewhere on the board
unnamed: C17.2, D8.1 (K), U4.8 (VBOOT)
unnamed: C22.2, D11.1 (K), U6.8 (VBOOT)
unnamed: C34.2, D14.1 (K), U7.8 (VBOOT)
unnamed: D8.2 (A), R18.2
unnamed: D9.1 (K), R25.2
unnamed: D9.2 (A), Q2.2 (G), R23.2, R27.1
unnamed: D10.1 (K), R26.2
unnamed: D10.2 (A), Q1.2 (G), R22.1, R24.2
unnamed: D11.2 (A), R29.2
unnamed: D12.1 (K), R35.2
unnamed: D12.2 (A), Q4.2 (G), R33.2, R37.1
unnamed: D13.1 (K), R36.2
unnamed: D13.2 (A), Q3.2 (G), R32.1, R34.2
unnamed: D14.2 (A), R39.2
unnamed: D15.1 (K), R54.2
unnamed: D15.2 (A), Q6.2 (G), R43.2, R56.1
unnamed: D16.1 (K), R55.2
unnamed: D16.2 (A), Q5.2 (G), R42.1, R53.2

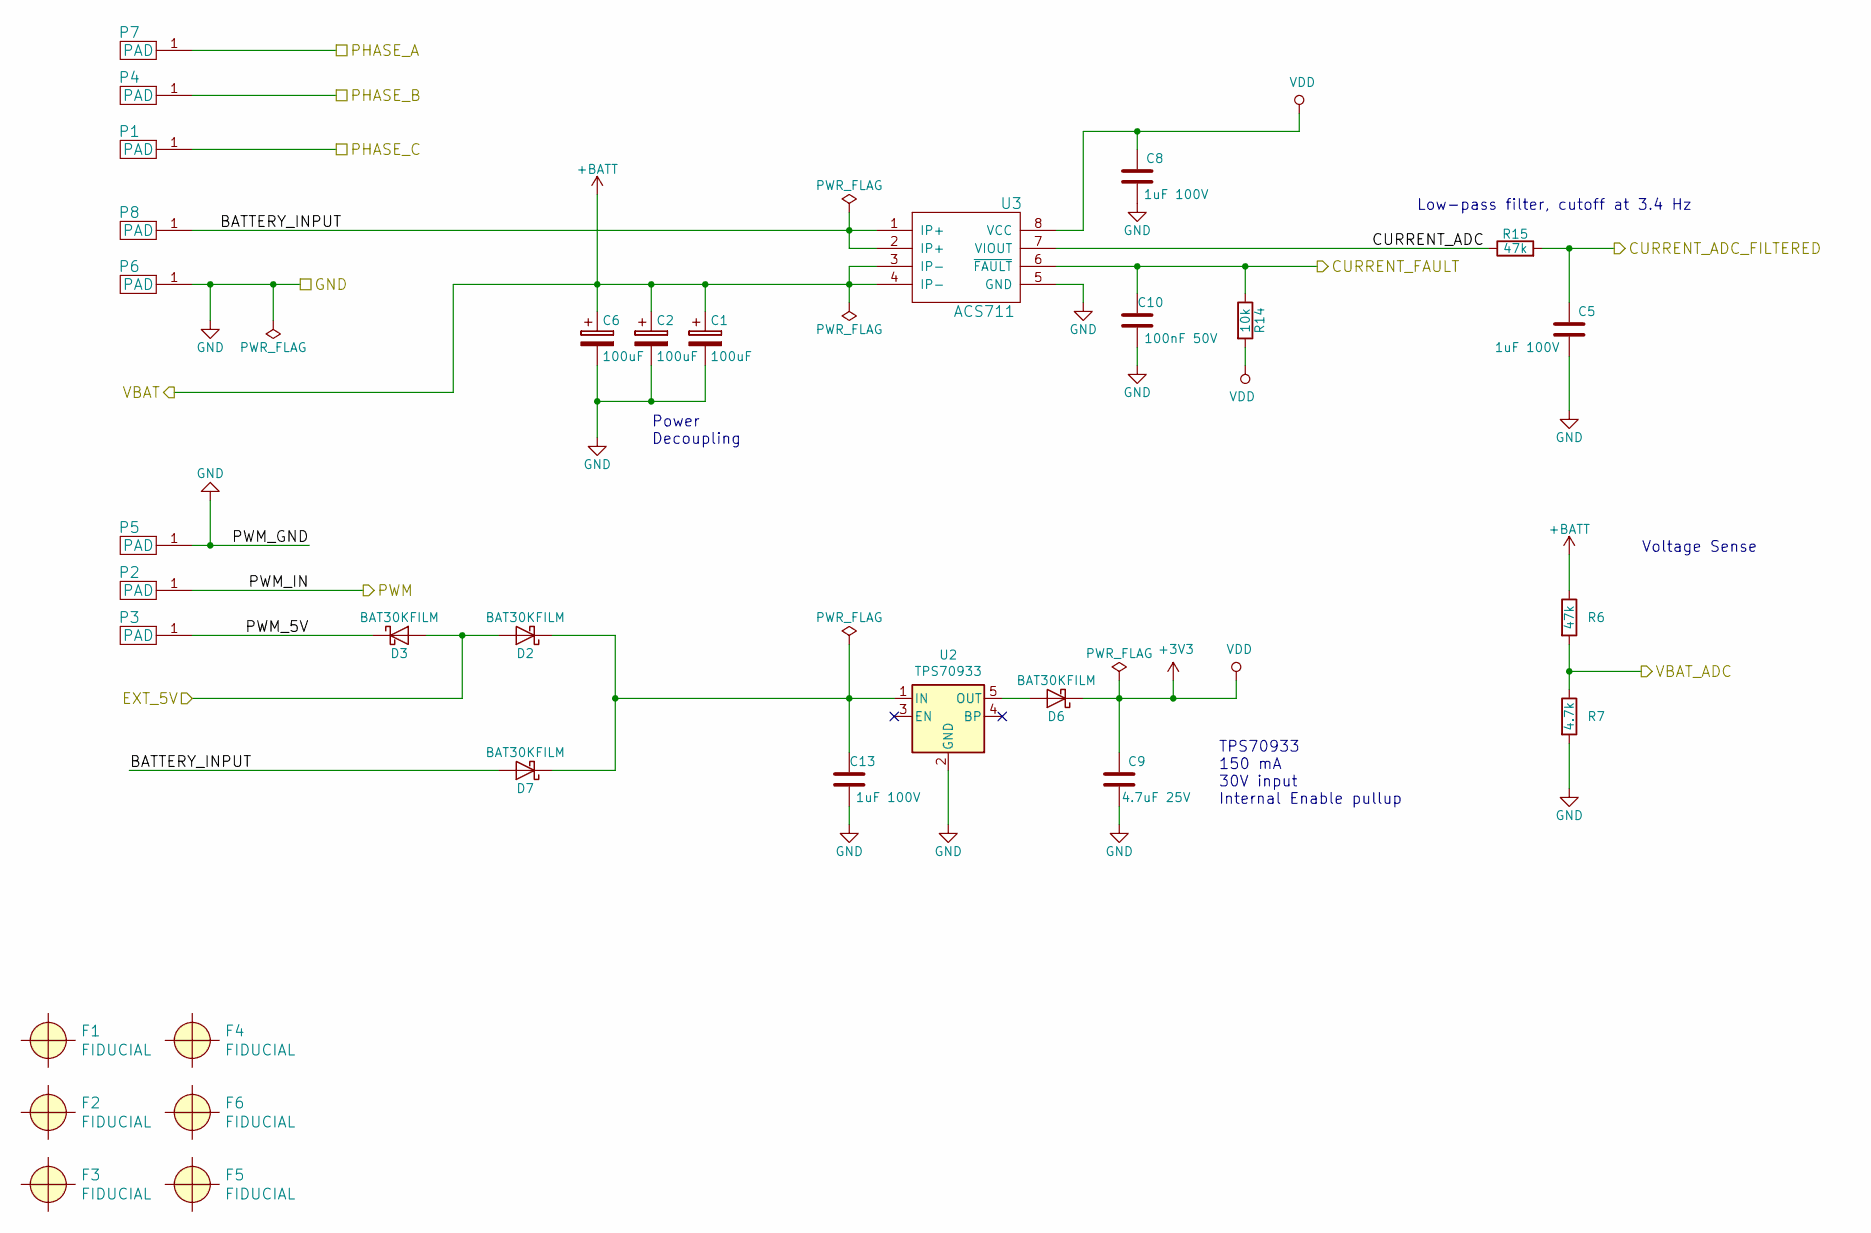
[picture p50: schematic pads_connectors.sch, ESC 4s 15A]

Parts:
C1, C2, C6: 100uF; CP_Elec_6.3x7.7; Part 732-8511-1-ND
C5, C8, C13: 1uF 100V; C_0805; Part 445-8887-1-ND
C9: 4.7uF 25V; C_0805; Part 1276-2415-1-ND
C10: 100nF 50V; C_0603; Part 490-4779-2-ND
D2, D3, D6, D7: BAT30KFILM; D_SOD-523; Part 497-5552-1-ND
F1, F2, F3, F4, F5, F6: FIDUCIAL; Fiducial_0.5mm_Dia_1mm_Outer
P1, P4, P6, P7, P8: PAD; SolderWirePad_single_SMD_2x3mm
P2, P3, P5: PAD; SolderWirePad_single_SMD_1.5x2.5mm
R6, R15: 47k; R_0603; Part 311-47KDCT-ND
R7: 4.7k; R_0603; Part 311-2606-2-ND
R14: 10k; R_0603; Part 311-10.0KHRCT-ND
U2: TPS70933; SOT-23-5; Part 296-35483-1-ND
U3: ACS711; SOIC-8_3.9x4.9mm_Pitch1.27mm; Part 620-1373-1-ND

Connections:
+3V3: C8.2, C9.2, D6.1 (K), R14.2, U3.8 (VCC); also elsewhere on the board
+BATT: C1.1, C2.1, C6.1, R6.1, U3.3 (IP-), U3.4 (IP-); also elsewhere on the board
/MCU/CURRENT_ADC: C5.2, R15.2; also elsewhere on the board
/MCU/CURRENT_FAULT: C10.2, R14.1, U3.6 (~FAULT); also elsewhere on the board
/MCU/EXT_5V: D2.2 (A), D3.2 (A); also elsewhere on the board
/MCU/PWM: P2.1; also elsewhere on the board
/MCU/VBAT_ADC: R6.2, R7.1; also elsewhere on the board
/MOSFETs/PHASE_A: P7.1; also elsewhere on the board
/MOSFETs/PHASE_B: P4.1; also elsewhere on the board
/MOSFETs/PHASE_C: P1.1; also elsewhere on the board
/PADS & POWER/BATTERY_INPUT: D7.2 (A), P8.1, U3.1 (IP+), U3.2 (IP+)
/PADS & POWER/CURRENT_ADC: R15.1, U3.7 (VIOUT)
/PADS & POWER/PWM_5V: D3.1 (K), P3.1
GND: C1.2, C2.2, C5.1, C6.2, C8.1, C9.1, C10.1, C13.1, P5.1, P6.1, R7.2, U2.2 (GND), U3.5 (GND); also elsewhere on the board
unnamed: C13.2, D2.1 (K), D7.1 (K), U2.1 (IN)
unnamed: D6.2 (A), U2.5 (OUT)

Notes on the sheet:
Low-pass filter, cutoff at 3.4 Hz
Power Decoupling
Voltage Sense
TPS70933 150 mA 30V input Internal Enable pullup
