mstoilov/sigmadrone-esc/hardware/esc-sigma-4s/esc-sigma-4s.kicad_pcb

## KiCad design hardware/esc-sigma-4s/esc-sigma-4s.kicad_pcb (continued)

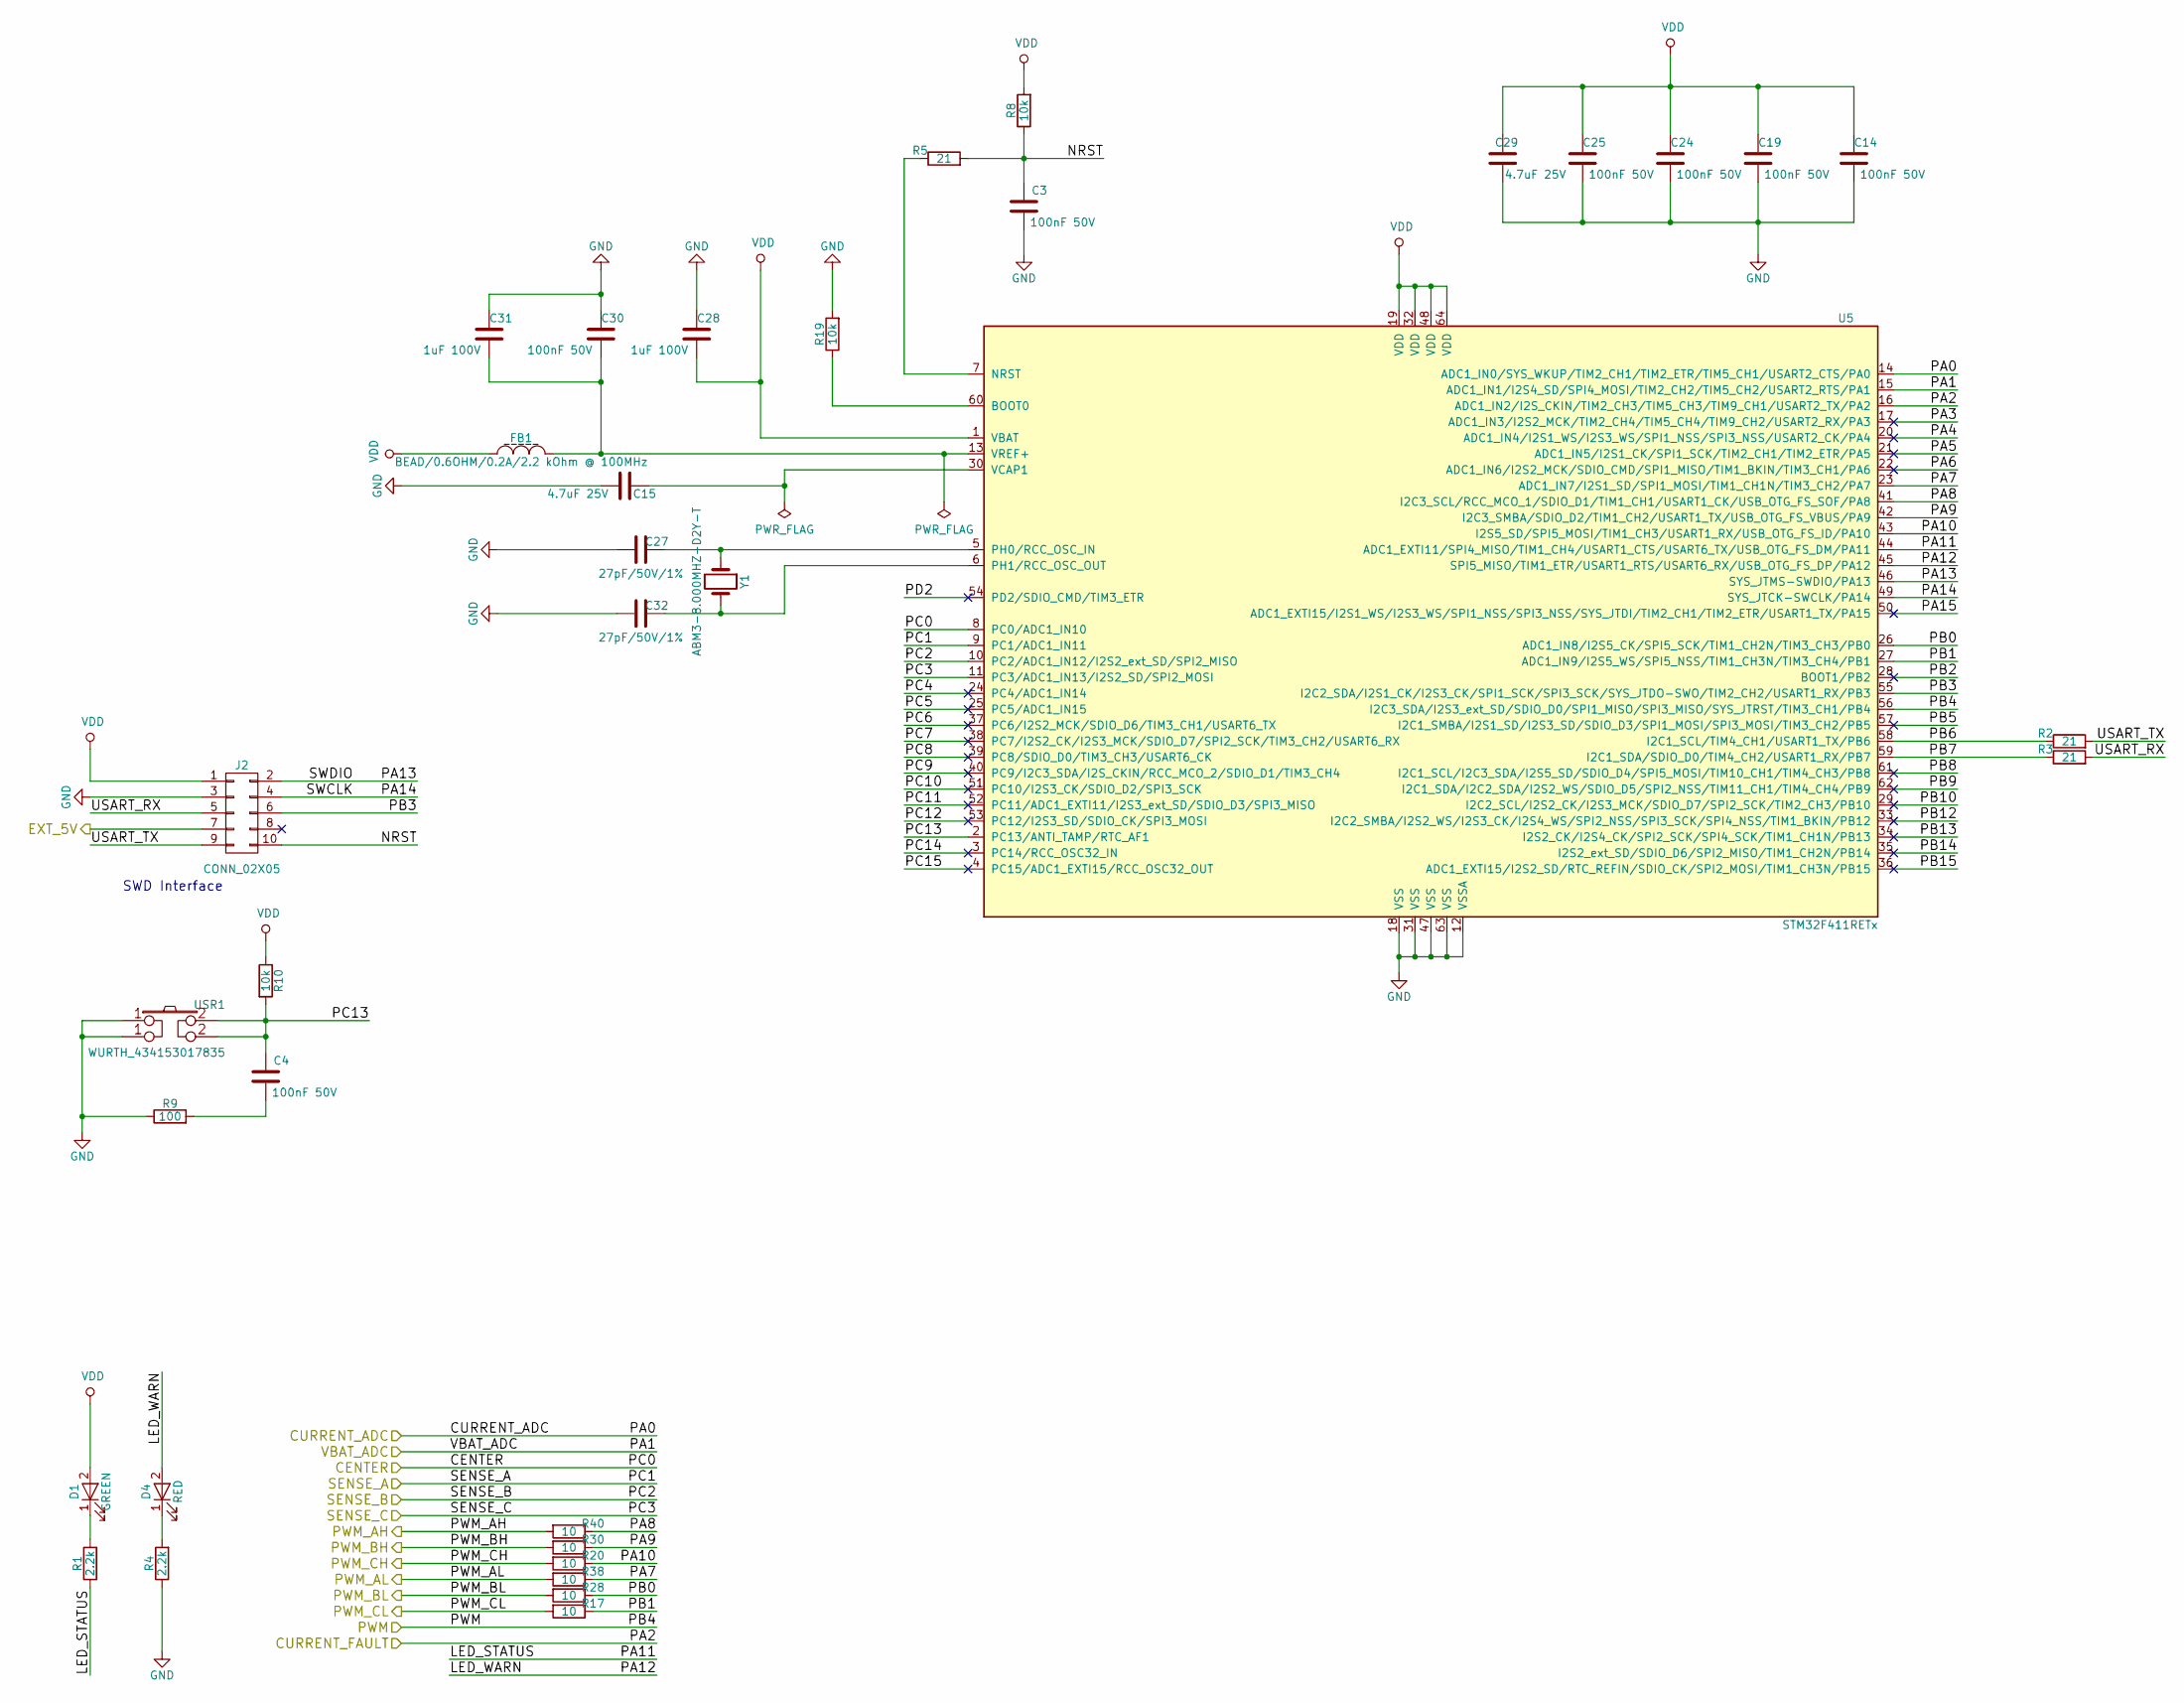
[picture p51: schematic mcu.sch, ESC 4s 15A]

Parts:
C3, C4, C14, C19, C24, C25, C30: 100nF 50V; C_0603; Part 490-4779-2-ND
C15, C29: 4.7uF 25V; C_0805; Part 1276-2415-1-ND
C27, C32: 27pF/50V/1%; C_0603; Part 490-9719-1-ND
C28, C31: 1uF 100V; C_0805; Part 445-8887-1-ND
D1: GREEN; LED_0603; Part 732-4971-1-ND
D4: RED; LED_0603; Part 732-4978-1-ND
FB1: BEAD/0.6OHM/0.2A/2.2 kOhm @ 100MHz; R_0805; Part 732-1609-1-ND
J2: CONN_02X05; Pin_Header_Straight_2x05_Pitch1.27mm; Part 732-5374-ND
R1, R4: 2.2k; R_0603; Part RMCF0603JT2K20CT-ND
R2, R3, R5: 21; R_0603; Part 311-21.0HRCT-ND
R8, R10, R19: 10k; R_0603; Part 311-10.0KHRCT-ND
R9: 100; R_0603; Part 311-100HRCT-ND
R17, R20, R28, R30, R38, R40: 10; R_0603; Part 311-10.0HRCT-ND
U5: STM32F411RETx; LQFP-64_10x10mm_Pitch0.5mm; Part 497-14909-ND
USR1: WURTH_434153017835; SW_SPST_WURTH_434153017835; Part 732-10143-1-ND
Y1: ABM3-8.000MHZ-D2Y-T; Crystal_SMD_Abracon_ABM3-2pin_5.0x3.2mm; Part 535-10630-1-ND

Connections:
+3V3: C14.2, C19.2, C24.2, C25.2, C28.1, C29.2, D1.2 (A), FB1.1, J2.1, R8.2, R10.1, U5.1 (VBAT), U5.19 (VDD), U5.32 (VDD), U5.48 (VDD), U5.64 (VDD); also elsewhere on the board
/MCU/CENTER: U5.8 (PC0/ADC1_IN10); also elsewhere on the board
/MCU/CURRENT_ADC: U5.14 (ADC1_IN0/SYS_WKUP/TIM2_CH1/TIM2_ETR/TIM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); also elsewhere on the board
/MCU/CURRENT_FAULT: U5.16 (ADC1_IN2/I2S_CKIN/TIM2_CH3/TIM5_CH3/TIM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); also elsewhere on the board
/MCU/EXT_5V: J2.7; also elsewhere on the board
/MCU/LED_STATUS: R1.1, U5.44 (ADC1_EXTI11/SPI4_MISO/TIM1_CH4/USART1_C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)
/MCU/LED_WARN: D4.2 (A), U5.45 (SPI5_MISO/TIM1_ETR/USART1_RTS/USART6_RX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)
/MCU/NRST: C3.2, J2.10, R5.2, R8.1
/MCU/PA3: U5.17 (ADC1_IN3/I2S2_MCK/TIM2_CH4/TIM5_CH4/TIM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)
/MCU/PA4: U5.20 (ADC1_IN4/I2S1_WS/I2S3_WS/SPI1_NSS/SPI3_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)
/MCU/PA5: U5.21 (ADC1_IN5/I2S1_CK/SPI1_SCK/TIM2_CH1/TIM2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)
/MCU/PA6: U5.22 (ADC1_IN6/I2S2_MCK/SDIO_CMD/SPI1_MISO/TI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)
/MCU/PA7: R38.1, U5.23 (ADC1_IN7/I2S1_SD/SPI1_MOSI/TIM1_CH1N/TI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)
/MCU/PA8: R40.1, U5.41 (I2C3_SCL/RCC_MCO_1/SDIO_D1/TIM1_CH1/USA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)
/MCU/PA9: R30.1, U5.42 (I2C3_SMBA/SDIO_D2/TIM1_CH2/USART1_TX/US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)
/MCU/PA10: R20.1, U5.43 (I2S5_SD/SPI5_MOSI/TIM1_CH3/USART1_RX/US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)
/MCU/PA13: J2.2, U5.46 (SYS_JTMS-SWDIO/PA13)
/MCU/PA14: J2.4, U5.49 (SYS_JTCK-SWCLK/PA14)
/MCU/PA15: U5.50 (ADC1_EXTI15/I2S1_WS/I2S3_WS/SPI1_NSS/SP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)
/MCU/PB0: R28.1, U5.26 (ADC1_IN8/I2S5_CK/SPI5_SCK/TIM1_CH2N/TIM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)
/MCU/PB1: R17.1, U5.27 (ADC1_IN9/I2S5_WS/SPI5_NSS/TIM1_CH3N/TIM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)
/MCU/PB2: U5.28 (BOOT1/PB2)
/MCU/PB3: J2.6, U5.55 (I2C2_SDA/I2S1_CK/I2S3_CK/SPI1_SCK/SPI3_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)
/MCU/PB5: U5.57 (I2C1_SMBA/I2S1_SD/I2S3_SD/SDIO_D3/SPI1_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)
/MCU/PB6: R2.1, U5.58 (I2C1_SCL/TIM4_CH1/USART1_TX/PB6)
/MCU/PB7: R3.1, U5.59 (I2C1_SDA/SDIO_D0/TIM4_CH2/USART1_RX/PB7)
/MCU/PB8: U5.61 (I2C1_SCL/I2C3_SDA/I2S5_SD/SDIO_D4/SPI5_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)
/MCU/PB9: U5.62 (I2C1_SDA/I2C2_SDA/I2S2_WS/SDIO_D5/SPI2_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)
/MCU/PB10: U5.29 (I2C2_SCL/I2S2_CK/I2S3_MCK/SDIO_D7/SPI2_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)
/MCU/PB12: U5.33 (I2C2_SMBA/I2S2_WS/I2S3_CK/I2S4_WS/SPI2_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)
/MCU/PB13: U5.34 (I2S2_CK/I2S4_CK/SPI2_SCK/SPI4_SCK/TIM1_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)
/MCU/PB14: U5.35 (I2S2_ext_SD/SDIO_D6/SPI2_MISO/TIM1_CH2N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)
/MCU/PB15: U5.36 (ADC1_EXTI15/I2S2_SD/RTC_REFIN/SDIO_CK/S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)
/MCU/PC4: U5.24 (PC4/ADC1_IN14)
/MCU/PC5: U5.25 (PC5/ADC1_IN15)
/MCU/PC6: U5.37 (PC6/I2S2_MCK/SDIO_D6/TIM3_CH1/USART6_TX)
/MCU/PC7: U5.38 (PC7/I2S2_CK/I2S3_MCK/SDIO_D7/SPI2_SCK/T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)
/MCU/PC8: U5.39 (PC8/SDIO_D0/TIM3_CH3/USART6_CK)
/MCU/PC9: U5.40 (PC9/I2C3_SDA/I2S_CKIN/RCC_MCO_2/SDIO_D1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)
/MCU/PC10: U5.51 (PC10/I2S3_CK/SDIO_D2/SPI3_SCK)
/MCU/PC11: U5.52 (PC11/ADC1_EXTI11/I2S3_ext_SD/SDIO_D3/SP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)
/MCU/PC12: U5.53 (PC12/I2S3_SD/SDIO_CK/SPI3_MOSI)
/MCU/PC13: C4.2, R10.2, U5.2 (PC13/ANTI_TAMP/RTC_AF1), USR1.2
/MCU/PC14: U5.3 (PC14/RCC_OSC32_IN)
/MCU/PC15: U5.4 (PC15/ADC1_EXTI15/RCC_OSC32_OUT)
/MCU/PD2: U5.54 (PD2/SDIO_CMD/TIM3_ETR)
/MCU/PWM: U5.56 (I2C3_SDA/I2S3_ext_SD/SDIO_D0/SPI1_MISO/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); also elsewhere on the board
/MCU/PWM_AH: R40.2; also elsewhere on the board
/MCU/PWM_AL: R38.2; also elsewhere on the board
/MCU/PWM_BH: R30.2; also elsewhere on the board
/MCU/PWM_BL: R28.2; also elsewhere on the board
/MCU/PWM_CH: R20.2; also elsewhere on the board
/MCU/PWM_CL: R17.2; also elsewhere on the board
/MCU/SENSE_A: U5.9 (PC1/ADC1_IN11); also elsewhere on the board
/MCU/SENSE_B: U5.10 (PC2/ADC1_IN12/I2S2_ext_SD/SPI2_MISO); also elsewhere on the board
/MCU/SENSE_C: U5.11 (PC3/ADC1_IN13/I2S2_SD/SPI2_MOSI); also elsewhere on the board
/MCU/USART_RX: J2.5, R3.2
/MCU/USART_TX: J2.9, R2.2
/MCU/VBAT_ADC: U5.15 (ADC1_IN1/I2S4_SD/SPI4_MOSI/TIM2_CH2/TIM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); also elsewhere on the board
GND: C3.1, C14.1, C15.1, C19.1, C24.1, C25.1, C27.2, C28.2, C29.1, C30.2, C31.2, C32.2, J2.3, R4.1, R9.1, R19.2, U5.12 (VSSA), U5.18 (VSS), U5.31 (VSS), U5.47 (VSS), U5.63 (VSS), USR1.1; also elsewhere on the board
unnamed: C4.1, R9.2
unnamed: C15.2, U5.30 (VCAP1)
unnamed: C27.1, U5.5 (PH0/RCC_OSC_IN), Y1.1
unnamed: C30.1, C31.1, FB1.2, U5.13 (VREF+)
unnamed: C32.1, U5.6 (PH1/RCC_OSC_OUT), Y1.2
unnamed: D1.1 (K), R1.2
unnamed: D4.1 (K), R4.2
unnamed: R5.1, U5.7 (NRST)
unnamed: R19.1, U5.60 (BOOT0)

Notes on the sheet:
SWD Interface

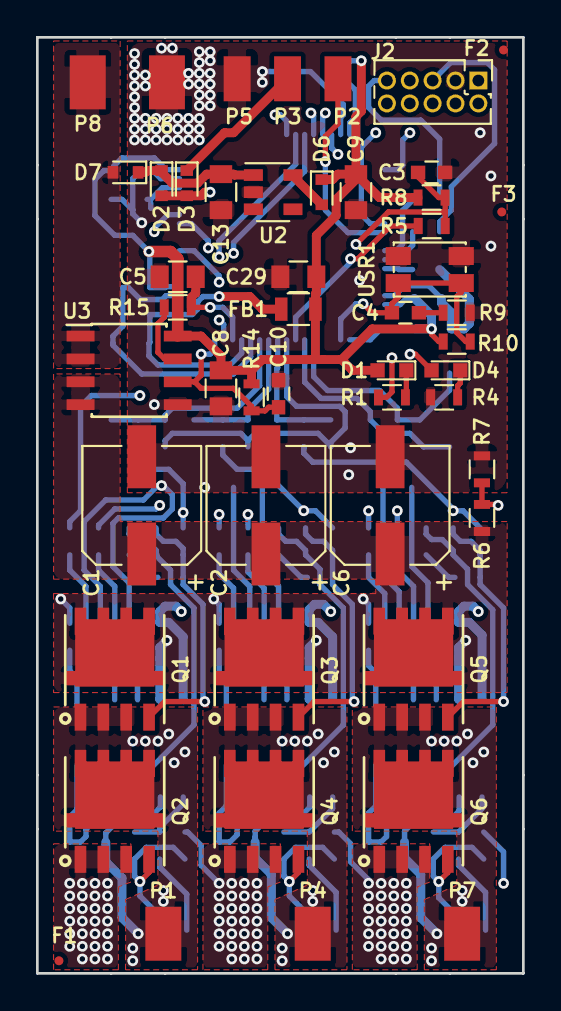
[picture p52: board esc-sigma-4s.kicad_pcb from above]

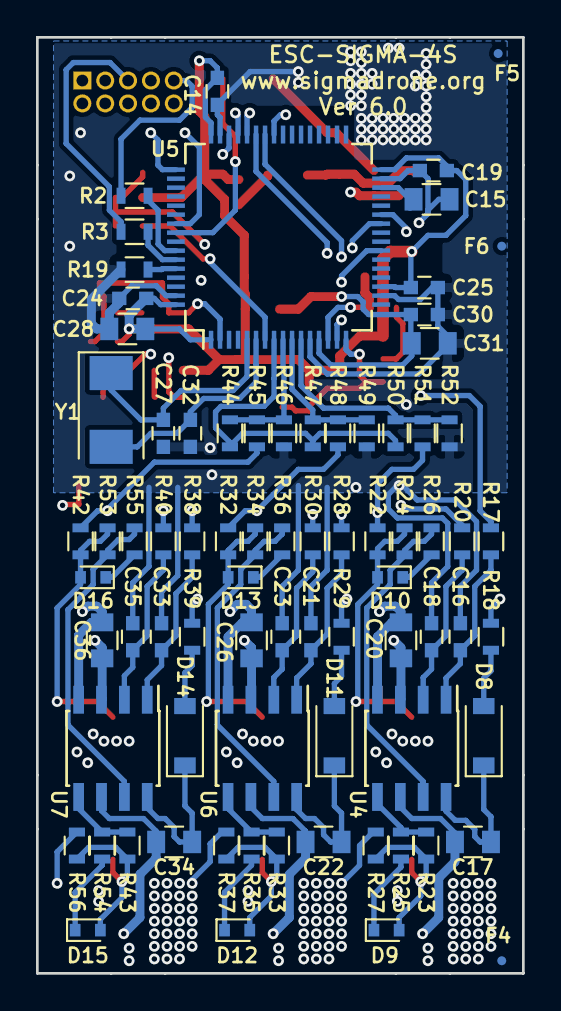
[picture p53: board esc-sigma-4s.kicad_pcb from below]

Board: 4 copper layers, 27.0 x 52.0 mm, 127 parts (78 on the bottom side), 76 nets.
