mstoilov/sigmadrone-esc/firmware/sigmadrive-h7/sigmadrive-h7.ioc

Mcu.UserName=STM32H743VGTx
PA0.GPIO_Label=PULSE_M2/TIM5_CH1
PA0.Signal=S_TIM5_CH1
PA1.GPIO_Label=M1_SOA/M1_IA_FB
PA1.Signal=ADC1_INP17
PA10.GPIO_Label=DBG_USART1_TX
PA10.Signal=USART1_RX
PA11.GPIO_Label=USB_DM
PA11.Signal=USB_OTG_FS_DM
PA12.GPIO_Label=USB_DP
PA12.Signal=USB_OTG_FS_DP
PA2.GPIO_Label=M1_SOB/M1_IB_FB
PA2.Signal=ADCx_INP14
PA3.GPIO_Label=ANALOG_SPEED_CTRL
PA3.Signal=ADCx_INP15
PA4.GPIO_Label=M1_SOC/M1_IC_FB
PA4.Signal=ADCx_INP18
PA5.GPIO_Label=PULSE_M1/TIM2_CH1
PA5.Signal=S_TIM2_CH1_ETR
PA6.GPIO_Label=VBAT_ADC
PA6.Signal=ADCx_INP3
PA7.GPIO_Label=M2_AL
PA7.Signal=TIM8_CH1N
PA9.GPIO_Label=DBG_USART1_RX
PA9.Signal=USART1_TX
PB0.Signal=S_TIM3_CH3
PB1.GPIO_Label=M2_CL
PB1.Signal=TIM8_CH3N
PB10.Signal=SPI2_SCK
PB11.GPIO_Label=QUAD_Z_M1
PB11.Signal=GPXTI11
PB12.GPIO_Label=OUTPUT_1
PB12.Signal=GPIO_Output
PB13.GPIO_Label=OUTPUT_2
PB13.Signal=GPIO_Output
PB14.GPIO_Label=M2_BL
PB14.Signal=TIM8_CH2N
PB15.GPIO_Label=DRV_SDI
PB15.Signal=SPI2_MOSI
PB2.GPIO_Label=GATE_M2_ENABLE
PB2.Signal=GPIO_Output
PB5.GPIO_Label=QUAD_B_M1
PB5.Signal=S_TIM3_CH2
PB6.GPIO_Label=QUAD_A_M2
PB6.Signal=S_TIM4_CH1
PB7.GPIO_Label=QUAD_B_M2
PB7.Signal=S_TIM4_CH2
PB8.Signal=S_TIM4_CH3
PC0.GPIO_Label=M2_SOA/M2_IA_FB
PC0.Signal=ADCx_INP10
PC1.GPIO_Label=M2_SOB/M2_IB_FB
PC1.Signal=ADCx_INP11
PC10.GPIO_Label=TD_422/UART4
PC10.Signal=UART4_TX
PC11.GPIO_Label=RD_422/UART4
PC11.Signal=UART4_RX
PC12.GPIO_Label=BRAKE_B_RELEASE
PC12.Signal=GPIO_Output
PC13.GPIO_Label=DRV1_CS
PC13.Signal=GPIO_Output
PC2_C.GPIO_Label=DRV_SDO
PC2_C.Signal=SPI2_MISO
PC3_C.GPIO_Label=M2_SOC/M2_IC_FB
PC3_C.Signal=ADC3_INP1
PC4.GPIO_Label=TEMP2
PC4.Signal=ADCx_INP4
PC5.GPIO_Label=TEMP1
PC5.Signal=ADCx_INP8
PC6.GPIO_Label=M2_AH
PC6.Signal=S_TIM8_CH1
PC7.GPIO_Label=M2_BH
PC7.Signal=S_TIM8_CH2
PC8.GPIO_Label=M2_CH
PC8.Signal=S_TIM8_CH3
PC9.GPIO_Label=LED_STATUS
PC9.Signal=GPIO_Output
PD0.GPIO_Label=CAR_RX
PD0.Signal=FDCAN1_RX
PD1.GPIO_Label=CAN_TX
PD1.Signal=FDCAN1_TX
PD10.GPIO_Label=M1_SW1
PD10.Signal=GPIO_Input
PD11.GPIO_Label=M1_SW2
PD11.Signal=GPIO_Input
PD12.GPIO_Label=ENCODER_DE_M1
PD12.Signal=USART3_DE
PD13.GPIO_Label=DIRECTION_A
PD13.Signal=GPIO_Input
PD14.GPIO_Label=LED_WARN
PD14.Signal=GPIO_Output
PD15.GPIO_Label=DIRECTION_B
PD15.Signal=GPIO_Input
PD2.GPIO_Label=M2_SW1
PD2.Signal=GPIO_Input
PD3.GPIO_Label=M2_SW2
PD3.Signal=GPIO_Input
PD4.GPIO_Label=ENCODER_DE_M2
PD4.Signal=USART2_DE
PD5.GPIO_Label=ENCODER_DI_M2
PD5.Signal=USART2_TX
PD6.GPIO_Label=ENCODER_RO_M2
PD6.Signal=USART2_RX
PD7.GPIO_Label=QUAD_Z_M2
PD7.Signal=GPXTI7
PD8.GPIO_Label=ENCODER_DI_M1
PD8.Signal=USART3_TX
PD9.GPIO_Label=ENCODER_RO_M1
PD9.Signal=USART3_RX
PE0.Signal=UART8_RX
PE1.Signal=UART8_TX
PE10.GPIO_Label=M1_BL
PE10.Signal=TIM1_CH2N
PE11.GPIO_Label=M1_BH
PE11.Signal=S_TIM1_CH2
PE12.GPIO_Label=M1_CL
PE12.Signal=TIM1_CH3N
PE13.GPIO_Label=M1_CH
PE13.Signal=S_TIM1_CH3
PE14.GPIO_Label=DRV_CAL
PE14.Signal=GPIO_Output
PE15.GPIO_Label=GATE_M1_ENABLE
PE15.Signal=GPIO_Output
PE2.GPIO_Label=INPUT_1\#
PE2.Signal=GPIO_Input
PE4.GPIO_Label=INPUT_2\#
PE4.Signal=GPIO_Input
PE5.GPIO_Label=BRAKE_A_FB
PE5.Signal=GPIO_Input
PE6.GPIO_Label=BRAKE_B_FB
PE6.Signal=GPIO_Input
PE8.GPIO_Label=M1_AL
PE8.Signal=TIM1_CH1N
PE9.GPIO_Label=M1_AH
PE9.Signal=S_TIM1_CH1
