mstoilov/sigmadrone-esc/firmware/sigmadrive-nomx/src/sigmadrive.h

#ifndef _SIGMADRIVE_H_
#define _SIGMADRIVE_H_

#include "stm32f7xx.h"
#include "stm32f7xx_ll_bus.h"
#include "stm32f7xx_ll_rcc.h"
#include "stm32f7xx_ll_pwr.h"
#include "stm32f7xx_ll_system.h"
#include "stm32f7xx_ll_utils.h"
#include "stm32f7xx_ll_gpio.h"
#include "stm32f7xx_ll_exti.h"
#include "stm32f7xx_ll_tim.h"
#include "stm32f7xx_ll_adc.h"
#include "stm32f7xx_ll_dma.h"
#include "stm32f7xx_hal_conf.h"
#include "stm32f7xx_ll_usart.h"
#include "stm32f7xx_ll_spi.h"

#include "stm32f7xx_hal.h"

#endif
