mstoilov/sigmadrone-esc/firmware/sigmadrive-nomx/src/pwmencoder.h

/*
 *  Sigmadrone
 *  Copyright (c) 2013-2015 The Sigmadrone Developers
 *
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
 *  Martin Stoilov <martin@sigmadrone.org>
 *  Svetoslav Vassilev <svassilev@sigmadrone.org>
 */

#ifndef _PWMENCODER_H_
#define _PWMENCODER_H_

#include <stdint.h>
#include <vector>
#include "timer.h"
#include "digitalout.h"

class PWMEncoder : public Timer
{
public:
	using base = Timer;

	PWMEncoder(
			const std::vector<GPIOPin>& output_pins,
			TIM_TypeDef *TIMx,
			const TimeSpan& pwm_period,
			const Frequency& system_clock = Frequency::from_hertz(SystemCoreClock)
	);
	virtual ~PWMEncoder();
	virtual void HandleUpdate() override;
	virtual void Start() override;
	virtual void Stop() override;
	void DumbDriving();
	void SetDutyCycle(float duty);
	void SetDutyPeriod(const TimeSpan& period);
	void Toggle();

protected:
	TimeSpan period_;
	uint32_t state_;
	DigitalOut UL_;
	DigitalOut VL_;
	DigitalOut WL_;
	DigitalOut TG_;
};

#endif
