mstoilov/sigmadrone-esc/firmware/sigmadrive-nomx/src/pwm6step.h

/*
 * pwm6step.h
 *
 *  Created on: Jun 23, 2017
 *      Author: mstoilov
 */

#ifndef PWM6STEP_H_
#define PWM6STEP_H_

#include <stdint.h>
#include <vector>
#include <sstream>
#include "timer.h"
#include "digitalout.h"
#include "sigmadrive.h"


//#define PANASONIC_MOTOR
#ifdef PANASONIC_MOTOR
#define MOTOR_POLES_NUMBER 8
#else
#define MOTOR_POLES_NUMBER 14
#endif

class PWM6Step : public Timer {
public:
	typedef Timer base;

	static constexpr unsigned int NUMBER_OF_POLES = MOTOR_POLES_NUMBER;
	static constexpr unsigned int M2E_RATIO = NUMBER_OF_POLES / 2;
	static constexpr unsigned int SINE_STATES = 6;
	static constexpr unsigned int MAX_HERTZ = 150;
	static constexpr unsigned int MIN_MILLIHERTZ = 1100;
	static constexpr unsigned int BEMF_INTEGRAL_THRESHOLD = 3300;
	static constexpr unsigned int ADC_A = 0;
	static constexpr unsigned int ADC_B = 1;
	static constexpr unsigned int ADC_C = 2;
	static constexpr float MAX_THROTTLE = 0.70;
	static constexpr float MIN_THROTTLE = 0.05;
	static constexpr unsigned int adc_data_counter1 = 1;
	static constexpr unsigned int adc_data_counter2 = 5;
	static constexpr unsigned int adc_data_size = 3;
	static constexpr unsigned int adc_current_data_size = 4;
	static constexpr unsigned int SINE_SAMPLES = 144;
	static constexpr unsigned int BOOTSTRAP_STAGES = 28;
	static constexpr unsigned int BOOTSTRAP_DELAY = 15000; /* switching cycles */
	static constexpr unsigned int BOOTSTRAP_COUNTDOWN = 20; /* switching cycles */

	struct BemfMeasurement {
		int32_t bemf = 0;
		int32_t counter = 0;
	};

	enum JeosState {
		JEOS_STATE_MEASUREMENT1 = 0,
		JEOS_STATE_MEASUREMENT2,
		JEOS_STATE_ZERODETECTED,
		JEOS_STATE_BOOTSTRAP_INIT,
		JEOS_STATE_BOOTSTRAP,
	};

	struct BootStrap {
		uint32_t delay_counter = 0;
		uint32_t com_counter_ = 0;
		uint32_t elrev_counter = 0;
		uint32_t rev_counter_ = 0;

	};

	struct LogEntry {
		uint32_t serial_ = 0;
		uint32_t state_ = 0;
		uint32_t last_counter_ = 0;
		uint32_t log_counter_ = 0;
		int32_t	bemf_mslope_ = 0;
		int32_t	bemf_intercept_ = 0;
		int32_t zero_crossing_ = 0;
		int32_t integral_bemf_ = 0;
		int32_t adc_data1_[adc_data_size];
		int32_t adc_data2_[adc_data_size];
		int32_t adc_current_[adc_current_data_size];
	};

	PWM6Step(
			const std::vector<GPIOPin>& output_pins,
			TIM_TypeDef *TIMx,
			const Frequency& switching_freq,
			const Frequency& system_clock = Frequency::from_hertz(SystemCoreClock),
			TriggerOutput trigger_output = TrigUpdate,
			OCMode output = PWM1,
			OCPolarity polarity = High,
			OCPolarity npolarity = Low,
			uint32_t deadtime = 30, 		/* ns */
			uint32_t irq_priority = 0
	);
	virtual ~PWM6Step();
	virtual void Start();
	virtual void Stop();

	void SetupChannels(uint32_t state);
	float GetDutyCycle();
	void SetThrottle(float percent);
	void SetDutyPeriod(const TimeSpan& period);
	Frequency GetSwitchingFrequency();
	void Toggle();
	void HandleJEOS(int32_t *injdata, size_t size);
	void HandleCurrentJEOS(int32_t *injdata, size_t size);
	inline int32_t CalculateBEMF(int32_t v1, int32_t v2, int32_t v3);
	int32_t DetectBEMF(uint32_t state, int32_t *injdata);
	void GenerateComEvent();
	void LogComEvent();
	void SetJeosState(JeosState state);
	bool Bootstrap();

	template<typename T>
	void CallbackCOM(T* tptr, void (T::*mptr)(void))
	{
		callback_COM_ = [=](void){(tptr->*mptr)();};
	}

	void CallbackCOM(const std::function<void(void)>& callback)
	{
		callback_COM_ = callback;
	}


public:
	OCMode pwm_mode_;
	OCPolarity polarity_;
	OCPolarity npolarity_;
	uint32_t com_cycles_max_;
	TimeSpan duty_;
	uint32_t state_ = 0;
	JeosState jeos_state_ = JEOS_STATE_MEASUREMENT1;
	uint32_t last_counter_ = 0;
	uint32_t bootstrap_coundown_ = 0;
	uint32_t counter_ = 0;
	uint32_t missed_coms_counter_ = 0;
	uint32_t log_counter_ = 0;
	int32_t	bemf_mslope_ = 0;
	int32_t	bemf_intercept_ = 0;
	int32_t zero_crossing_ = 0;
	int32_t integral_bemf_ = 0;
	BemfMeasurement msr_[2];
	int32_t adc_data1_[adc_data_size];
	int32_t adc_data2_[adc_data_size];
	int32_t adc_current_[adc_current_data_size];
	LogEntry log_entry_;
	BootStrap boots_;
	std::function<void(void)> callback_COM_ = [](){};
	float bootstrap_sine_[SINE_SAMPLES];

};


#endif /* PWM6STEP_H_ */
