mstoilov/sigmadrone-esc/firmware/sigmadrive-h7/application/uart.cpp

/*
 * hal_uart.cpp
 *
 *  Created on: Aug 30, 2019
 *      Author: mstoilov
 */

#include <assert.h>
#include "uart.h"
#include "dcache.h"

Uart::handle_map_type Uart::handle_map_;

extern "C" void tx_complete(UART_HandleTypeDef* huart)
{
	Uart* ptr = Uart::handle_map_[huart];
	if (ptr) {
		ptr->TransmitCompleteCallback();
	}
}

extern "C" void rx_complete(UART_HandleTypeDef* huart)
{
	Uart* ptr = Uart::handle_map_[huart];
	if (ptr) {
		ptr->ReceiveCompleteCallback();
	}
}

extern "C" void SD_UART_IrqHandler(UART_HandleTypeDef* huart)
{
	uint32_t isrflags   = READ_REG(huart->Instance->ISR);
	uint32_t cr1its     = READ_REG(huart->Instance->CR1);

	if ((isrflags & USART_ISR_IDLE) && (cr1its & USART_ISR_IDLE) ) {
		__HAL_UART_CLEAR_FLAG(huart, UART_CLEAR_IDLEF);

		Uart::handle_map_type::iterator it = Uart::handle_map_.find(huart);
		if (it != Uart::handle_map_.end()) {
			it->second->ReceiveCompleteCallback();
		}
	}

}

extern "C" void error_callback(UART_HandleTypeDef* huart)
{
	Uart* ptr = Uart::handle_map_[huart];
	if (ptr) {
		ptr->ErrorCallback();
	}
}


Uart::Uart(size_t poll_delay)
	: poll_delay_(poll_delay)
	, event_(osEventFlagsNew(NULL))
{
}

Uart::~Uart()
{
	Detach();
}


void Uart::Attach(UART_HandleTypeDef* huart, bool enable_idle_irq)
{
	huart_ = huart;
	assert(huart_);
	assert(huart_->hdmatx);
	assert(handle_map_.find(huart_) == handle_map_.end());

	handle_map_[huart_] = this;
	huart_->TxCpltCallback = ::tx_complete;
	huart_->RxHalfCpltCallback = ::rx_complete;
	huart_->RxCpltCallback = ::rx_complete;
	huart_->ErrorCallback = ::error_callback;
	rx_ringbuf_.reset_wp(0);
	rx_ringbuf_.reset_rp(0);

	if (huart_->Init.Mode & UART_MODE_RX) {
		if (enable_idle_irq)
			__HAL_UART_ENABLE_IT(huart, UART_IT_IDLE);
		/*
		 * The DMA must be initialized in DMA_CIRCULAR mode.
		 */
		assert(huart_->hdmarx);
		assert(huart_->hdmarx->Init.Mode == DMA_CIRCULAR);

		HAL_UART_Receive_DMA(huart_, (uint8_t*)rx_ringbuf_.get_write_ptr(), rx_ringbuf_.capacity());
	}
}

void Uart::Detach()
{
	handle_map_type::iterator it = handle_map_.find(huart_);

	HAL_UART_AbortReceive(huart_);

	if (it != handle_map_.end())
		handle_map_.erase(it);
	huart_ = nullptr;
}

size_t Uart::TransmitOnce(const char* buffer, size_t nsize)
{
	uint32_t vector = __get_xPSR() & 0xFF;
	if ((vector && !tx_ringbuf_.space_size()) || !nsize) {
		/* Nothing to send
		 *
		 * or
		 *
		 * If this is called from interrupt and the queue is out of space
		 * just drop the write request.
		 */
		return nsize;
	}

	while (!tx_ringbuf_.write_size())
		;
	nsize = std::min(tx_ringbuf_.write_size(), nsize);
	std::copy(buffer, buffer + nsize, tx_ringbuf_.get_write_ptr());
	tx_ringbuf_.write_update(nsize);
	if (transmitting_)
		return nsize;
	transmitting_ = true;
	if (HAL_UART_Transmit_DMA(huart_, (uint8_t*)tx_ringbuf_.get_read_ptr(), tx_ringbuf_.read_size()) != HAL_OK) {
		transmitting_ = false;
	}

	return nsize;
}

size_t Uart::Transmit(const char* buffer, size_t nsize)
{
	const char *p = buffer;
	size_t size = nsize;
	size_t offset = 0;
	size_t ret = 0;
	while (size) {
		ret = TransmitOnce(p + offset, size);
		offset += ret;
		size -= ret;
	}
	return nsize;
}

size_t Uart::Transmit(const std::string& str)
{
	return Transmit(str.c_str(), str.size());
}

void Uart::TransmitCompleteCallback()
{
	tx_ringbuf_.read_update(huart_->TxXferSize);
	if (tx_ringbuf_.read_size()) {
		if (HAL_UART_Transmit_DMA(huart_, (uint8_t*)tx_ringbuf_.get_read_ptr(), tx_ringbuf_.read_size()) != HAL_OK) {
			transmitting_ = false;
		}
	} else {
		transmitting_ = false;
	}
}
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
