mstoilov/sigmadrone-esc/(commit log)

2018-04-08 Initial commit of the Sigmadrone ESC project
    [Pin_Headers_Pin_Header_Straight_2x05_Pitch1_27mm.stp, WURTH_62201021121-rev1.stp, empty-panel.kicad_pcb, esc-sigma-4s-panel.kicad_pcb, esc-sigma-4s.kicad_pcb, esc-sigma-4s.sch, ftdi_interface.sch, mcu.sch]
2018-04-09 Use quadratic curve for the throttle speed function of the rotation frequency.
2018-04-10 Tuned the switching frequency and throttle_speed
2018-04-11 Use sine curved PWM waveform
2018-04-11 Ignore BEMF measurement for the first PWM cycle.
2018-04-12 Tuned bootstrap and throttle speed parameters.
2018-10-10 Added 3d models
    [STEP-WE-TPC-4818-rev1.stp, Wuerth_WE_TPC_3816.step, mkds_5-2-7.62.step, mkds_5-3-7.62.step, pxc_1704936_03_MKDS-5-3-7-62_3D.stp, pxc_1868076_03_MKDS-5-2-7-62_3D.stp]
2018-10-10 Added phoenix connectors footprints
2018-10-10 work in progress - servo controller
    [empty-panel.kicad_pcb, ftdi_interface.sch, mcu.sch, mosfets_driving.sch, pads.sch, pads_connectors.sch, phase_sensing.sch, servo-sigma-48v.kicad_pcb]
2018-10-31 Finished routing of the servo controller
    [mcu.sch, mosfets_driving.sch, phase_sensing.sch, servo-sigma-48v.kicad_pcb, servo-sigma-48v.sch]
2018-11-12 Fixed overlapping footprints
    [servo-sigma-48v.kicad_pcb]
2018-11-13 Updated the footprints
    [mcu.sch, mosfets_driving.sch, pads_connectors.sch, phase_sensing.sch, servo-sigma-48v.kicad_pcb]
2018-12-03 Added support for sigmaservo board
2018-12-03 Fixed component reference visibility.
    [servo-sigma-48v.kicad_pcb]
2018-12-03 Changed the default board configuration
2018-12-13 WIP: Adding support for DMA enabled USART
2018-12-13 Modified the USART class to use the Dma class. Dma class now uses the InterruptManager to IRQ requests.
2018-12-26 Fixed UART RX/TX.
2018-12-28 Work on interrupt manager
2018-12-28 added USE_MULTICALLBACKS for interrupt manager
2018-12-28 Use DMA circular buffer for RX. Removed the TC interrupt handler.
2019-01-07 Handle timer IRQs, using the InterruptManager
2019-01-07 Added PWM encoder, decoder, sine generator.
2019-01-11 Read the current through the shunt resistors - WIP
2019-01-12 Adc implementation - WIP
2019-01-17 work on PWM speed control
2019-02-03 Removed QuadratureDecoder's EnableInterrupt(Timer::InterruptCC1);
2019-02-04 work on pwmsine.
2019-02-07 Work on encoder feedback
2019-03-01 Moved the FPU test to separate function. Removed the sine_ array from PWMSine
2019-03-09 Start rotating after using the encoder feedback.
2019-03-09 Work on sigmadrive 2.0
    [mcu.sch, mosfets_driving.sch, pads_connectors.sch, servo-sigma-48v.kicad_pcb, servo-sigma-48v.sch]
2019-03-09 work on rs485
    [mcu.sch, pads_connectors.sch, phase_sensing.sch, servo-sigma-48v.kicad_pcb]
2019-03-09 Changed the MCU to use 100 pin
    [mcu.sch, mosfets_driving.sch, pads_connectors.sch, phase_sensing.sch, servo-sigma-48v.kicad_pcb]
2019-03-09 Routed version 2.0
    [mcu.sch, pads_connectors.sch, servo-sigma-48v.kicad_pcb]
2019-03-09 Added NPTH for mounting heat sink.
    [mcu.sch, pads_connectors.sch, servo-sigma-48v.kicad_pcb]
2019-03-09 Work on verson 2.0
    [mosfets_driving.sch, phase_sensing.sch, servo-sigma-48v.kicad_pcb]
2019-03-09 completed routing
    [mcu.sch, mosfets_driving.sch, pads_connectors.sch, phase_sensing.sch, servo-sigma-48v.kicad_pcb, servo-sigma-48v.sch]
2019-03-09 renamed project
    [sigmadrive-solo.kicad_pcb, sigmadrive-solo.sch]
2019-03-09 deleted unused files.
    [pads_connectors.sch]
2019-03-09 Rerouted ADC and encoder connectors
    [mcu.sch, mosfets_driving.sch, phase_sensing.sch, sigmadrive-solo.kicad_pcb, sigmadrive-solo.sch]
2019-03-09 Updated PQFN footprint
2019-03-09 Added test points.
    [mcu.sch, mosfets_driving.sch, sigmadrive-solo.kicad_pcb]
2019-03-17 Major modifications of the board include replacing the gate drivers with TI DRV8323RS
2019-03-20 Added callback for current sensing.
2019-03-20 Display the shunt resistor ADC measurements.
2019-03-20 Added stm32f405xx.h
2019-03-23 Modified the bootstrap sequence for PWM6Step, using different parameters for bigger motors.
2019-03-24 Print test message for RS485.
2019-03-27 support for panasonic Minas A4 17 bit absolute encoder
2019-03-27 Using ADC1, ADC2, ADC3 to measure current.
2019-03-27 Make the minas_a4 encoder_reader_task conditionally compiled.
2019-03-28 Call OnTxComplete() from USART::IrqHandlerUSART(void). Calling it from the DMA Transfer Complete is premature and causes corruption of the last byte being transferred.
2019-03-29 Changed MOSFETs to NTMFS5C628NLT1G
    [mcu.sch, mosfets_driving.sch, phase_sensing.sch, sigmadrive-solo.sch]
2019-03-29 Adding capacitors on the current sense lines.
    [mcu.sch, mosfets_driving.sch, phase_sensing.sch, sigmadrive-solo.kicad_pcb, sigmadrive-solo.sch]
2019-03-29 Work on sigmadrive-solo 3.1
    [mcu.sch, mosfets_driving.sch, sigmadrive-solo.kicad_pcb, sigmadrive-solo.sch]
2019-03-29 Updated footprints and 3D models
    [L_Wuerth_WE-TPC-4828.step]
2019-03-29 Updated Inductor footprints. Split RE/DE for RS485.
    [mcu.sch, mosfets_driving.sch, phase_sensing.sch, sigmadrive-solo.kicad_pcb, sigmadrive-solo.sch]
2019-03-29 Moved Reference R36
    [sigmadrive-solo.kicad_pcb]
2019-03-29 Added part number for TPD4S009
    [mcu.sch]
2019-03-29 Added ground via between the two MCU clock capacitors.
    [sigmadrive-solo.kicad_pcb]
2019-03-29 Changed MCU to STM32F745
    [mcu.sch, sigmadrive-solo.kicad_pcb]
2019-03-29 Added DIR and BUSY lines.
    [mcu.sch, mosfets_driving.sch, sigmadrive-solo.kicad_pcb]
2019-04-01 Added temperature sensor.
    [mcu.sch, mosfets_driving.sch, phase_sensing.sch, sigmadrive-solo.kicad_pcb]
2019-04-01 Added MKDS_07x7.62 connector
2019-04-01 Updated PhoenixContact_MKDS_07x7.62mm_Vertical.kicad_mod footprint with 3D model.
    [mkds_5-7-7.62.step, sigmadrive-solo.kicad_pcb]
2019-04-01 Updated part number for temperature termistor.
    [mcu.sch]
2019-04-02 Added support for reading regular ADC channels.
2019-04-02 Added ADC blocking read data function
2019-04-03 Read OpAmp bias. Fixed broken pwm6step.
    [adc.cpp, main.cpp, pwm6step.cpp, pwmsine.cpp, pwmsine.h]
2019-04-04 Removed unused pwmencoder.h/cpp files.
2019-04-05 Updated system files to use STM32Cube_FW_F4_V1.24.0
2019-04-07 do not reset the MA4 0 position every time when starting the firmware
    [minas_a4_abs_encoder.cpp, minas_a4_abs_encoder.h]
2019-04-09 Changed PidController leak implementation. Started sigmadrive_ext
    [main.cpp, pidcontroller.h]
2019-04-09 Added ipython notebook to test the pid controller.
2019-04-13 Fixed interrupt vector relocation.
    [interruptmanager.cpp]
2019-04-13 Updated project to use STM32F745VE MCU.
2019-04-14 changed jupyter PID test.
2019-04-14 Changed 18kOhm to 20kOhm part. Changed termistor value.
    [mosfets_driving.sch, sigmadrive-solo.kicad_pcb]
2019-04-14 Added support for USB CDC device.
2019-04-17 Revert back to 192 MHz clock.
    [_initialize_hardware.c]
2019-04-17 Added explanation for the resonator capacitance selection.
    [mcu.sch]
2019-04-17 Changed HAL_Delay(100UL); to vTaskDelay(100 / portTICK_RATE_MS);
2019-05-28 Control panasonic's ma4 as servo motor
2019-06-11 Increase the throttle to 0.5 for panasonic motor.
2019-06-17 Compensate for the initial encoder offset: MA4_ABS_ENCODER_RESOLUTION/20
2019-06-17 Replaced GetEncoderTheta() with GetEncoderElectricTheta() and GetEncoderMechanicalTheta().
    [pwmsine.cpp, pwmsine.h]
2019-06-18 sigmadrive-solo board 3.3
    [mcu.sch, mosfets_driving.sch, sigmadrive-solo.kicad_pcb]
2019-06-18 added battery ADC filter.
    [mcu.sch, mosfets_driving.sch, sigmadrive-solo.kicad_pcb]
2019-06-18 Added second net-tie between GND and PGND.
    [mosfets_driving.sch, sigmadrive-solo.kicad_pcb]
2019-06-18 Work on 3.4
    [mcu.sch]
2019-06-18 Routed version 3.4
    [mcu.sch, mosfets_driving.sch, sigmadrive-solo.kicad_pcb]
2019-08-23 Added minas encoder offset
2019-09-15 Added adc.h/cpp
2019-09-18 Fixed circular buffer update with received data.
    [cdc_iface.h]
2019-09-30 Added rpcserver over uart1.
2019-10-03 Work on terminal support over UART.
2019-10-31 Changed the MCU to STM32F745VG
2019-10-31 Replace RpcProperty with rexjson::property
    [appmain.cpp, iencoder.h, quadrature_encoder.cpp, quadrature_encoder.h, servo_drive.cpp, servo_drive.h, uartrpcserver.cpp]
2019-11-13 Added Adc regular channel conversions.
2019-11-14 Added worker thread in CdcIface
2019-11-14 Added worker thread in CdcIface 2
2019-11-15 Work on ADC measurements.
2019-11-15 Work on ADC measurements. 2
2019-11-15 Work on ADC measurements. 3
2019-11-16 Broken encoder
2019-11-16 Set the ADC trigger to ADC_EXTERNALTRIGINJECCONV_T1_TRGO
2019-11-16 Remove the TIM2 timer from CubeMX configuration.
2019-11-17 Removed the TIM1 Update interrupt.
2019-11-21 Work on phase current calculation.
2019-11-21 Implementation of using complex numbers to track rotor and current.
2019-11-22 Work on using complex numbers for Rotor/Current tracking.
2019-11-28 Make the RpcServer global. Using rexjson::make_rpc_wrapper to expose ServoDrive::Start ServoDrive::Stop with RPC.
2019-11-29 Work on resistance measurement.
2019-11-30 Cleaned up the PwmGenerator.
2019-12-04 Added encoder_dir_ detection task.
2019-12-04 Added rotor reset task.
    [servo_drive.cpp, servo_drive.h]
2019-12-05 Work on rotor reset.
    [servo_drive.cpp, servo_drive.h]
2019-12-05 Created Config structure to hold all ServoDrive configuration data.
2019-12-06 Work on current pid controller
2019-12-07 ServoDrive clean up.
2019-12-10 Renamed servo_drive.h/cpp to motor_drive.h/cpp
2019-12-10 Renamed motor_drive.h/cpp to motordrive.h/cpp
2019-12-11 Added motor control class.
2019-12-13 Added Minas A4 encoder.
2019-12-13 work on panasonic encoder.
2019-12-15 Fixed osEventFlagsSet fails with called from ISR https://github.com/ARM-software/CMSIS-FreeRTOS/issues/12
2019-12-15 Added High Resolution Timer.
2019-12-17 Work on the panasonic encoder.
2019-12-18 Added support to externally set the active encoder.
2019-12-18 Moved the encoder_->Update() call inside the scheduler thread.
2019-12-19 Added encoder UpdateBegin()/UpdateEnd()
2019-12-21 Added emergency stop for all motors.
2019-12-26 Added calibration command.
2019-12-29 Work on FOC torque/speed
2019-12-30 Work on FOC velocity/torque control.
2019-12-31 Print error messages.
2020-01-02 Display encoder timings.
2020-01-03 Moved rotor update out of the MotorDrive.
2020-01-03 RCR 0. Fixed minas encoder ResetPosition()
    [lowpassfilter.h, main.h, minasa4encoder.cpp, motorctrl_foc.cpp, motorctrl_foc.h, motordrive.cpp, sigmadrive.ioc]
2020-01-03 Work on velocity loop.
2020-01-04 Set max calibration current to 4.
2020-01-05 Work no velocity loop.
2020-01-05 Reduced SPI speed.
2020-01-06 Moved Rotor Update to MotorDrive. Removed motorctrl_complexfoc.cpp/.h files.
2020-01-06 Added Idq filters.
2020-01-08 Fixed encoder detection.
2020-01-27 Added blocking read, by handling the IDLE line interrupt.
2020-02-01 Fixed #include to also have the containing directory.
    [_write.cpp, appmain.cpp, command_task.cpp, main.c, motordrive.h, uartrpcserver.cpp, uartrpcserver.h]
2020-02-01 Moved driver 8323 default init in a separate method.
2020-02-01 Redesigned the encoder interface.
    [appmain.cpp, iencoder.h, minasa4encoder.cpp, minasa4encoder.h, motorctrl_foc.cpp, motorctrl_foc.h, motordrive.cpp, motordrive.h]
2020-02-03 Clean-up main loop. Fixed minas encoder detection. Fixed cdc interface thread.
    [appmain.cpp, cdc_iface.h, drv8323.cpp, drv8323.h, iencoder.h, motordrive.h]
2020-04-07 Work on encoder interface. Added dumbencoder.h
2020-05-06 Added power supply description.
2020-05-07 work on MotorDrive documentation.
2020-05-07 Added delay before attempting to initialize the encoder.
2020-05-09 Commented the pwm generator.
2020-05-09 Added more documentation for the MotorDrive class
2020-05-09 document MotorDrive
2020-05-12 Work on documenting MotorCtrlFOC class
2020-05-13 Changed default values for resistance and inductance
2020-05-13 Fixed Vbus data. Fixed debug output formatting for velocity and torque modes.
    [motorctrl_foc.cpp, motorctrl_foc.h, motordrive.cpp, motordrive.h]
2020-05-14 Changed default gains for the PID regulators.
2020-05-14 Use ADC2 and ADC3 for current sensing.
2020-05-14 Use position loop that generates velocity.
2020-05-24 Changes to the PID controller.
2020-05-24 renamed PidController input param to error.
    [motorctrl_foc.h, pidcontroller.h]
2020-05-25 work on PID controller.
2020-05-25 Implemented anti-windup dynamic clamping for the PID
2020-05-25 Debug uart output
2020-07-14 Enabled automatic PID calibration.
2020-07-16 Fixed encoder dir detection. Tuned the current control loop.
    [motorctrl_foc.cpp, motorctrl_foc.h, motordrive.cpp]
2020-07-17 Changed SetEncoder to accept desired encoder resolution bits.
2020-07-28 Updated PID controller parameters
2020-07-31 added velocity profiler.
2020-08-02 Fixed velocity profiler.
2020-08-09 Work on duo drive.
    [mcu.sch, mosfets_driving.sch, sigmadrive-duo.kicad_pcb]
2020-08-14 Sigmadrive-duo final HW update
    [mcu.sch, sigmadrive-duo.kicad_pcb]
2020-08-15 Use TIM12 as high-resolution timer.
2020-08-16 Changed the Wenc to be encoder counts per update period
2020-08-16 Updated speed PID coefficients.
2020-08-16 Set switching frequency to 18 kHz.
2020-08-16 Removed phase current filters.
2020-08-17 Removed current filters.
2020-08-19 Added RegReadConversionData for ADC
2020-08-19 Updated STM32CubeMX
2020-08-19 Removed Reading of current C
2020-08-19 updated STM32CubeMX files.
2020-08-20 Work on dual motor support.
2020-08-20 removed SampledData structure.
2020-08-20 Set up the dumb encoder.
2020-08-22 Added Anti-windup dynamic clamping of the integral component in the PI controller.
2020-08-22 Fixed ModeClosedLoopTrajectory initialization. Updated PID coefficients.
    [motorctrl_foc.cpp, motorctrl_foc.h]
2020-08-26 Move the encoder debug functionality to the MinasA4Encoder class.
2020-08-26 Added support for rading two encoders.
2020-08-27 Added RPC interface to the MA4 encoder.
2020-08-28 Reworked minas encoder driver.
    [minasa4encoder.cpp, minasa4encoder.h]
2020-08-28 Added support for property insert.
2020-08-29 Disabled encoder CRC calculation. Added PREFETCH_ENABLE
2020-08-29 Added void EstimateRotor(); and Rencest_ to support rotor position estimation.
2020-09-01 Fixed SPI communication with DRV8323
    [appmain.cpp, drv8323.cpp, drv8323.h, main.c, sigmadrive.ioc]
2020-09-02 Added Voltage reading for axis2.
2020-09-02 Modified ADC implementation.
2020-09-04 PCB sigmadrive-duo, version 3.6
    [mcu.sch, mosfets_driving.sch, sigmadrive-duo.kicad_pcb]
2020-09-04 Added more ground vias.
    [sigmadrive-duo.kicad_pcb]
2020-09-08 Changed the values of the gate drive currents.
2020-09-09 Work on velocity streaming.
2020-09-15 Hardware version 3.8. Adde support for external battery.
    [mcu.sch, sigmadrive-duo.kicad_pcb]
2020-09-22 Added PQFN_5x6_SGD and molex connector models.
    [36500300_cp.step, 36500400_cp.step, PQFN_5x6_SGD.step, sigmadrive-duo.kicad_pcb]
2020-10-02 Make UART_IT_IDLE optional
2020-10-02 Added UART4 global interrupt.
2020-10-02 Added UART4 to be used with RPC Task
2020-12-10 Enabled UART8.
2021-02-14 Switch TIM1 and TIM8, so they control TIM1 -> M1, TIM8 -> M2
2021-07-18 Removed file torque_loop.h/cpp
2021-10-12 Removed the check/replace the LF with CRLF
    [_write.cpp]
2022-12-15 Added the encoder specs.
2022-12-28 Added python bindings to the RPC interface.
    [sigmadrive.py]
2023-01-04 Clean up the velocity profiler code.
2023-01-06 Now using velocity in [ec/sec]
2023-01-09 Work on velocity profiler
2023-01-09 Updated STM32 libraries.
2023-05-06 Added schematics received from ZEC
    [Servo_DRV_Rev1_BOM_2023-05-03(1).xlsx]
2023-09-11 Fixed calibration.
2023-10-14 Added util class sigmadrive/velocityprofiler/sigmadrive.py
2023-10-18 Revision 1 from ZEC.
    [Servo_DRV_Rev1.pcb, Servo_DRV_Rev1_BOM_2023-07-13(1)_updated.xlsx, Servo_DRV_Rev1_P&P_mm.xlsx, Servo_DRV_Rev1_PCB_Order.xlsx]
2023-10-18 Added encoder_minas.h/cpp
2023-10-18 Increased the update_hz. Refactored the MotorDrive::EstimateRotor.
2023-10-21 Set the update_hz to 20000. Fixed pole_offset calibration.
    [main.h, motordrive.cpp, sigmadrive.ioc]
2023-10-25 Work on crash detection.
    [appmain.cpp, motorctrl_foc.cpp, motorctrl_foc.h, motordrive.cpp, motordrive.h]
2023-10-25 Added crash_current and crash_backup props
    [sigmadrive.py]
2023-10-25 Implemented crash detection and related axes.
    [appmain.cpp, motorctrl_foc.cpp, motorctrl_foc.h, sigmadrive.py]
2023-10-27 added holding brake schematic.
2024-04-25 Removed unused code for crash detection.
    [motorctrl_foc.cpp]
2024-04-25 Updated default PID coefficients.
2024-04-25 Redirect STD IN/OUT -> uart8, STDERR -> uart1
2024-05-10 Removed crash detection code.
    [appmain.cpp, motorctrl_foc.cpp, motorctrl_foc.h, sigmadrive.py]
2024-05-17 Removed rotor velocity filtration
2024-08-11 Updated for STM32H743 device
2024-08-12 Updated ADC
2024-08-12 Updated ADC for H7
2024-08-12 Added ADC calibration. Fixed DMA buffer to be circular.
    [adc.cpp, main.c, motordrive.cpp, motordrive.h, sigmadrive-h7.ioc]
2024-09-18 Work on minas encoder reinitialization.
2024-09-18 Added method MotorDrive::InitializeEncoder()
